rcapaverde/cubo/instruction-set.xlsx

 | x0 | x1 | x2 | x3 | x4 | x5 | x6 | x7 | x8 | x9 | xA | xB | xC | xD | xE | xF
0x | NOP Sem operação nop | MOVE (1) Copia REG8X para REG8X mov <a>, <b> |  |  |  |  |  |  | MOVE (2) Copia REG16X para REG16X mov <a>, <b> |  |  |  | LOAD (6) Carrega 16 bits apontados imediatamente para REG16X ld <a>, [<addr>]
1x | MOVE (4) Copia REG8 para REG16 mov <a>, <b> |  |  |  |  |  | LOAD (1) Carrega 8 bits imediatos da memória para REG8X ld <a>, <8 bits> |  |  |  |  |  |  | MOVE (3) Copia acumulador para REG16 com extensão de sinal movsx <a>, A |  | HALT Paralisa o processador hlt
2x | LOAD (2) Carrega 16 bits imediatos da memória para REG16X ld <a>, <16 bits> |  |  |  | LOAD (3) / LOAD (4) Carrega 8 bits ou 16 bits apontados por REG16X para REG8X ou REG16X ld <a>, [<b>] |  |  |  | JUMP CARRY Desvia se carry jc <addr> | JUMP ZERO Desvia se zero jz <addr> | JUMP NÃO CARRY Desvia se não carry jnc <addr> | JUMP NÃO ZERO Desvia se não zero jnz <addr> | STORE (1) / STORE (2) Armazena REG8X ou REG16X no endereço apontado por REG16X sto [<a>], <b>
3x | LOAD (5) Carrega 8 bits apontados imediatamente para REG8X ld <a>, [<addr>] |  |  |  |  |  |  | JUMP NEGATIVE Desvia se negativo jn <addr> | JUMP OVERFLOW Desvia se overflow jo <addr> | JUMP NÃO NEGATIVE Desvia se positivo jnn <addr> | JUMP NÃO OVERFLOW Desvia se não overflow jno <addr> | STORE (4) Armazena REG16X no endereço apontado imediato sto [<addr>], <a> |  |  |  | ADC (1) Adiciona 8 bits imediatos a ACC, com carry adc A, <8 bits>
4x | STORE (3) Armazena REG8X no endereço apontado imediato sto [<addr>], <a> |  |  |  |  |  |  | PUSH (2) Empilha REG16X na stack (menos SP) psh <a> |  |  | ENABLE INTR Liga o flag que habilita interrupções (interrupções solicitadas enquanto o flag estava desabilitado serão executadas imediatamente) ei | ADC (3) Adiciona 8 bits apontados imediatos a ACC, com carry adc A, [<addr>] | ADC (2) Adiciona 8 bits apontado por REG16 a ACC, com carry adc A, [<a>] |  | ADD (1) Adiciona 8 bits imediatos a ACC add A, <8 bits> | ADD (3) Adiciona 8 bits apontados imediatos a ACC add A, [<addr>]
5x | PUSH (1) Empilha REG8X na stack psh <a> |  |  |  |  |  |  | POP (1) Desempilha REG8X da stack pop <a> |  |  |  |  |  |  | ADD (2) Adiciona 8 bits apontado por REG16 a ACC add A, [<a>]
6x | POP (2) Desempilha REG16X da stack (menos SP) pop <a> |  |  | SWAP Troca o conteúdo do acumulador com REG8X (menos o próprio ACC) swp A, <a> |  |  |  |  |  | INC (2) Incrementa REG16 (sem efeito nos flags) inc <a> |  | SBB (1) Subtrai 8 bits imediatos de ACC, com borrow sbb A, <8 bits> | SBB (2) Subtrai 8 bits apontado por REG16 de ACC, com borrow sbb A, [<a>] |  | SBB (3) Subtrai 8 bits apontados imediatos de ACC, com borrow sbb A, [<addr>] | INC (1) Incrementa ACC (com efeito nos flags) inc A
7x | ADC (4) Adiciona REG8 a ACC, com carry adc A, <a> |  |  |  |  |  | ADD (4) Adiciona REG8 a ACC add A, <a> |  |  |  |  |  | SUB (1) Subtrai 8 bits imediatos de ACC sub A, <8 bits> | SUB (2) Subtrai 8 bits apontado por REG16 de ACC sub A, [<a>] |  | DEC (1) Decrementa ACC (com efeito nos flags) dec A
8x | SBB (4) Subtrai REG8 de ACC, com borrow sbb A, <a> |  |  |  |  |  | SUB (4) Subtrai REG8 de ACC sbb A, <a> |  |  |  |  |  | SUB (3) Subtrai 8 bits apontados imediatos de ACC sub A, [<addr>] | AND (1) AND bitwise 8 bits imediatos com ACC and A, <8 bits> | AND (2) AND bitwise 8 bits apontado por REG16 com ACC and A, [<a>]
9x | AND (4) AND bitwise de REG8X com ACC and A, <a> |  |  |  |  |  |  | OR (4) OR bitwise de REG8X com ACC or A, <a> |  |  |  |  |  |  | OR (1) OR bitwise 8 bits imediatos com ACC and A, <8 bits> | AND (3) AND bitwise 8 bits apontados imediatos com ACC and A, [<addr>]
Ax | XOR (4) Bitwise XOR de REG8X com ACC xor A, <a> |  |  |  |  |  |  | XOR (1) Bitwise XOR 8 bits imediatos com ACC xor A, <8 bits> | XOR (2) Bitwise XOR 8 bits apontado por REG16 com ACC xor A, [<a>] |  | XOR (3) Bitwise XOR 8 bits apontados imediatos com ACC xor A, [<addr>] | OR (2) Bitwise OR 8 bits apontado por REG16 com ACC or A, [<a>] |  | OR (3) Bitwise OR 8 bits apontados imediatos com ACC or A, [<addr>] | NOT (1) Bitwise NOT de 8 bits apontados imediatos, resultado em ACC not [<addr>] | NOT (2) Bitwise NOT de ACC not A
Bx | SHIFT LEFT CARRY (1) Deslocamento à esquerda de ACC, com carry shlc A | SHIFT LEFT CARRY (2) Deslocamento à esquerda do conteúdo apontado por REG16, resultado em ACC, com carry shlc [<a>] |  | SHIFT LEFT (1) Deslocamento à esquerda de ACC shl A | SHIFT LEFT (2) Deslocamento à esquerda do conteúdo apontado por REG16, resultado em ACC shl [<a>] |  | SHIFT RIGHT CARRY (1) Deslocamento à direita de ACC, com carry shrc A | SHIFT RIGHT CARRY (2) Deslocamento à direita do conteúdo apontado por REG16, resultado em ACC, com carry shrc [<a>] |  | SHIFT RIGHT (1) Deslocamento à direita de ACC shr A | SHIFT RIGHT (2) Deslocamento à direita do conteúdo apontado por REG16, resultado em ACC shr [<a>] |  | ROTATE LEFT (2) Rotaciona à esquerda o conteúdo apontado por REG16, resultado em ACC rl [<a>] |  | ROTATE RIGHT (2) Rotaciona à direita o conteúdo apontado por REG16, resultado em ACC rr [<a>]
Cx | ROTATE LEFT (1) Rotação à esquerda de ACC rl A | ROTATE RIGHT (1) Rotação à direita de ACC rr A | CLEAR CF Limpa o carry flag clc | SET CF Liga o carry flag stc | NEGATIVE (1) Complemente de 2 de 8 bits apontados imediatos, resultado em ACC neg [<addr>] | NEGATIVE (2) Complemento de 2 de ACC neg A | NEGATIVE (3) Complemento de 2 de 8 bits apontados por REG16, resultado em ACC neg [<a>] |  | NOT (3) Bitwise NOT de 8 bits apontados por REG16, resultado em ACC not [<a>] |  | JSR (1) Desvia PC para o valor de REG16, salvando PC original na stack jsr <a> |  | JSR (2) Desvia PC para o endereço apontado por REG16, salvando PC original na stack jsr [<a>] |  | JUMP (3) Desvia PC para o valor de REG16 jmp <a>
Dx | JUMP (1) Desvia PC para o endereço imediato jmp <addr> | JUMP (2) Desvia PC para o endereço apontado imediato jmp [<addr>] | JUMP (4) Desvia PC para o endereço apontado por REG16 jmp [<a>] |  | RETURN Volta de uma chamada por JSR ret | COMPARE (1) Compara 8 bits imediato com ACC cmp A, <8 bits> | COMPARE (2) Compara 8 bits apontado por REG16 com ACC cmp A, [<a>] |  | COMPARE (3) Compara 8 bits apontados imediatos com ACC cmp A, [<addr>] | COMPARE (4) Compara REG8X com ACC cmp A, <a>
Ex | INPUT (1) / OUTPUT (1) Lê (ou grava) um byte na porta indicada por endereço imediato e coloca em REG8 inp <a>, <8 bits> / out <a>, <8 bits> | INPUT (2) / OUTPUT (2) Lê (ou grava) um byte na porta indicada por REG8 e coloca em REG8 inp <a>, <b> / out <a>, <b> |  |  |  |  |  | OUTPUT (3) Grava um byte imediato na porta indicada por endereço imediato out <8 bits>, <8 bits> | JSR (3) Desvia PC para o valor imediato, salvando PC original na stack jsr <16 bit> | JSR (4) Desvia PC para o endereço apontado imediato, salvando PC original na stack jsr [<16 bit>] | INC (3) Incrementa REG8 (sem efeito nos flags), menos ACC inc <a> |  |  |  |  | DISABLE INTR Desliga o flag que habilita interrupções di
Fx | DEC (2) Decrementa REG16 (sem efeito nos flags) dec <a> |  | DEC (3) Decrementa REG8 (sem efeito nos flags), menos ACC dec <a>
 | x0 | x1 | x2 | x3 | x4 | x5 | x6 | x7 | x8 | x9 | xA | xB | xC | xD | xE | xF
0x | RESET Instrução especial com a sequência de reset
1x
2x
3x
4x
5x
6x
7x
8x | EXT_MOVE_1 Copia o conteúdo de MARL para REG8X |  |  |  |  |  |  |  | EXT_MOVE_2 Copia o conteúdo de MAR para REG16X |  |  |  | EXT_LOAD_4 Copia o conteúdo apontado por MAR para REG16X
9x | EXT_LOAD_3 Copia o conteúdo apontado por MAR para REG8X |  |  |  |  |  |  |  | EXT_STORE_1 Armazena o REG8X no endereço apontado por MAR
Ax | EXT_STORE_2 Armazena o REG16X no endereço apontado por MAR |  |  |  | EXT_INPUT_1 Lê um byte na porta indicada por MAR e coloca em REG8 |  |  |  |  |  | EXT_OUTPUT_1 Lê um byte na porta indicada por MAR e coloca em REG8
Bx
Cx
Dx
Ex
Fx
