rcapaverde/cubo/3d/pe-haste.FCStd

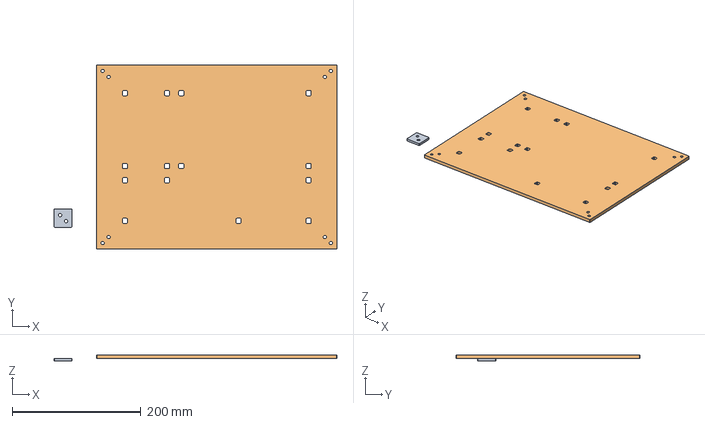
[picture p1: CAD file, 2026-05-25]
3d/pe-haste.FCStd
439.0 x 286.0 x 10.0 mm
