rcapaverde/cubo/pcb_v3/croqui.FCStd

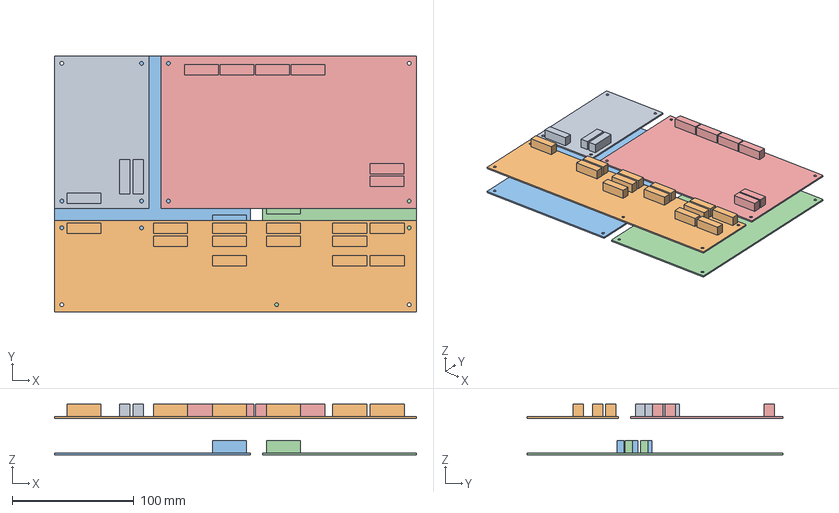
[picture p2: CAD file, 2026-06-19]
pcb_v3/croqui.FCStd
297.0 x 210.0 x 41.6 mm
CLOCK
SYSBUS
CL
ULA8
RF16
