rcapaverde/cubo/3d/cartridge90.FCStd

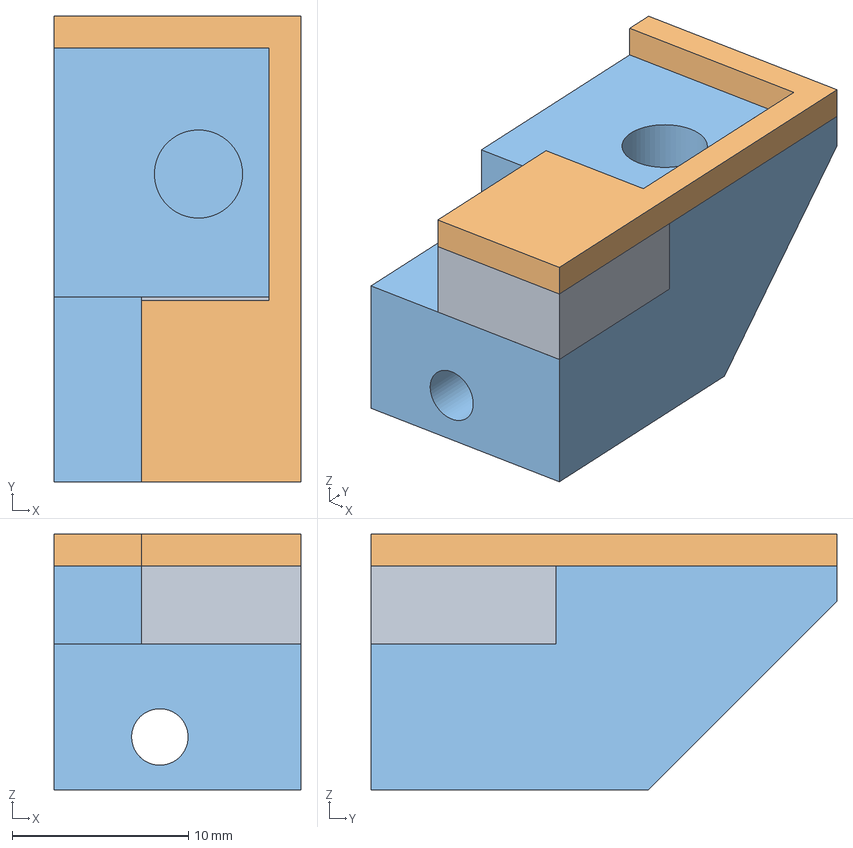
[picture p3: CAD file, 2026-05-16]
3d/cartridge90.FCStd
14.0 x 26.4 x 14.5 mm
