rcapaverde/cubo/3d/cartridge-case.FCStd

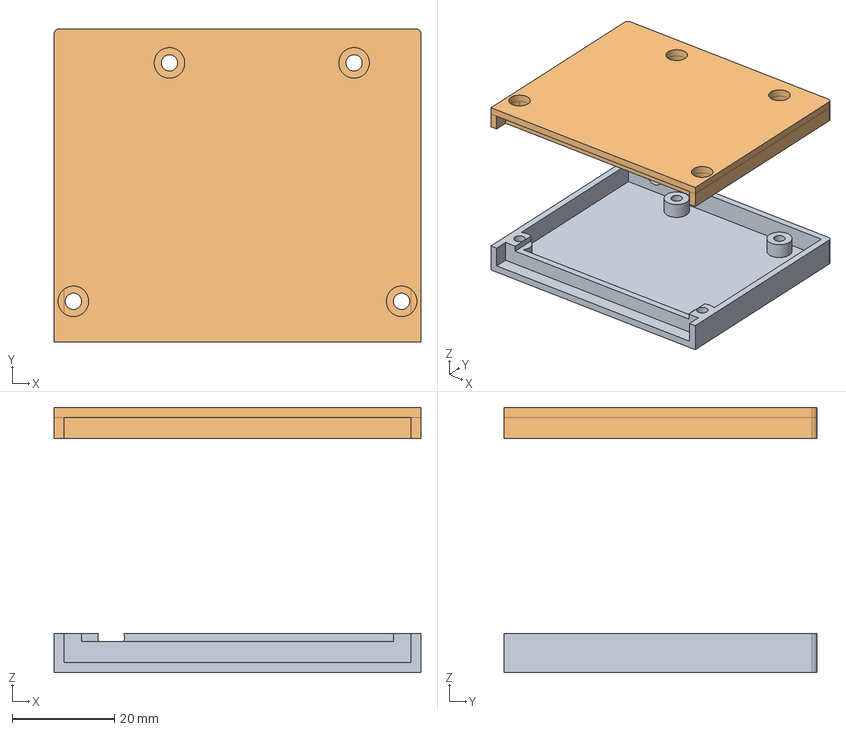
[picture p4: CAD file, 2026-05-15]
3d/cartridge-case.FCStd
72.0 x 61.4 x 52.0 mm
