rcapaverde/cubo/3d/botoes.FCStd

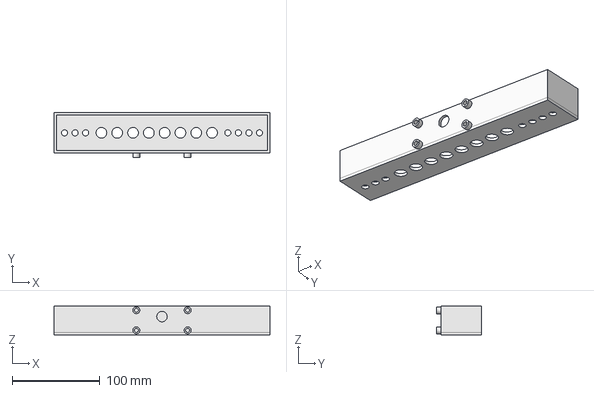
[picture p5: CAD file, 2025-12-11]
3d/botoes.FCStd
246.0 x 51.0 x 33.0 mm
