rcapaverde/cubo/pcb_v2/croqui.FCStd

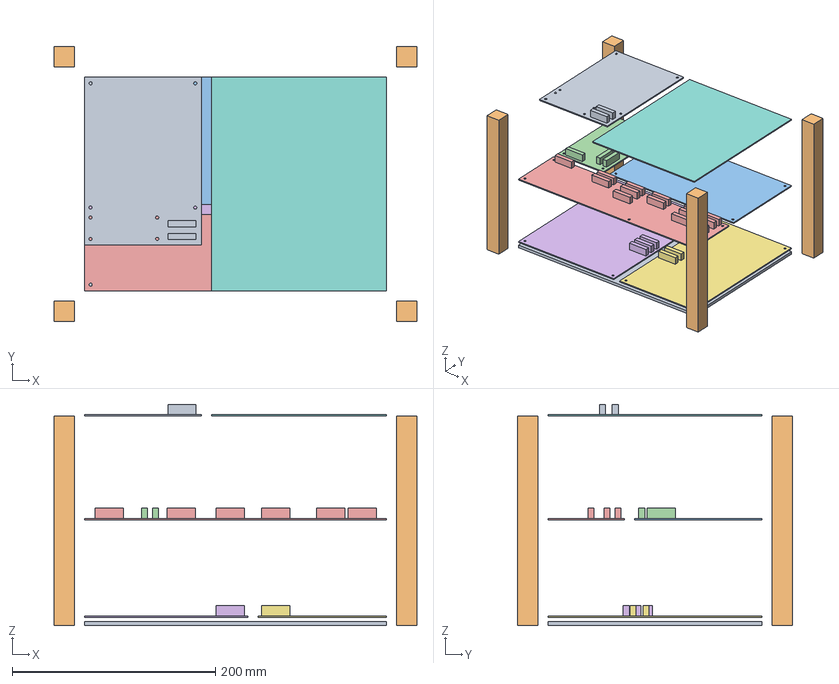
[picture p6: CAD file, 2026-05-15, an earlier design]
pcb_v2/croqui.FCStd
357.0 x 270.0 x 217.6 mm
RF16
CLOCK
SYSBUS
CL
ULA8
MEM
