rcapaverde/cubo/instruction-set-v4.xlsx

0: ZERO 1: A 2: C 3: B 4: E 5: D 6: L 7: H 8: MEMD_FROM_PC 9: MEMD_FROM_PC 10: MEMD_FROM_SP 11: MEMD_FROM_SP 12: MEMD_FROM_MAR 13: MEMD_FROM_MAR 14: MEMD_FROM_CONST 15: <reservado> 16: IOD_FROM_MAR 17: <reservado> 18: <reservado> 19: <reservado> 20: PSW 21: ULA 22: <reservado> 23: <reservado> 24: PC_L 25: PC_H 26: SP_L 27: SP_H 28: MAR_L 29: MAR_H 30: LR_L 31: LR_H |  | 0 | nop/hlt/brk
 |  | 1 | rd reg from
 |  | 2
 |  | 3 | cond flag
 |  | 4 | xch/ixch
 |  | 5 | wrb reg8 to
 |  | 6 | wrw reg16 to
 |  | 7 | ula oper
 | mov reg8 to, reg8 from |  | rd <from>; wrb <to> | 21 A2
 | ld reg8 to, [reg16 from] |  | rd <from>; wrw MAR; rd MEMD_FROM_MAR; wrb <to> | 27 BC 29 81
 | ld reg8 to, [im16] |  | rd MEMD_FROM_PC; wrw MAR; rd MEMD_FROM_MAR; wrb <to> | 28 BC xx xx 29 81
 | ld reg8 to, im8 value |  | rd MEMD_FROM_PC; wrb <to> | 28 81
 | sto [reg16 to], reg8 from |  | rd <to>; wrw MAR; rd <from>; wrb MEMD_FROM_MAR
 | sto [im16 to], reg8 from |  | rd MEMD_FROM_PC; wrw MAR; rd <from>; wrb MEMD_FROM_MAR
 | mov reg16 to, reg16 from |  | rd <from>; wrw <to> | 22 A6
 | ld reg16 to, [reg16] from |  | rd <from>; wrw MAR; rd MEMD_FROM_MAR; wrw <to>
 | ld reg16 to, [im16 from] |  | from MEMD_FROM_PC; to MAR; from MEMD_FROM_MAR; to <to>
 | sto [reg16 to], reg16 from |  | from <to>; to MAR; from <from>; to MEMD_FROM_MAR
 | sto [im16 to], reg16 from |  | from MEMD_FROM_PC; to MAR; from <from>; to MEMD_FROM_MAR
 | jmp reg16 dest |  | rd <dest>; wrw PC | 21 B8
 | jmp im16 dest |  | rd MEMD_FROM_PC; wrw MAR; rd MAR; wrw PC | 28 BC xx xx 3C 98
 | jmp [reg16 dest] |  | from <dest>; to MAR; from MEMD_FROM_MAR; to PC
 | jmp [im16 dest] |  | from MEMD_FROM_PC; to MAR; from MEMD_FROM_MAR; to PC | 28 DC xx xx 3C D8
 | adc reg8 acc, reg8 op |  | from <acc>; to ULA; from <op>; ula ADC; from ULA; to <acc>
 | adc reg8 acc, im8 op |  | from <acc>; to ULA; from MEMD_FROM_PC; ula ADC; from ULA; to <acc>
 | adc reg8 acc, [reg16 op] |  | from <acc>; to ULA; from <op>; to MAR; from MEMD_FROM_MAR; ula ADC; from ULA; to <acc>
 | adc reg8 acc, [im16 op] |  | from <acc>; to ULA; from MEMD_FROM_PC; to MAR; from MEMD_FROM_MAR; ula ADC; from ULA; to <acc>
 | adc reg8 acc, e4 op
 | not reg8 acc, reg8 op |  | from <op>; ula NOT; from ULA; to <acc>
 | not reg8 acc, im8 op |  | from MEMD_FROM_PC; ula NOT; from ULA; to <acc>
 | not reg8 acc, [reg16 op] |  | from <op>; to MAR; from MEMD_FROM_MAR; ula NOT; from ULA; to <acc>
 | not reg8 acc, [im16 op] |  | from MEMD_FROM_PC; to MAR; from MEMD_FROM_MAR; ula NOT; from ULA; to <acc>
 | inc reg8 r |  | rd MEMD_FROM_PC; wrb PSW; rd <r>; wrb ULA; rd ZERO; ula ADC; rd ULA; wrb <r> | 28 8E 04 21 8F 20 C0 2F 81
 | dec reg8 r
 | psh reg8 item |  | from <item>; to MEMD_FROM_SP
 | psh reg16 item |  | from <item+1>; to MEMD_FROM_SP; from <item>; to MEMD_FROM_SP
 | pop reg8 item |  | from MEMD_FROM_SP; to <item>
 | pop reg16 item |  | from MEMD_FROM_SP; to <item>; from MEMD_FROM_SP; to <item+1>
 | jc reg16 dest |  | from <dest>; cond C; to PC
 | jnc reg16 dest |  | from <dest>; cond NC; to PC
 | jc im16 dest |  | from MEMD_FROM_PC; to MAR; from MAR; cond C; to PC
 | jc [reg16 pdest] |  | from <pdest>; to MAR; from MEMD_FROM_MAR; cond C; to PC
 | jc [im16 pdest] |  | from MEMD_FROM_PC; to MAR; from MEMD_FROM_MAR; cond C; to PC
 | swp reg8 a, reg8 b |  | from <a>; to ULA; from <b>; to <a>; from ULA; to <b>
 | clc
 | stc
 | jsr reg16 dest |  | from <dest>; to LR; ctrl SWAP
 | jsr im16 dest |  | from MEMD_FROM_PC; to LR; ctrl SWAP
 | jsr [reg16] dest |  | from <dest>; to MAR; from MEMD_FROM_MAR; to LR; ctrl SWAP
 | jsr [im16] dest |  | from MEMD_FROM_PC; to MAR; from MEMD_FROM_MAR; to LR; ctrl SWAP
 | ret |  | ctrl SWAP
 | inp reg8, reg8
 | inp reg8, [reg16]
 | inp reg8, [im16]
 | inp reg8, e8
 | inp e8, reg8
 | inp e8, [reg16]
 | inp e8, [im16]
 | inp e8, im8
 | out reg8, reg8
 | out reg8, [reg16]
 | out reg8, [im16]
 | out reg8, e8
 | out e8, reg8
 | out e8, [reg16]
 | out e8, [im16]
 | out e8, im8
 | nop |  | ctrl NOP
 | hlt |  | ctrl HALT
 | di
 | ei
