rcapaverde/cubo/instruction-set-v3.xlsx

0: ZERO 1: A 2: B 3: C 4: D 5: E 6: H 7: L 8: MEMD_FROM_PC 9: MEMD_FROM_MAR 10: MEMD_FROM_SP 11: MEMD_FROM_CONST 12: IOD_FROM_MAR 13: <vazio> 14: PSW 15: TEMP 16: <reservado> 17: <reservado> 18: <reservado> 19: <reservado> 20: <reservado> 21: <reservado> 22: <reservado> 23: <reservado> 24: PC_L 25: PC_H 26: SP_L 27: SP_H 28: MAR_L 29: MAR_H | mov reg8 to, reg8 from | transfer8(to, from)
 | ld reg8 to, [reg16 from] | transfer8_ind(to, from, MEMD_FROM_MAR)
 | ld reg8, [im16] | transfer8_ind(to, ZERO, MEMD_FROM_PC)
 | ld reg8 to, im8 value | transfer8_const(to, e8 >> 4, e8 & 0x0F)
 | sto [reg16 to], reg8 from | transfer8_ind(MEMD_FROM_MAR, to, from)
 | sto [im16 to], reg8 from | transfer8_ind(MEMD_FROM_MAR, MEMD_FROM_PC, from)
 | mov reg16 to, reg16 from | transfer16(from, to)
 | ld reg16 to, [reg16] from | transfer16_ind(to, from, MEMD_FROM_MAR)
 | ld reg16 to, [im16 from] | transfer16_ind(to, ZERO, MEMD_FROM_PC)
 | sto [reg16 to], reg16 from | transfer16_ind(MEMD_FROM_MAR, to, from)
 | sto [im16 to], reg16 from | transfer8_ind(MEMD_FROM_MAR, MEMD_FROM_PC, from)
 | jmp reg16 dest | transfer16(REG_PC, dest)
 | jmp im16 dest | transfer16_ind(REG_PC, REG_PC, MEMD_FROM_MAR)
 | jmp [reg16 dest] | transfer16_ind(REG_PC, dest, MEMD_FROM_MAR)
 | jmp [im16 dest] | transfer16_ind(REG_PC, MEMD_FROM_PC, MEMD_FROM_MAR)
 | adc reg8 acc, reg8 op | ula(acc, op, ADD)
 | adc reg8 acc, im8 op | ula(acc, MEMD_FROM_PC, ADD)
 | adc reg8 acc, [reg16 op] | ula_ind(acc, op, ADD)
 | adc reg8 acc, [im16 op] | ula_ind(acc, op, MEMD_FROM_PC, ADD)
 | adc reg8 acc, e4 op | ula_const(acc, op, ADD)
 | not reg8 acc, reg8 op | ula_single(acc, op, NOT)
 | not reg8 acc, im8 op | ula_single(acc, MEMD_FROM_PC, NOT)
 | not reg8 acc, [reg16 op] | ula_single_ind(acc, op, NOT)
 | not reg8 acc, [im16 op] | ula_single_ind(acc, op, MEMD_FROM_PC, NOT)
 | psh reg8 item | transfer8(MEMD_FROM_SP, item)
 | psh reg16 item | transfer16(MEMD_FROM_SP, item)
 | pop reg8 item | transfer8(item, MEMD_FROM_SP)
 | pop reg16 item | transfer16(item, MEMD_FROM_SP)
 | jc reg16 dest | conditional(dest, MASK_C, FLAG_C)
 | jnc reg16 dest | conditional(dest, MASK_C, 0)
 | jc im16 pdest | conditional(MEMD_FROM_PC, MASK_C, FLAG_C)
 | jc [reg16 pdest] | conditional_ind(pdest, MASK_C, FLAG_C)
 | jc [im16 pdest] | conditional_ind(MEMD_FROM_PC, MASK_C, FLAG_C)
 | swp reg8 a, reg8 b | SWAP(a, b)
 | clc | ula_single(ZERO, 0, CLEARCF)
 | stf | ula_single(ZERO, 0, SETCF)
 | jsr reg16
 | jsr im16
 | jsr [reg16]
 | jsr [im16]
 | ret
 | inp reg8, reg8
 | inp reg8, [reg16]
 | inp reg8, [im16]
 | inp reg8, e8
 | inp e8, reg8
 | inp e8, [reg16]
 | inp e8, [im16]
 | inp e8, im8
 | out reg8, reg8
 | out reg8, [reg16]
 | out reg8, [im16]
 | out reg8, e8
 | out e8, reg8
 | out e8, [reg16]
 | out e8, [im16]
 | out e8, im8
 | nop
 | hlt
 | di
 | ei
