rcapaverde/cubo/(list of files, drawings)

Other design files:
logicsim/control_logic_unit.circ
logicsim/controle_carry_flag.circ
logicsim/experimento.circ
logicsim/overflow.circ
logicsim/regs.circ
logicsim/selecao_registradores.circ
logicsim/serial.circ
logicsim/serial_v2.circ
logicsim/testbench.circ
logicsim/ula_control.circ
