rcapaverde/cubo/pcb_v3/sysbus/sysbus.kicad_pcb

## KiCad design pcb_v3/sysbus/sysbus.kicad_pcb (2026-08-08)

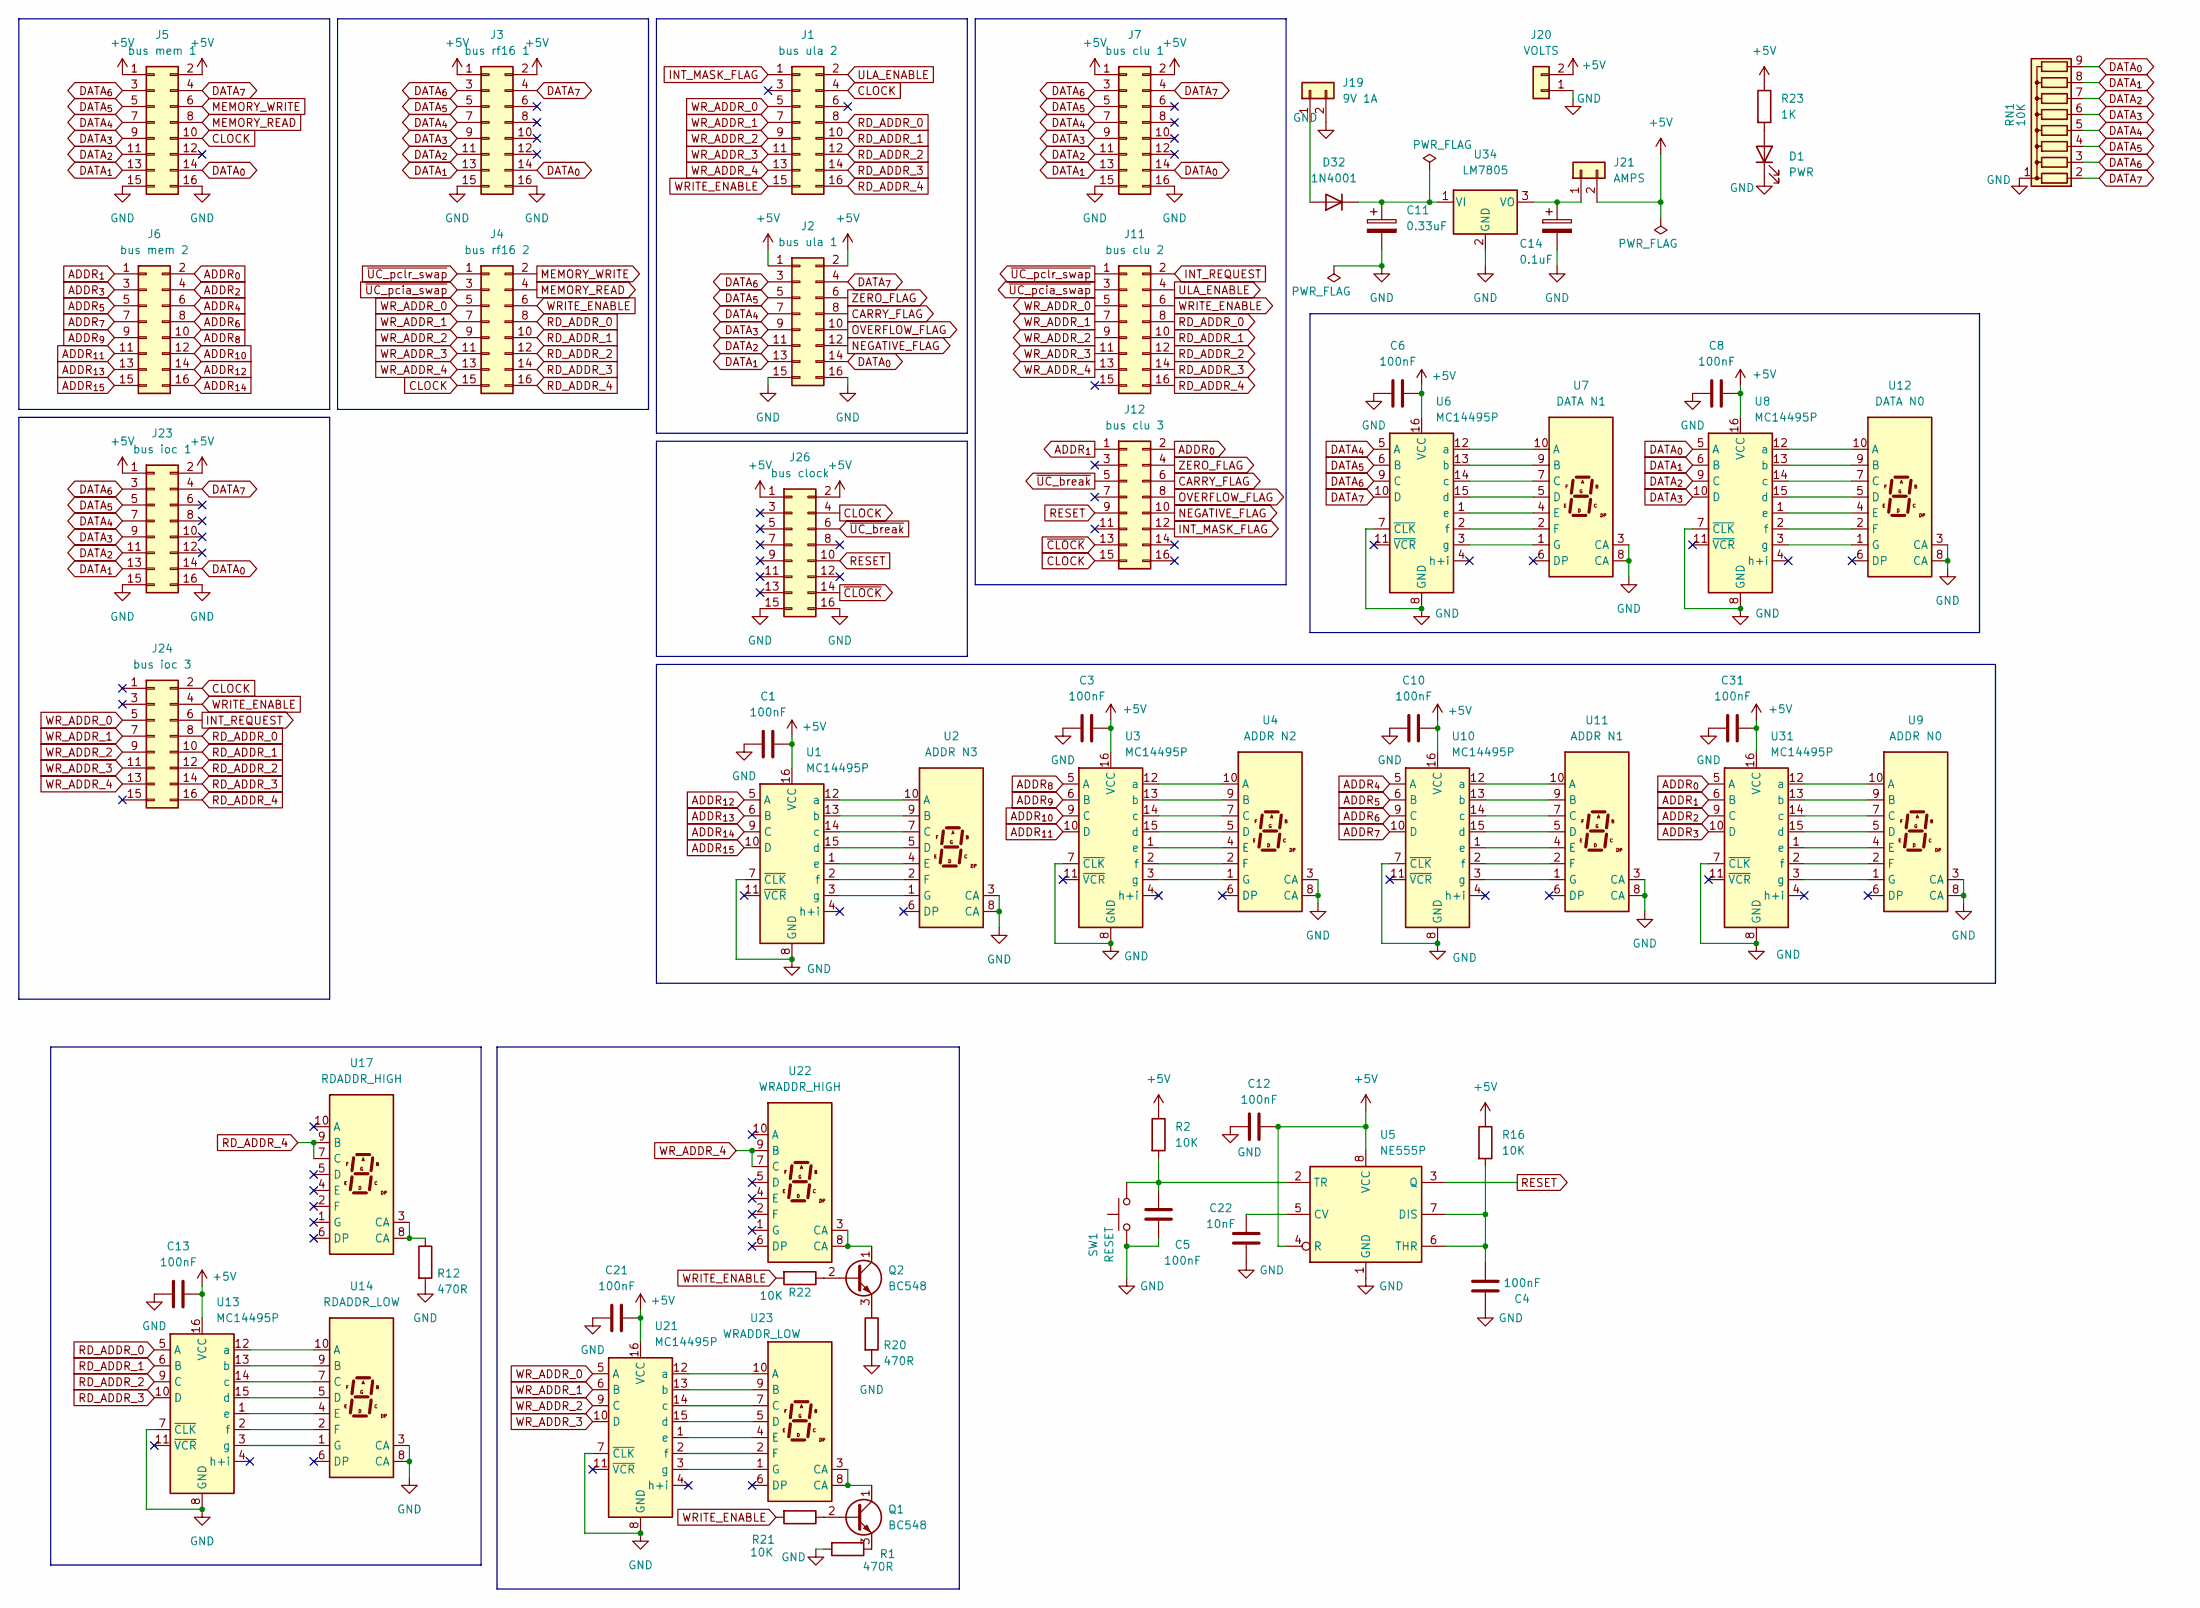
[picture p7: schematic sysbus.kicad_sch]

Parts:
C1, C3, C6, C8, C10, C13, C21, C31: 100nF; C_Disc_D5.1mm_W3.2mm_P5.00mm
C4, C5, C12: 100nF; C_Disc_D4.7mm_W2.5mm_P5.00mm
C11: 0.33uF; CP_Radial_D5.0mm_P2.50mm
C14: 0.1uF; CP_Radial_D5.0mm_P2.50mm
C22: 10nF; C_Disc_D4.7mm_W2.5mm_P5.00mm
D1: PWR; LED_D5.0mm
D32: 1N4001; D_DO-41_SOD81_P10.16mm_Horizontal
J1: bus ula 2; conector 02x08
J2: bus ula 1; conector 02x08
J3: bus rf16 1; conector 02x08
J4: bus rf16 2; conector 02x08
J5: bus mem 1; conector 02x08
J6: bus mem 2; conector 02x08
J7: bus clu 1; conector 02x08
J11: bus clu 2; conector 02x08
J12: bus clu 3; conector 02x08
J19: 9V 1A; JST_XH_B2B-XH-A_1x02_P2.50mm_Vertical
J20: VOLTS; JST_XH_B2B-XH-A_1x02_P2.50mm_Vertical
J21: AMPS; JST_XH_B2B-XH-A_1x02_P2.50mm_Vertical
J23: bus ioc 1; conector 02x08
J24: bus ioc 3; conector 02x08
J26: bus clock; conector 02x08
Q1, Q2: BC548; TO-92_Inline
R1, R12, R20: 470R; R_Axial_DIN0207_L6.3mm_D2.5mm_P7.62mm_Horizontal
R2, R16, R21, R22: 10K; R_Axial_DIN0207_L6.3mm_D2.5mm_P7.62mm_Horizontal
R23: 1K; R_Axial_DIN0207_L6.3mm_D2.5mm_P7.62mm_Horizontal
RN1: 10K; R_Array_SIP9
SW1: RESET; JST_XH_B2B-XH-A_1x02_P2.50mm_Vertical
U1, U3, U6, U8, U10, U13, U21, U31: MC14495P; DIP-16_W7.62mm
U2: ADDR N3; Sx39-1xxxxx
U4: ADDR N2; Sx39-1xxxxx
U5: NE555P; DIP-8_W7.62mm
U7: DATA N1; Sx39-1xxxxx
U9: ADDR N0; Sx39-1xxxxx
U11: ADDR N1; Sx39-1xxxxx
U12: DATA N0; Sx39-1xxxxx
U14: RDADDR_LOW; Sx39-1xxxxx
U17: RDADDR_HIGH; Sx39-1xxxxx
U22: WRADDR_HIGH; Sx39-1xxxxx
U23: WRADDR_LOW; Sx39-1xxxxx
U34: LM7805; TO-220-3_Vertical

Connections:
+5V: C1.2, C3.2, C6.2, C8.2, C10.2, C12.2, C13.2, C21.2, C31.2, J2.1, J2.2, J3.1, J3.2, J5.1, J5.2, J7.1, J7.2, J20.2, J21.2, J23.1, J23.2, J26.1, J26.2, R2.1, R16.1, R23.1, U1.16 (VCC), U3.16 (VCC), U5.4 (R), U5.8 (VCC), U6.16 (VCC), U8.16 (VCC), U10.16 (VCC), U13.16 (VCC), U21.16 (VCC), U31.16 (VCC)
ADDR_{0}: J6.2, J12.2, U31.5 (A)
ADDR_{1}: J6.1, J12.1, U31.6 (B)
ADDR_{2}: J6.4, U31.9 (C)
ADDR_{3}: J6.3, U31.10 (D)
ADDR_{4}: J6.6, U10.5 (A)
ADDR_{5}: J6.5, U10.6 (B)
ADDR_{6}: J6.8, U10.9 (C)
ADDR_{7}: J6.7, U10.10 (D)
ADDR_{8}: J6.10, U3.5 (A)
ADDR_{9}: J6.9, U3.6 (B)
ADDR_{10}: J6.12, U3.9 (C)
ADDR_{11}: J6.11, U3.10 (D)
ADDR_{12}: J6.14, U1.5 (A)
ADDR_{13}: J6.13, U1.6 (B)
ADDR_{14}: J6.16, U1.9 (C)
ADDR_{15}: J6.15, U1.10 (D)
CARRY_FLAG: J2.8, J12.6
CLOCK: J1.4, J4.15, J5.10, J12.15, J24.2, J26.4
DATA_{0}: J2.14, J3.14, J5.14, J7.14, J23.14, RN1.9 (R8), U8.5 (A)
DATA_{1}: J2.13, J3.13, J5.13, J7.13, J23.13, RN1.8 (R7), U8.6 (B)
DATA_{2}: J2.11, J3.11, J5.11, J7.11, J23.11, RN1.7 (R6), U8.9 (C)
DATA_{3}: J2.9, J3.9, J5.9, J7.9, J23.9, RN1.6 (R5), U8.10 (D)
DATA_{4}: J2.7, J3.7, J5.7, J7.7, J23.7, RN1.5 (R4), U6.5 (A)
DATA_{5}: J2.5, J3.5, J5.5, J7.5, J23.5, RN1.4 (R3), U6.6 (B)
DATA_{6}: J2.3, J3.3, J5.3, J7.3, J23.3, RN1.3 (R2), U6.9 (C)
DATA_{7}: J2.4, J3.4, J5.4, J7.4, J23.4, RN1.2 (R1), U6.10 (D)
GND: C1.1, C3.1, C4.1, C5.1, C6.1, C8.1, C10.1, C11.2, C12.1, C13.1, C14.2, C21.1, C22.1, C31.1, D1.1 (K), J2.15, J2.16, J3.15, J3.16, J5.15, J5.16, J7.15, J7.16, J19.2, J20.1, J23.15, J23.16, J26.15, J26.16, R1.2, R12.2, R20.2, RN1.1 (common), SW1.1, U1.7 (~CLK), U1.8 (GND), U2.3 (CA), U2.8 (CA), U3.7 (~CLK), U3.8 (GND), U4.3 (CA), U4.8 (CA), U5.1 (GND), U6.7 (~CLK), U6.8 (GND), U7.3 (CA), U7.8 (CA), U8.7 (~CLK), U8.8 (GND), U9.3 (CA), U9.8 (CA), U10.7 (~CLK), U10.8 (GND), U11.3 (CA), U11.8 (CA), U12.3 (CA), U12.8 (CA), U13.7 (~CLK), U13.8 (GND), U14.3 (CA), U14.8 (CA), U21.7 (~CLK), U21.8 (GND), U31.7 (~CLK), U31.8 (GND), U34.2 (GND)
INT_MASK_FLAG: J1.1, J12.12
INT_REQUEST: J11.2, J24.6
MEMORY_READ: J4.4, J5.8
MEMORY_WRITE: J4.2, J5.6
NEGATIVE_FLAG: J2.12, J12.10
unnamed: D1.2 (A), R23.2
unnamed: D32.2 (A), J19.1
unnamed: C11.1, D32.1 (K), U34.1 (VI)
unnamed: C14.1, J21.1, U34.3 (VO)
unnamed: Q1.2 (B), R21.1
unnamed: Q1.1 (C), U23.3 (CA), U23.8 (CA)
unnamed: Q1.3 (E), R1.1
unnamed: Q2.2 (B), R22.1
unnamed: Q2.1 (C), U22.3 (CA), U22.8 (CA)
unnamed: Q2.3 (E), R20.1
unnamed: R12.1, U17.3 (CA), U17.8 (CA)
unnamed: U1.12 (a), U2.10 (A)
unnamed: U1.13 (b), U2.9 (B)
unnamed: U1.14 (c), U2.7 (C)
unnamed: U1.15 (d), U2.5 (D)
unnamed: U1.1 (e), U2.4 (E)
unnamed: U1.2 (f), U2.2 (F)
unnamed: U1.3 (g), U2.1 (G)
unnamed: U3.12 (a), U4.10 (A)
unnamed: U3.13 (b), U4.9 (B)
unnamed: U3.14 (c), U4.7 (C)
unnamed: U3.15 (d), U4.5 (D)
unnamed: U3.1 (e), U4.4 (E)
unnamed: U3.2 (f), U4.2 (F)
unnamed: U3.3 (g), U4.1 (G)
unnamed: C22.2, U5.5 (CV)
unnamed: C4.2, R16.2, U5.6 (THR), U5.7 (DIS)
unnamed: C5.2, R2.2, SW1.2, U5.2 (TR)
unnamed: U6.12 (a), U7.10 (A)
unnamed: U6.13 (b), U7.9 (B)
unnamed: U6.14 (c), U7.7 (C)
unnamed: U6.15 (d), U7.5 (D)
unnamed: U6.1 (e), U7.4 (E)
unnamed: U6.2 (f), U7.2 (F)
unnamed: U6.3 (g), U7.1 (G)
unnamed: U10.12 (a), U11.10 (A)
unnamed: U10.13 (b), U11.9 (B)
unnamed: U10.14 (c), U11.7 (C)
unnamed: U10.15 (d), U11.5 (D)
unnamed: U10.1 (e), U11.4 (E)
unnamed: U10.2 (f), U11.2 (F)
unnamed: U10.3 (g), U11.1 (G)
unnamed: U8.12 (a), U12.10 (A)
unnamed: U8.13 (b), U12.9 (B)
unnamed: U8.14 (c), U12.7 (C)
unnamed: U8.15 (d), U12.5 (D)
unnamed: U8.1 (e), U12.4 (E)
unnamed: U8.2 (f), U12.2 (F)
unnamed: U8.3 (g), U12.1 (G)
unnamed: U13.12 (a), U14.10 (A)
unnamed: U13.13 (b), U14.9 (B)
unnamed: U13.14 (c), U14.7 (C)
unnamed: U13.15 (d), U14.5 (D)
unnamed: U13.1 (e), U14.4 (E)
unnamed: U13.2 (f), U14.2 (F)
unnamed: U13.3 (g), U14.1 (G)
unnamed: U21.12 (a), U23.10 (A)
unnamed: U21.13 (b), U23.9 (B)
unnamed: U21.14 (c), U23.7 (C)
unnamed: U21.15 (d), U23.5 (D)
unnamed: U21.1 (e), U23.4 (E)
unnamed: U21.2 (f), U23.2 (F)
unnamed: U21.3 (g), U23.1 (G)
unnamed: U9.10 (A), U31.12 (a)
unnamed: U9.9 (B), U31.13 (b)
unnamed: U9.7 (C), U31.14 (c)
unnamed: U9.5 (D), U31.15 (d)
unnamed: U9.4 (E), U31.1 (e)
unnamed: U9.2 (F), U31.2 (f)
unnamed: U9.1 (G), U31.3 (g)
OVERFLOW_FLAG: J2.10, J12.8
RD_ADDR_0: J1.8, J4.8, J11.8, J24.8, U13.5 (A)
RD_ADDR_1: J1.10, J4.10, J11.10, J24.10, U13.6 (B)
RD_ADDR_2: J1.12, J4.12, J11.12, J24.12, U13.9 (C)
RD_ADDR_3: J1.14, J4.14, J11.14, J24.14, U13.10 (D)
RD_ADDR_4: J1.16, J4.16, J11.16, J24.16, U17.7 (C), U17.9 (B)
RESET: J12.9, J26.10, U5.3 (Q)
ULA_ENABLE: J1.2, J11.4
WRITE_ENABLE: J1.15, J4.6, J11.6, J24.4, R21.2, R22.2
WR_ADDR_0: J1.5, J4.5, J11.5, J24.5, U21.5 (A)
WR_ADDR_1: J1.7, J4.7, J11.7, J24.7, U21.6 (B)
WR_ADDR_2: J1.9, J4.9, J11.9, J24.9, U21.9 (C)
WR_ADDR_3: J1.11, J4.11, J11.11, J24.11, U21.10 (D)
WR_ADDR_4: J1.13, J4.13, J11.13, J24.13, U22.7 (C), U22.9 (B)
ZERO_FLAG: J2.6, J12.4
~CLOCK: J12.13, J26.14
~UC_break: J12.5, J26.6
~UC_pcia_swap: J4.3, J11.3
~UC_pclr_swap: J4.1, J11.1

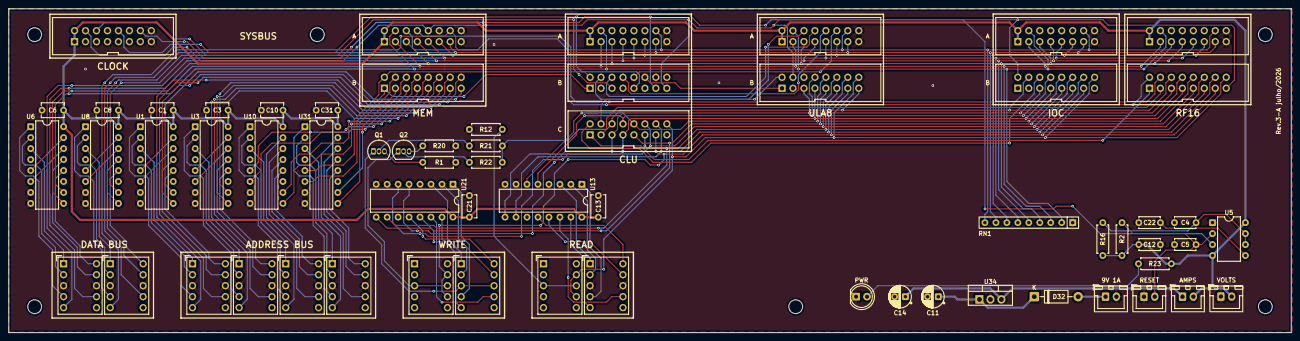
[picture p8: board sysbus.kicad_pcb from above]

Board: 2 copper layers, 297.0 x 75.0 mm, 63 parts (0 on the bottom side), 122 nets.
