rcapaverde/cubo/pcb_v3/clu_opcode/clu_opcode.kicad_pcb

## KiCad design pcb_v3/clu_opcode/clu_opcode.kicad_pcb (2026-08-08)

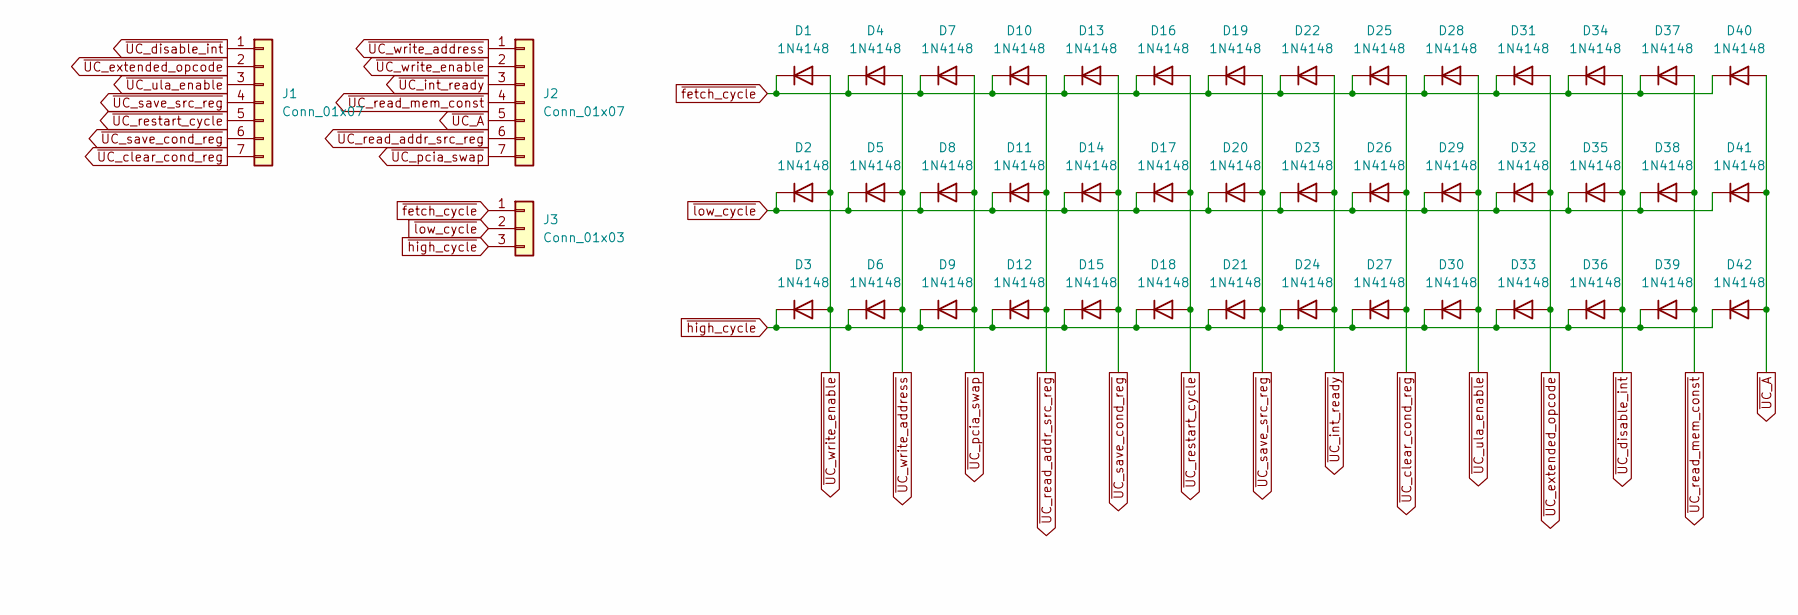
[picture p9: schematic clu_opcode.kicad_sch]

Parts:
D1, D2, D3, D4, D5, D6, D7, D8, D9, D10, D11, D12, D13, D14, D15, D16, D17, D18, D19, D20, D21, D22, D23, D24, D25, D26, D27, D28, D29, D30, D31, D32, D33, D34, D35, D36, D37, D38, D39, D40, D41, D42: 1N4148; D_DO-35_SOD27_P2.54mm_Vertical_AnodeUp
J1, J2: Conn_01x07; PinHeader_1x07_P2.54mm_Vertical
J3: Conn_01x03; PinHeader_1x03_P2.54mm_Vertical

Connections:
~UC_A: D40.2 (A), D41.2 (A), D42.2 (A), J2.5
~UC_clear_cond_reg: D25.2 (A), D26.2 (A), D27.2 (A), J1.7
~UC_disable_int: D34.2 (A), D35.2 (A), D36.2 (A), J1.1
~UC_extended_opcode: D31.2 (A), D32.2 (A), D33.2 (A), J1.2
~UC_int_ready: D22.2 (A), D23.2 (A), D24.2 (A), J2.3
~UC_pcia_swap: D7.2 (A), D8.2 (A), D9.2 (A), J2.7
~UC_read_addr_src_reg: D10.2 (A), D11.2 (A), D12.2 (A), J2.6
~UC_read_mem_const: D37.2 (A), D38.2 (A), D39.2 (A), J2.4
~UC_restart_cycle: D16.2 (A), D17.2 (A), D18.2 (A), J1.5
~UC_save_cond_reg: D13.2 (A), D14.2 (A), D15.2 (A), J1.6
~UC_save_src_reg: D19.2 (A), D20.2 (A), D21.2 (A), J1.4
~UC_ula_enable: D28.2 (A), D29.2 (A), D30.2 (A), J1.3
~UC_write_address: D4.2 (A), D5.2 (A), D6.2 (A), J2.1
~UC_write_enable: D1.2 (A), D2.2 (A), D3.2 (A), J2.2
~fetch_cycle: D1.1 (K), D4.1 (K), D7.1 (K), D10.1 (K), D13.1 (K), D16.1 (K), D19.1 (K), D22.1 (K), D25.1 (K), D28.1 (K), D31.1 (K), D34.1 (K), D37.1 (K), D40.1 (K), J3.1
~high_cycle: D3.1 (K), D6.1 (K), D9.1 (K), D12.1 (K), D15.1 (K), D18.1 (K), D21.1 (K), D24.1 (K), D27.1 (K), D30.1 (K), D33.1 (K), D36.1 (K), D39.1 (K), D42.1 (K), J3.3
~low_cycle: D2.1 (K), D5.1 (K), D8.1 (K), D11.1 (K), D14.1 (K), D17.1 (K), D20.1 (K), D23.1 (K), D26.1 (K), D29.1 (K), D32.1 (K), D35.1 (K), D38.1 (K), D41.1 (K), J3.2

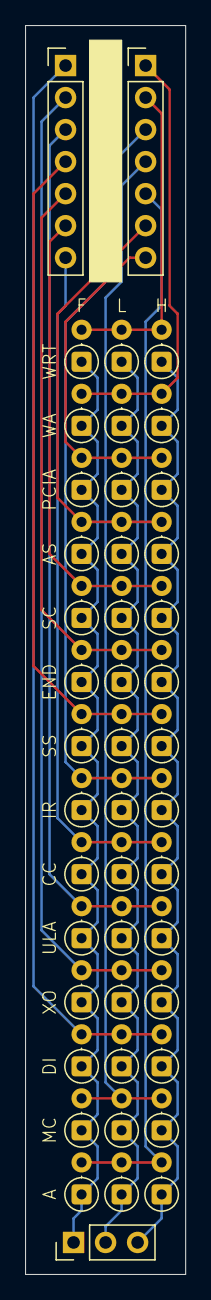
[picture p10: board clu_opcode.kicad_pcb from above]

Board: 2 copper layers, 12.7 x 99.1 mm, 45 parts (0 on the bottom side), 17 nets.
