rcapaverde/cubo/pcb_v3/clu/clu.kicad_pcb

## KiCad design pcb_v3/clu/clu.kicad_pcb (2026-08-08)

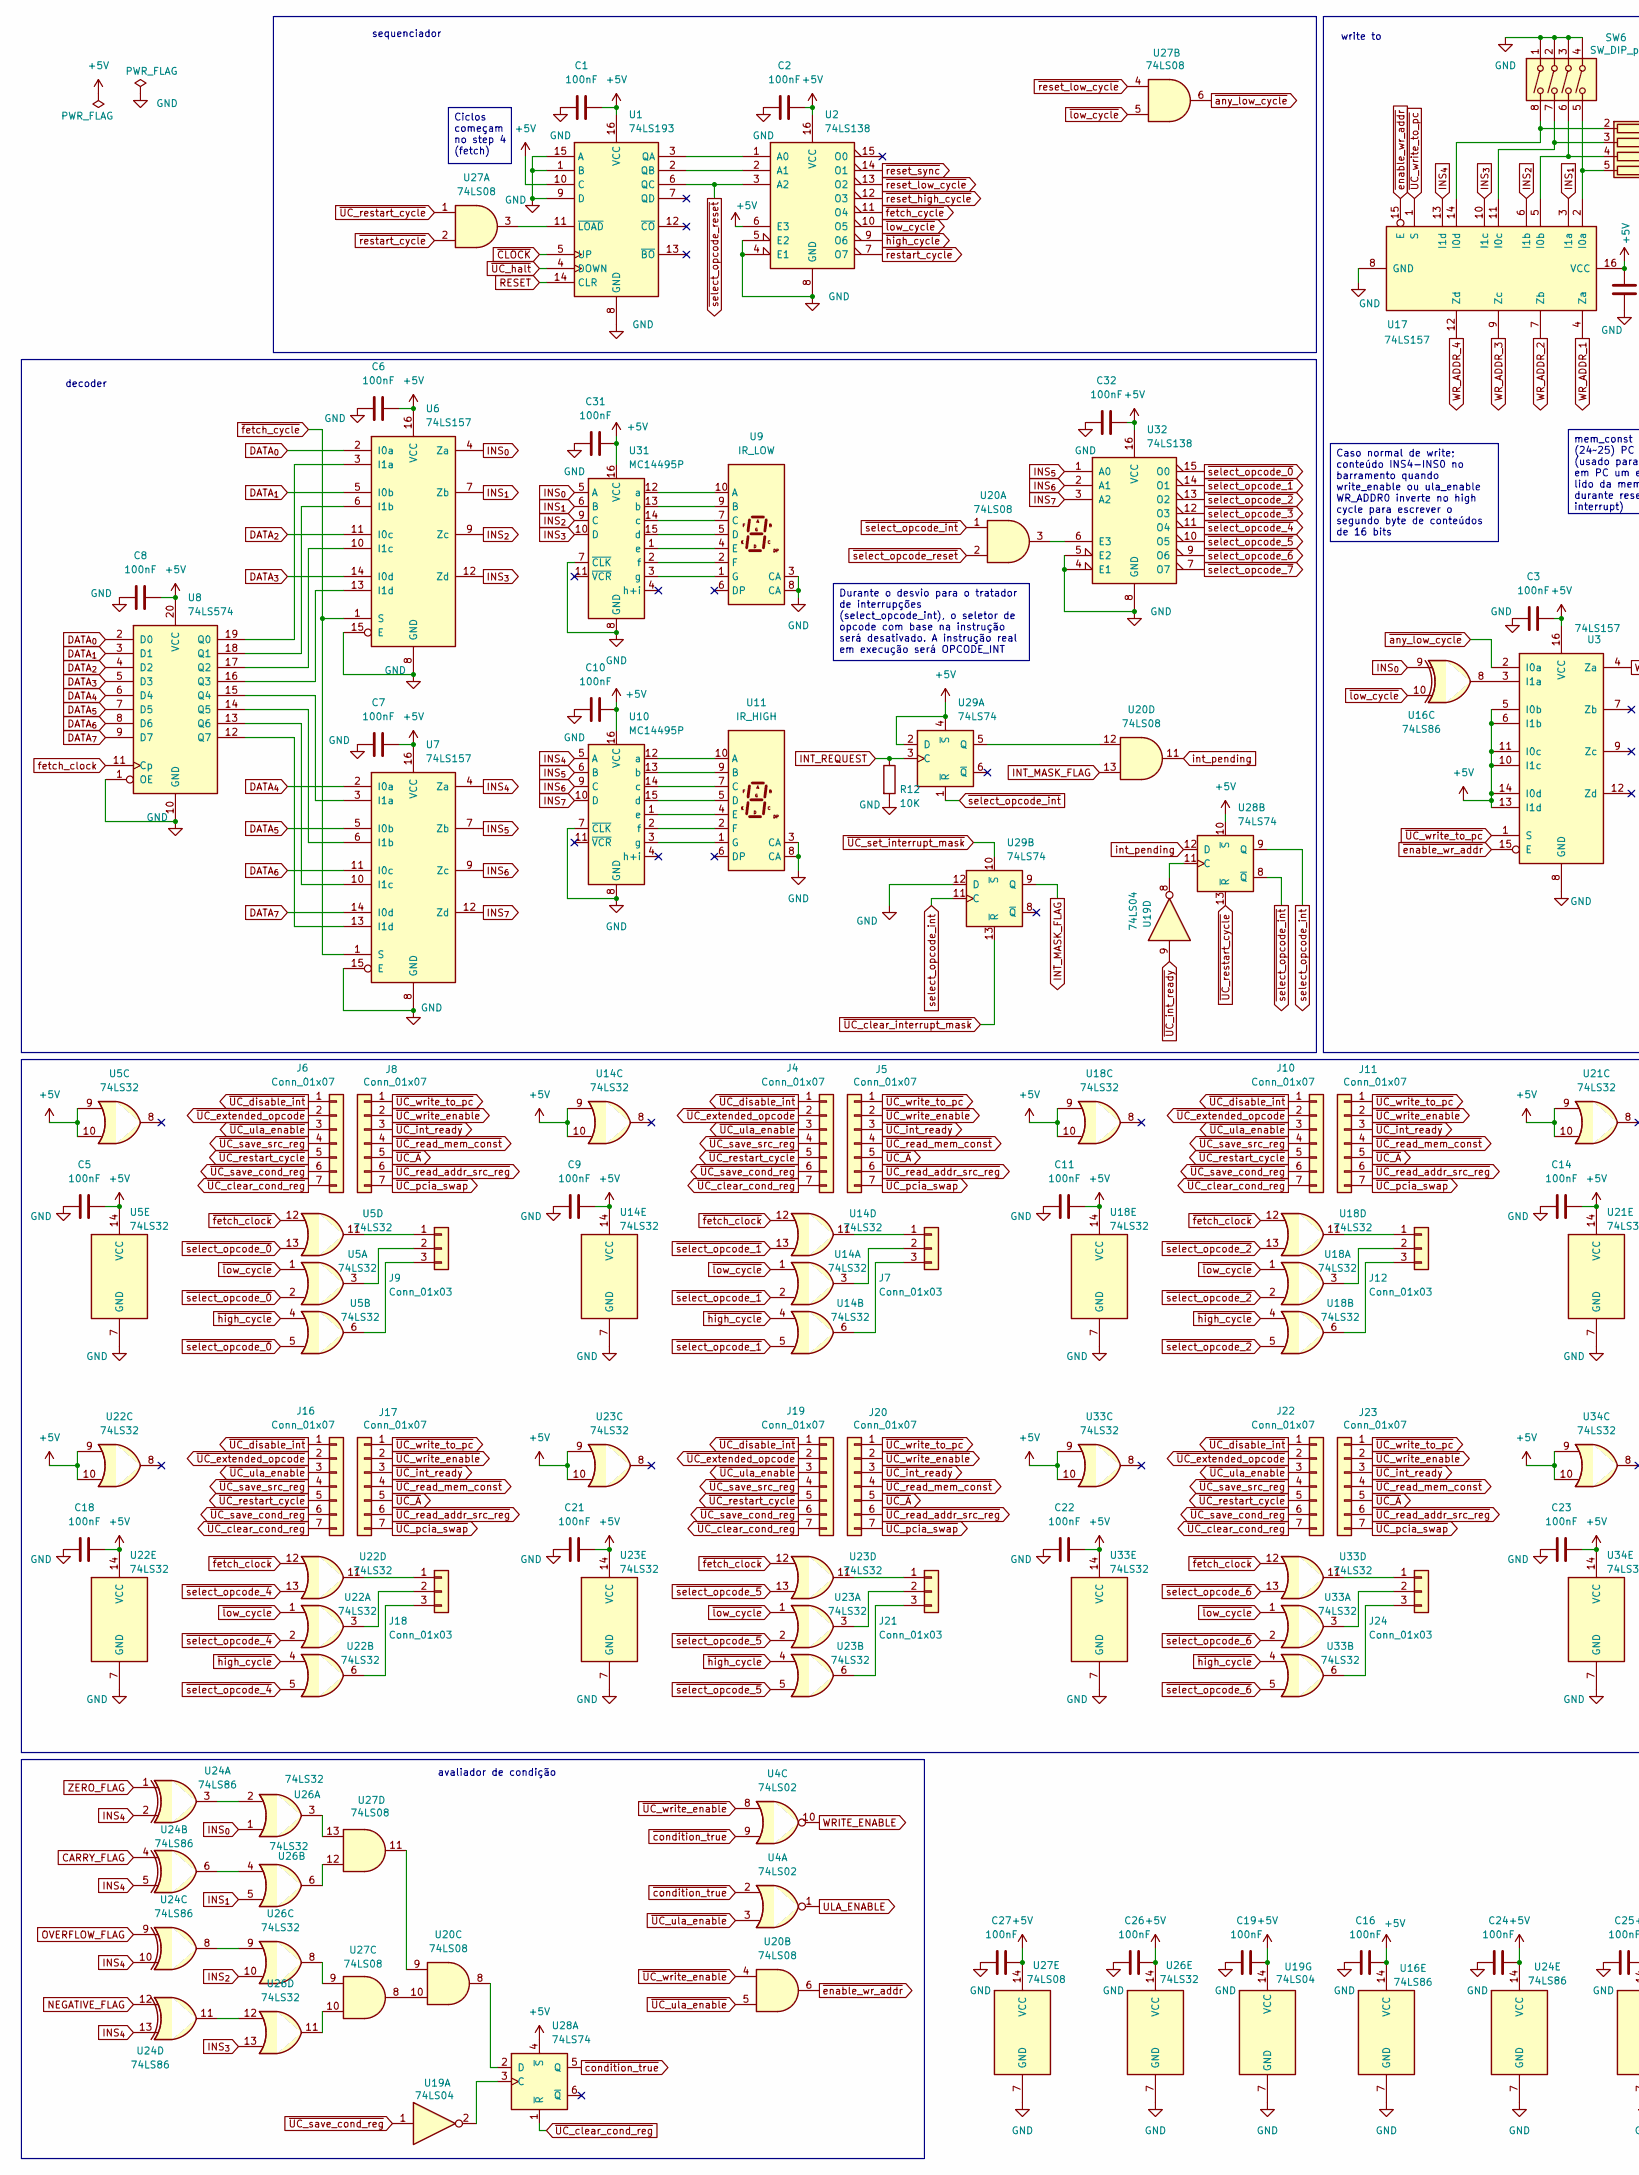
[picture p11: schematic clu.kicad_sch, part in row 1, column 1]

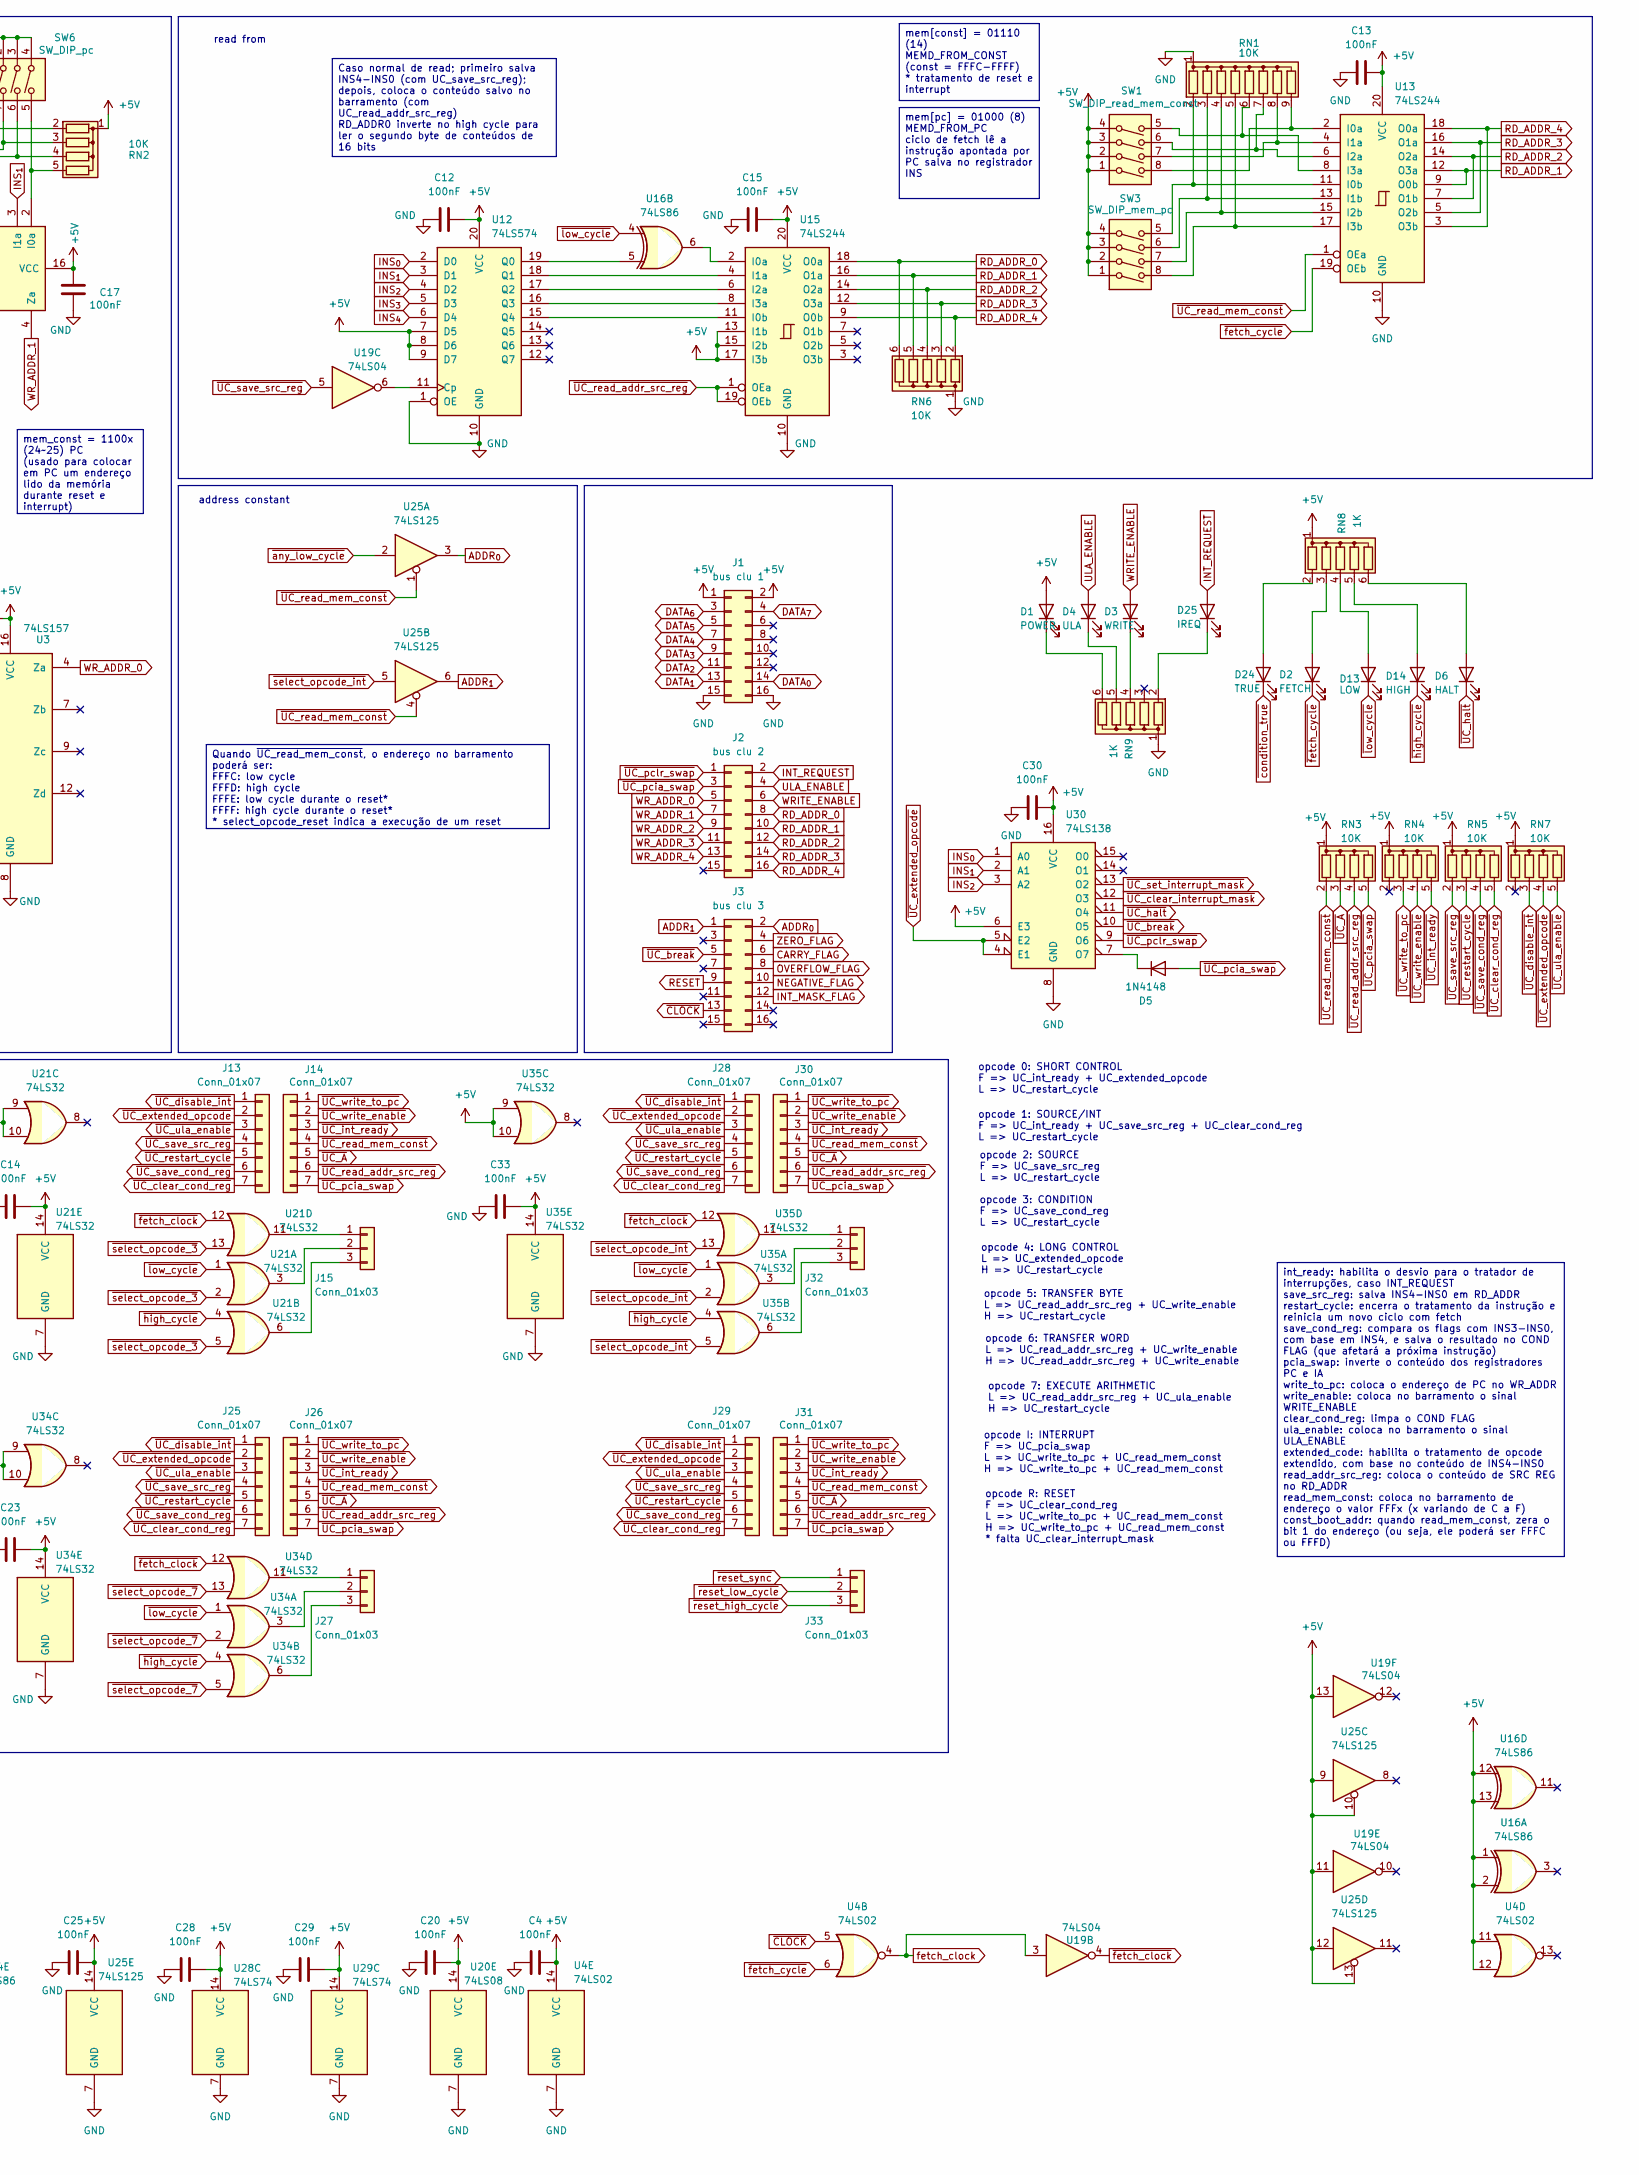
[picture p12: schematic clu.kicad_sch, part in row 1, column 2]

Parts:
C1, C2, C3, C4, C5, C6, C7, C8, C9, C10, C11, C12, C13, C14, C15, C16, C17, C18, C19, C20, C21, C22, C23, C24, C25, C26, C27, C28, C29, C30, C31, C32, C33: 100nF; C_Disc_D5.1mm_W3.2mm_P5.00mm
D1: POWER; LED_D5.0mm
D2: FETCH; LED_D5.0mm
D3: WRITE; LED_D5.0mm
D4: ULA; LED_D5.0mm
D5: 1N4148; D_DO-35_SOD27_P7.62mm_Horizontal
D6: HALT; LED_D5.0mm
D13: LOW; LED_D5.0mm
D14: HIGH; LED_D5.0mm
D24: TRUE; LED_D5.0mm
D25: IREQ; LED_D5.0mm
J1: bus clu 1; conector 02x08
J2: bus clu 2; conector 02x08
J3: bus clu 3; conector 02x08
J4, J5, J6, J8, J10, J11, J13, J14, J16, J17, J19, J20, J22, J23, J25, J26, J28, J29, J30, J31: Conn_01x07; PinHeader_1x07_P2.54mm_Vertical
J7, J9, J12, J15, J18, J21, J24, J27, J32, J33: Conn_01x03; PinHeader_1x03_P2.54mm_Vertical
R12: 10K; R_Axial_DIN0207_L6.3mm_D2.5mm_P7.62mm_Horizontal
RN1: 10K; R_Array_SIP9
RN2, RN3, RN4, RN5, RN7: 10K; R_Array_SIP5
RN6: 10K; R_Array_SIP6
RN8, RN9: 1K; R_Array_SIP6
SW1: SW_DIP_read_mem_const; SW_DIP_SPSTx04_Slide_6.7x11.72mm_W7.62mm_P2.54mm_LowProfile
SW3: SW_DIP_mem_pc; SW_DIP_SPSTx04_Slide_6.7x11.72mm_W7.62mm_P2.54mm_LowProfile
SW6: SW_DIP_pc; SW_DIP_SPSTx04_Slide_6.7x11.72mm_W7.62mm_P2.54mm_LowProfile
U1: 74LS193; DIP-16_W7.62mm
U2, U30, U32: 74LS138; DIP-16_W7.62mm
U3, U6, U7, U17: 74LS157; DIP-16_W7.62mm
U4: 74LS02; DIP-14_W7.62mm
U5, U14, U18, U21, U22, U23, U26, U33, U34, U35: 74LS32; DIP-14_W7.62mm
U8, U12: 74LS574; DIP-20_W7.62mm
U9: IR_LOW; Sx39-1xxxxx
U10, U31: MC14495P; DIP-16_W7.62mm
U11: IR_HIGH; Sx39-1xxxxx
U13, U15: 74LS244; DIP-20_W7.62mm
U16, U24: 74LS86; DIP-14_W7.62mm
U19: 74LS04; DIP-14_W7.62mm
U20, U27: 74LS08; DIP-14_W7.62mm
U25: 74LS125; DIP-14_W7.62mm
U28, U29: 74LS74; DIP-14_W7.62mm

Connections:
+5V: C1.2, C2.2, C3.2, C4.2, C5.2, C6.2, C7.2, C8.2, C9.2, C10.2, C11.2, C12.2, C13.2, C14.2, C15.2, C16.2, C17.2, C18.2, C19.2, C20.2, C21.2, C22.2, C23.2, C24.2, C25.2, C26.2, C27.2, C28.2, C29.2, C30.2, C31.2, C32.2, C33.2, D1.2 (A), J1.1, J1.2, RN2.1 (common), RN3.1 (common), RN4.1 (common), RN5.1 (common), RN7.1 (common), RN8.1 (common), SW1.1, SW1.2, SW1.3, SW1.4, SW3.1, SW3.2, SW3.3, SW3.4, U1.10 (C), U1.16 (VCC), U2.6 (E3), U2.16 (VCC), U3.5 (I0b), U3.6 (I1b), U3.10 (I1c), U3.11 (I0c), U3.13 (I1d), U3.14 (I0d), U3.16 (VCC), U4.11, U4.12, U4.14 (VCC), U5.9, U5.10, U5.14 (VCC), U6.16 (VCC), U7.16 (VCC), U8.20 (VCC), U10.16 (VCC), U12.7 (D5), U12.8 (D6), U12.9 (D7), U12.20 (VCC), U13.20 (VCC), U14.9, U14.10, U14.14 (VCC), U15.13 (I1b), U15.15 (I2b), U15.17 (I3b), U15.20 (VCC), U16.1, U16.2, U16.12, U16.13, U16.14 (VCC), U17.16 (VCC), U18.9, U18.10, U18.14 (VCC), U19.11, U19.13, U19.14 (VCC), U20.14 (VCC), U21.9, U21.10, U21.14 (VCC), U22.9, U22.10, U22.14 (VCC), U23.9, U23.10, U23.14 (VCC), U24.14 (VCC), U25.9, U25.10, U25.12, U25.13, U25.14 (VCC), U26.14 (VCC), U27.14 (VCC), U28.4 (~S), U28.10 (~S), U28.14 (VCC), U29.2 (D), U29.4 (~S), U29.14 (VCC), U30.6 (E3), U30.16 (VCC), U31.16 (VCC), U32.16 (VCC), U33.9, U33.10, U33.14 (VCC), U34.9, U34.10, U34.14 (VCC), U35.9, U35.10, U35.14 (VCC)
ADDR_{0}: J3.2, U25.3
ADDR_{1}: J3.1, U25.6
CARRY_FLAG: J3.6, U24.4
DATA_{0}: J1.14, U6.2 (I0a), U8.2 (D0)
DATA_{1}: J1.13, U6.5 (I0b), U8.3 (D1)
DATA_{2}: J1.11, U6.11 (I0c), U8.4 (D2)
DATA_{3}: J1.9, U6.14 (I0d), U8.5 (D3)
DATA_{4}: J1.7, U7.2 (I0a), U8.6 (D4)
DATA_{5}: J1.5, U7.5 (I0b), U8.7 (D5)
DATA_{6}: J1.3, U7.11 (I0c), U8.8 (D6)
DATA_{7}: J1.4, U7.14 (I0d), U8.9 (D7)
GND: C1.1, C2.1, C3.1, C4.1, C5.1, C6.1, C7.1, C8.1, C9.1, C10.1, C11.1, C12.1, C13.1, C14.1, C15.1, C16.1, C17.1, C18.1, C19.1, C20.1, C21.1, C22.1, C23.1, C24.1, C25.1, C26.1, C27.1, C28.1, C29.1, C30.1, C31.1, C32.1, C33.1, J1.15, J1.16, R12.2, RN1.1 (common), RN6.1 (common), RN9.1 (common), SW6.1, SW6.2, SW6.3, SW6.4, U1.1 (B), U1.8 (GND), U1.9 (D), U1.15 (A), U2.4 (E1), U2.5 (E2), U2.8 (GND), U3.8 (GND), U4.7 (GND), U5.7 (GND), U6.8 (GND), U6.15 (E), U7.8 (GND), U7.15 (E), U8.1 (OE), U8.10 (GND), U9.3 (CA), U9.8 (CA), U10.7 (~CLK), U10.8 (GND), U11.3 (CA), U11.8 (CA), U12.1 (OE), U12.10 (GND), U13.10 (GND), U14.7 (GND), U15.10 (GND), U16.7 (GND), U17.8 (GND), U18.7 (GND), U19.7 (GND), U20.7 (GND), U21.7 (GND), U22.7 (GND), U23.7 (GND), U24.7 (GND), U25.7 (GND), U26.7 (GND), U27.7 (GND), U28.7 (GND), U29.7 (GND), U29.12 (D), U30.8 (GND), U31.7 (~CLK), U31.8 (GND), U32.4 (E1), U32.5 (E2), U32.8 (GND), U33.7 (GND), U34.7 (GND), U35.7 (GND)
INS_{0}: U6.4 (Za), U12.2 (D0), U16.9, U26.1, U30.1 (A0), U31.5 (A)
INS_{1}: U6.7 (Zb), U12.3 (D1), U17.3 (I1a), U26.5, U30.2 (A1), U31.6 (B)
INS_{2}: U6.9 (Zc), U12.4 (D2), U17.6 (I1b), U26.10, U30.3 (A2), U31.9 (C)
INS_{3}: U6.12 (Zd), U12.5 (D3), U17.10 (I1c), U26.13, U31.10 (D)
INS_{4}: U7.4 (Za), U10.5 (A), U12.6 (D4), U17.13 (I1d), U24.2, U24.5, U24.10, U24.13
INS_{5}: U7.7 (Zb), U10.6 (B), U32.1 (A0)
INS_{6}: U7.9 (Zc), U10.9 (C), U32.2 (A1)
INS_{7}: U7.12 (Zd), U10.10 (D), U32.3 (A2)
INT_MASK_FLAG: J3.12, U20.13, U29.9 (Q)
INT_REQUEST: D25.2 (A), J2.2, R12.1, U29.3 (C)
NEGATIVE_FLAG: J3.10, U24.12
unnamed: D1.1 (K), RN9.6 (R5)
unnamed: D2.2 (A), RN8.3 (R2)
unnamed: D3.1 (K), RN9.4 (R3)
unnamed: D4.1 (K), RN9.5 (R4)
unnamed: D5.1 (K), U30.7 (O7)
unnamed: D6.2 (A), RN8.6 (R5)
unnamed: D13.2 (A), RN8.4 (R3)
unnamed: D14.2 (A), RN8.5 (R4)
unnamed: D24.2 (A), RN8.2 (R1)
unnamed: D25.1 (K), RN9.2 (R1)
unnamed: J7.1, U14.11
unnamed: J7.2, U14.3
unnamed: J7.3, U14.6
unnamed: J9.1, U5.11
unnamed: J9.2, U5.3
unnamed: J9.3, U5.6
unnamed: J12.1, U18.11
unnamed: J12.2, U18.3
unnamed: J12.3, U18.6
unnamed: J15.1, U21.11
unnamed: J15.2, U21.3
unnamed: J15.3, U21.6
unnamed: J18.1, U22.11
unnamed: J18.2, U22.3
unnamed: J18.3, U22.6
unnamed: J21.1, U23.11
unnamed: J21.2, U23.3
unnamed: J21.3, U23.6
unnamed: J24.1, U33.11
unnamed: J24.2, U33.3
unnamed: J24.3, U33.6
unnamed: J27.1, U34.11
unnamed: J27.2, U34.3
unnamed: J27.3, U34.6
unnamed: J32.1, U35.11
unnamed: J32.2, U35.3
unnamed: J32.3, U35.6
unnamed: RN1.2 (R1), SW3.5, U13.11 (I0b)
unnamed: RN1.3 (R2), SW3.6, U13.13 (I1b)
unnamed: RN1.4 (R3), SW3.7, U13.15 (I2b)
unnamed: RN1.5 (R4), SW3.8, U13.17 (I3b)
unnamed: RN1.6 (R5), SW1.5, U13.8 (I3a)
unnamed: RN1.7 (R6), SW1.6, U13.6 (I2a)
unnamed: RN1.8 (R7), SW1.7, U13.4 (I1a)
unnamed: RN1.9 (R8), SW1.8, U13.2 (I0a)
unnamed: RN2.2 (R1), SW6.8, U17.14 (I0d)
unnamed: RN2.3 (R2), SW6.7, U17.11 (I0c)
unnamed: RN2.4 (R3), SW6.6, U17.5 (I0b)
unnamed: RN2.5 (R4), SW6.5, U17.2 (I0a)
unnamed: U1.3 (QA), U2.1 (A0)
unnamed: U1.2 (QB), U2.2 (A1)
unnamed: U1.11 (~LOAD), U27.3
unnamed: U3.3 (I1a), U16.8
unnamed: U6.3 (I1a), U8.19 (Q0)
unnamed: U6.6 (I1b), U8.18 (Q1)
unnamed: U6.10 (I1c), U8.17 (Q2)
unnamed: U6.13 (I1d), U8.16 (Q3)
unnamed: U7.3 (I1a), U8.15 (Q4)
unnamed: U7.6 (I1b), U8.14 (Q5)
unnamed: U7.10 (I1c), U8.13 (Q6)
unnamed: U7.13 (I1d), U8.12 (Q7)
unnamed: U10.12 (a), U11.10 (A)
unnamed: U10.13 (b), U11.9 (B)
unnamed: U10.14 (c), U11.7 (C)
unnamed: U10.15 (d), U11.5 (D)
unnamed: U10.1 (e), U11.4 (E)
unnamed: U10.2 (f), U11.2 (F)
unnamed: U10.3 (g), U11.1 (G)
unnamed: U12.11 (Cp), U19.6
unnamed: U12.19 (Q0), U16.5
unnamed: U12.18 (Q1), U15.4 (I1a)
unnamed: U12.17 (Q2), U15.6 (I2a)
unnamed: U12.16 (Q3), U15.8 (I3a)
unnamed: U12.15 (Q4), U15.11 (I0b)
unnamed: U15.2 (I0a), U16.6
unnamed: U20.9, U27.11
unnamed: U20.10, U27.8
unnamed: U24.3, U26.2
unnamed: U24.6, U26.4
unnamed: U24.8, U26.9
unnamed: U24.11, U26.12
unnamed: U26.3, U27.13
unnamed: U26.6, U27.12
unnamed: U26.8, U27.9
unnamed: U26.11, U27.10
unnamed: U19.2, U28.3 (C)
unnamed: U20.8, U28.2 (D)
unnamed: U19.8, U28.11 (C)
unnamed: U20.12, U29.5 (Q)
unnamed: U9.10 (A), U31.12 (a)
unnamed: U9.9 (B), U31.13 (b)
unnamed: U9.7 (C), U31.14 (c)
unnamed: U9.5 (D), U31.15 (d)
unnamed: U9.4 (E), U31.1 (e)
unnamed: U9.2 (F), U31.2 (f)
unnamed: U9.1 (G), U31.3 (g)
unnamed: U20.3, U32.6 (E3)
OVERFLOW_FLAG: J3.8, U24.9
RD_ADDR_0: J2.8, RN6.6 (R5), U15.18 (O0a)
RD_ADDR_1: J2.10, RN6.5 (R4), U13.9 (O0b), U13.12 (O3a), U15.16 (O1a)
RD_ADDR_2: J2.12, RN6.4 (R3), U13.7 (O1b), U13.14 (O2a), U15.14 (O2a)
RD_ADDR_3: J2.14, RN6.3 (R2), U13.5 (O2b), U13.16 (O1a), U15.12 (O3a)
RD_ADDR_4: J2.16, RN6.2 (R1), U13.3 (O3b), U13.18 (O0a), U15.9 (O0b)
RESET: J3.9, U1.14 (CLR)
ULA_ENABLE: D4.2 (A), J2.4, U4.1
WRITE_ENABLE: D3.2 (A), J2.6, U4.10
WR_ADDR_0: J2.5, U3.4 (Za)
WR_ADDR_1: J2.7, U17.4 (Za)
WR_ADDR_2: J2.9, U17.7 (Zb)
WR_ADDR_3: J2.11, U17.9 (Zc)
WR_ADDR_4: J2.13, U17.12 (Zd)
ZERO_FLAG: J3.4, U24.1
fetch_clock: U4.4, U8.11 (Cp), U19.3
int_pending: U20.11, U28.12 (D)
select_opcode_int: U28.9 (Q), U29.11 (C)
~CLOCK: J3.13, U1.5 (UP), U4.5
~UC_A: J5.5, J8.5, J11.5, J14.5, J17.5, J20.5, J23.5, J26.5, J30.5, J31.5, RN3.3 (R2)
~UC_break: J3.5, U30.10 (O5)
~UC_clear_cond_reg: J4.7, J6.7, J10.7, J13.7, J16.7, J19.7, J22.7, J25.7, J28.7, J29.7, RN5.5 (R4), U28.1 (~R)
~UC_clear_interrupt_mask: U29.13 (~R), U30.12 (O3)
~UC_disable_int: J4.1, J6.1, J10.1, J13.1, J16.1, J19.1, J22.1, J25.1, J28.1, J29.1, RN7.3 (R2)
~UC_extended_opcode: J4.2, J6.2, J10.2, J13.2, J16.2, J19.2, J22.2, J25.2, J28.2, J29.2, RN7.4 (R3), U30.4 (E1), U30.5 (E2)
~UC_halt: D6.1 (K), U1.4 (DOWN), U30.11 (O4)
~UC_int_ready: J5.3, J8.3, J11.3, J14.3, J17.3, J20.3, J23.3, J26.3, J30.3, J31.3, RN4.5 (R4), U19.9
~UC_pcia_swap: D5.2 (A), J2.3, J5.7, J8.7, J11.7, J14.7, J17.7, J20.7, J23.7, J26.7, J30.7, J31.7, RN3.5 (R4)
~UC_pclr_swap: J2.1, U30.9 (O6)
~UC_read_addr_src_reg: J5.6, J8.6, J11.6, J14.6, J17.6, J20.6, J23.6, J26.6, J30.6, J31.6, RN3.4 (R3), U15.1 (OEa), U15.19 (OEb)
~UC_read_mem_const: J5.4, J8.4, J11.4, J14.4, J17.4, J20.4, J23.4, J26.4, J30.4, J31.4, RN3.2 (R1), U13.1 (OEa), U25.1, U25.4
~UC_restart_cycle: J4.5, J6.5, J10.5, J13.5, J16.5, J19.5, J22.5, J25.5, J28.5, J29.5, RN5.3 (R2), U27.1, U28.13 (~R)
~UC_save_cond_reg: J4.6, J6.6, J10.6, J13.6, J16.6, J19.6, J22.6, J25.6, J28.6, J29.6, RN5.4 (R3), U19.1
~UC_save_src_reg: J4.4, J6.4, J10.4, J13.4, J16.4, J19.4, J22.4, J25.4, J28.4, J29.4, RN5.2 (R1), U19.5
~UC_set_interrupt_mask: U29.10 (~S), U30.13 (O2)
~UC_ula_enable: J4.3, J6.3, J10.3, J13.3, J16.3, J19.3, J22.3, J25.3, J28.3, J29.3, RN7.5 (R4), U4.3, U20.5
~UC_write_enable: J5.2, J8.2, J11.2, J14.2, J17.2, J20.2, J23.2, J26.2, J30.2, J31.2, RN4.4 (R3), U4.8, U20.4
~UC_write_to_pc: J5.1, J8.1, J11.1, J14.1, J17.1, J20.1, J23.1, J26.1, J30.1, J31.1, RN4.3 (R2), U3.1 (S), U17.1 (S)
~any_low_cycle: U3.2 (I0a), U25.2, U27.6
~condition_true: D24.1 (K), U4.2, U4.9, U28.5 (Q)
~enable_wr_addr: U3.15 (E), U17.15 (E), U20.6
~fetch_clock: U5.12, U14.12, U18.12, U19.4, U21.12, U22.12, U23.12, U33.12, U34.12, U35.12
~fetch_cycle: D2.1 (K), U2.11 (O4), U4.6, U6.1 (S), U7.1 (S), U13.19 (OEb)
~high_cycle: D14.1 (K), U2.9 (O6), U5.4, U14.4, U18.4, U21.4, U22.4, U23.4, U33.4, U34.4, U35.4
~low_cycle: D13.1 (K), U2.10 (O5), U5.1, U14.1, U16.4, U16.10, U18.1, U21.1, U22.1, U23.1, U27.5, U33.1, U34.1, U35.1
~reset_high_cycle: J33.3, U2.12 (O3)
~reset_low_cycle: J33.2, U2.13 (O2), U27.4
~reset_sync: J33.1, U2.14 (O1)
~restart_cycle: U2.7 (O7), U27.2
~select_opcode_0: U5.2, U5.5, U5.13, U32.15 (O0)
~select_opcode_1: U14.2, U14.5, U14.13, U32.14 (O1)
~select_opcode_2: U18.2, U18.5, U18.13, U32.13 (O2)
~select_opcode_3: U21.2, U21.5, U21.13, U32.12 (O3)
~select_opcode_4: U22.2, U22.5, U22.13, U32.11 (O4)
~select_opcode_5: U23.2, U23.5, U23.13, U32.10 (O5)
~select_opcode_6: U32.9 (O6), U33.2, U33.5, U33.13
~select_opcode_7: U32.7 (O7), U34.2, U34.5, U34.13
~select_opcode_int: U20.1, U25.5, U28.8 (~Q), U29.1 (~R), U35.2, U35.5, U35.13
~select_opcode_reset: U1.6 (QC), U2.3 (A2), U20.2

Notes on the sheet:
opcode 1: SOURCE/INT F => UC_int_ready + UC_save_src_reg + UC_clear_cond_reg L => UC_restart_cycle
opcode 2: SOURCE F => UC_save_src_reg L => UC_restart_cycle
sequenciador
write to
opcode 7: EXECUTE ARITHMETIC L => UC_read_addr_src_reg + UC_ula_enable H => UC_restart_cycle
avaliador de condição
decoder
read from
opcode 6: TRANSFER WORD L => UC_read_addr_src_reg + UC_write_enable H => UC_read_addr_src_reg + UC_write_enable
address constant
opcode R: RESET F => UC_clear_cond_reg L => UC_write_to_pc + UC_read_mem_const H => UC_write_to_pc + UC_read_mem_const * falta UC_clear_interrupt_mask
opcode 4: LONG CONTROL L => UC_extended_opcode H => UC_restart_cycle
opcode I: INTERRUPT F => UC_pcia_swap L => UC_write_to_pc + UC_read_mem_const H => UC_write_to_pc + UC_read_mem_const
opcode 3: CONDITION F => UC_save_cond_reg L => UC_restart_cycle
opcode 0: SHORT CONTROL F => UC_int_ready + UC_extended_opcode L => UC_restart_cycle
opcode 5: TRANSFER BYTE L => UC_read_addr_src_reg + UC_write_enable H => UC_restart_cycle
Caso normal de read; primeiro salva INS4-INS0 (com UC_save_src_reg); depois, coloca o conteúdo salvo no barramento (com UC_read_addr_src_reg) RD_ADDR0 inverte no high cycle para ler o segundo byte de conteúdos de 16 bits
mem_const = 1100x (24~25) PC (usado para colocar em PC um endereço lido da memória durante reset e interrupt)
Caso normal de write; conteúdo INS4-INS0 no barramento quando write_enable ou ula_enable WR_ADDR0 inverte no high cycle para escrever o segundo byte de conteúdos de 16 bits
Quando ~{UC_read_mem_const}, o endereço no barramento poderá ser: FFFC: low cycle FFFD: high cycle FFFE: low cycle durante o reset* FFFF: high cycle durante o reset* * select_opcode_reset indica a execução de um reset
Durante o desvio para o tratador de interrupções (select_opcode_int), o seletor de opcode com base na instrução será desativado. A instrução real em execução será OPCODE_INT
int_ready: habilita o desvio para o tratador de interrupções, caso INT_REQUEST save_src_reg: salva INS4-INS0 em RD_ADDR restart_cycle: encerra o tratamento da instrução e reinicia um novo ciclo com fetch save_cond_reg: compara os flags com INS3-INS0, com base em INS4, e salva o resultado no COND FL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
mem[pc] = 01000 (8) MEMD_FROM_PC ciclo de fetch lê a instrução apontada por PC salva no registrador INS
Ciclos começam no step 4 (fetch)
mem[const] = 01110 (14) MEMD_FROM_CONST (const = FFFC-FFFF) * tratamento de reset e interrupt

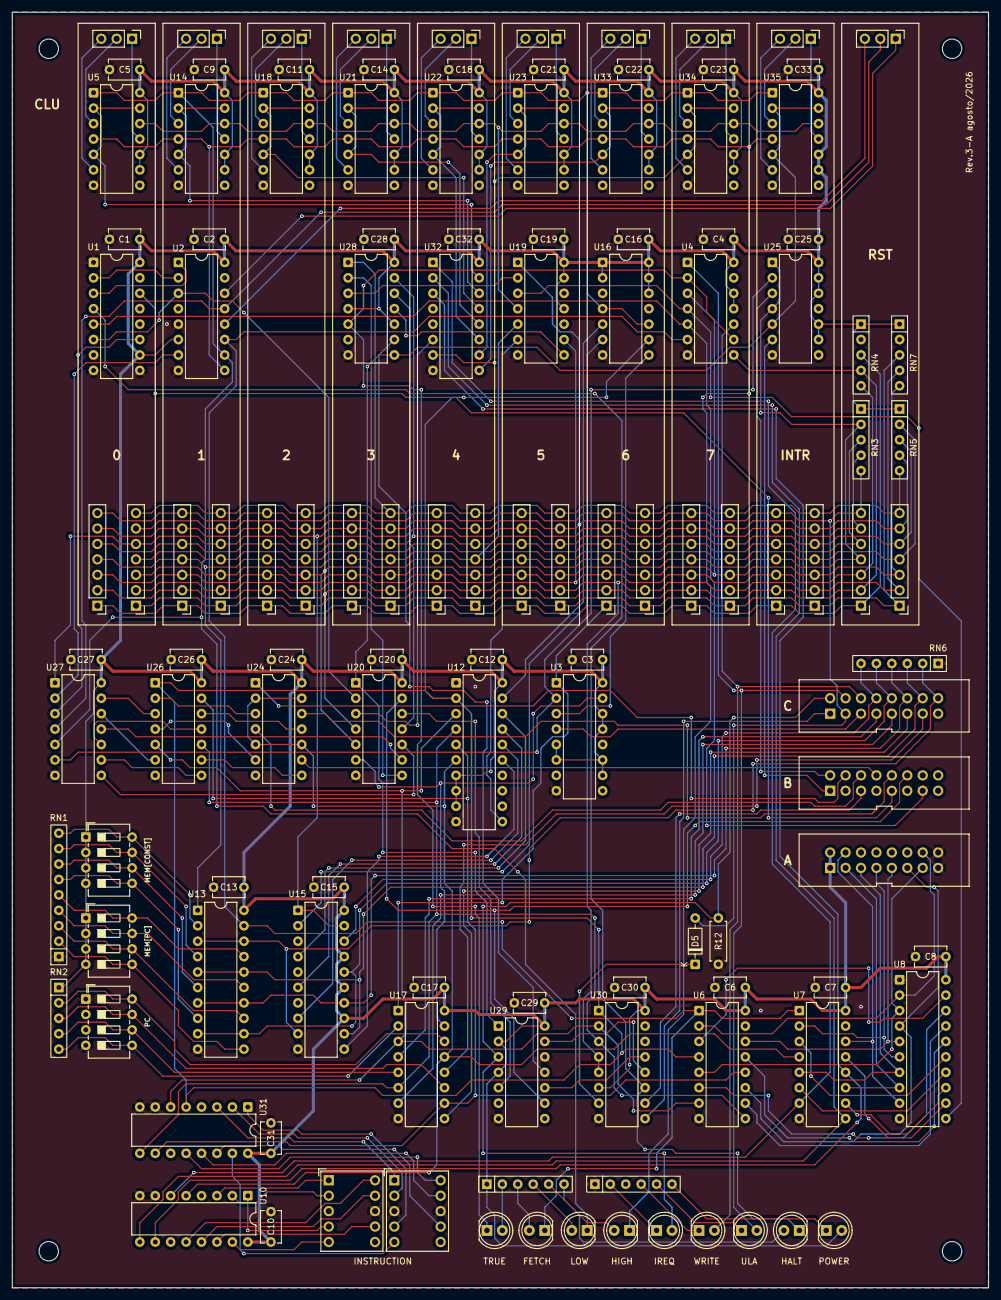
[picture p13: board clu.kicad_pcb from above]

Board: 2 copper layers, 160.7 x 210.0 mm, 124 parts (0 on the bottom side), 180 nets.
