rcapaverde/cubo/pcb_v3/mem/mem.kicad_pcb

## KiCad design pcb_v3/mem/mem.kicad_pcb (2026-07-05)

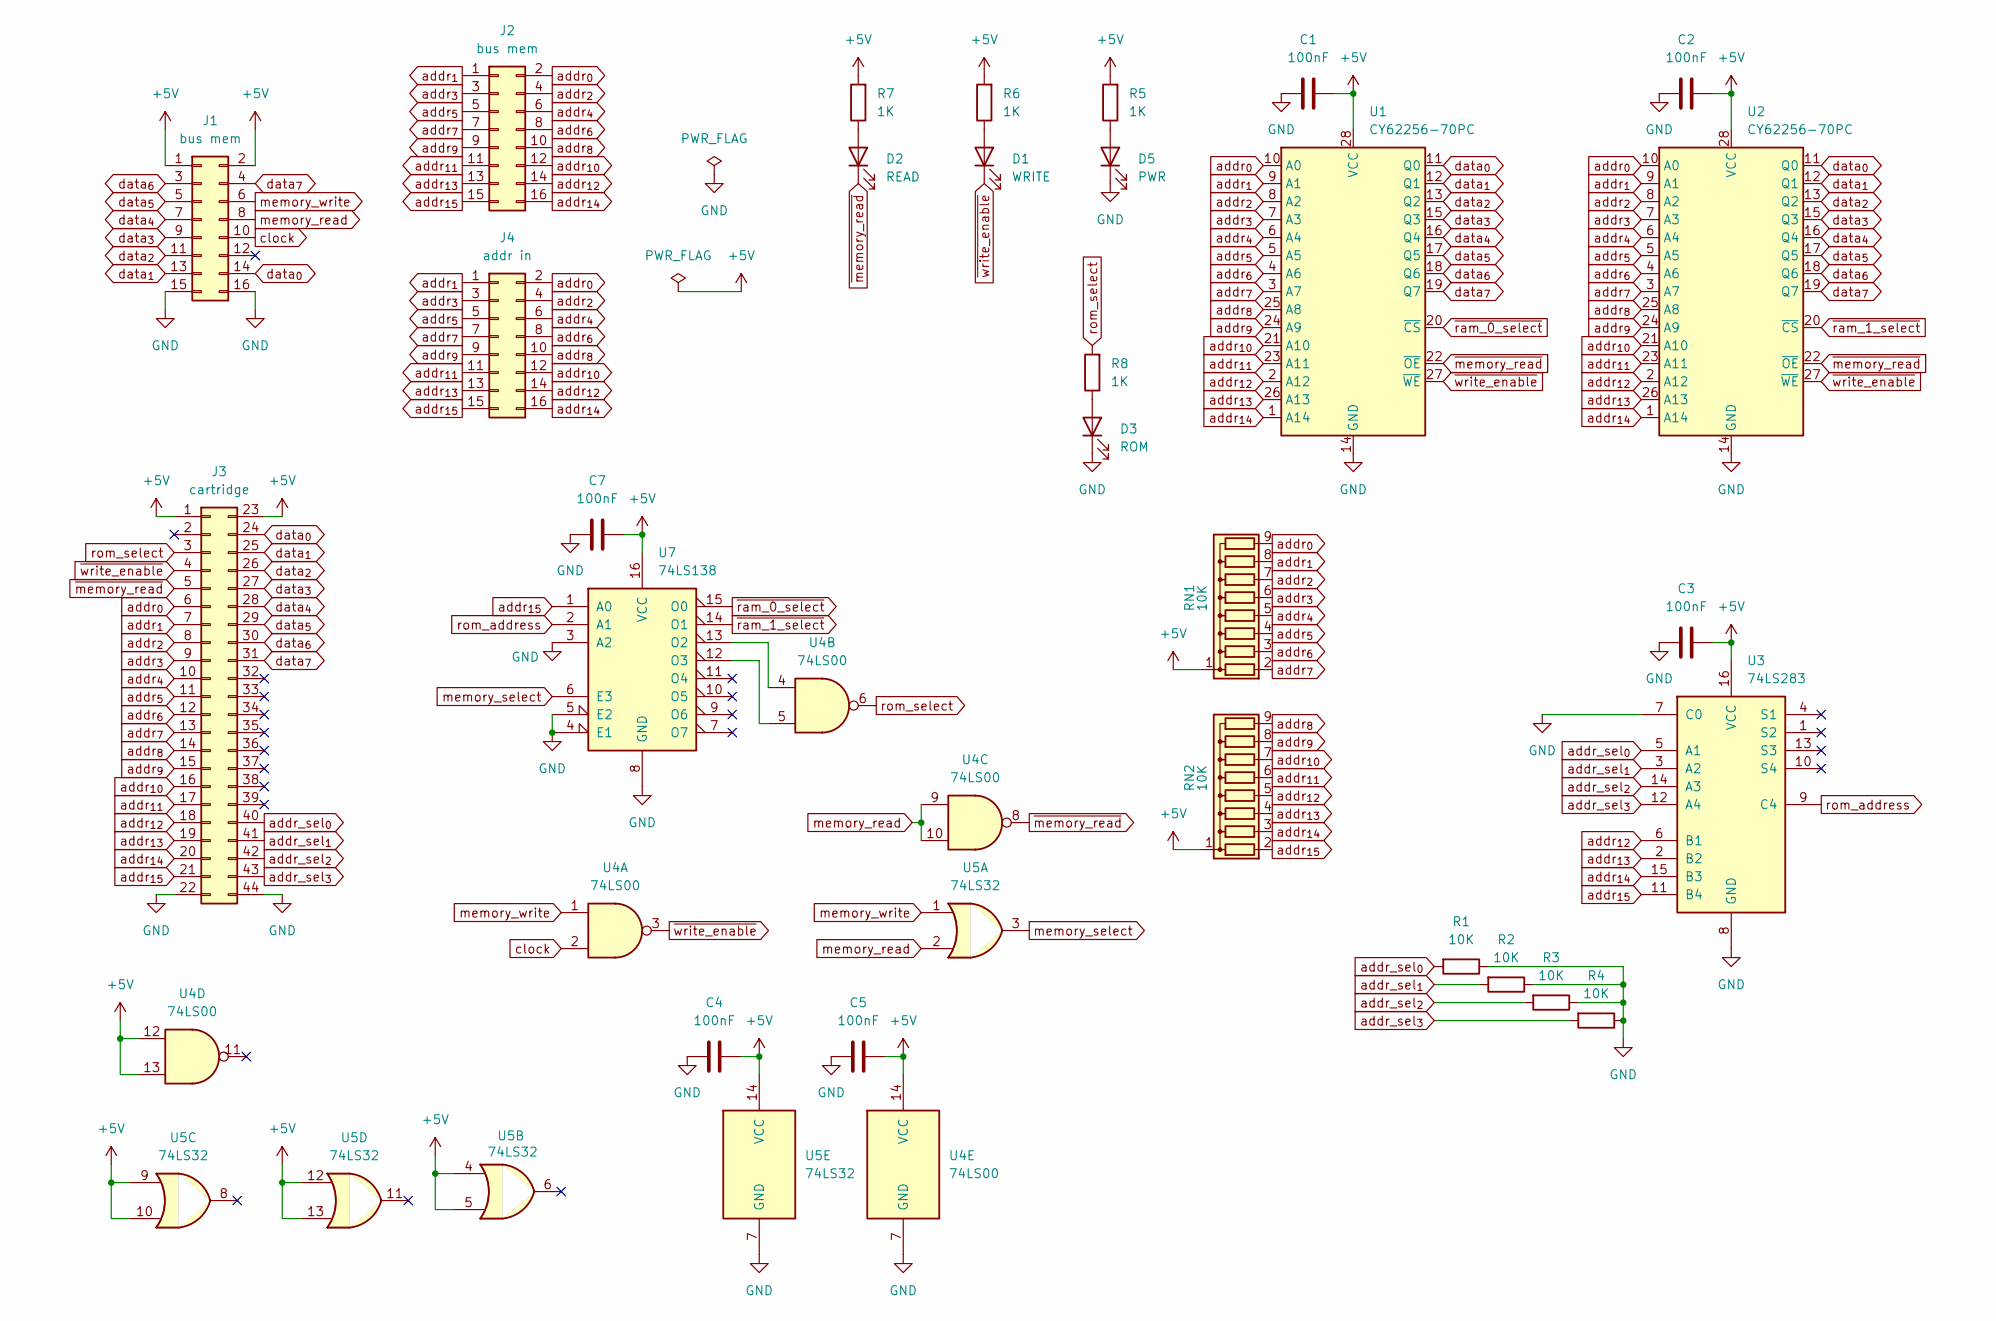
[picture p14: schematic mem.kicad_sch]

Parts:
C1, C2, C3, C4, C5, C7: 100nF; C_Disc_D5.1mm_W3.2mm_P5.00mm
D1: WRITE; LED_D5.0mm
D2: READ; LED_D5.0mm
D3: ROM; LED_D5.0mm
D5: PWR; LED_D5.0mm
J1, J2: bus mem; conector 02x08
J3: cartridge; male-edge-connector-44
J4: addr in; conector 02x08
R1, R2, R3, R4: 10K; R_Axial_DIN0207_L6.3mm_D2.5mm_P7.62mm_Horizontal
R5, R6, R7, R8: 1K; R_Axial_DIN0207_L6.3mm_D2.5mm_P7.62mm_Horizontal
RN1, RN2: 10K; R_Array_SIP9
U1, U2: CY62256-70PC; DIP-28_W15.24mm
U3: 74LS283; DIP-16_W7.62mm
U4: 74LS00; DIP-14_W7.62mm
U5: 74LS32; DIP-14_W7.62mm
U7: 74LS138; DIP-16_W7.62mm

Connections:
+5V: C1.2, C2.2, C3.2, C4.2, C5.2, C7.2, J1.1, J1.2, J3.1, J3.23, R5.2, R6.2, R7.2, RN1.1 (common), RN2.1 (common), U1.28 (VCC), U2.28 (VCC), U3.16 (VCC), U4.12, U4.13, U4.14 (VCC), U5.4, U5.5, U5.9, U5.10, U5.12, U5.13, U5.14 (VCC), U7.16 (VCC)
GND: C1.1, C2.1, C3.1, C4.1, C5.1, C7.1, D3.1 (K), D5.1 (K), J1.15, J1.16, J3.22, J3.44, R1.1, R2.1, R3.1, R4.1, U1.14 (GND), U2.14 (GND), U3.7 (C0), U3.8 (GND), U4.7 (GND), U5.7 (GND), U7.3 (A2), U7.4 (E1), U7.5 (E2), U7.8 (GND)
unnamed: D1.2 (A), R6.1
unnamed: D2.2 (A), R7.1
unnamed: D3.2 (A), R8.1
unnamed: D5.2 (A), R5.1
unnamed: U4.4, U7.13 (O2)
unnamed: U4.5, U7.12 (O3)
addr_sel_{0}: J3.40, R1.2, U3.5 (A1)
addr_sel_{1}: J3.41, R2.2, U3.3 (A2)
addr_sel_{2}: J3.42, R3.2, U3.14 (A3)
addr_sel_{3}: J3.43, R4.2, U3.12 (A4)
addr_{0}: J2.2, J3.6, J4.2, RN1.9 (R8), U1.10 (A0), U2.10 (A0)
addr_{1}: J2.1, J3.7, J4.1, RN1.8 (R7), U1.9 (A1), U2.9 (A1)
addr_{2}: J2.4, J3.8, J4.4, RN1.7 (R6), U1.8 (A2), U2.8 (A2)
addr_{3}: J2.3, J3.9, J4.3, RN1.6 (R5), U1.7 (A3), U2.7 (A3)
addr_{4}: J2.6, J3.10, J4.6, RN1.5 (R4), U1.6 (A4), U2.6 (A4)
addr_{5}: J2.5, J3.11, J4.5, RN1.4 (R3), U1.5 (A5), U2.5 (A5)
addr_{6}: J2.8, J3.12, J4.8, RN1.3 (R2), U1.4 (A6), U2.4 (A6)
addr_{7}: J2.7, J3.13, J4.7, RN1.2 (R1), U1.3 (A7), U2.3 (A7)
addr_{8}: J2.10, J3.14, J4.10, RN2.9 (R8), U1.25 (A8), U2.25 (A8)
addr_{9}: J2.9, J3.15, J4.9, RN2.8 (R7), U1.24 (A9), U2.24 (A9)
addr_{10}: J2.12, J3.16, J4.12, RN2.7 (R6), U1.21 (A10), U2.21 (A10)
addr_{11}: J2.11, J3.17, J4.11, RN2.6 (R5), U1.23 (A11), U2.23 (A11)
addr_{12}: J2.14, J3.18, J4.14, RN2.5 (R4), U1.2 (A12), U2.2 (A12), U3.6 (B1)
addr_{13}: J2.13, J3.19, J4.13, RN2.4 (R3), U1.26 (A13), U2.26 (A13), U3.2 (B2)
addr_{14}: J2.16, J3.20, J4.16, RN2.3 (R2), U1.1 (A14), U2.1 (A14), U3.15 (B3)
addr_{15}: J2.15, J3.21, J4.15, RN2.2 (R1), U3.11 (B4), U7.1 (A0)
clock: J1.10, U4.2
data_{0}: J1.14, J3.24, U1.11 (Q0), U2.11 (Q0)
data_{1}: J1.13, J3.25, U1.12 (Q1), U2.12 (Q1)
data_{2}: J1.11, J3.26, U1.13 (Q2), U2.13 (Q2)
data_{3}: J1.9, J3.27, U1.15 (Q3), U2.15 (Q3)
data_{4}: J1.7, J3.28, U1.16 (Q4), U2.16 (Q4)
data_{5}: J1.5, J3.29, U1.17 (Q5), U2.17 (Q5)
data_{6}: J1.3, J3.30, U1.18 (Q6), U2.18 (Q6)
data_{7}: J1.4, J3.31, U1.19 (Q7), U2.19 (Q7)
memory_read: J1.8, U4.9, U4.10, U5.2
memory_select: U5.3, U7.6 (E3)
memory_write: J1.6, U4.1, U5.1
rom_address: U3.9 (C4), U7.2 (A1)
rom_select: J3.3, R8.2, U4.6
~memory_read: D2.1 (K), J3.5, U1.22 (~OE), U2.22 (~OE), U4.8
~ram_0_select: U1.20 (~CS), U7.15 (O0)
~ram_1_select: U2.20 (~CS), U7.14 (O1)
~write_enable: D1.1 (K), J3.4, U1.27 (~WE), U2.27 (~WE), U4.3

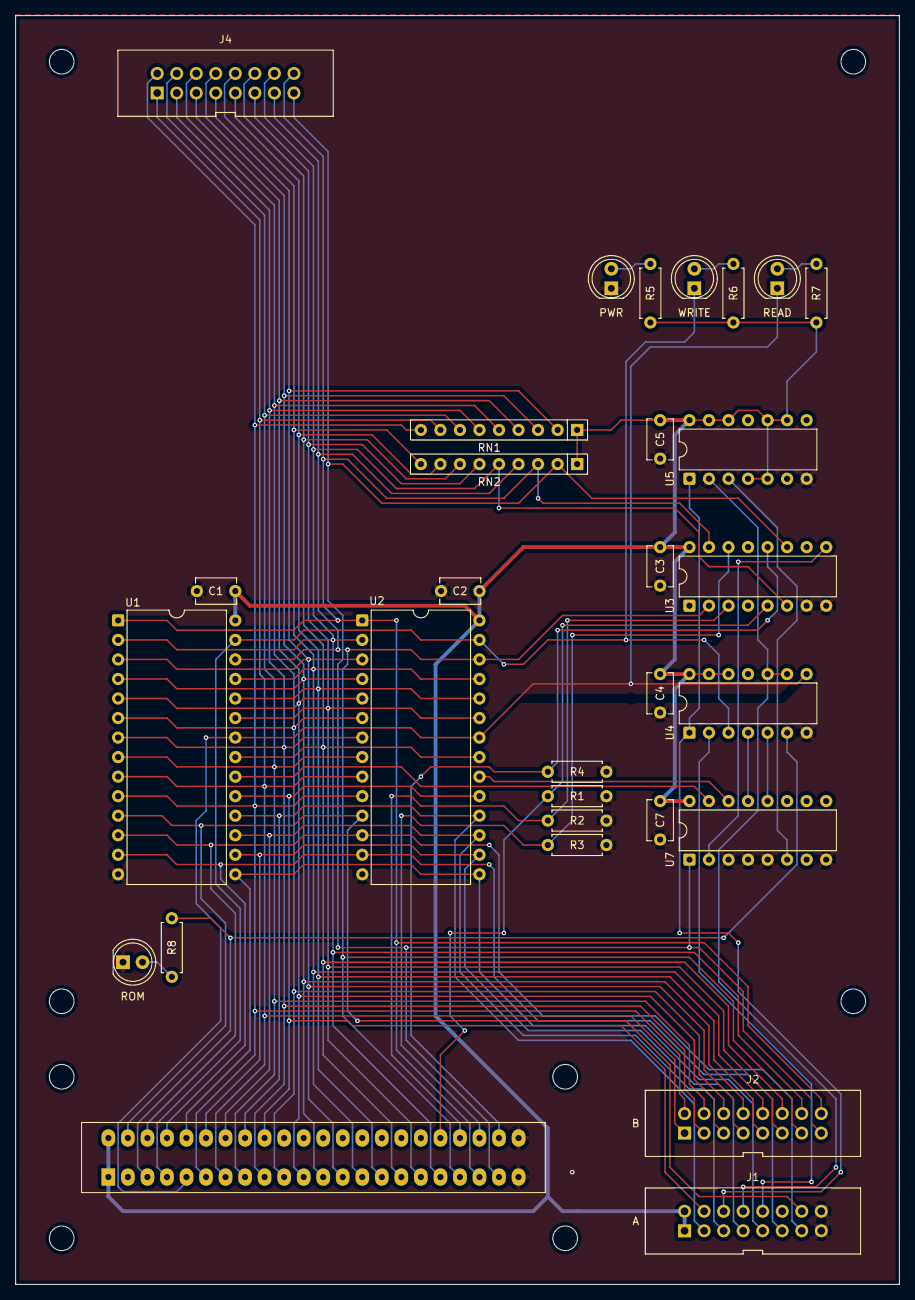
[picture p15: board pcb_v3/mem/mem.kicad_pcb from above]

Board: 2 copper layers, 114.9 x 165.0 mm, 30 parts (0 on the bottom side), 46 nets.
