rcapaverde/cubo/pcb_v3/s16rf/s16rf.kicad_pcb

## KiCad design pcb_v3/s16rf/s16rf.kicad_pcb (2026-06-28)

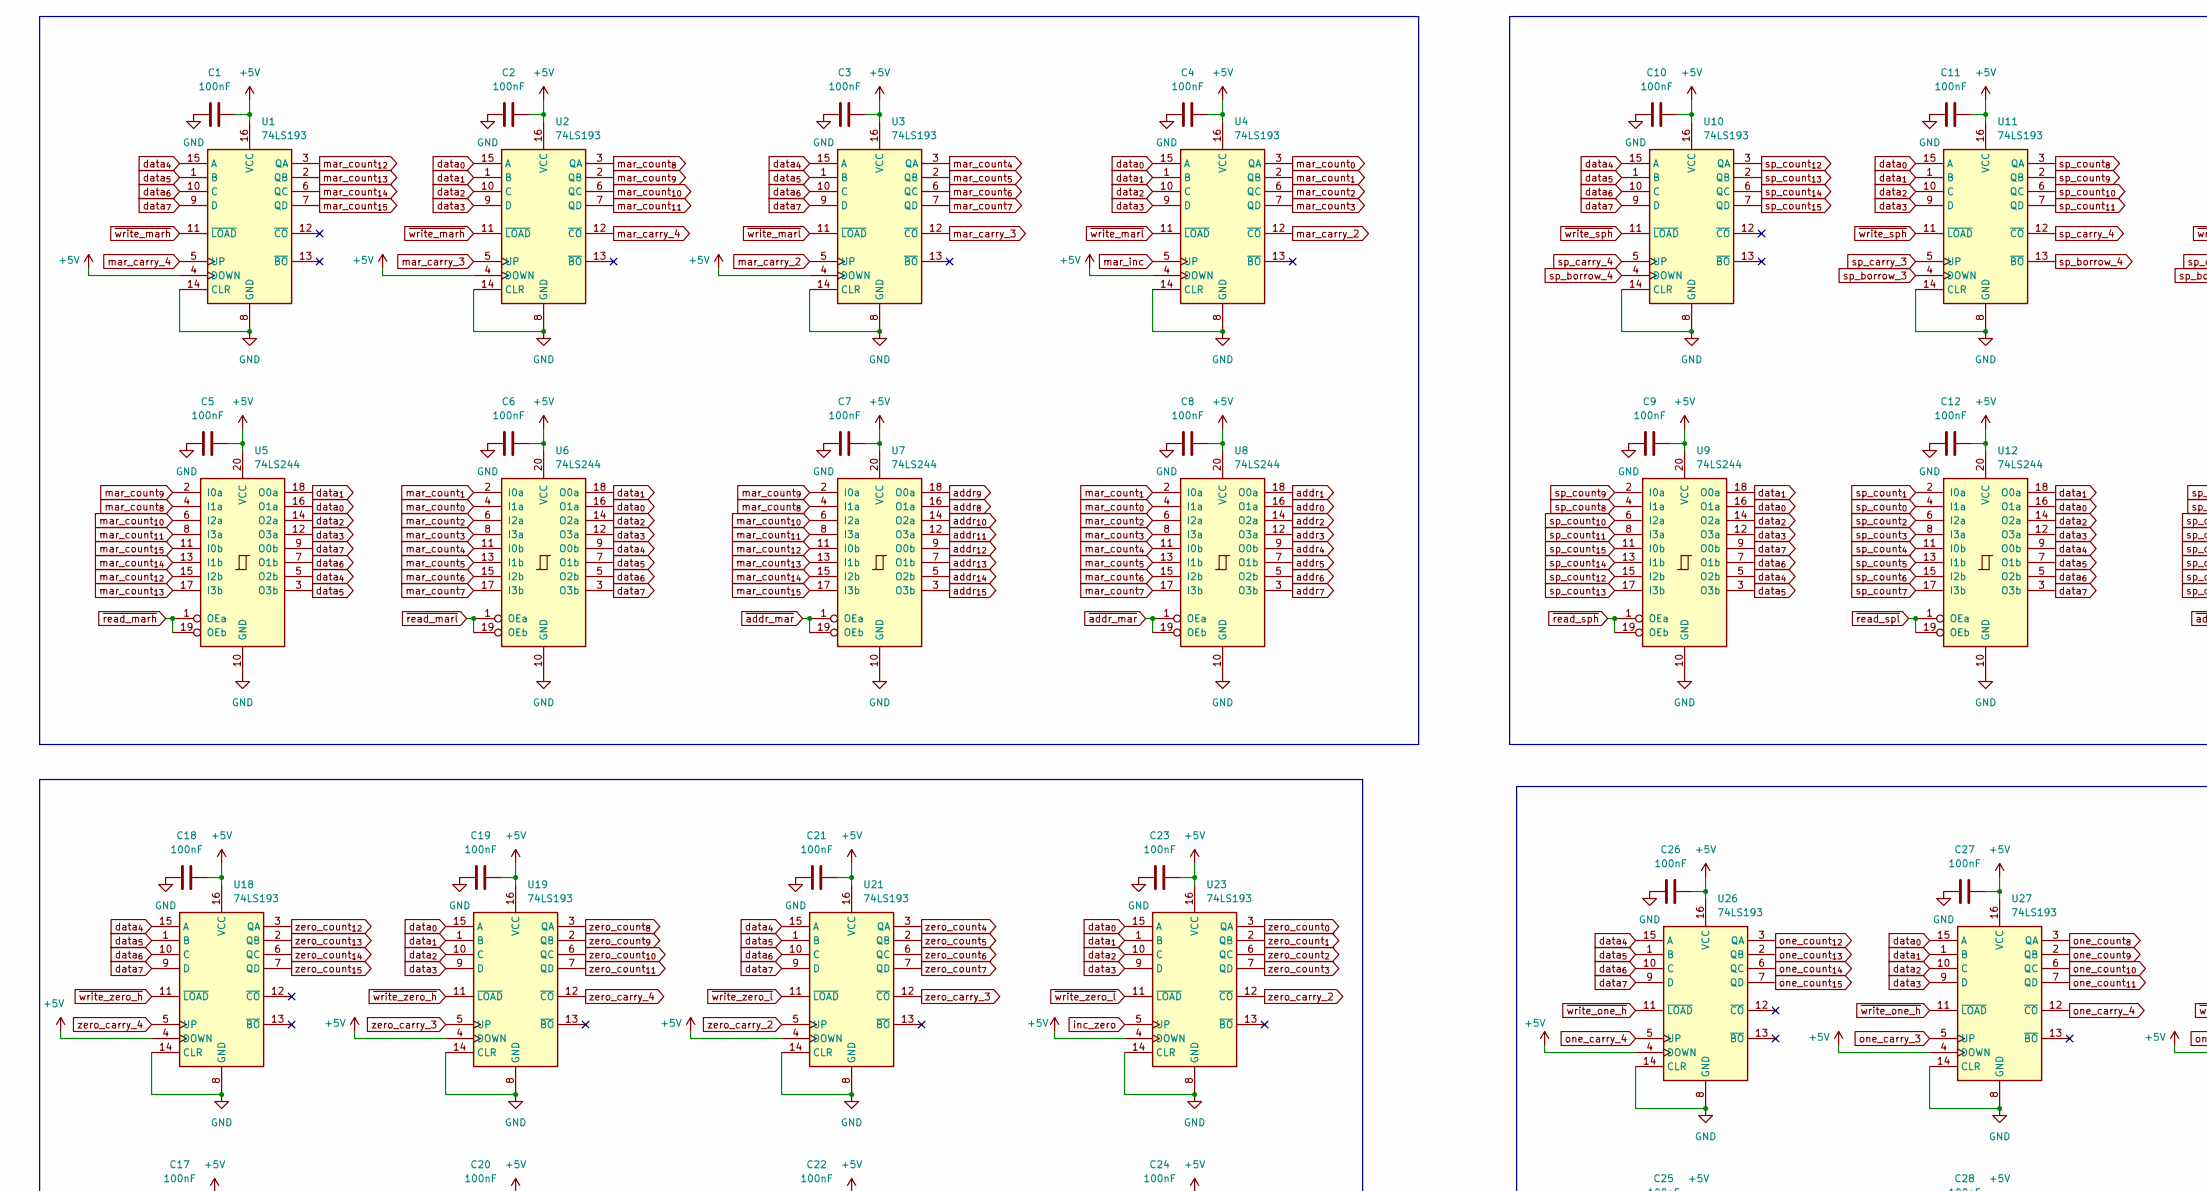
[picture p16: schematic s16rf.kicad_sch, part in row 1, column 1]

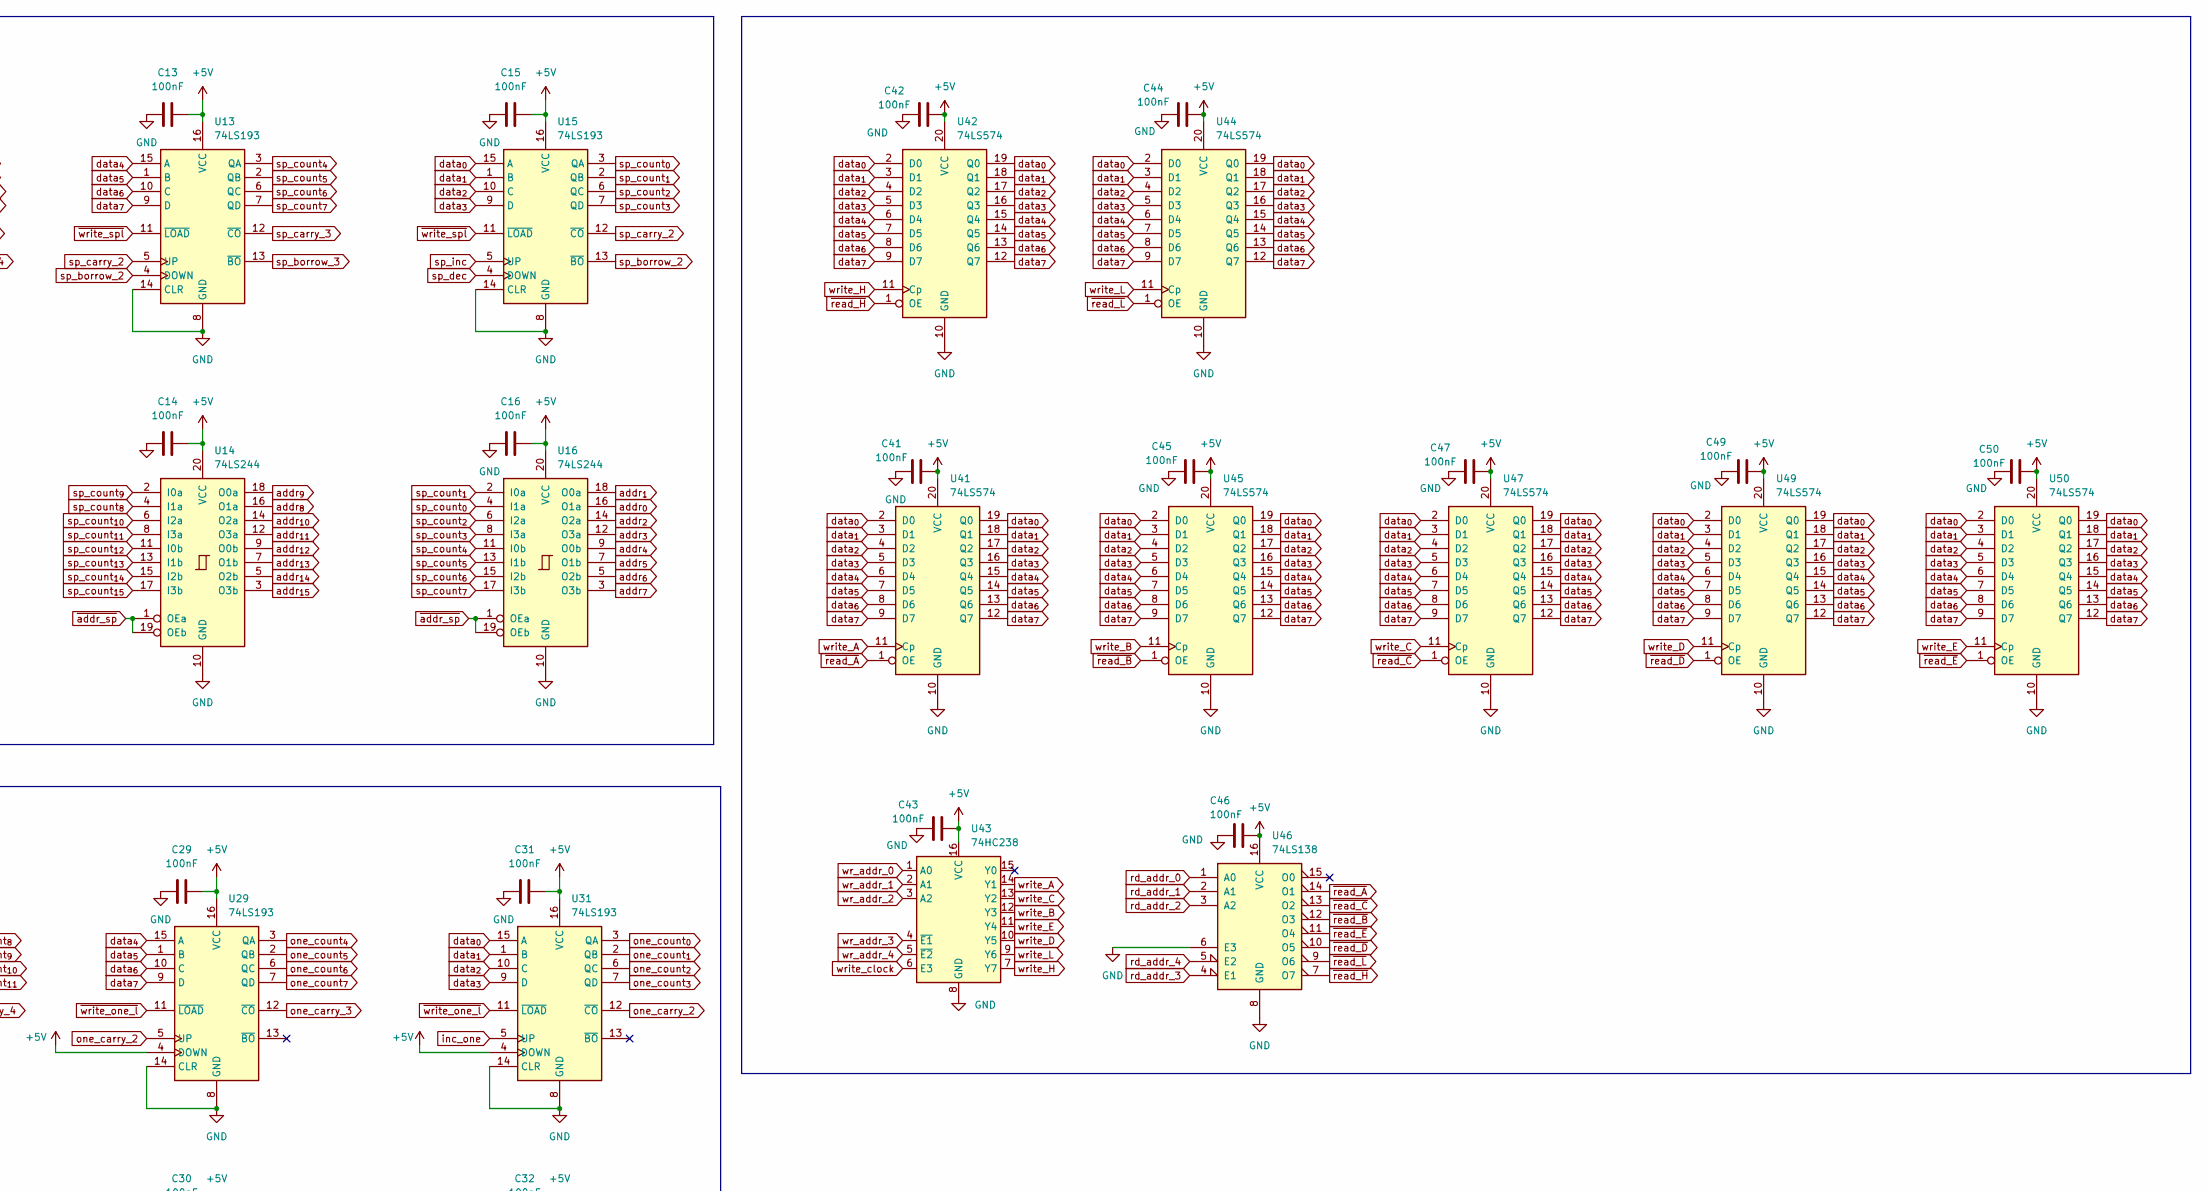
[picture p17: schematic s16rf.kicad_sch, part in row 1, column 2]

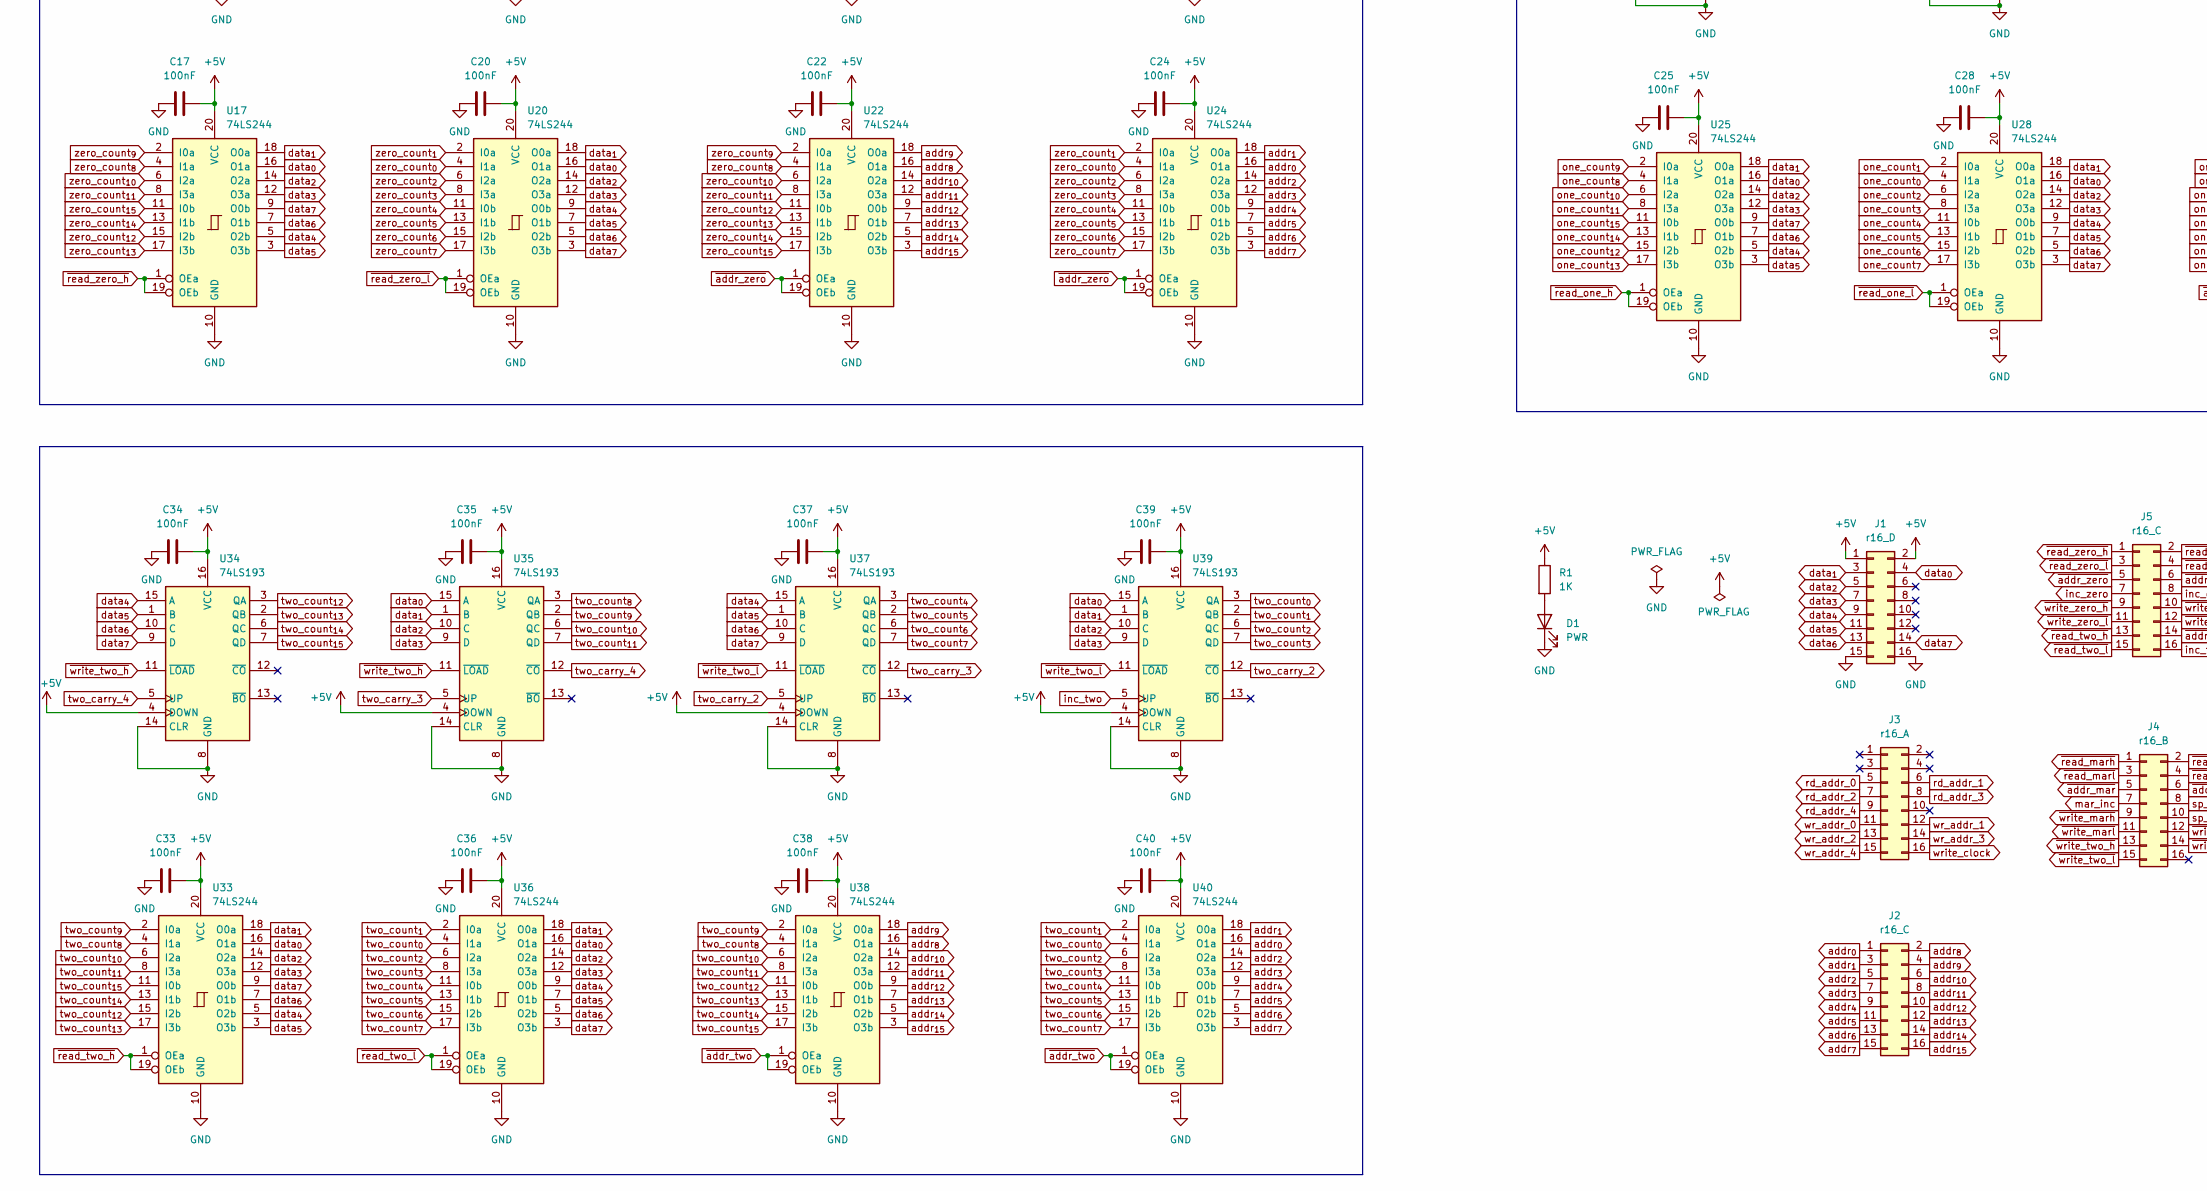
[picture p18: schematic s16rf.kicad_sch, part in row 2, column 1]

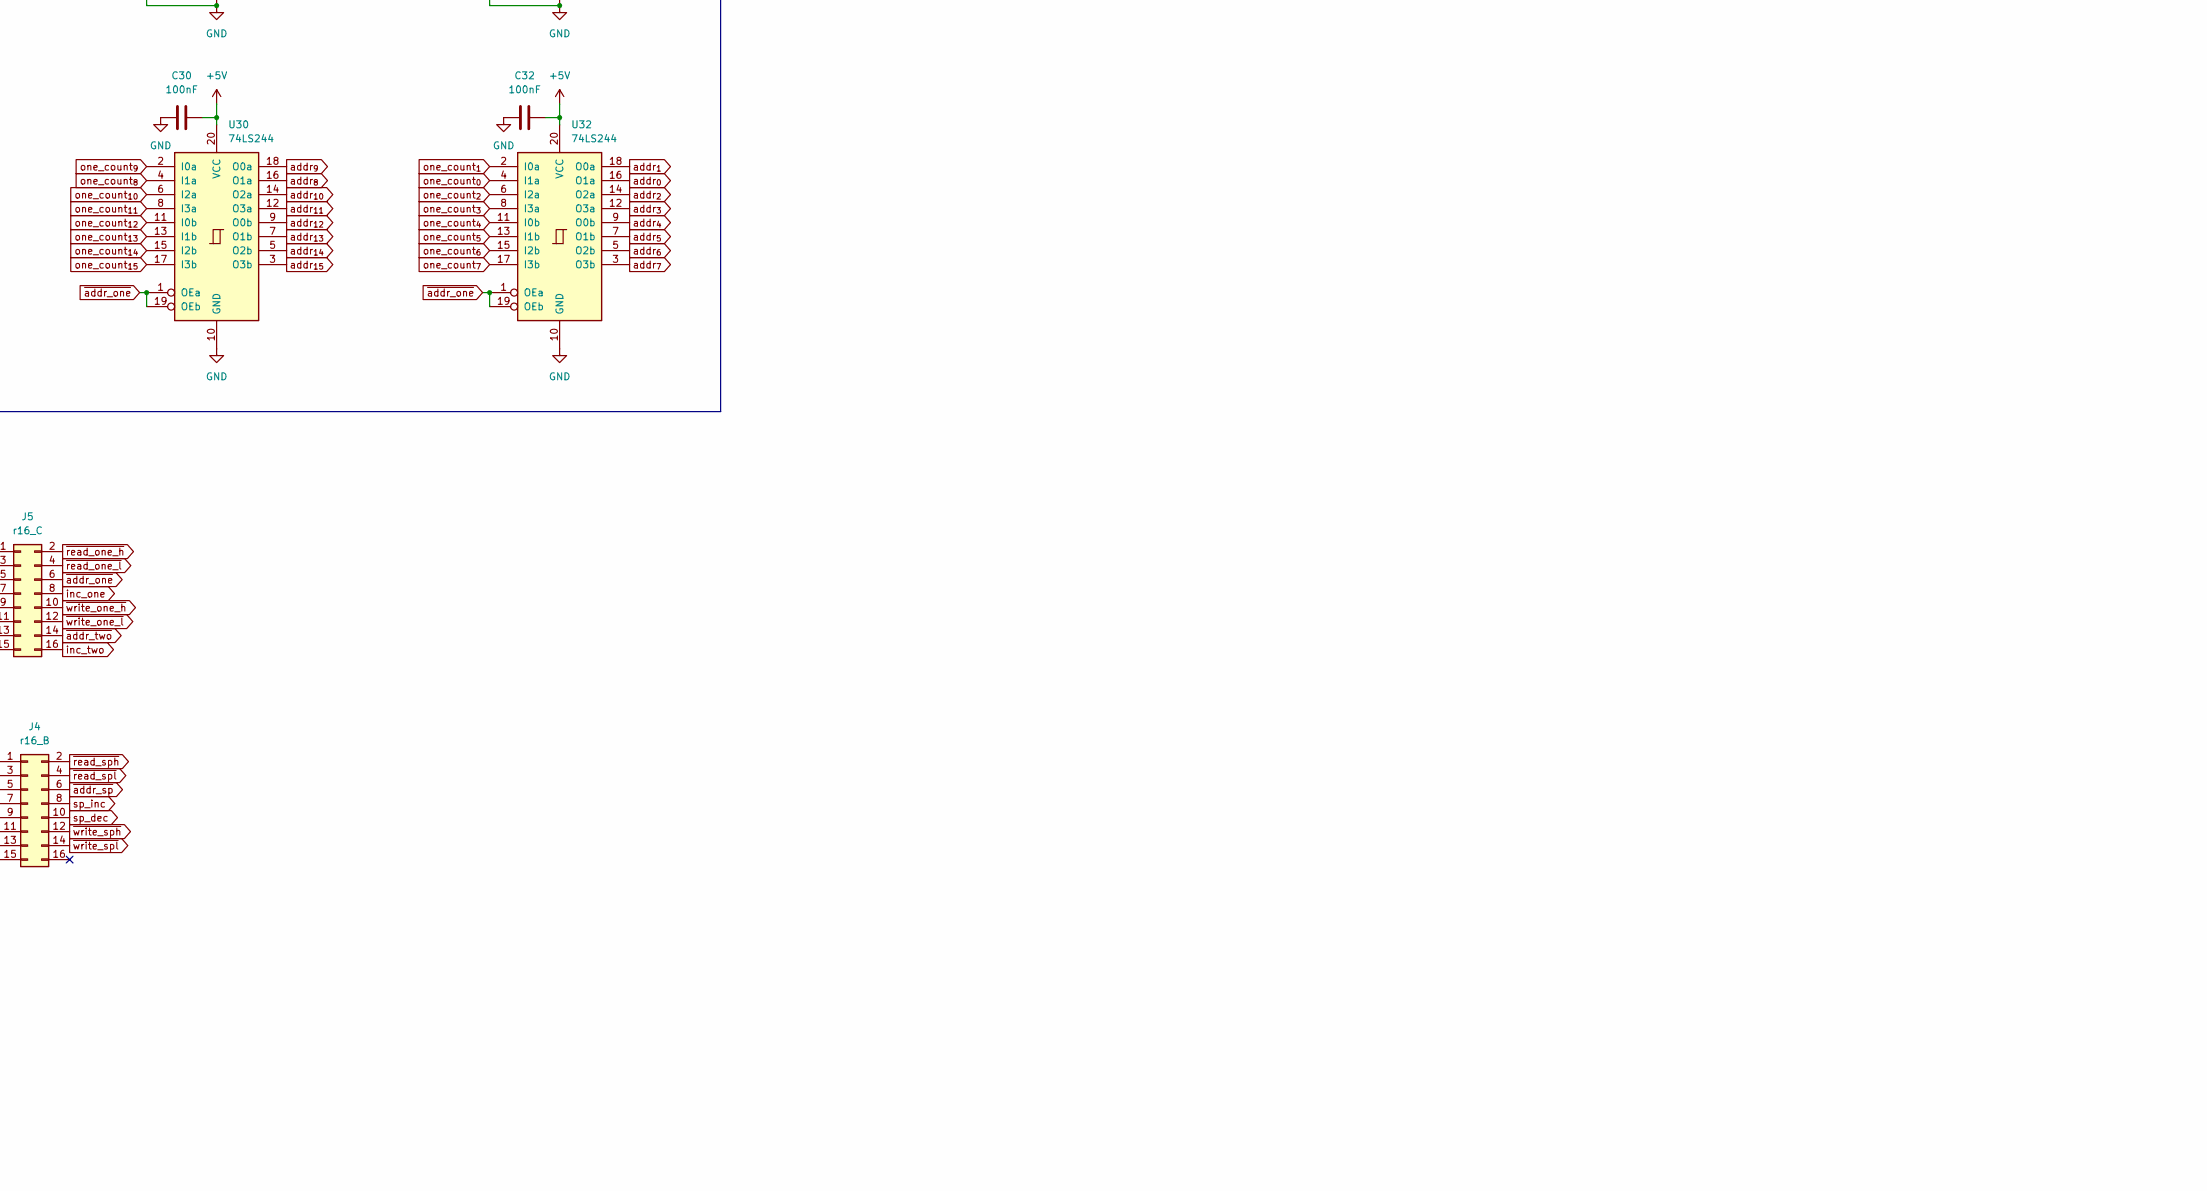
[picture p19: schematic s16rf.kicad_sch, part in row 2, column 2]

Parts:
C1, C2, C3, C4, C5, C6, C7, C8, C9, C10, C11, C12, C13, C14, C15, C16, C17, C18, C19, C20, C21, C22, C23, C24, C25, C26, C27, C28, C29, C30, C31, C32, C33, C34, C35, C36, C37, C38, C39, C40, C41, C42, C43, C44, C45, C46, C47, C49, C50: 100nF; C_Disc_D5.1mm_W3.2mm_P5.00mm
D1: PWR; LED_D5.0mm
J1: r16_D; conector 02x08
J2, J5: r16_C; conector 02x08
J3: r16_A; conector 02x08
J4: r16_B; conector 02x08
R1: 1K; R_Axial_DIN0204_L3.6mm_D1.6mm_P7.62mm_Horizontal
U1, U2, U3, U4, U10, U11, U13, U15, U18, U19, U21, U23, U26, U27, U29, U31, U34, U35, U37, U39: 74LS193; DIP-16_W7.62mm
U5, U6, U7, U8, U9, U12, U14, U16, U17, U20, U22, U24, U25, U28, U30, U32, U33, U36, U38, U40: 74LS244; DIP-20_W7.62mm
U41, U42, U44, U45, U47, U49, U50: 74LS574; DIP-20_W7.62mm
U43: 74HC238; DIP-16_W7.62mm
U46: 74LS138; DIP-16_W7.62mm

Connections:
+5V: C1.2, C2.2, C3.2, C4.2, C5.2, C6.2, C7.2, C8.2, C9.2, C10.2, C11.2, C12.2, C13.2, C14.2, C15.2, C16.2, C17.2, C18.2, C19.2, C20.2, C21.2, C22.2, C23.2, C24.2, C25.2, C26.2, C27.2, C28.2, C29.2, C30.2, C31.2, C32.2, C33.2, C34.2, C35.2, C36.2, C37.2, C38.2, C39.2, C40.2, C41.2, C42.2, C43.2, C44.2, C45.2, C46.2, C47.2, C49.2, C50.2, J1.1, J1.2, R1.1, U1.4 (DOWN), U1.16 (VCC), U2.4 (DOWN), U2.16 (VCC), U3.4 (DOWN), U3.16 (VCC), U4.4 (DOWN), U4.16 (VCC), U5.20 (VCC), U6.20 (VCC), U7.20 (VCC), U8.20 (VCC), U9.20 (VCC), U10.16 (VCC), U11.16 (VCC), U12.20 (VCC), U13.16 (VCC), U14.20 (VCC), U15.16 (VCC), U16.20 (VCC), U17.20 (VCC), U18.4 (DOWN), U18.16 (VCC), U19.4 (DOWN), U19.16 (VCC), U20.20 (VCC), U21.4 (DOWN), U21.16 (VCC), U22.20 (VCC), U23.4 (DOWN), U23.16 (VCC), U24.20 (VCC), U25.20 (VCC), U26.4 (DOWN), U26.16 (VCC), U27.4 (DOWN), U27.16 (VCC), U28.20 (VCC), U29.4 (DOWN), U29.16 (VCC), U30.20 (VCC), U31.4 (DOWN), U31.16 (VCC), U32.20 (VCC), U33.20 (VCC), U34.4 (DOWN), U34.16 (VCC), U35.4 (DOWN), U35.16 (VCC), U36.20 (VCC), U37.4 (DOWN), U37.16 (VCC), U38.20 (VCC), U39.4 (DOWN), U39.16 (VCC), U40.20 (VCC), U41.20 (VCC), U42.20 (VCC), U43.16 (VCC), U44.20 (VCC), U45.20 (VCC), U46.16 (VCC), U47.20 (VCC), U49.20 (VCC), U50.20 (VCC)
GND: C1.1, C2.1, C3.1, C4.1, C5.1, C6.1, C7.1, C8.1, C9.1, C10.1, C11.1, C12.1, C13.1, C14.1, C15.1, C16.1, C17.1, C18.1, C19.1, C20.1, C21.1, C22.1, C23.1, C24.1, C25.1, C26.1, C27.1, C28.1, C29.1, C30.1, C31.1, C32.1, C33.1, C34.1, C35.1, C36.1, C37.1, C38.1, C39.1, C40.1, C41.1, C42.1, C43.1, C44.1, C45.1, C46.1, C47.1, C49.1, C50.1, D1.1 (K), J1.15, J1.16, U1.8 (GND), U1.14 (CLR), U2.8 (GND), U2.14 (CLR), U3.8 (GND), U3.14 (CLR), U4.8 (GND), U4.14 (CLR), U5.10 (GND), U6.10 (GND), U7.10 (GND), U8.10 (GND), U9.10 (GND), U10.8 (GND), U10.14 (CLR), U11.8 (GND), U11.14 (CLR), U12.10 (GND), U13.8 (GND), U13.14 (CLR), U14.10 (GND), U15.8 (GND), U15.14 (CLR), U16.10 (GND), U17.10 (GND), U18.8 (GND), U18.14 (CLR), U19.8 (GND), U19.14 (CLR), U20.10 (GND), U21.8 (GND), U21.14 (CLR), U22.10 (GND), U23.8 (GND), U23.14 (CLR), U24.10 (GND), U25.10 (GND), U26.8 (GND), U26.14 (CLR), U27.8 (GND), U27.14 (CLR), U28.10 (GND), U29.8 (GND), U29.14 (CLR), U30.10 (GND), U31.8 (GND), U31.14 (CLR), U32.10 (GND), U33.10 (GND), U34.8 (GND), U34.14 (CLR), U35.8 (GND), U35.14 (CLR), U36.10 (GND), U37.8 (GND), U37.14 (CLR), U38.10 (GND), U39.8 (GND), U39.14 (CLR), U40.10 (GND), U41.10 (GND), U42.10 (GND), U43.8 (GND), U44.10 (GND), U45.10 (GND), U46.6 (E3), U46.8 (GND), U47.10 (GND), U49.10 (GND), U50.10 (GND)
unnamed: D1.2 (A), R1.2
addr_{0}: J2.1, U8.16 (O1a), U16.16 (O1a), U24.16 (O1a), U32.16 (O1a), U40.16 (O1a)
addr_{1}: J2.3, U8.18 (O0a), U16.18 (O0a), U24.18 (O0a), U32.18 (O0a), U40.18 (O0a)
addr_{2}: J2.5, U8.14 (O2a), U16.14 (O2a), U24.14 (O2a), U32.14 (O2a), U40.14 (O2a)
addr_{3}: J2.7, U8.12 (O3a), U16.12 (O3a), U24.12 (O3a), U32.12 (O3a), U40.12 (O3a)
addr_{4}: J2.9, U8.9 (O0b), U16.9 (O0b), U24.9 (O0b), U32.9 (O0b), U40.9 (O0b)
addr_{5}: J2.11, U8.7 (O1b), U16.7 (O1b), U24.7 (O1b), U32.7 (O1b), U40.7 (O1b)
addr_{6}: J2.13, U8.5 (O2b), U16.5 (O2b), U24.5 (O2b), U32.5 (O2b), U40.5 (O2b)
addr_{7}: J2.15, U8.3 (O3b), U16.3 (O3b), U24.3 (O3b), U32.3 (O3b), U40.3 (O3b)
addr_{8}: J2.2, U7.16 (O1a), U14.16 (O1a), U22.16 (O1a), U30.16 (O1a), U38.16 (O1a)
addr_{9}: J2.4, U7.18 (O0a), U14.18 (O0a), U22.18 (O0a), U30.18 (O0a), U38.18 (O0a)
addr_{10}: J2.6, U7.14 (O2a), U14.14 (O2a), U22.14 (O2a), U30.14 (O2a), U38.14 (O2a)
addr_{11}: J2.8, U7.12 (O3a), U14.12 (O3a), U22.12 (O3a), U30.12 (O3a), U38.12 (O3a)
addr_{12}: J2.10, U7.9 (O0b), U14.9 (O0b), U22.9 (O0b), U30.9 (O0b), U38.9 (O0b)
addr_{13}: J2.12, U7.7 (O1b), U14.7 (O1b), U22.7 (O1b), U30.7 (O1b), U38.7 (O1b)
addr_{14}: J2.14, U7.5 (O2b), U14.5 (O2b), U22.5 (O2b), U30.5 (O2b), U38.5 (O2b)
addr_{15}: J2.16, U7.3 (O3b), U14.3 (O3b), U22.3 (O3b), U30.3 (O3b), U38.3 (O3b)
data_{0}: J1.4, U2.15 (A), U4.15 (A), U5.16 (O1a), U6.16 (O1a), U9.16 (O1a), U11.15 (A), U12.16 (O1a), U15.15 (A), U17.16 (O1a), U19.15 (A), U20.16 (O1a), U23.15 (A), U25.16 (O1a), U27.15 (A), U28.16 (O1a), U31.15 (A), U33.16 (O1a), U35.15 (A), U36.16 (O1a), U39.15 (A), U41.2 (D0), U41.19 (Q0), U42.2 (D0), U42.19 (Q0), U44.2 (D0), U44.19 (Q0), U45.2 (D0), U45.19 (Q0), U47.2 (D0), U47.19 (Q0), U49.2 (D0), U49.19 (Q0), U50.2 (D0), U50.19 (Q0)
data_{1}: J1.3, U2.1 (B), U4.1 (B), U5.18 (O0a), U6.18 (O0a), U9.18 (O0a), U11.1 (B), U12.18 (O0a), U15.1 (B), U17.18 (O0a), U19.1 (B), U20.18 (O0a), U23.1 (B), U25.18 (O0a), U27.1 (B), U28.18 (O0a), U31.1 (B), U33.18 (O0a), U35.1 (B), U36.18 (O0a), U39.1 (B), U41.3 (D1), U41.18 (Q1), U42.3 (D1), U42.18 (Q1), U44.3 (D1), U44.18 (Q1), U45.3 (D1), U45.18 (Q1), U47.3 (D1), U47.18 (Q1), U49.3 (D1), U49.18 (Q1), U50.3 (D1), U50.18 (Q1)
data_{2}: J1.5, U2.10 (C), U4.10 (C), U5.14 (O2a), U6.14 (O2a), U9.14 (O2a), U11.10 (C), U12.14 (O2a), U15.10 (C), U17.14 (O2a), U19.10 (C), U20.14 (O2a), U23.10 (C), U25.14 (O2a), U27.10 (C), U28.14 (O2a), U31.10 (C), U33.14 (O2a), U35.10 (C), U36.14 (O2a), U39.10 (C), U41.4 (D2), U41.17 (Q2), U42.4 (D2), U42.17 (Q2), U44.4 (D2), U44.17 (Q2), U45.4 (D2), U45.17 (Q2), U47.4 (D2), U47.17 (Q2), U49.4 (D2), U49.17 (Q2), U50.4 (D2), U50.17 (Q2)
data_{3}: J1.7, U2.9 (D), U4.9 (D), U5.12 (O3a), U6.12 (O3a), U9.12 (O3a), U11.9 (D), U12.12 (O3a), U15.9 (D), U17.12 (O3a), U19.9 (D), U20.12 (O3a), U23.9 (D), U25.12 (O3a), U27.9 (D), U28.12 (O3a), U31.9 (D), U33.12 (O3a), U35.9 (D), U36.12 (O3a), U39.9 (D), U41.5 (D3), U41.16 (Q3), U42.5 (D3), U42.16 (Q3), U44.5 (D3), U44.16 (Q3), U45.5 (D3), U45.16 (Q3), U47.5 (D3), U47.16 (Q3), U49.5 (D3), U49.16 (Q3), U50.5 (D3), U50.16 (Q3)
data_{4}: J1.9, U1.15 (A), U3.15 (A), U5.5 (O2b), U6.9 (O0b), U9.5 (O2b), U10.15 (A), U12.9 (O0b), U13.15 (A), U17.5 (O2b), U18.15 (A), U20.9 (O0b), U21.15 (A), U25.5 (O2b), U26.15 (A), U28.9 (O0b), U29.15 (A), U33.5 (O2b), U34.15 (A), U36.9 (O0b), U37.15 (A), U41.6 (D4), U41.15 (Q4), U42.6 (D4), U42.15 (Q4), U44.6 (D4), U44.15 (Q4), U45.6 (D4), U45.15 (Q4), U47.6 (D4), U47.15 (Q4), U49.6 (D4), U49.15 (Q4), U50.6 (D4), U50.15 (Q4)
data_{5}: J1.11, U1.1 (B), U3.1 (B), U5.3 (O3b), U6.7 (O1b), U9.3 (O3b), U10.1 (B), U12.7 (O1b), U13.1 (B), U17.3 (O3b), U18.1 (B), U20.7 (O1b), U21.1 (B), U25.3 (O3b), U26.1 (B), U28.7 (O1b), U29.1 (B), U33.3 (O3b), U34.1 (B), U36.7 (O1b), U37.1 (B), U41.7 (D5), U41.14 (Q5), U42.7 (D5), U42.14 (Q5), U44.7 (D5), U44.14 (Q5), U45.7 (D5), U45.14 (Q5), U47.7 (D5), U47.14 (Q5), U49.7 (D5), U49.14 (Q5), U50.7 (D5), U50.14 (Q5)
data_{6}: J1.13, U1.10 (C), U3.10 (C), U5.7 (O1b), U6.5 (O2b), U9.7 (O1b), U10.10 (C), U12.5 (O2b), U13.10 (C), U17.7 (O1b), U18.10 (C), U20.5 (O2b), U21.10 (C), U25.7 (O1b), U26.10 (C), U28.5 (O2b), U29.10 (C), U33.7 (O1b), U34.10 (C), U36.5 (O2b), U37.10 (C), U41.8 (D6), U41.13 (Q6), U42.8 (D6), U42.13 (Q6), U44.8 (D6), U44.13 (Q6), U45.8 (D6), U45.13 (Q6), U47.8 (D6), U47.13 (Q6), U49.8 (D6), U49.13 (Q6), U50.8 (D6), U50.13 (Q6)
data_{7}: J1.14, U1.9 (D), U3.9 (D), U5.9 (O0b), U6.3 (O3b), U9.9 (O0b), U10.9 (D), U12.3 (O3b), U13.9 (D), U17.9 (O0b), U18.9 (D), U20.3 (O3b), U21.9 (D), U25.9 (O0b), U26.9 (D), U28.3 (O3b), U29.9 (D), U33.9 (O0b), U34.9 (D), U36.3 (O3b), U37.9 (D), U41.9 (D7), U41.12 (Q7), U42.9 (D7), U42.12 (Q7), U44.9 (D7), U44.12 (Q7), U45.9 (D7), U45.12 (Q7), U47.9 (D7), U47.12 (Q7), U49.9 (D7), U49.12 (Q7), U50.9 (D7), U50.12 (Q7)
inc_one: J5.8, U31.5 (UP)
inc_two: J5.16, U39.5 (UP)
inc_zero: J5.7, U23.5 (UP)
mar_carry_2: U3.5 (UP), U4.12 (~CO)
mar_carry_3: U2.5 (UP), U3.12 (~CO)
mar_carry_4: U1.5 (UP), U2.12 (~CO)
mar_count_{0}: U4.3 (QA), U6.4 (I1a), U8.4 (I1a)
mar_count_{1}: U4.2 (QB), U6.2 (I0a), U8.2 (I0a)
mar_count_{2}: U4.6 (QC), U6.6 (I2a), U8.6 (I2a)
mar_count_{3}: U4.7 (QD), U6.8 (I3a), U8.8 (I3a)
mar_count_{4}: U3.3 (QA), U6.11 (I0b), U8.11 (I0b)
mar_count_{5}: U3.2 (QB), U6.13 (I1b), U8.13 (I1b)
mar_count_{6}: U3.6 (QC), U6.15 (I2b), U8.15 (I2b)
mar_count_{7}: U3.7 (QD), U6.17 (I3b), U8.17 (I3b)
mar_count_{8}: U2.3 (QA), U5.4 (I1a), U7.4 (I1a)
mar_count_{9}: U2.2 (QB), U5.2 (I0a), U7.2 (I0a)
mar_count_{10}: U2.6 (QC), U5.6 (I2a), U7.6 (I2a)
mar_count_{11}: U2.7 (QD), U5.8 (I3a), U7.8 (I3a)
mar_count_{12}: U1.3 (QA), U5.15 (I2b), U7.11 (I0b)
mar_count_{13}: U1.2 (QB), U5.17 (I3b), U7.13 (I1b)
mar_count_{14}: U1.6 (QC), U5.13 (I1b), U7.15 (I2b)
mar_count_{15}: U1.7 (QD), U5.11 (I0b), U7.17 (I3b)
mar_inc: J4.7, U4.5 (UP)
one_carry_2: U29.5 (UP), U31.12 (~CO)
one_carry_3: U27.5 (UP), U29.12 (~CO)
one_carry_4: U26.5 (UP), U27.12 (~CO)
one_count_{0}: U28.4 (I1a), U31.3 (QA), U32.4 (I1a)
one_count_{1}: U28.2 (I0a), U31.2 (QB), U32.2 (I0a)
one_count_{2}: U28.6 (I2a), U31.6 (QC), U32.6 (I2a)
one_count_{3}: U28.8 (I3a), U31.7 (QD), U32.8 (I3a)
one_count_{4}: U28.11 (I0b), U29.3 (QA), U32.11 (I0b)
one_count_{5}: U28.13 (I1b), U29.2 (QB), U32.13 (I1b)
one_count_{6}: U28.15 (I2b), U29.6 (QC), U32.15 (I2b)
one_count_{7}: U28.17 (I3b), U29.7 (QD), U32.17 (I3b)
one_count_{8}: U25.4 (I1a), U27.3 (QA), U30.4 (I1a)
one_count_{9}: U25.2 (I0a), U27.2 (QB), U30.2 (I0a)
one_count_{10}: U25.6 (I2a), U27.6 (QC), U30.6 (I2a)
one_count_{11}: U25.8 (I3a), U27.7 (QD), U30.8 (I3a)
one_count_{12}: U25.15 (I2b), U26.3 (QA), U30.11 (I0b)
one_count_{13}: U25.17 (I3b), U26.2 (QB), U30.13 (I1b)
one_count_{14}: U25.13 (I1b), U26.6 (QC), U30.15 (I2b)
one_count_{15}: U25.11 (I0b), U26.7 (QD), U30.17 (I3b)
rd_addr_0: J3.5, U46.1 (A0)
rd_addr_1: J3.6, U46.2 (A1)
rd_addr_2: J3.7, U46.3 (A2)
rd_addr_3: J3.8, U46.4 (E1)
rd_addr_4: J3.9, U46.5 (E2)
sp_borrow_2: U13.4 (DOWN), U15.13 (~BO)
sp_borrow_3: U11.4 (DOWN), U13.13 (~BO)
sp_borrow_4: U10.4 (DOWN), U11.13 (~BO)
sp_carry_2: U13.5 (UP), U15.12 (~CO)
sp_carry_3: U11.5 (UP), U13.12 (~CO)
sp_carry_4: U10.5 (UP), U11.12 (~CO)
sp_count_{0}: U12.4 (I1a), U15.3 (QA), U16.4 (I1a)
sp_count_{1}: U12.2 (I0a), U15.2 (QB), U16.2 (I0a)
sp_count_{2}: U12.6 (I2a), U15.6 (QC), U16.6 (I2a)
sp_count_{3}: U12.8 (I3a), U15.7 (QD), U16.8 (I3a)
sp_count_{4}: U12.11 (I0b), U13.3 (QA), U16.11 (I0b)
sp_count_{5}: U12.13 (I1b), U13.2 (QB), U16.13 (I1b)
sp_count_{6}: U12.15 (I2b), U13.6 (QC), U16.15 (I2b)
sp_count_{7}: U12.17 (I3b), U13.7 (QD), U16.17 (I3b)
sp_count_{8}: U9.4 (I1a), U11.3 (QA), U14.4 (I1a)
sp_count_{9}: U9.2 (I0a), U11.2 (QB), U14.2 (I0a)
sp_count_{10}: U9.6 (I2a), U11.6 (QC), U14.6 (I2a)
sp_count_{11}: U9.8 (I3a), U11.7 (QD), U14.8 (I3a)
sp_count_{12}: U9.15 (I2b), U10.3 (QA), U14.11 (I0b)
sp_count_{13}: U9.17 (I3b), U10.2 (QB), U14.13 (I1b)
sp_count_{14}: U9.13 (I1b), U10.6 (QC), U14.15 (I2b)
sp_count_{15}: U9.11 (I0b), U10.7 (QD), U14.17 (I3b)
sp_dec: J4.10, U15.4 (DOWN)
sp_inc: J4.8, U15.5 (UP)
two_carry_2: U37.5 (UP), U39.12 (~CO)
two_carry_3: U35.5 (UP), U37.12 (~CO)
two_carry_4: U34.5 (UP), U35.12 (~CO)
two_count_{0}: U36.4 (I1a), U39.3 (QA), U40.4 (I1a)
two_count_{1}: U36.2 (I0a), U39.2 (QB), U40.2 (I0a)
two_count_{2}: U36.6 (I2a), U39.6 (QC), U40.6 (I2a)
two_count_{3}: U36.8 (I3a), U39.7 (QD), U40.8 (I3a)
two_count_{4}: U36.11 (I0b), U37.3 (QA), U40.11 (I0b)
two_count_{5}: U36.13 (I1b), U37.2 (QB), U40.13 (I1b)
two_count_{6}: U36.15 (I2b), U37.6 (QC), U40.15 (I2b)
two_count_{7}: U36.17 (I3b), U37.7 (QD), U40.17 (I3b)
two_count_{8}: U33.4 (I1a), U35.3 (QA), U38.4 (I1a)
two_count_{9}: U33.2 (I0a), U35.2 (QB), U38.2 (I0a)
two_count_{10}: U33.6 (I2a), U35.6 (QC), U38.6 (I2a)
two_count_{11}: U33.8 (I3a), U35.7 (QD), U38.8 (I3a)
two_count_{12}: U33.15 (I2b), U34.3 (QA), U38.11 (I0b)
two_count_{13}: U33.17 (I3b), U34.2 (QB), U38.13 (I1b)
two_count_{14}: U33.13 (I1b), U34.6 (QC), U38.15 (I2b)
two_count_{15}: U33.11 (I0b), U34.7 (QD), U38.17 (I3b)
wr_addr_0: J3.11, U43.1 (A0)
wr_addr_1: J3.12, U43.2 (A1)
wr_addr_2: J3.13, U43.3 (A2)
wr_addr_3: J3.14, U43.4 (~E1)
wr_addr_4: J3.15, U43.5 (~E2)
write_A: U41.11 (Cp), U43.14 (Y1)
write_B: U43.12 (Y3), U45.11 (Cp)
write_C: U43.13 (Y2), U47.11 (Cp)
write_D: U43.10 (Y5), U49.11 (Cp)
write_E: U43.11 (Y4), U50.11 (Cp)
write_H: U42.11 (Cp), U43.7 (Y7)
write_L: U43.9 (Y6), U44.11 (Cp)
write_clock: J3.16, U43.6 (E3)
zero_carry_2: U21.5 (UP), U23.12 (~CO)
zero_carry_3: U19.5 (UP), U21.12 (~CO)
zero_carry_4: U18.5 (UP), U19.12 (~CO)
zero_count_{0}: U20.4 (I1a), U23.3 (QA), U24.4 (I1a)
zero_count_{1}: U20.2 (I0a), U23.2 (QB), U24.2 (I0a)
zero_count_{2}: U20.6 (I2a), U23.6 (QC), U24.6 (I2a)
zero_count_{3}: U20.8 (I3a), U23.7 (QD), U24.8 (I3a)
zero_count_{4}: U20.11 (I0b), U21.3 (QA), U24.11 (I0b)
zero_count_{5}: U20.13 (I1b), U21.2 (QB), U24.13 (I1b)
zero_count_{6}: U20.15 (I2b), U21.6 (QC), U24.15 (I2b)
zero_count_{7}: U20.17 (I3b), U21.7 (QD), U24.17 (I3b)
zero_count_{8}: U17.4 (I1a), U19.3 (QA), U22.4 (I1a)
zero_count_{9}: U17.2 (I0a), U19.2 (QB), U22.2 (I0a)
zero_count_{10}: U17.6 (I2a), U19.6 (QC), U22.6 (I2a)
zero_count_{11}: U17.8 (I3a), U19.7 (QD), U22.8 (I3a)
zero_count_{12}: U17.15 (I2b), U18.3 (QA), U22.11 (I0b)
zero_count_{13}: U17.17 (I3b), U18.2 (QB), U22.13 (I1b)
zero_count_{14}: U17.13 (I1b), U18.6 (QC), U22.15 (I2b)
zero_count_{15}: U17.11 (I0b), U18.7 (QD), U22.17 (I3b)
~addr_mar: J4.5, U7.1 (OEa), U7.19 (OEb), U8.1 (OEa), U8.19 (OEb)
~addr_one: J5.6, U30.1 (OEa), U30.19 (OEb), U32.1 (OEa), U32.19 (OEb)
~addr_sp: J4.6, U14.1 (OEa), U14.19 (OEb), U16.1 (OEa), U16.19 (OEb)
~addr_two: J5.14, U38.1 (OEa), U38.19 (OEb), U40.1 (OEa), U40.19 (OEb)
~addr_zero: J5.5, U22.1 (OEa), U22.19 (OEb), U24.1 (OEa), U24.19 (OEb)
~read_A: U41.1 (OE), U46.14 (O1)
~read_B: U45.1 (OE), U46.12 (O3)
~read_C: U46.13 (O2), U47.1 (OE)
~read_D: U46.10 (O5), U49.1 (OE)
~read_E: U46.11 (O4), U50.1 (OE)
~read_H: U42.1 (OE), U46.7 (O7)
~read_L: U44.1 (OE), U46.9 (O6)
~read_marh: J4.1, U5.1 (OEa), U5.19 (OEb)
~read_marl: J4.3, U6.1 (OEa), U6.19 (OEb)
~read_one_h: J5.2, U25.1 (OEa), U25.19 (OEb)
~read_one_l: J5.4, U28.1 (OEa), U28.19 (OEb)
~read_sph: J4.2, U9.1 (OEa), U9.19 (OEb)
~read_spl: J4.4, U12.1 (OEa), U12.19 (OEb)
~read_two_h: J5.13, U33.1 (OEa), U33.19 (OEb)
~read_two_l: J5.15, U36.1 (OEa), U36.19 (OEb)
~read_zero_h: J5.1, U17.1 (OEa), U17.19 (OEb)
~read_zero_l: J5.3, U20.1 (OEa), U20.19 (OEb)
~write_marh: J4.9, U1.11 (~LOAD), U2.11 (~LOAD)
~write_marl: J4.11, U3.11 (~LOAD), U4.11 (~LOAD)
~write_one_h: J5.10, U26.11 (~LOAD), U27.11 (~LOAD)
~write_one_l: J5.12, U29.11 (~LOAD), U31.11 (~LOAD)
~write_sph: J4.12, U10.11 (~LOAD), U11.11 (~LOAD)
~write_spl: J4.14, U13.11 (~LOAD), U15.11 (~LOAD)
~write_two_h: J4.13, U34.11 (~LOAD), U35.11 (~LOAD)
~write_two_l: J4.15, U37.11 (~LOAD), U39.11 (~LOAD)
~write_zero_h: J5.9, U18.11 (~LOAD), U19.11 (~LOAD)
~write_zero_l: J5.11, U21.11 (~LOAD), U23.11 (~LOAD)

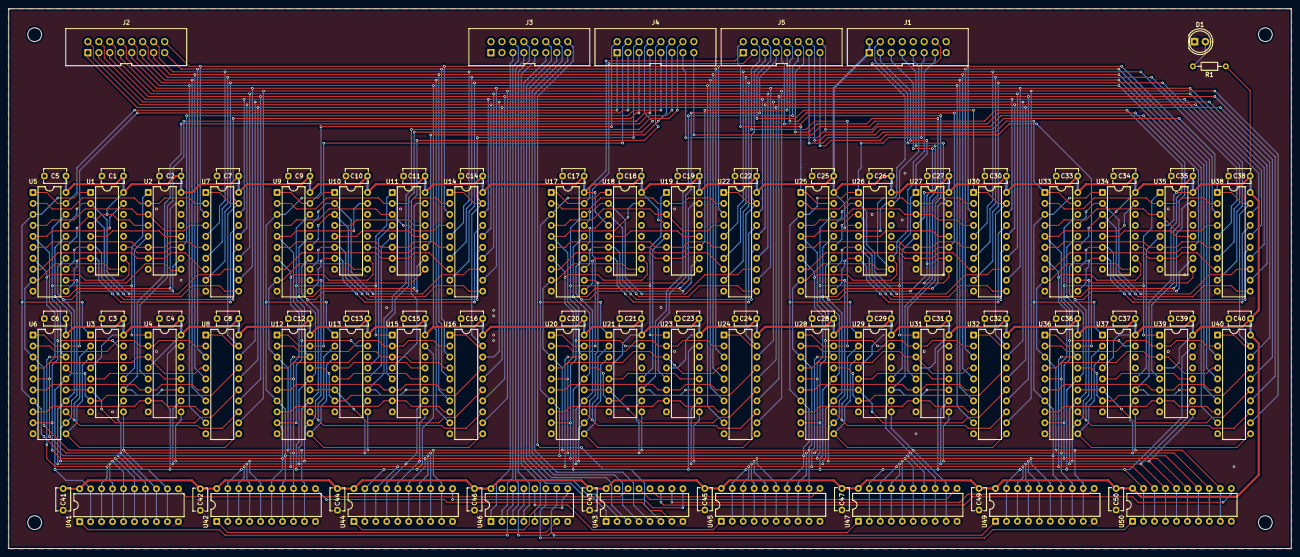
[picture p20: board s16rf.kicad_pcb from above]

Board: 2 copper layers, 297.0 x 125.0 mm, 105 parts (0 on the bottom side), 181 nets.
