rcapaverde/cubo/pcb_v3/m16rf/m16rf.kicad_pcb

## KiCad design pcb_v3/m16rf/m16rf.kicad_pcb (2026-06-19)

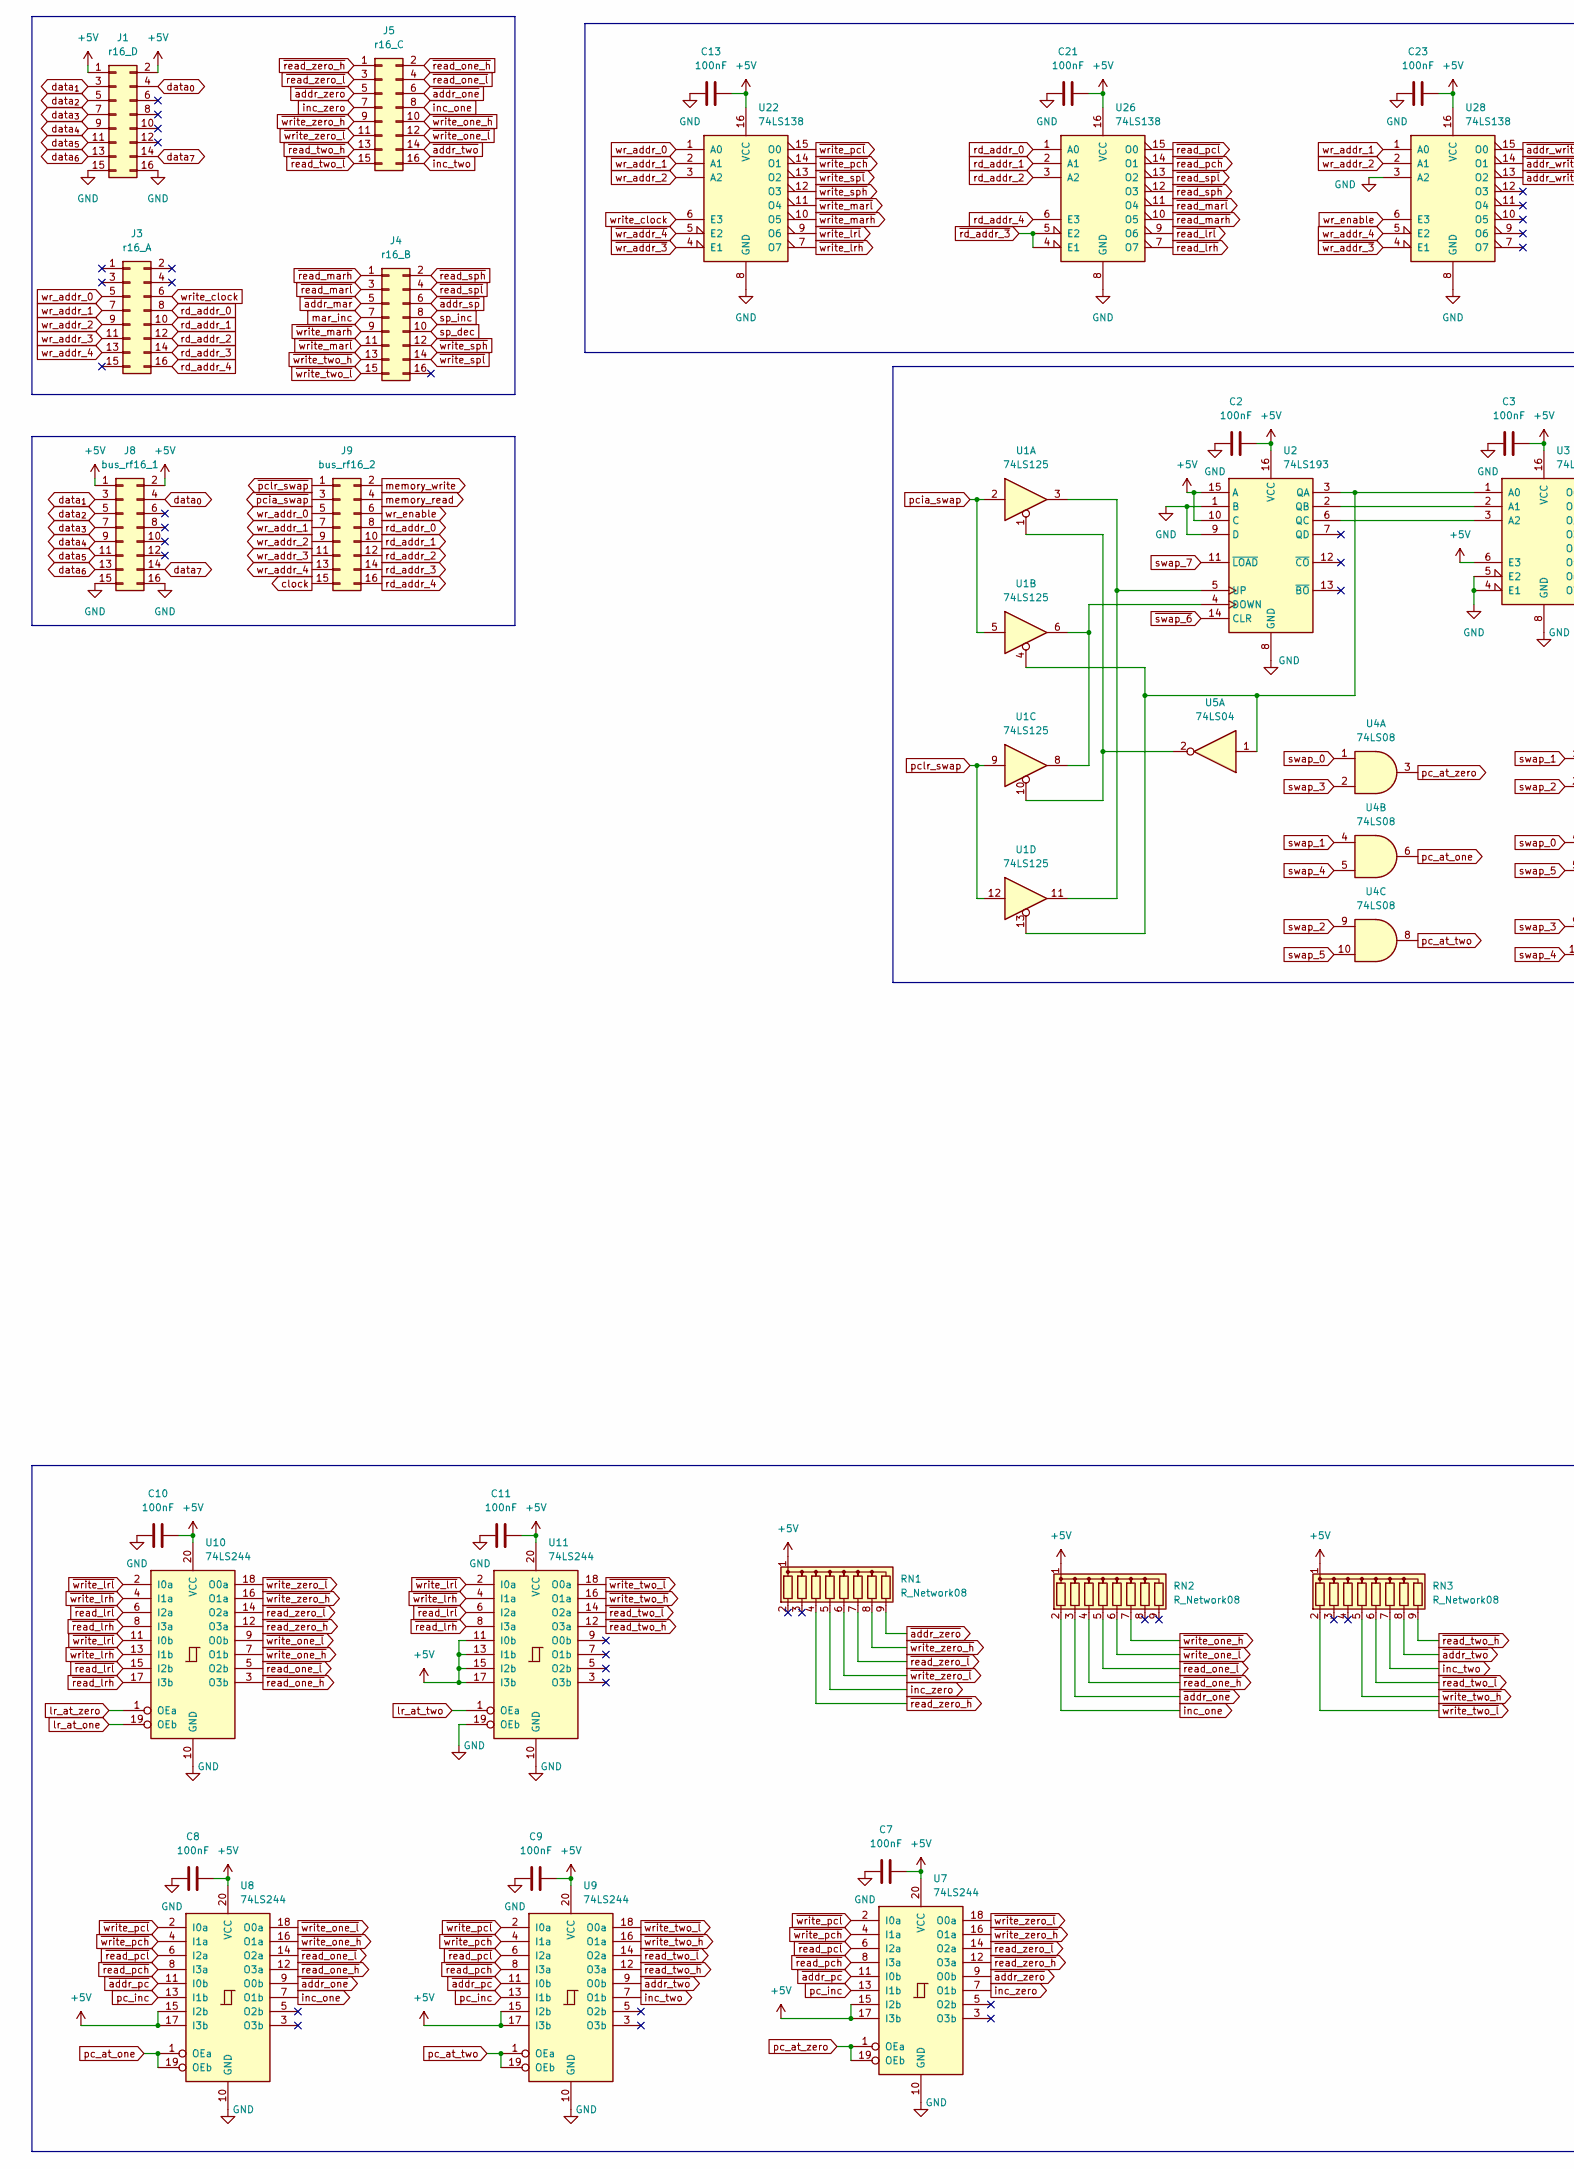
[picture p21: schematic m16rf.kicad_sch, part in row 1, column 1]

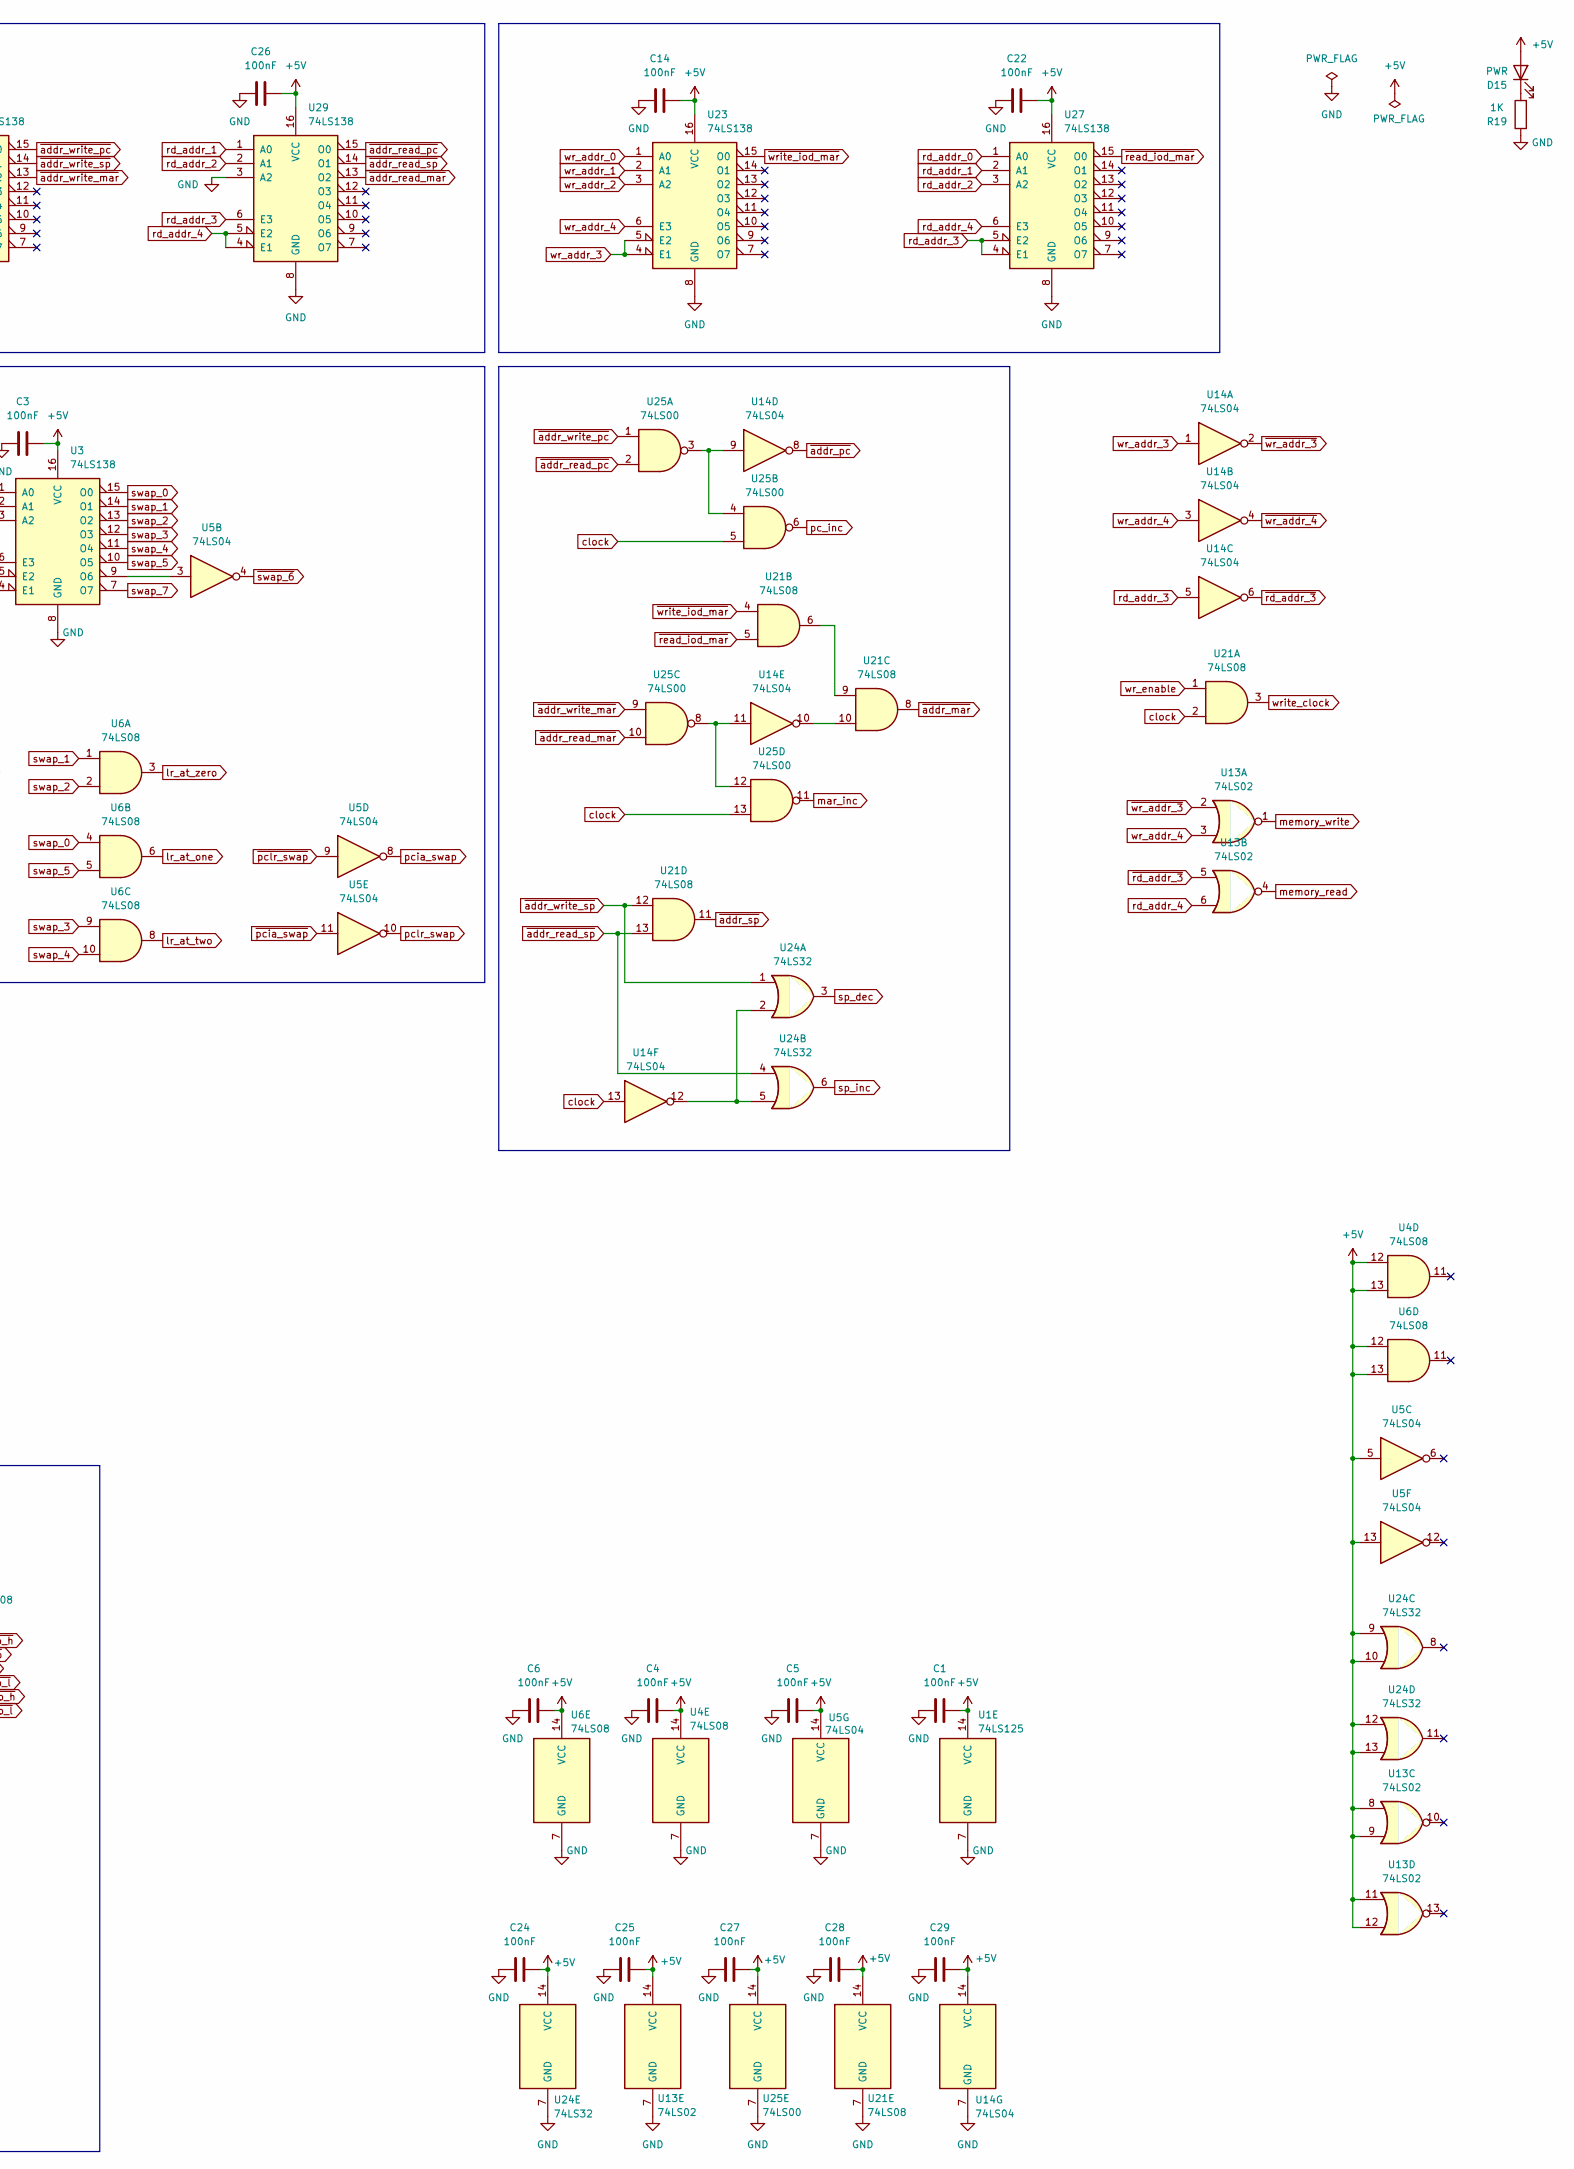
[picture p22: schematic m16rf.kicad_sch, part in row 1, column 2]

Parts:
C1, C2, C3, C4, C5, C6, C7, C8, C9, C10, C11, C13, C14, C21, C22, C23, C24, C25, C26, C27, C28, C29: 100nF; C_Disc_D5.1mm_W3.2mm_P5.00mm
D15: PWR; LED_D5.0mm
J1: r16_D; conector 02x08
J3: r16_A; conector 02x08
J4: r16_B; conector 02x08
J5: r16_C; conector 02x08
J8: bus_rf16_1; conector 02x08
J9: bus_rf16_2; conector 02x08
R19: 1K; R_Axial_DIN0207_L6.3mm_D2.5mm_P7.62mm_Horizontal
RN1, RN2, RN3: R_Network08; R_Array_SIP9
U1: 74LS125; DIP-14_W7.62mm
U2: 74LS193; DIP-16_W7.62mm
U3, U22, U23, U26, U27, U28, U29: 74LS138; DIP-16_W7.62mm
U4, U6, U21: 74LS08; DIP-14_W7.62mm
U5, U14: 74LS04; DIP-14_W7.62mm
U7, U8, U9, U10, U11: 74LS244; DIP-20_W7.62mm
U13: 74LS02; DIP-14_W7.62mm
U24: 74LS32; DIP-14_W7.62mm
U25: 74LS00; DIP-14_W7.62mm

Connections:
+5V: C1.2, C2.2, C3.2, C4.2, C5.2, C6.2, C7.2, C8.2, C9.2, C10.2, C11.2, C13.2, C14.2, C21.2, C22.2, C23.2, C24.2, C25.2, C26.2, C27.2, C28.2, C29.2, D15.2 (A), J1.1, J1.2, J8.1, J8.2, RN1.1 (common), RN2.1 (common), RN3.1 (common), U1.14 (VCC), U2.10 (C), U2.15 (A), U2.16 (VCC), U3.6 (E3), U3.16 (VCC), U4.12, U4.13, U4.14 (VCC), U5.5, U5.13, U5.14 (VCC), U6.12, U6.13, U6.14 (VCC), U7.15 (I2b), U7.17 (I3b), U7.20 (VCC), U8.15 (I2b), U8.17 (I3b), U8.20 (VCC), U9.15 (I2b), U9.17 (I3b), U9.20 (VCC), U10.20 (VCC), U11.11 (I0b), U11.13 (I1b), U11.15 (I2b), U11.17 (I3b), U11.20 (VCC), U13.8, U13.9, U13.11, U13.12, U13.14 (VCC), U14.14 (VCC), U21.14 (VCC), U22.16 (VCC), U23.16 (VCC), U24.9, U24.10, U24.12, U24.13, U24.14 (VCC), U25.14 (VCC), U26.16 (VCC), U27.16 (VCC), U28.16 (VCC), U29.16 (VCC)
GND: C1.1, C2.1, C3.1, C4.1, C5.1, C6.1, C7.1, C8.1, C9.1, C10.1, C11.1, C13.1, C14.1, C21.1, C22.1, C23.1, C24.1, C25.1, C26.1, C27.1, C28.1, C29.1, J1.15, J1.16, J8.15, J8.16, R19.1, U1.7 (GND), U2.1 (B), U2.8 (GND), U2.9 (D), U3.4 (E1), U3.5 (E2), U3.8 (GND), U4.7 (GND), U5.7 (GND), U6.7 (GND), U7.10 (GND), U8.10 (GND), U9.10 (GND), U10.10 (GND), U11.10 (GND), U11.19 (OEb), U13.7 (GND), U14.7 (GND), U21.7 (GND), U22.8 (GND), U23.8 (GND), U24.7 (GND), U25.7 (GND), U26.8 (GND), U27.8 (GND), U28.3 (A2), U28.8 (GND), U29.3 (A2), U29.8 (GND)
unnamed: D15.1 (K), R19.2
unnamed: U1.1, U1.10, U5.2
unnamed: U1.6, U1.8, U2.4 (DOWN)
unnamed: U1.4, U1.13, U2.3 (QA), U3.1 (A0), U5.1
unnamed: U2.2 (QB), U3.2 (A1)
unnamed: U2.6 (QC), U3.3 (A2)
unnamed: U1.3, U1.11, U2.5 (UP)
unnamed: U3.9 (O6), U5.3
unnamed: U14.9, U25.3, U25.4
unnamed: U14.10, U21.10
unnamed: U14.11, U25.8, U25.12
unnamed: U14.12, U24.2, U24.5
unnamed: U21.6, U21.9
clock: J9.15, U14.13, U21.2, U25.5, U25.13
data_{0}: J1.4, J8.4
data_{1}: J1.3, J8.3
data_{2}: J1.5, J8.5
data_{3}: J1.7, J8.7
data_{4}: J1.9, J8.9
data_{5}: J1.11, J8.11
data_{6}: J1.13, J8.13
data_{7}: J1.14, J8.14
inc_one: J5.8, RN2.2 (R1), U8.7 (O1b)
inc_two: J5.16, RN3.7 (R6), U9.7 (O1b)
inc_zero: J5.7, RN1.5 (R4), U7.7 (O1b)
lr_at_one: U6.6, U10.19 (OEb)
lr_at_two: U6.8, U11.1 (OEa)
lr_at_zero: U6.3, U10.1 (OEa)
mar_inc: J4.7, U25.11
memory_read: J9.4, U13.4
memory_write: J9.2, U13.1
pc_at_one: U4.6, U8.1 (OEa), U8.19 (OEb)
pc_at_two: U4.8, U9.1 (OEa), U9.19 (OEb)
pc_at_zero: U4.3, U7.1 (OEa), U7.19 (OEb)
pc_inc: U7.13 (I1b), U8.13 (I1b), U9.13 (I1b), U25.6
pcia_swap: U1.2, U1.5, U5.8
pclr_swap: U1.9, U1.12, U5.10
rd_addr_0: J3.8, J9.8, U26.1 (A0), U27.1 (A0)
rd_addr_1: J3.10, J9.10, U26.2 (A1), U27.2 (A1), U29.1 (A0)
rd_addr_2: J3.12, J9.12, U26.3 (A2), U27.3 (A2), U29.2 (A1)
rd_addr_3: J3.14, J9.14, U14.5, U27.4 (E1), U27.5 (E2), U29.6 (E3)
rd_addr_4: J3.16, J9.16, U13.6, U26.6 (E3), U27.6 (E3), U29.4 (E1), U29.5 (E2)
sp_dec: J4.10, U24.3
sp_inc: J4.8, U24.6
swap_0: U3.15 (O0), U4.1, U6.4
swap_1: U3.14 (O1), U4.4, U6.1
swap_2: U3.13 (O2), U4.9, U6.2
swap_3: U3.12 (O3), U4.2, U6.9
swap_4: U3.11 (O4), U4.5, U6.10
swap_5: U3.10 (O5), U4.10, U6.5
swap_7: U2.11 (~LOAD), U3.7 (O7)
wr_addr_0: J3.5, J9.5, U22.1 (A0), U23.1 (A0)
wr_addr_1: J3.7, J9.7, U22.2 (A1), U23.2 (A1), U28.1 (A0)
wr_addr_2: J3.9, J9.9, U22.3 (A2), U23.3 (A2), U28.2 (A1)
wr_addr_3: J3.11, J9.11, U14.1, U23.4 (E1), U23.5 (E2)
wr_addr_4: J3.13, J9.13, U13.3, U14.3, U23.6 (E3), U28.5 (E2)
wr_enable: J9.6, U21.1, U28.6 (E3)
write_clock: J3.6, U21.3, U22.6 (E3)
~addr_mar: J4.5, U21.8
~addr_one: J5.6, RN2.3 (R2), U8.9 (O0b)
~addr_pc: U7.11 (I0b), U8.11 (I0b), U9.11 (I0b), U14.8
~addr_read_mar: U25.10, U29.13 (O2)
~addr_read_pc: U25.2, U29.15 (O0)
~addr_read_sp: U21.13, U24.4, U29.14 (O1)
~addr_sp: J4.6, U21.11
~addr_two: J5.14, RN3.8 (R7), U9.9 (O0b)
~addr_write_mar: U25.9, U28.13 (O2)
~addr_write_pc: U25.1, U28.15 (O0)
~addr_write_sp: U21.12, U24.1, U28.14 (O1)
~addr_zero: J5.5, RN1.9 (R8), U7.9 (O0b)
~pcia_swap: J9.3, U5.11
~pclr_swap: J9.1, U5.9
~rd_addr_3: U13.5, U14.6, U26.4 (E1), U26.5 (E2)
~read_iod_mar: U21.5, U27.15 (O0)
~read_lrh: U10.8 (I3a), U10.17 (I3b), U11.8 (I3a), U26.7 (O7)
~read_lrl: U10.6 (I2a), U10.15 (I2b), U11.6 (I2a), U26.9 (O6)
~read_marh: J4.1, U26.10 (O5)
~read_marl: J4.3, U26.11 (O4)
~read_one_h: J5.2, RN2.4 (R3), U8.12 (O3a), U10.3 (O3b)
~read_one_l: J5.4, RN2.5 (R4), U8.14 (O2a), U10.5 (O2b)
~read_pch: U7.8 (I3a), U8.8 (I3a), U9.8 (I3a), U26.14 (O1)
~read_pcl: U7.6 (I2a), U8.6 (I2a), U9.6 (I2a), U26.15 (O0)
~read_sph: J4.2, U26.12 (O3)
~read_spl: J4.4, U26.13 (O2)
~read_two_h: J5.13, RN3.9 (R8), U9.12 (O3a), U11.12 (O3a)
~read_two_l: J5.15, RN3.6 (R5), U9.14 (O2a), U11.14 (O2a)
~read_zero_h: J5.1, RN1.4 (R3), U7.12 (O3a), U10.12 (O3a)
~read_zero_l: J5.3, RN1.7 (R6), U7.14 (O2a), U10.14 (O2a)
~swap_6: U2.14 (CLR), U5.4
~wr_addr_3: U13.2, U14.2, U22.4 (E1), U28.4 (E1)
~wr_addr_4: U14.4, U22.5 (E2)
~write_iod_mar: U21.4, U23.15 (O0)
~write_lrh: U10.4 (I1a), U10.13 (I1b), U11.4 (I1a), U22.7 (O7)
~write_lrl: U10.2 (I0a), U10.11 (I0b), U11.2 (I0a), U22.9 (O6)
~write_marh: J4.9, U22.10 (O5)
~write_marl: J4.11, U22.11 (O4)
~write_one_h: J5.10, RN2.7 (R6), U8.16 (O1a), U10.7 (O1b)
~write_one_l: J5.12, RN2.6 (R5), U8.18 (O0a), U10.9 (O0b)
~write_pch: U7.4 (I1a), U8.4 (I1a), U9.4 (I1a), U22.14 (O1)
~write_pcl: U7.2 (I0a), U8.2 (I0a), U9.2 (I0a), U22.15 (O0)
~write_sph: J4.12, U22.12 (O3)
~write_spl: J4.14, U22.13 (O2)
~write_two_h: J4.13, RN3.5 (R4), U9.16 (O1a), U11.16 (O1a)
~write_two_l: J4.15, RN3.2 (R1), U9.18 (O0a), U11.18 (O0a)
~write_zero_h: J5.9, RN1.8 (R7), U7.16 (O1a), U10.16 (O1a)
~write_zero_l: J5.11, RN1.6 (R5), U7.18 (O0a), U10.18 (O0a)

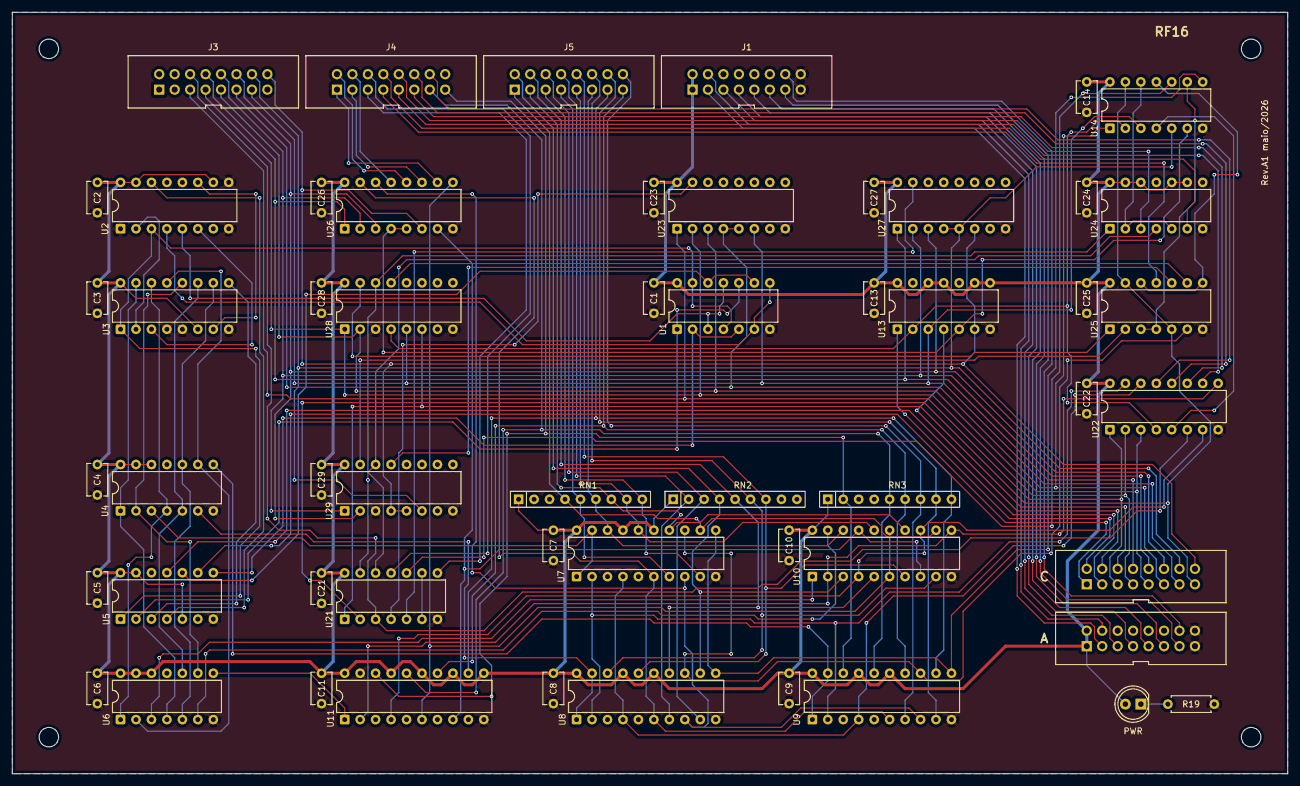
[picture p23: board m16rf.kicad_pcb from above]

Board: 2 copper layers, 209.5 x 125.1 mm, 55 parts (0 on the bottom side), 108 nets.
