rcapaverde/cubo/pcb_v2/sr8a/sr8a.kicad_pcb

## KiCad design pcb_v2/sr8a/sr8a.kicad_pcb (2026-06-01, an earlier design)

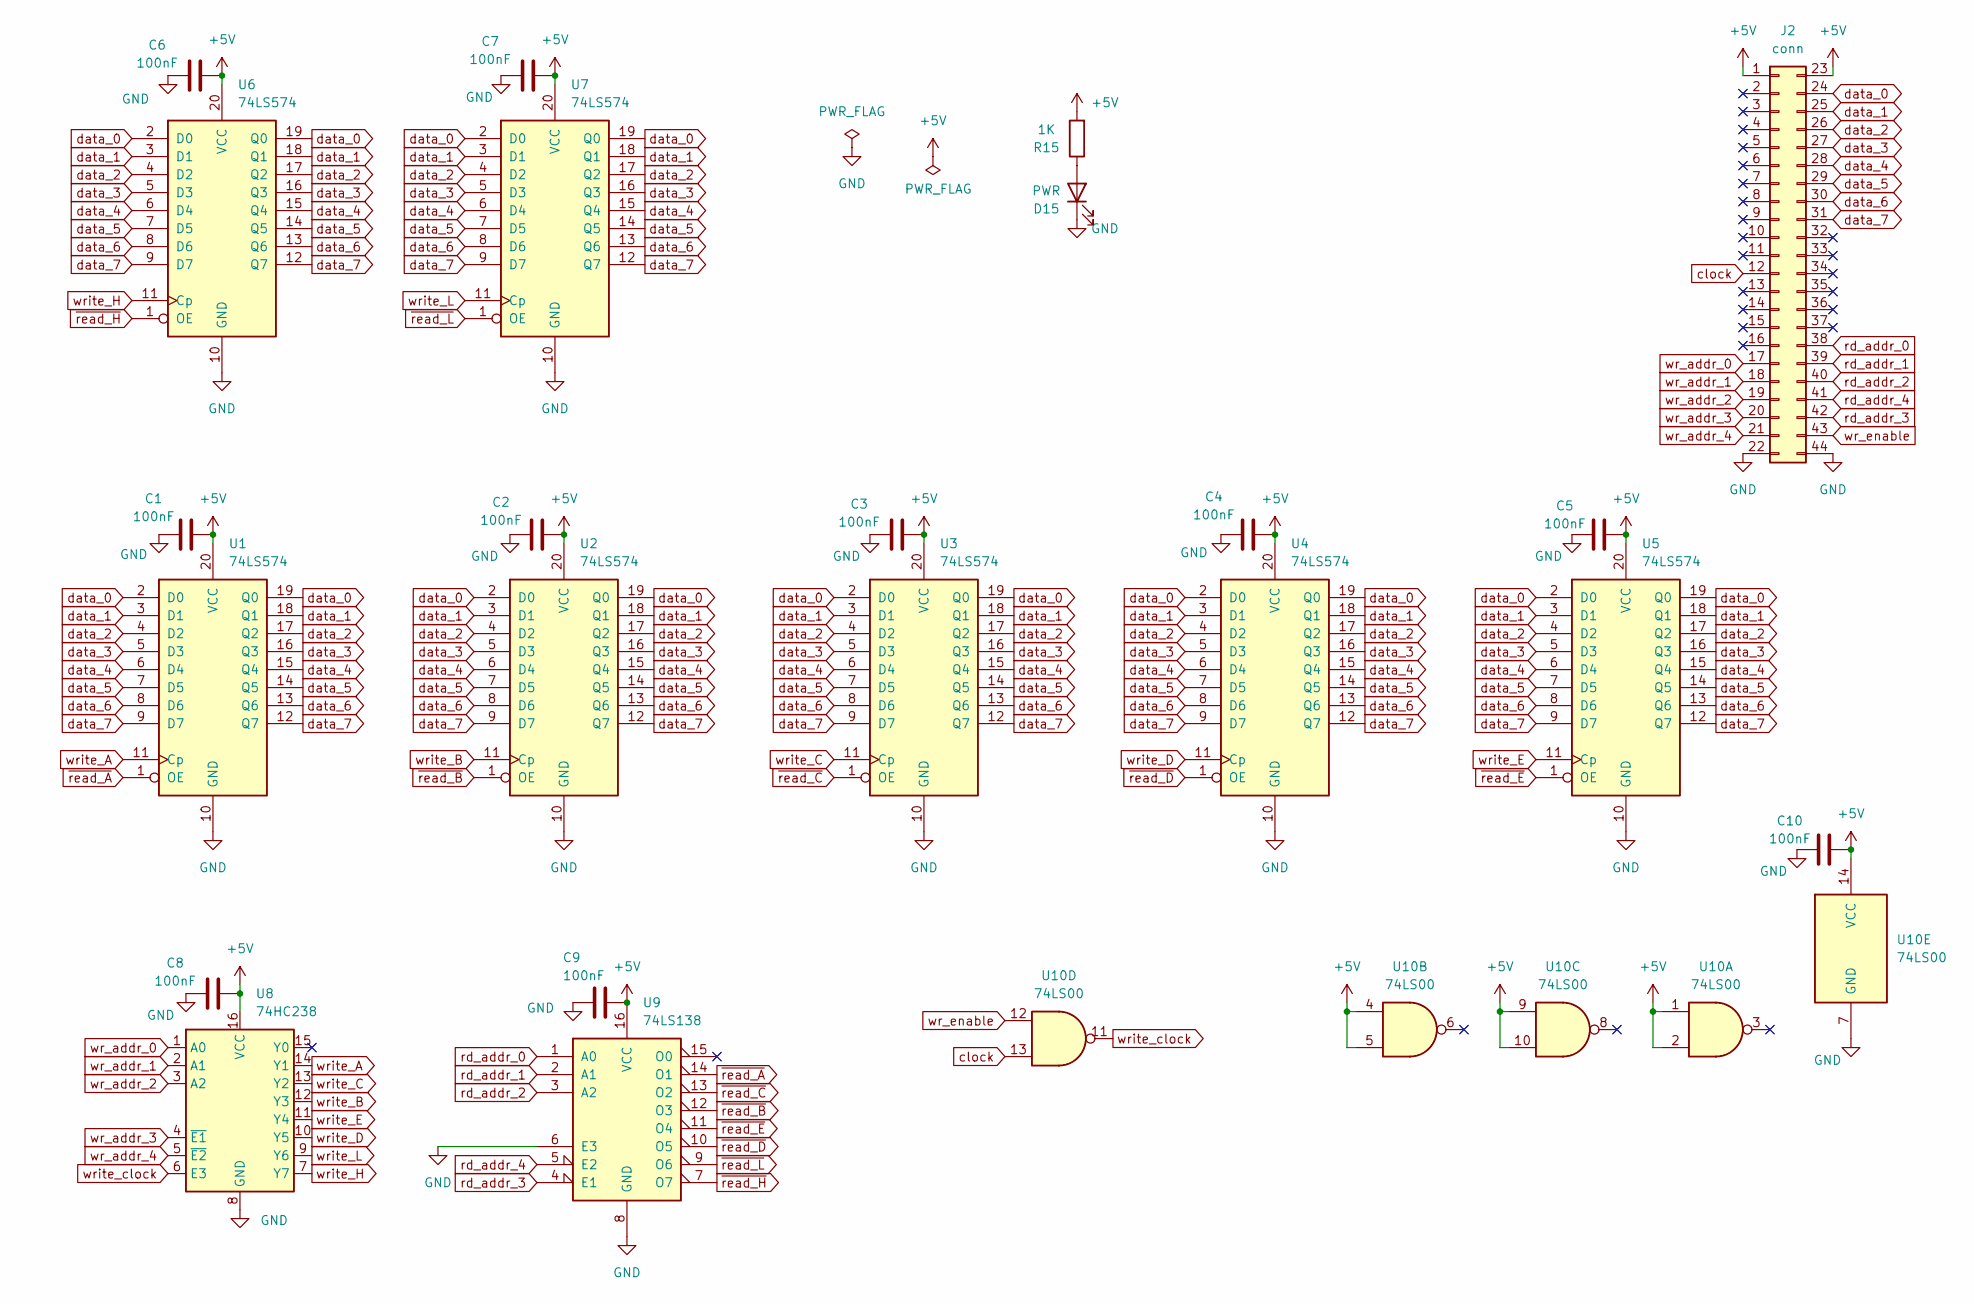
[picture p24: schematic sr8a.kicad_sch]

Parts:
C1, C2, C3, C4, C5, C6, C7, C8, C9, C10: 100nF; C_Disc_D5.1mm_W3.2mm_P5.00mm
D15: PWR; LED_D5.0mm
J2: conn; edge-connector-44
R15: 1K; R_Axial_DIN0207_L6.3mm_D2.5mm_P7.62mm_Horizontal
U1, U2, U3, U4, U5, U6, U7: 74LS574; DIP-20_W7.62mm
U8: 74HC238; DIP-16_W7.62mm
U9: 74LS138; DIP-16_W7.62mm
U10: 74LS00; DIP-14_W7.62mm

Connections:
+5V: C1.2, C2.2, C3.2, C4.2, C5.2, C6.2, C7.2, C8.2, C9.2, C10.2, J2.1, J2.23, R15.2, U1.20 (VCC), U2.20 (VCC), U3.20 (VCC), U4.20 (VCC), U5.20 (VCC), U6.20 (VCC), U7.20 (VCC), U8.16 (VCC), U9.16 (VCC), U10.1, U10.2, U10.4, U10.5, U10.9, U10.10, U10.14 (VCC)
GND: C1.1, C2.1, C3.1, C4.1, C5.1, C6.1, C7.1, C8.1, C9.1, C10.1, D15.1 (K), J2.22, J2.44, U1.10 (GND), U2.10 (GND), U3.10 (GND), U4.10 (GND), U5.10 (GND), U6.10 (GND), U7.10 (GND), U8.8 (GND), U9.6 (E3), U9.8 (GND), U10.7 (GND)
unnamed: D15.2 (A), R15.1
clock: J2.12, U10.13
data_0: J2.24, U1.2 (D0), U1.19 (Q0), U2.2 (D0), U2.19 (Q0), U3.2 (D0), U3.19 (Q0), U4.2 (D0), U4.19 (Q0), U5.2 (D0), U5.19 (Q0), U6.2 (D0), U6.19 (Q0), U7.2 (D0), U7.19 (Q0)
data_1: J2.25, U1.3 (D1), U1.18 (Q1), U2.3 (D1), U2.18 (Q1), U3.3 (D1), U3.18 (Q1), U4.3 (D1), U4.18 (Q1), U5.3 (D1), U5.18 (Q1), U6.3 (D1), U6.18 (Q1), U7.3 (D1), U7.18 (Q1)
data_2: J2.26, U1.4 (D2), U1.17 (Q2), U2.4 (D2), U2.17 (Q2), U3.4 (D2), U3.17 (Q2), U4.4 (D2), U4.17 (Q2), U5.4 (D2), U5.17 (Q2), U6.4 (D2), U6.17 (Q2), U7.4 (D2), U7.17 (Q2)
data_3: J2.27, U1.5 (D3), U1.16 (Q3), U2.5 (D3), U2.16 (Q3), U3.5 (D3), U3.16 (Q3), U4.5 (D3), U4.16 (Q3), U5.5 (D3), U5.16 (Q3), U6.5 (D3), U6.16 (Q3), U7.5 (D3), U7.16 (Q3)
data_4: J2.28, U1.6 (D4), U1.15 (Q4), U2.6 (D4), U2.15 (Q4), U3.6 (D4), U3.15 (Q4), U4.6 (D4), U4.15 (Q4), U5.6 (D4), U5.15 (Q4), U6.6 (D4), U6.15 (Q4), U7.6 (D4), U7.15 (Q4)
data_5: J2.29, U1.7 (D5), U1.14 (Q5), U2.7 (D5), U2.14 (Q5), U3.7 (D5), U3.14 (Q5), U4.7 (D5), U4.14 (Q5), U5.7 (D5), U5.14 (Q5), U6.7 (D5), U6.14 (Q5), U7.7 (D5), U7.14 (Q5)
data_6: J2.30, U1.8 (D6), U1.13 (Q6), U2.8 (D6), U2.13 (Q6), U3.8 (D6), U3.13 (Q6), U4.8 (D6), U4.13 (Q6), U5.8 (D6), U5.13 (Q6), U6.8 (D6), U6.13 (Q6), U7.8 (D6), U7.13 (Q6)
data_7: J2.31, U1.9 (D7), U1.12 (Q7), U2.9 (D7), U2.12 (Q7), U3.9 (D7), U3.12 (Q7), U4.9 (D7), U4.12 (Q7), U5.9 (D7), U5.12 (Q7), U6.9 (D7), U6.12 (Q7), U7.9 (D7), U7.12 (Q7)
rd_addr_0: J2.38, U9.1 (A0)
rd_addr_1: J2.39, U9.2 (A1)
rd_addr_2: J2.40, U9.3 (A2)
rd_addr_3: J2.42, U9.4 (E1)
rd_addr_4: J2.41, U9.5 (E2)
wr_addr_0: J2.17, U8.1 (A0)
wr_addr_1: J2.18, U8.2 (A1)
wr_addr_2: J2.19, U8.3 (A2)
wr_addr_3: J2.20, U8.4 (~E1)
wr_addr_4: J2.21, U8.5 (~E2)
wr_enable: J2.43, U10.12
write_A: U1.11 (Cp), U8.14 (Y1)
write_B: U2.11 (Cp), U8.12 (Y3)
write_C: U3.11 (Cp), U8.13 (Y2)
write_D: U4.11 (Cp), U8.10 (Y5)
write_E: U5.11 (Cp), U8.11 (Y4)
write_H: U6.11 (Cp), U8.7 (Y7)
write_L: U7.11 (Cp), U8.9 (Y6)
write_clock: U8.6 (E3), U10.11
~read_A: U1.1 (OE), U9.14 (O1)
~read_B: U2.1 (OE), U9.12 (O3)
~read_C: U3.1 (OE), U9.13 (O2)
~read_D: U4.1 (OE), U9.10 (O5)
~read_E: U5.1 (OE), U9.11 (O4)
~read_H: U6.1 (OE), U9.7 (O7)
~read_L: U7.1 (OE), U9.9 (O6)

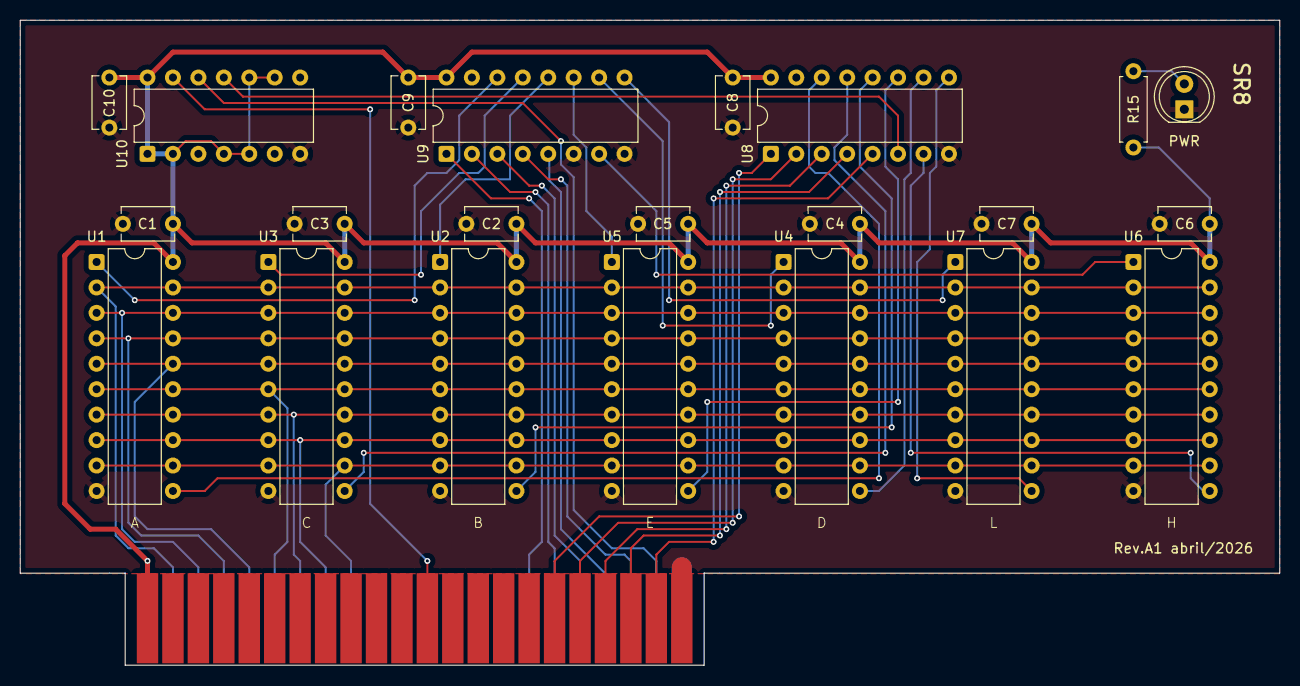
[picture p25: board sr8a.kicad_pcb from above]

Board: 2 copper layers, 125.7 x 64.4 mm, 23 parts (0 on the bottom side), 38 nets.
