rcapaverde/cubo/pcb_v2/ula8a/ula8a.kicad_pcb

## KiCad design pcb_v2/ula8a/ula8a.kicad_pcb (2026-05-18, an earlier design)

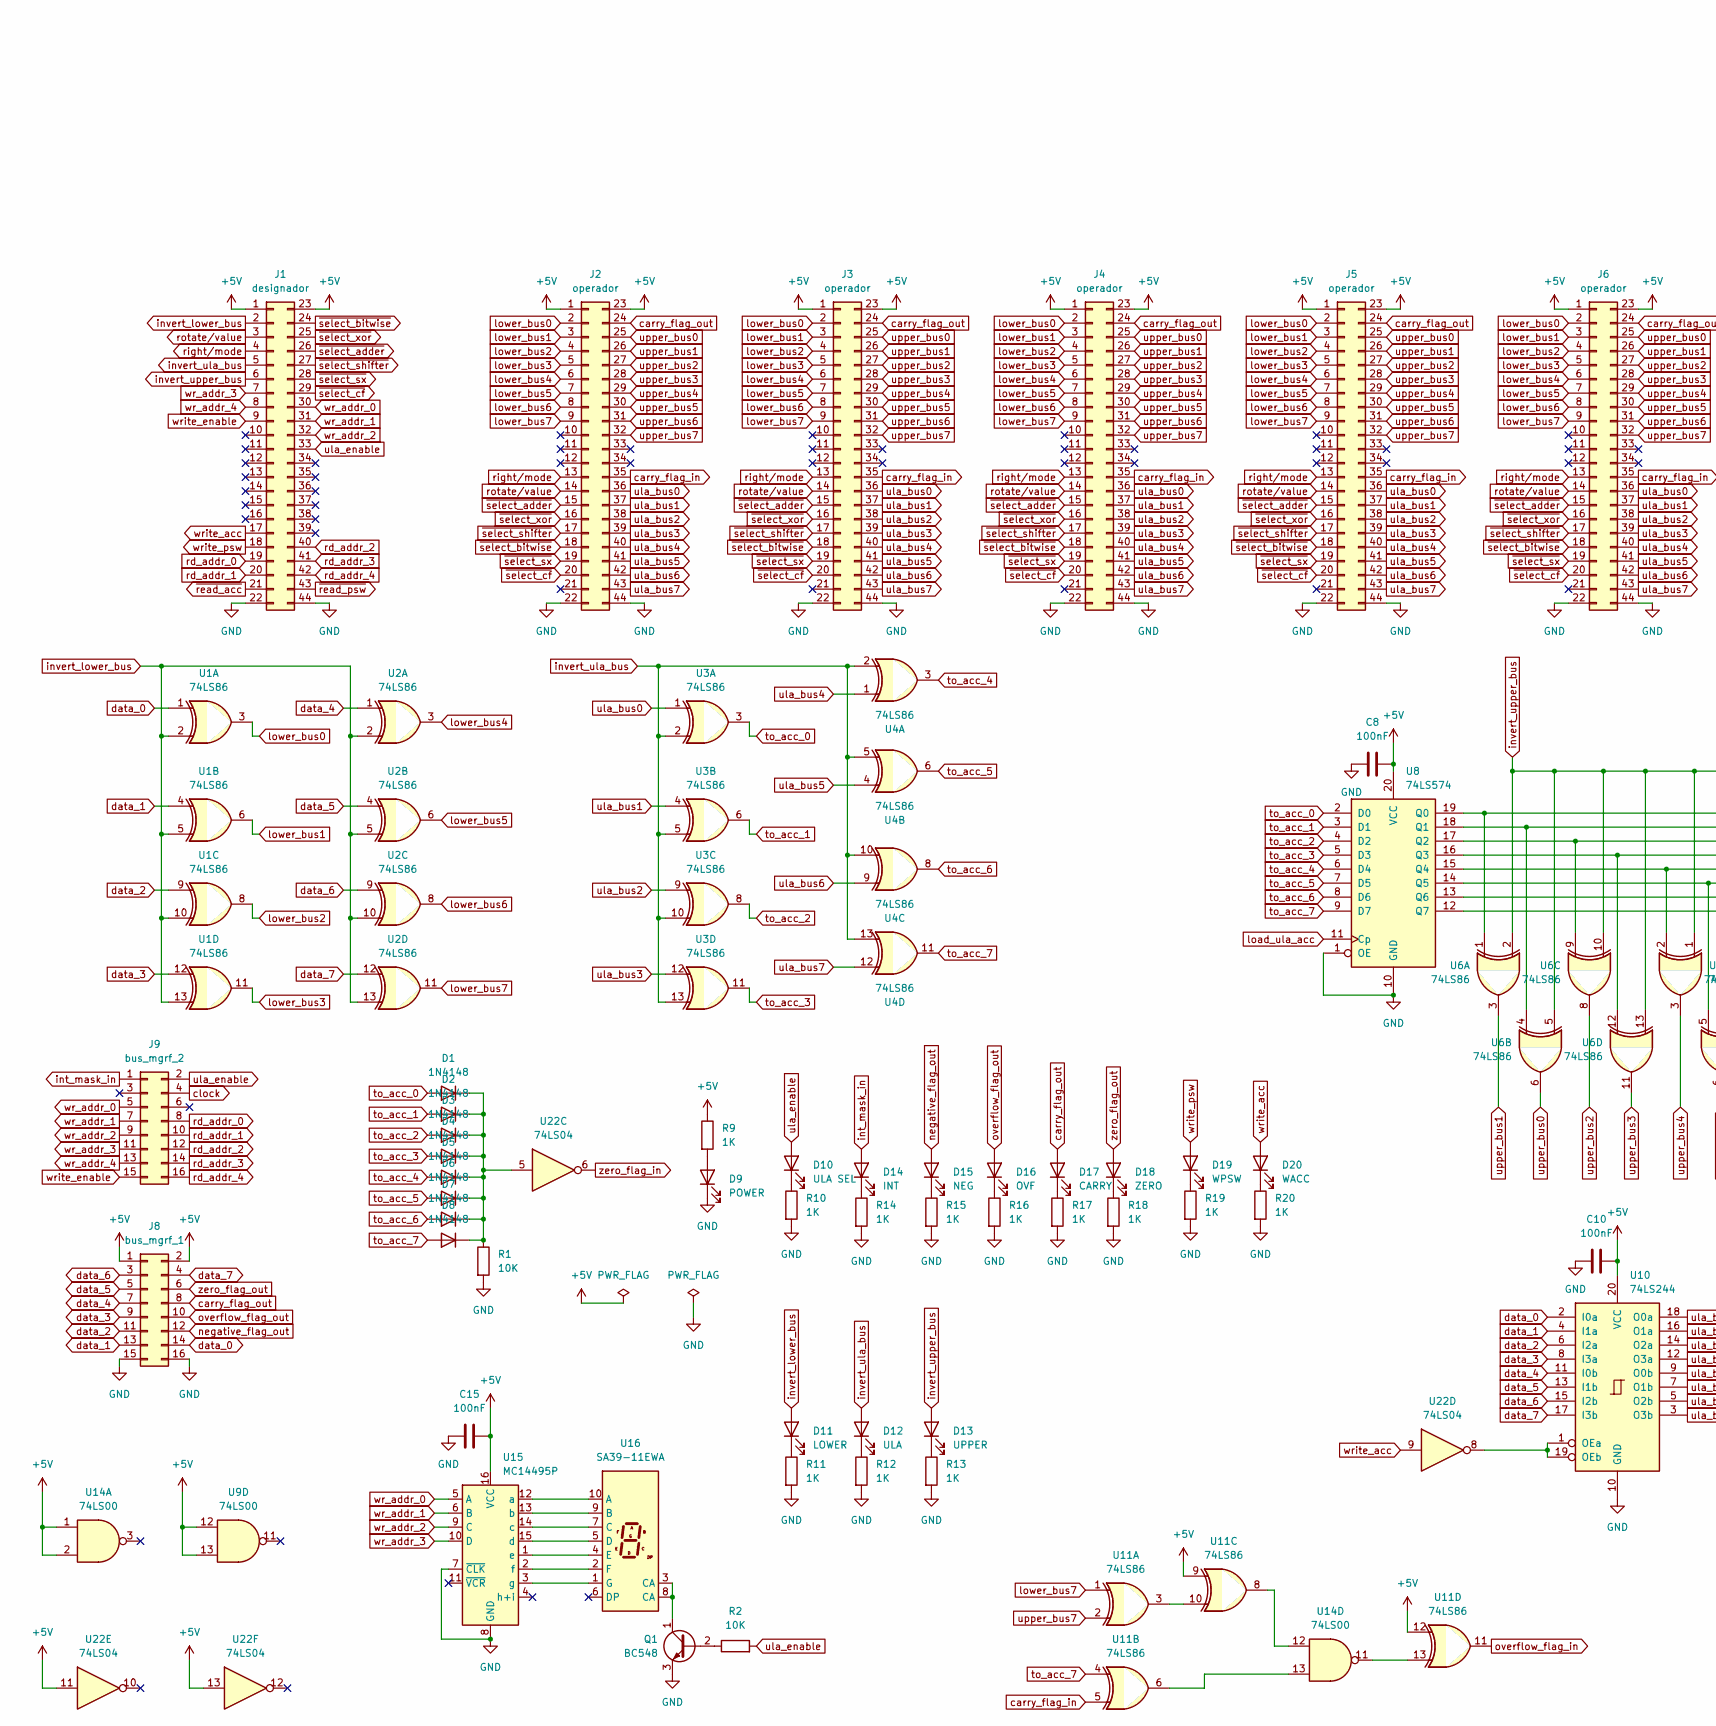
[picture p26: schematic ula8a.kicad_sch, part in row 1, column 1]

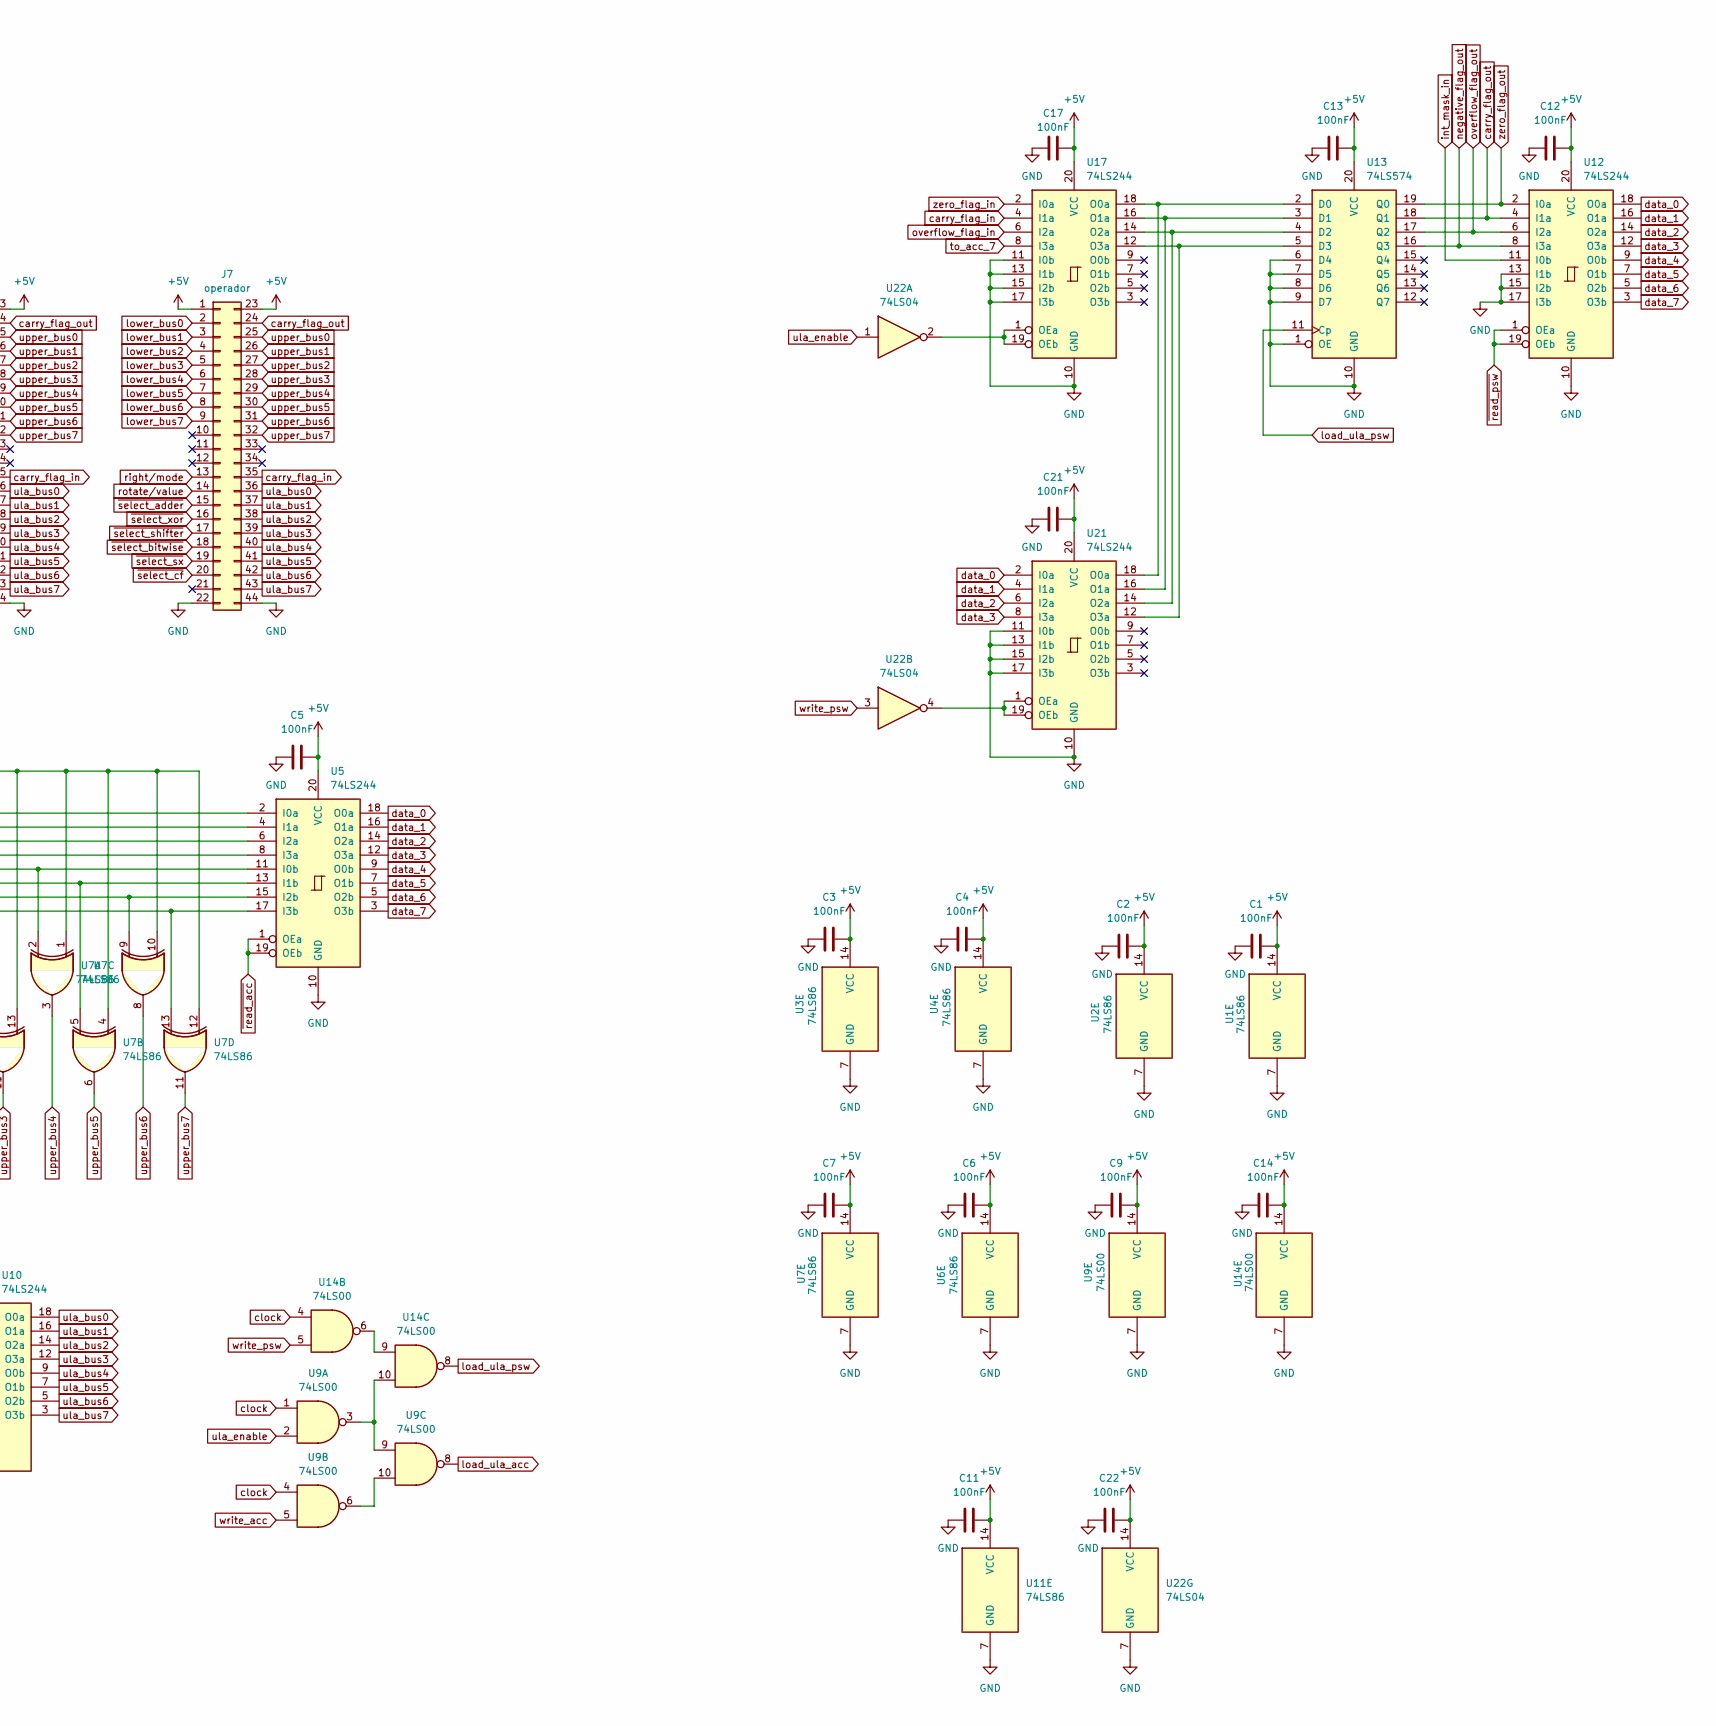
[picture p27: schematic ula8a.kicad_sch, part in row 1, column 2]

Parts:
C1, C2, C3, C4, C5, C6, C7, C8, C9, C10, C11, C12, C13, C14, C15, C17, C21, C22: 100nF; C_Disc_D5.1mm_W3.2mm_P5.00mm
D1, D2, D3, D4, D5, D6, D7, D8: 1N4148; D_DO-35_SOD27_P7.62mm_Horizontal
D9: POWER; LED_D5.0mm
D10: ULA SEL; LED_D5.0mm
D11: LOWER; LED_D5.0mm
D12: ULA; LED_D5.0mm
D13: UPPER; LED_D5.0mm
D14: INT; LED_D5.0mm
D15: NEG; LED_D5.0mm
D16: OVF; LED_D5.0mm
D17: CARRY; LED_D5.0mm
D18: ZERO; LED_D5.0mm
D19: WPSW; LED_D5.0mm
D20: WACC; LED_D5.0mm
J1: designador; male-edge-connector-44
J2, J3, J4, J5, J6, J7: operador; male-edge-connector-44
J8: bus_mgrf_1; conector 02x08
J9: bus_mgrf_2; conector 02x08
Q1: BC548; TO-92_Inline
R1, R2: 10K; R_Axial_DIN0207_L6.3mm_D2.5mm_P7.62mm_Horizontal
R9, R10, R11, R12, R13, R14, R15, R16, R17, R18, R19, R20: 1K; R_Axial_DIN0207_L6.3mm_D2.5mm_P7.62mm_Horizontal
U1, U2, U3, U4, U6, U7, U11: 74LS86; DIP-14_W7.62mm
U5, U10, U12, U17, U21: 74LS244; DIP-20_W7.62mm
U8, U13: 74LS574; DIP-20_W7.62mm
U9, U14: 74LS00; DIP-14_W7.62mm
U15: MC14495P; DIP-16_W7.62mm
U16: SA39-11EWA; 1-digit-13mm
U22: 74LS04; DIP-14_W7.62mm

Connections:
+5V: C1.2, C2.2, C3.2, C4.2, C5.2, C6.2, C7.2, C8.2, C9.2, C10.2, C11.2, C12.2, C13.2, C14.2, C15.2, C17.2, C21.2, C22.2, J1.1, J1.23, J2.1, J2.23, J3.1, J3.23, J4.1, J4.23, J5.1, J5.23, J6.1, J6.23, J7.1, J7.23, J8.1, J8.2, R9.1, U1.14 (VCC), U2.14 (VCC), U3.14 (VCC), U4.14 (VCC), U5.20 (VCC), U6.14 (VCC), U7.14 (VCC), U8.20 (VCC), U9.12, U9.13, U9.14 (VCC), U10.20 (VCC), U11.9, U11.12, U11.14 (VCC), U12.20 (VCC), U13.20 (VCC), U14.1, U14.2, U14.14 (VCC), U15.16 (VCC), U17.20 (VCC), U21.20 (VCC), U22.11, U22.13, U22.14 (VCC)
GND: C1.1, C2.1, C3.1, C4.1, C5.1, C6.1, C7.1, C8.1, C9.1, C10.1, C11.1, C12.1, C13.1, C14.1, C15.1, C17.1, C21.1, C22.1, D9.1 (K), J1.22, J1.44, J2.22, J2.44, J3.22, J3.44, J4.22, J4.44, J5.22, J5.44, J6.22, J6.44, J7.22, J7.44, J8.15, J8.16, Q1.3 (E), R1.2, R10.2, R11.2, R12.2, R13.2, R14.2, R15.2, R16.2, R17.2, R18.2, R19.2, R20.2, U1.7 (GND), U2.7 (GND), U3.7 (GND), U4.7 (GND), U5.10 (GND), U6.7 (GND), U7.7 (GND), U8.1 (OE), U8.10 (GND), U9.7 (GND), U10.10 (GND), U11.7 (GND), U12.10 (GND), U12.13 (I1b), U12.15 (I2b), U12.17 (I3b), U13.1 (OE), U13.6 (D4), U13.7 (D5), U13.8 (D6), U13.9 (D7), U13.10 (GND), U14.7 (GND), U15.7 (~CLK), U15.8 (GND), U17.10 (GND), U17.11 (I0b), U17.13 (I1b), U17.15 (I2b), U17.17 (I3b), U21.10 (GND), U21.11 (I0b), U21.13 (I1b), U21.15 (I2b), U21.17 (I3b), U22.7 (GND)
unnamed: D1.1 (K), D2.1 (K), D3.1 (K), D4.1 (K), D5.1 (K), D6.1 (K), D7.1 (K), D8.1 (K), R1.1, U22.5
unnamed: D9.2 (A), R9.2
unnamed: D10.1 (K), R10.1
unnamed: D11.1 (K), R11.1
unnamed: D12.1 (K), R12.1
unnamed: D13.1 (K), R13.1
unnamed: D14.1 (K), R14.1
unnamed: D15.1 (K), R15.1
unnamed: D16.1 (K), R16.1
unnamed: D17.1 (K), R17.1
unnamed: D18.1 (K), R18.1
unnamed: D19.1 (K), R19.1
unnamed: D20.1 (K), R20.1
unnamed: Q1.2 (B), R2.1
unnamed: Q1.1 (C), U16.3 (CA), U16.8 (CA)
unnamed: U5.2 (I0a), U6.1, U8.19 (Q0)
unnamed: U5.11 (I0b), U7.2, U8.15 (Q4)
unnamed: U5.4 (I1a), U6.4, U8.18 (Q1)
unnamed: U5.13 (I1b), U7.5, U8.14 (Q5)
unnamed: U5.6 (I2a), U6.9, U8.17 (Q2)
unnamed: U5.15 (I2b), U7.9, U8.13 (Q6)
unnamed: U5.8 (I3a), U6.12, U8.16 (Q3)
unnamed: U5.17 (I3b), U7.13, U8.12 (Q7)
unnamed: U9.6, U9.10
unnamed: U10.1 (OEa), U10.19 (OEb), U22.8
unnamed: U11.6, U14.13
unnamed: U11.8, U14.12
unnamed: U11.3, U11.10
unnamed: U11.13, U14.11
unnamed: U13.2 (D0), U17.18 (O0a), U21.18 (O0a)
unnamed: U13.3 (D1), U17.16 (O1a), U21.16 (O1a)
unnamed: U13.4 (D2), U17.14 (O2a), U21.14 (O2a)
unnamed: U13.5 (D3), U17.12 (O3a), U21.12 (O3a)
unnamed: U14.6, U14.9
unnamed: U9.3, U9.9, U14.10
unnamed: U15.12 (a), U16.10 (A)
unnamed: U15.13 (b), U16.9 (B)
unnamed: U15.14 (c), U16.7 (C)
unnamed: U15.15 (d), U16.5 (D)
unnamed: U15.1 (e), U16.4 (E)
unnamed: U15.2 (f), U16.2 (F)
unnamed: U15.3 (g), U16.1 (G)
unnamed: U17.1 (OEa), U17.19 (OEb), U22.2
unnamed: U21.1 (OEa), U21.19 (OEb), U22.4
carry_flag_in: J2.35, J3.35, J4.35, J5.35, J6.35, J7.35, U11.5, U17.4 (I1a)
carry_flag_out: D17.2 (A), J2.24, J3.24, J4.24, J5.24, J6.24, J7.24, J8.8, U12.4 (I1a), U13.18 (Q1)
clock: J9.4, U9.1, U9.4, U14.4
data_0: J8.14, U1.1, U5.18 (O0a), U10.2 (I0a), U12.18 (O0a), U21.2 (I0a)
data_1: J8.13, U1.4, U5.16 (O1a), U10.4 (I1a), U12.16 (O1a), U21.4 (I1a)
data_2: J8.11, U1.9, U5.14 (O2a), U10.6 (I2a), U12.14 (O2a), U21.6 (I2a)
data_3: J8.9, U1.12, U5.12 (O3a), U10.8 (I3a), U12.12 (O3a), U21.8 (I3a)
data_4: J8.7, U2.1, U5.9 (O0b), U10.11 (I0b), U12.9 (O0b)
data_5: J8.5, U2.4, U5.7 (O1b), U10.13 (I1b), U12.7 (O1b)
data_6: J8.3, U2.9, U5.5 (O2b), U10.15 (I2b), U12.5 (O2b)
data_7: J8.4, U2.12, U5.3 (O3b), U10.17 (I3b), U12.3 (O3b)
int_mask_in: D14.2 (A), J9.1, U12.11 (I0b)
invert_lower_bus: D11.2 (A), J1.2, U1.2, U1.5, U1.10, U1.13, U2.2, U2.5, U2.10, U2.13
invert_ula_bus: D12.2 (A), J1.5, U3.2, U3.5, U3.10, U3.13, U4.2, U4.5, U4.10, U4.13
invert_upper_bus: D13.2 (A), J1.6, U6.2, U6.5, U6.10, U6.13, U7.1, U7.4, U7.10, U7.12
load_ula_acc: U8.11 (Cp), U9.8
load_ula_psw: U13.11 (Cp), U14.8
lower_bus0: J2.2, J3.2, J4.2, J5.2, J6.2, J7.2, U1.3
lower_bus1: J2.3, J3.3, J4.3, J5.3, J6.3, J7.3, U1.6
lower_bus2: J2.4, J3.4, J4.4, J5.4, J6.4, J7.4, U1.8
lower_bus3: J2.5, J3.5, J4.5, J5.5, J6.5, J7.5, U1.11
lower_bus4: J2.6, J3.6, J4.6, J5.6, J6.6, J7.6, U2.3
lower_bus5: J2.7, J3.7, J4.7, J5.7, J6.7, J7.7, U2.6
lower_bus6: J2.8, J3.8, J4.8, J5.8, J6.8, J7.8, U2.8
lower_bus7: J2.9, J3.9, J4.9, J5.9, J6.9, J7.9, U2.11, U11.1
negative_flag_out: D15.2 (A), J8.12, U12.8 (I3a), U13.16 (Q3)
overflow_flag_in: U11.11, U17.6 (I2a)
overflow_flag_out: D16.2 (A), J8.10, U12.6 (I2a), U13.17 (Q2)
rd_addr_0: J1.19, J9.8
rd_addr_1: J1.20, J9.10
rd_addr_2: J1.40, J9.12
rd_addr_3: J1.41, J9.14
rd_addr_4: J1.42, J9.16
right/mode: J1.4, J2.13, J3.13, J4.13, J5.13, J6.13, J7.13
rotate/value: J1.3, J2.14, J3.14, J4.14, J5.14, J6.14, J7.14
to_acc_0: D1.2 (A), U3.3, U8.2 (D0)
to_acc_1: D2.2 (A), U3.6, U8.3 (D1)
to_acc_2: D3.2 (A), U3.8, U8.4 (D2)
to_acc_3: D4.2 (A), U3.11, U8.5 (D3)
to_acc_4: D5.2 (A), U4.3, U8.6 (D4)
to_acc_5: D6.2 (A), U4.6, U8.7 (D5)
to_acc_6: D7.2 (A), U4.8, U8.8 (D6)
to_acc_7: D8.2 (A), U4.11, U8.9 (D7), U11.4, U17.8 (I3a)
ula_bus0: J2.36, J3.36, J4.36, J5.36, J6.36, J7.36, U3.1, U10.18 (O0a)
ula_bus1: J2.37, J3.37, J4.37, J5.37, J6.37, J7.37, U3.4, U10.16 (O1a)
ula_bus2: J2.38, J3.38, J4.38, J5.38, J6.38, J7.38, U3.9, U10.14 (O2a)
ula_bus3: J2.39, J3.39, J4.39, J5.39, J6.39, J7.39, U3.12, U10.12 (O3a)
ula_bus4: J2.40, J3.40, J4.40, J5.40, J6.40, J7.40, U4.1, U10.9 (O0b)
ula_bus5: J2.41, J3.41, J4.41, J5.41, J6.41, J7.41, U4.4, U10.7 (O1b)
ula_bus6: J2.42, J3.42, J4.42, J5.42, J6.42, J7.42, U4.9, U10.5 (O2b)
ula_bus7: J2.43, J3.43, J4.43, J5.43, J6.43, J7.43, U4.12, U10.3 (O3b)
ula_enable: D10.2 (A), J1.33, J9.2, R2.2, U9.2, U22.1
upper_bus0: J2.25, J3.25, J4.25, J5.25, J6.25, J7.25, U6.6
upper_bus1: J2.26, J3.26, J4.26, J5.26, J6.26, J7.26, U6.3
upper_bus2: J2.27, J3.27, J4.27, J5.27, J6.27, J7.27, U6.8
upper_bus3: J2.28, J3.28, J4.28, J5.28, J6.28, J7.28, U6.11
upper_bus4: J2.29, J3.29, J4.29, J5.29, J6.29, J7.29, U7.3
upper_bus5: J2.30, J3.30, J4.30, J5.30, J6.30, J7.30, U7.6
upper_bus6: J2.31, J3.31, J4.31, J5.31, J6.31, J7.31, U7.8
upper_bus7: J2.32, J3.32, J4.32, J5.32, J6.32, J7.32, U7.11, U11.2
wr_addr_0: J1.30, J9.5, U15.5 (A)
wr_addr_1: J1.31, J9.7, U15.6 (B)
wr_addr_2: J1.32, J9.9, U15.9 (C)
wr_addr_3: J1.7, J9.11, U15.10 (D)
wr_addr_4: J1.8, J9.13
write_acc: D20.2 (A), J1.17, U9.5, U22.9
write_enable: J1.9, J9.15
write_psw: D19.2 (A), J1.18, U14.5, U22.3
zero_flag_in: U17.2 (I0a), U22.6
zero_flag_out: D18.2 (A), J8.6, U12.2 (I0a), U13.19 (Q0)
~read_acc: J1.21, U5.1 (OEa), U5.19 (OEb)
~read_psw: J1.43, U12.1 (OEa), U12.19 (OEb)
~select_adder: J1.26, J2.15, J3.15, J4.15, J5.15, J6.15, J7.15
~select_bitwise: J1.24, J2.18, J3.18, J4.18, J5.18, J6.18, J7.18
~select_cf: J1.29, J2.20, J3.20, J4.20, J5.20, J6.20, J7.20
~select_shifter: J1.27, J2.17, J3.17, J4.17, J5.17, J6.17, J7.17
~select_sx: J1.28, J2.19, J3.19, J4.19, J5.19, J6.19, J7.19
~select_xor: J1.25, J2.16, J3.16, J4.16, J5.16, J6.16, J7.16

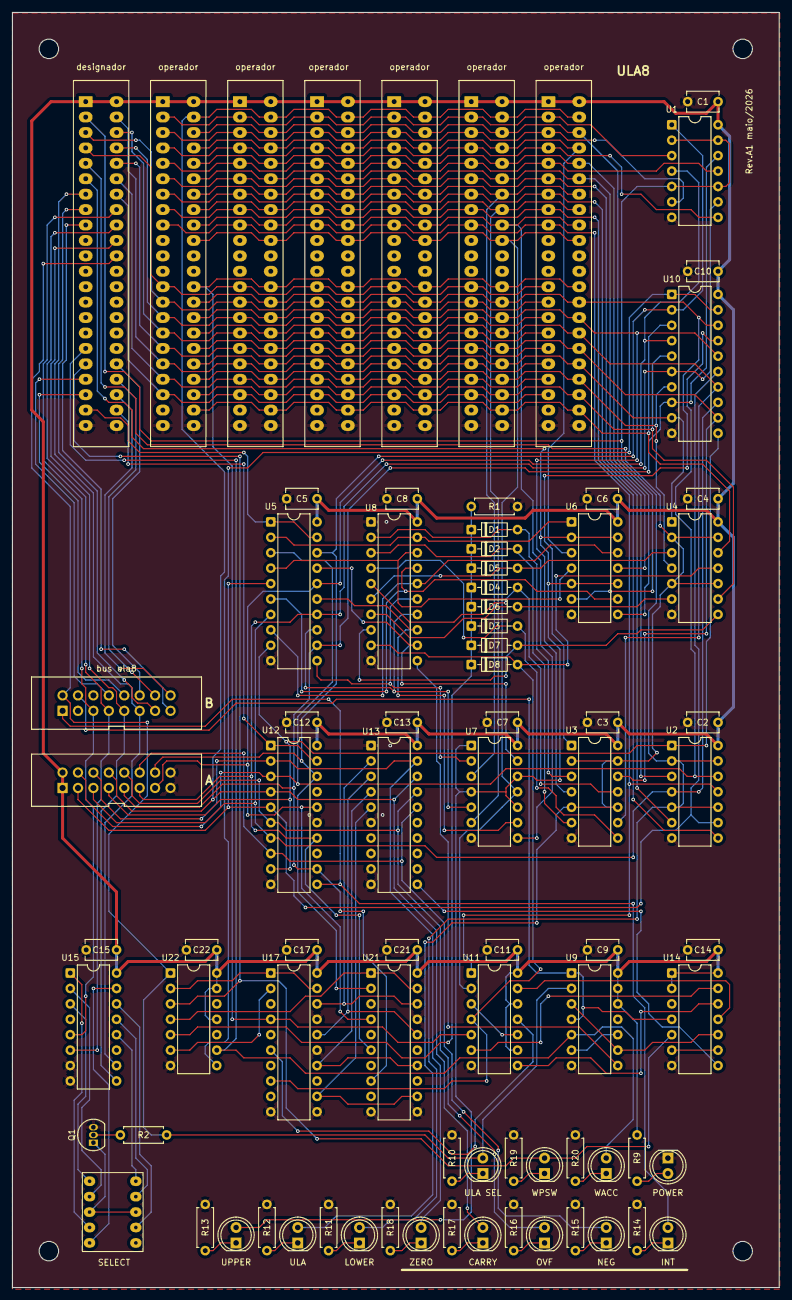
[picture p28: board ula8a.kicad_pcb from above]

Board: 2 copper layers, 126.3 x 210.0 mm, 81 parts (0 on the bottom side), 124 nets.
