rcapaverde/cubo/pcb_v2/clock-cpa/clock-cpa.kicad_pcb

## KiCad design pcb_v2/clock-cpa/clock-cpa.kicad_pcb (2026-05-16, an earlier design)

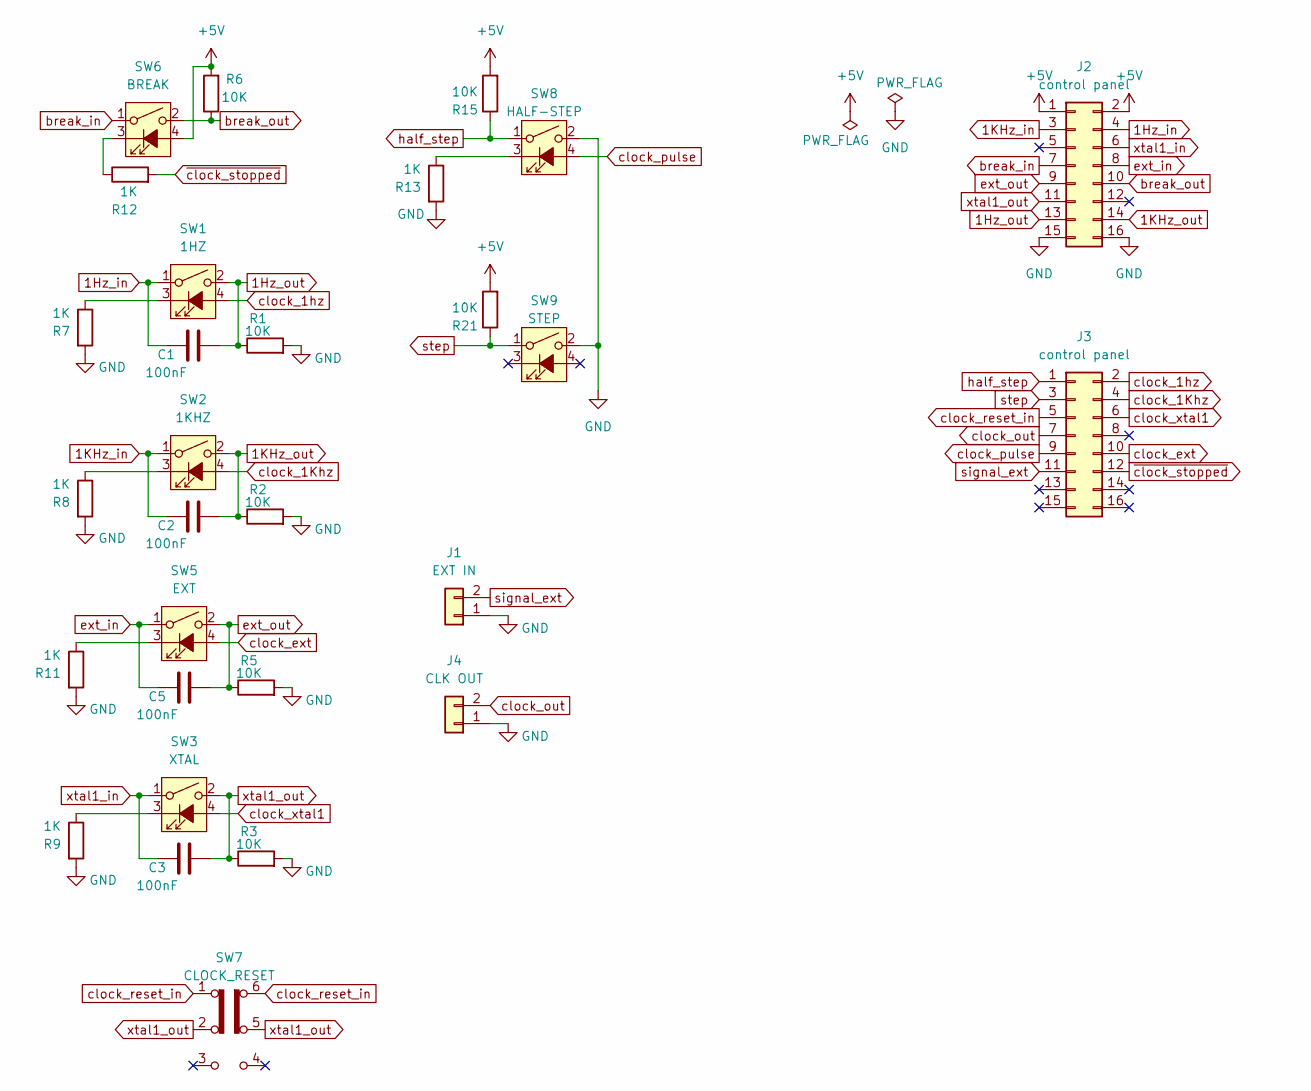
[picture p29: schematic clock-cpa.kicad_sch]

Parts:
C1, C2, C3, C5: 100nF; C_Disc_D4.7mm_W2.5mm_P5.00mm
J1: EXT IN; JST_XH_B2B-XH-A_1x02_P2.50mm_Vertical
J2, J3: control panel; PinHeader_2x08_P2.54mm_Vertical
J4: CLK OUT; JST_XH_B2B-XH-A_1x02_P2.50mm_Vertical
R1, R2, R3, R5, R6, R15, R21: 10K; R_Axial_DIN0207_L6.3mm_D2.5mm_P7.62mm_Horizontal
R7, R8, R9, R11, R12, R13: 1K; R_Axial_DIN0207_L6.3mm_D2.5mm_P7.62mm_Horizontal
SW1: 1HZ; TS5 LED Momentary Click Tact Switch
SW2: 1KHZ; TS5 LED Momentary Click Tact Switch
SW3: XTAL; TS5 LED Momentary Click Tact Switch
SW5: EXT; TS5 LED Momentary Click Tact Switch
SW6: BREAK; TS5 LED Momentary Click Tact Switch
SW7: CLOCK_RESET; Slide Switch DPDT
SW8: HALF-STEP; TS5 LED Momentary Click Tact Switch
SW9: STEP; TS5 LED Momentary Click Tact Switch

Connections:
1Hz_in: C1.1, J2.4, SW1.1
1Hz_out: C1.2, J2.13, R1.1, SW1.2
1KHz_in: C2.1, J2.3, SW2.1
1KHz_out: C2.2, J2.14, R2.1, SW2.2
+5V: J2.1, J2.2, R6.2, R15.2, R21.2, SW6.4 (A)
GND: J1.1, J2.15, J2.16, J4.1, R1.2, R2.2, R3.2, R5.2, R7.2, R8.2, R9.2, R11.2, R13.2, SW8.2, SW9.2
unnamed: R7.1, SW1.3 (K)
unnamed: R8.1, SW2.3 (K)
unnamed: R9.1, SW3.3 (K)
unnamed: R11.1, SW5.3 (K)
unnamed: R12.1, SW6.3 (K)
unnamed: R13.1, SW8.3 (K)
break_in: J2.7, SW6.1
break_out: J2.10, R6.1, SW6.2
clock_1Khz: J3.4, SW2.4 (A)
clock_1hz: J3.2, SW1.4 (A)
clock_ext: J3.10, SW5.4 (A)
clock_out: J3.7, J4.2
clock_pulse: J3.9, SW8.4 (A)
clock_reset_in: J3.5, SW7.1 (A), SW7.6 (C)
clock_xtal1: J3.6, SW3.4 (A)
ext_in: C5.1, J2.8, SW5.1
ext_out: C5.2, J2.9, R5.1, SW5.2
half_step: J3.1, R15.1, SW8.1
signal_ext: J1.2, J3.11
step: J3.3, R21.1, SW9.1
xtal1_in: C3.1, J2.6, SW3.1
xtal1_out: C3.2, J2.11, R3.1, SW3.2, SW7.2 (B), SW7.5 (B)
~clock_stopped: J3.12, R12.2

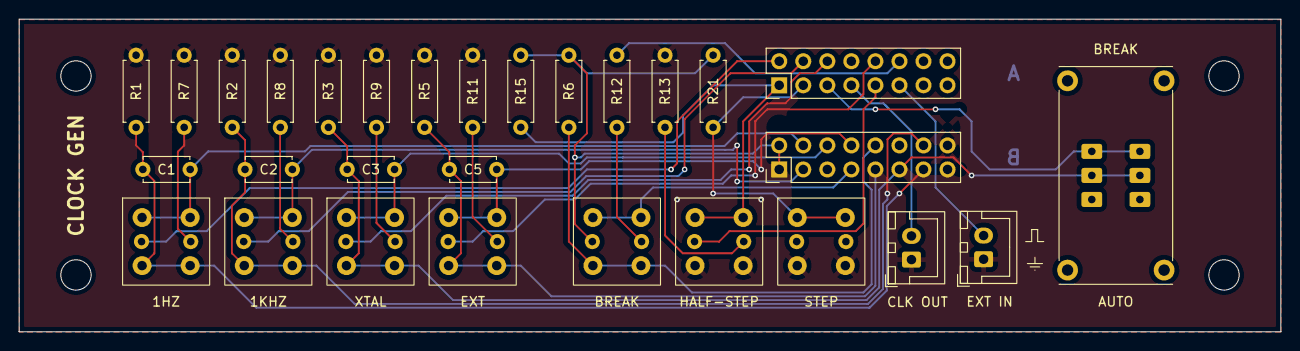
[picture p30: board clock-cpa.kicad_pcb from above]

Board: 2 copper layers, 133.3 x 33.0 mm, 29 parts (0 on the bottom side), 29 nets.
