rcapaverde/cubo/pcb_v2/cartridgea/cartridgea.kicad_pcb

## KiCad design pcb_v2/cartridgea/cartridgea.kicad_pcb (2026-05-15, an earlier design)

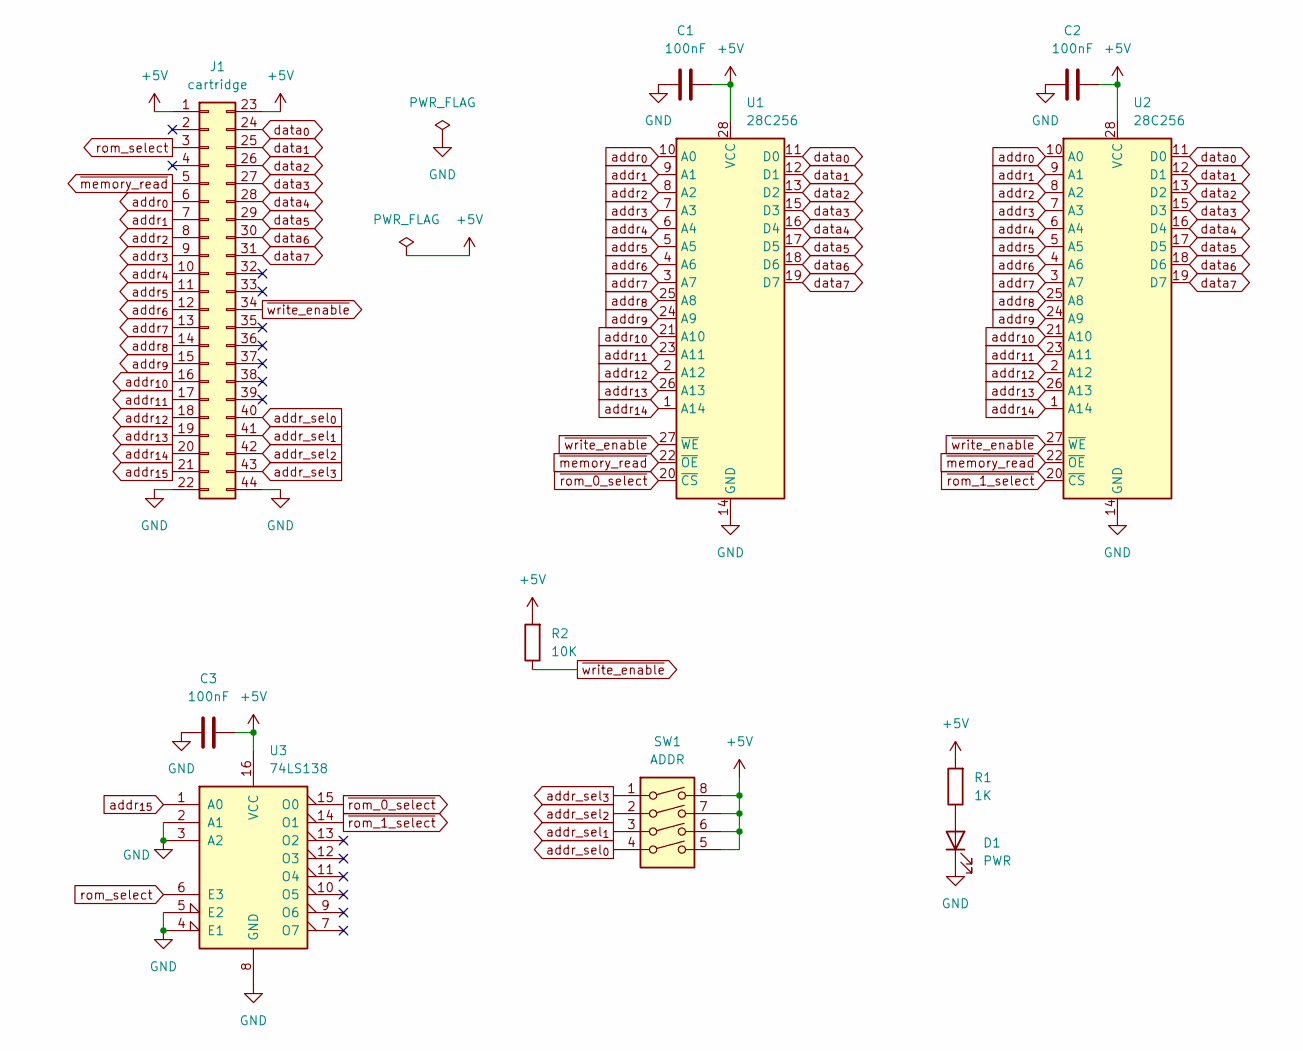
[picture p31: schematic cartridgea.kicad_sch]

Parts:
C1, C2, C3: 100nF; C_Disc_D5.1mm_W3.2mm_P5.00mm
D1: PWR; LED_D5.0mm
J1: cartridge; edge-connector-44
R1: 1K; R_Axial_DIN0207_L6.3mm_D2.5mm_P7.62mm_Horizontal
R2: 10K; R_Axial_DIN0207_L6.3mm_D2.5mm_P7.62mm_Horizontal
SW1: ADDR; DIP-8_W7.62mm
U1, U2: 28C256; DIP-28_W15.24mm
U3: 74LS138; DIP-16_W7.62mm

Connections:
+5V: C1.2, C2.2, C3.2, J1.1, J1.23, R1.2, R2.2, SW1.5, SW1.6, SW1.7, SW1.8, U1.28 (VCC), U2.28 (VCC), U3.16 (VCC)
GND: C1.1, C2.1, C3.1, D1.1 (K), J1.22, J1.44, U1.14 (GND), U2.14 (GND), U3.2 (A1), U3.3 (A2), U3.4 (E1), U3.5 (E2), U3.8 (GND)
unnamed: D1.2 (A), R1.1
addr_sel_{0}: J1.40, SW1.4
addr_sel_{1}: J1.41, SW1.3
addr_sel_{2}: J1.42, SW1.2
addr_sel_{3}: J1.43, SW1.1
addr_{0}: J1.6, U1.10 (A0), U2.10 (A0)
addr_{1}: J1.7, U1.9 (A1), U2.9 (A1)
addr_{2}: J1.8, U1.8 (A2), U2.8 (A2)
addr_{3}: J1.9, U1.7 (A3), U2.7 (A3)
addr_{4}: J1.10, U1.6 (A4), U2.6 (A4)
addr_{5}: J1.11, U1.5 (A5), U2.5 (A5)
addr_{6}: J1.12, U1.4 (A6), U2.4 (A6)
addr_{7}: J1.13, U1.3 (A7), U2.3 (A7)
addr_{8}: J1.14, U1.25 (A8), U2.25 (A8)
addr_{9}: J1.15, U1.24 (A9), U2.24 (A9)
addr_{10}: J1.16, U1.21 (A10), U2.21 (A10)
addr_{11}: J1.17, U1.23 (A11), U2.23 (A11)
addr_{12}: J1.18, U1.2 (A12), U2.2 (A12)
addr_{13}: J1.19, U1.26 (A13), U2.26 (A13)
addr_{14}: J1.20, U1.1 (A14), U2.1 (A14)
addr_{15}: J1.21, U3.1 (A0)
data_{0}: J1.24, U1.11 (D0), U2.11 (D0)
data_{1}: J1.25, U1.12 (D1), U2.12 (D1)
data_{2}: J1.26, U1.13 (D2), U2.13 (D2)
data_{3}: J1.27, U1.15 (D3), U2.15 (D3)
data_{4}: J1.28, U1.16 (D4), U2.16 (D4)
data_{5}: J1.29, U1.17 (D5), U2.17 (D5)
data_{6}: J1.30, U1.18 (D6), U2.18 (D6)
data_{7}: J1.31, U1.19 (D7), U2.19 (D7)
rom_select: J1.3, U3.6 (E3)
~memory_read: J1.5, U1.22 (~OE), U2.22 (~OE)
~rom_0_select: U1.20 (~CS), U3.15 (O0)
~rom_1_select: U2.20 (~CS), U3.14 (O1)
~write_enable: J1.34, R2.1, U1.27 (~WE), U2.27 (~WE)

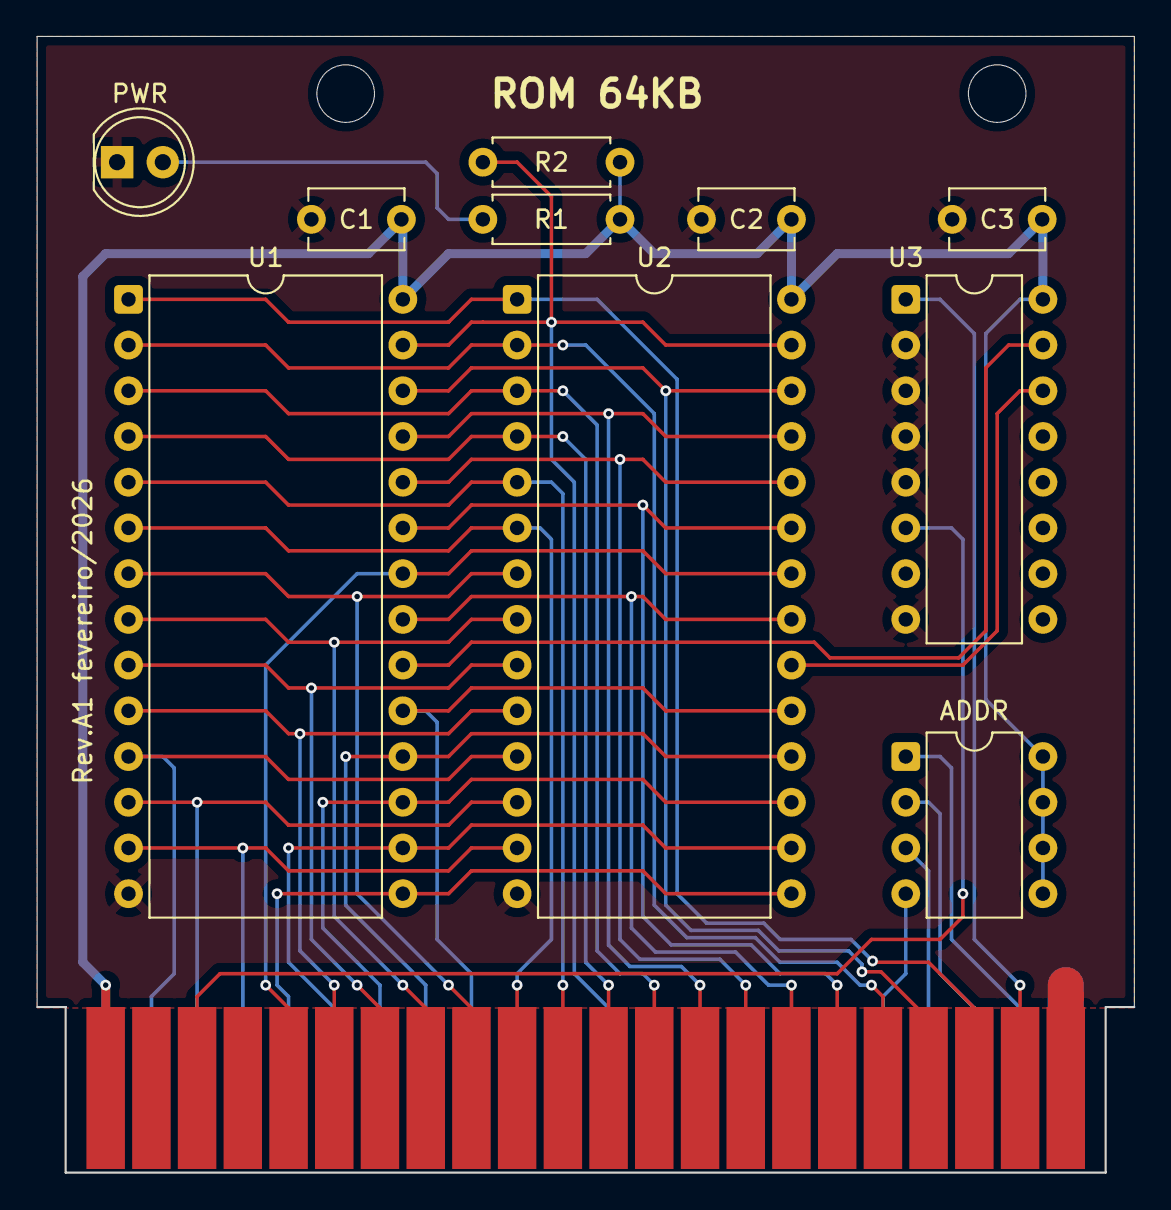
[picture p32: board cartridgea.kicad_pcb from above]

Board: 2 copper layers, 61.0 x 63.1 mm, 11 parts (0 on the bottom side), 36 nets.
