rcapaverde/cubo/pcb_v2/clocka/clocka.kicad_pcb

## KiCad design pcb_v2/clocka/clocka.kicad_pcb (2026-04-19, an earlier design)

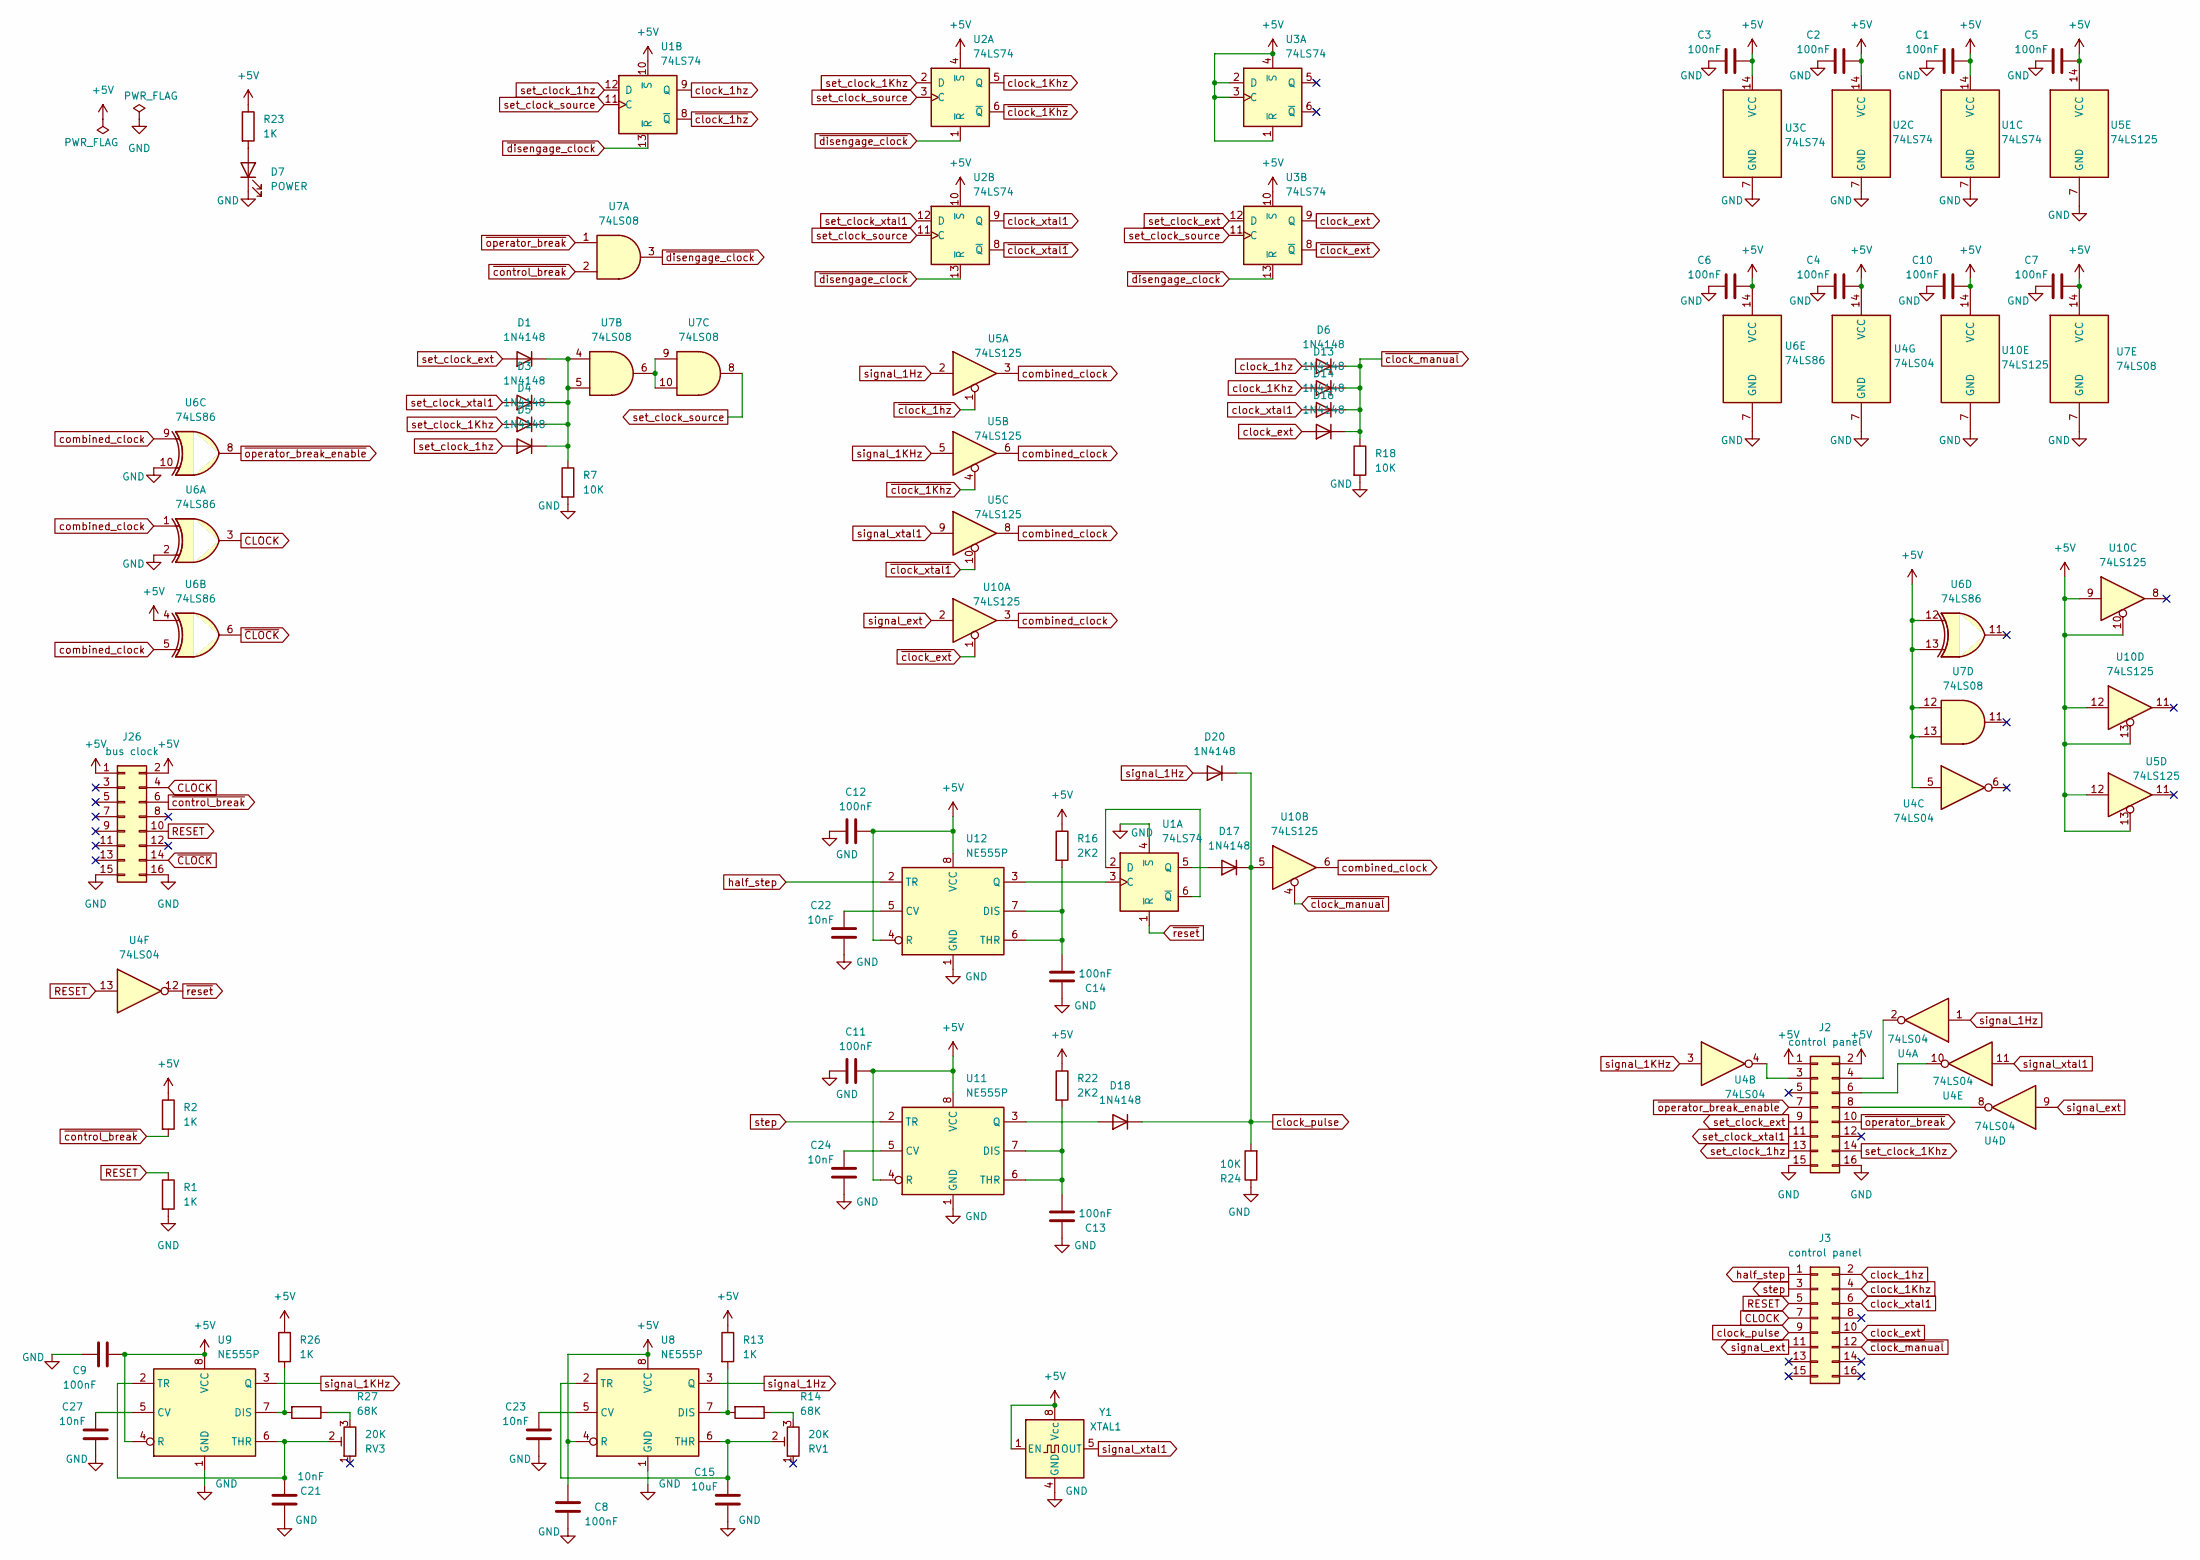
[picture p33: schematic clocka.kicad_sch]

Parts:
C1, C2, C3, C4, C5, C6, C7, C8, C9, C10, C11, C12, C13, C14: 100nF; C_Disc_D4.7mm_W2.5mm_P5.00mm
C15: 10uF; C_Disc_D4.7mm_W2.5mm_P5.00mm
C21, C22, C23, C24, C27: 10nF; C_Disc_D4.7mm_W2.5mm_P5.00mm
D1, D3, D4, D5, D6, D13, D14, D16, D17, D18, D20: 1N4148; D_DO-35_SOD27_P7.62mm_Horizontal
D7: POWER; LED_D5.0mm
J2, J3: control panel; PinHeader_2x08_P2.54mm_Vertical
J26: bus clock; PinHeader_2x08_P2.54mm_Vertical
R1, R2, R13, R23, R26: 1K; R_Axial_DIN0207_L6.3mm_D2.5mm_P7.62mm_Horizontal
R7, R18, R24: 10K; R_Axial_DIN0207_L6.3mm_D2.5mm_P7.62mm_Horizontal
R14, R27: 68K; R_Axial_DIN0207_L6.3mm_D2.5mm_P7.62mm_Horizontal
R16, R22: 2K2; R_Axial_DIN0207_L6.3mm_D2.5mm_P7.62mm_Horizontal
RV1, RV3: 20K; Potentiometer_ACP_CA9-H5_Horizontal
U1, U2, U3: 74LS74; DIP-14_W7.62mm
U4: 74LS04; DIP-14_W7.62mm
U5, U10: 74LS125; DIP-14_W7.62mm
U6: 74LS86; DIP-14_W7.62mm
U7: 74LS08; DIP-14_W7.62mm
U8, U9, U11, U12: NE555P; DIP-8_W7.62mm
Y1: XTAL1; Oscillator_DIP-8

Connections:
+5V: C1.2, C2.2, C3.2, C4.2, C5.2, C6.2, C7.2, C8.1, C9.1, C10.2, C11.2, C12.2, J2.1, J2.2, J26.1, J26.2, R2.1, R13.1, R16.1, R22.1, R23.1, R26.1, U1.10 (~S), U1.14 (VCC), U2.4 (~S), U2.10 (~S), U2.14 (VCC), U3.1 (~R), U3.2 (D), U3.3 (C), U3.4 (~S), U3.10 (~S), U3.14 (VCC), U4.5, U4.14 (VCC), U5.12, U5.13, U5.14 (VCC), U6.4, U6.12, U6.13, U6.14 (VCC), U7.12, U7.13, U7.14 (VCC), U8.4 (R), U8.8 (VCC), U9.4 (R), U9.8 (VCC), U10.9, U10.10, U10.12, U10.13, U10.14 (VCC), U11.4 (R), U11.8 (VCC), U12.4 (R), U12.8 (VCC), Y1.1 (EN), Y1.8 (Vcc)
CLOCK: J3.7, J26.4, U6.3
GND: C1.1, C2.1, C3.1, C4.1, C5.1, C6.1, C7.1, C8.2, C9.2, C10.1, C11.1, C12.1, C13.1, C14.1, C15.1, C21.1, C22.1, C23.1, C24.1, C27.1, D7.1 (K), J2.15, J2.16, J26.15, J26.16, R1.2, R7.2, R18.2, R24.1, U1.4 (~S), U1.7 (GND), U2.7 (GND), U3.7 (GND), U4.7 (GND), U5.7 (GND), U6.2, U6.7 (GND), U6.10, U7.7 (GND), U8.1 (GND), U9.1 (GND), U10.7 (GND), U11.1 (GND), U12.1 (GND), Y1.4 (GND)
unnamed: D1.1 (K), D3.1 (K), D4.1 (K), D5.1 (K), R7.1, U7.4, U7.5
unnamed: D7.2 (A), R23.2
unnamed: D17.2 (A), U1.5 (Q)
unnamed: D18.2 (A), U11.3 (Q)
unnamed: J2.3, U4.4
unnamed: J2.4, U4.2
unnamed: J2.6, U4.10
unnamed: J2.8, U4.8
unnamed: R14.1, RV1.3
unnamed: R27.1, RV3.3
unnamed: U1.2 (D), U1.6 (~Q)
unnamed: U7.6, U7.9, U7.10
unnamed: C23.2, U8.5 (CV)
unnamed: R13.2, R14.2, U8.7 (DIS)
unnamed: C15.2, RV1.2, U8.2 (TR), U8.6 (THR)
unnamed: C27.2, U9.5 (CV)
unnamed: R26.2, R27.2, U9.7 (DIS)
unnamed: C21.2, RV3.2, U9.2 (TR), U9.6 (THR)
unnamed: C24.2, U11.5 (CV)
unnamed: C13.2, R22.2, U11.6 (THR), U11.7 (DIS)
unnamed: C22.2, U12.5 (CV)
unnamed: C14.2, R16.2, U12.6 (THR), U12.7 (DIS)
unnamed: U1.3 (C), U12.3 (Q)
RESET: J3.5, J26.10, R1.1, U4.13
clock_1Khz: D13.2 (A), J3.4, U2.5 (Q)
clock_1hz: D6.2 (A), J3.2, U1.9 (Q)
clock_ext: D16.2 (A), J3.10, U3.9 (Q)
clock_pulse: D17.1 (K), D18.1 (K), D20.1 (K), J3.9, R24.2, U10.5
clock_xtal1: D14.2 (A), J3.6, U2.9 (Q)
combined_clock: U5.3, U5.6, U5.8, U6.1, U6.5, U6.9, U10.3, U10.6
half_step: J3.1, U12.2 (TR)
set_clock_1Khz: D4.2 (A), J2.14, U2.2 (D)
set_clock_1hz: D5.2 (A), J2.13, U1.12 (D)
set_clock_ext: D1.2 (A), J2.9, U3.12 (D)
set_clock_source: U1.11 (C), U2.3 (C), U2.11 (C), U3.11 (C), U7.8
set_clock_xtal1: D3.2 (A), J2.11, U2.12 (D)
signal_1Hz: D20.2 (A), U4.1, U5.2, U8.3 (Q)
signal_1KHz: U4.3, U5.5, U9.3 (Q)
signal_ext: J3.11, U4.9, U10.2
signal_xtal1: U4.11, U5.9, Y1.5 (OUT)
step: J3.3, U11.2 (TR)
~CLOCK: J26.14, U6.6
~clock_1Khz: U2.6 (~Q), U5.4
~clock_1hz: U1.8 (~Q), U5.1
~clock_ext: U3.8 (~Q), U10.1
~clock_manual: D6.1 (K), D13.1 (K), D14.1 (K), D16.1 (K), J3.12, R18.1, U10.4
~clock_xtal1: U2.8 (~Q), U5.10
~control_break: J26.6, R2.2, U7.2
~disengage_clock: U1.13 (~R), U2.1 (~R), U2.13 (~R), U3.13 (~R), U7.3
~operator_break_enable: J2.7, U6.8
~operator_break: J2.10, U7.1
~reset: U1.1 (~R), U4.12

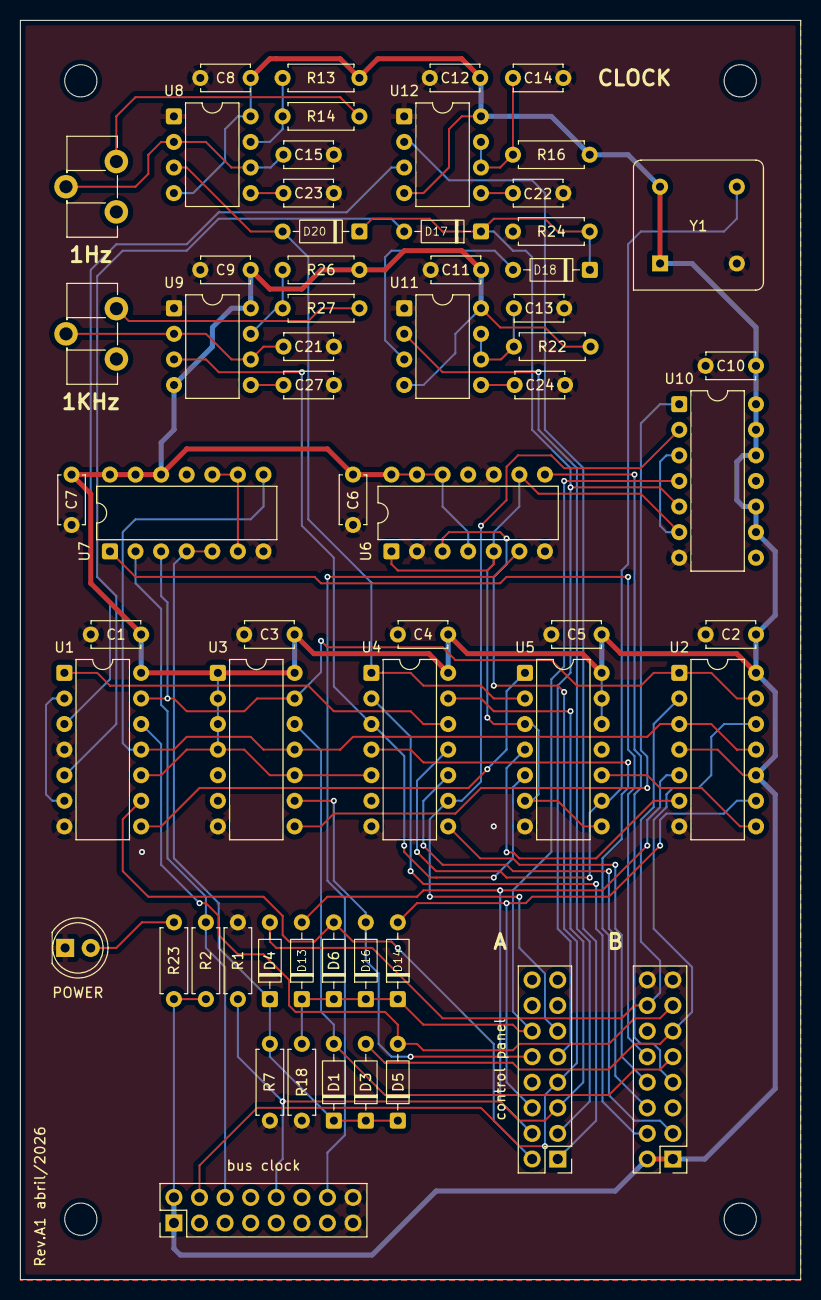
[picture p34: board clocka.kicad_pcb from above]

Board: 2 copper layers, 77.5 x 125.0 mm, 62 parts (0 on the bottom side), 55 nets.
