rcapaverde/cubo/pcb_v2/sr16a/sr16a.kicad_pcb

## KiCad design pcb_v2/sr16a/sr16a.kicad_pcb (2026-04-14, an earlier design)

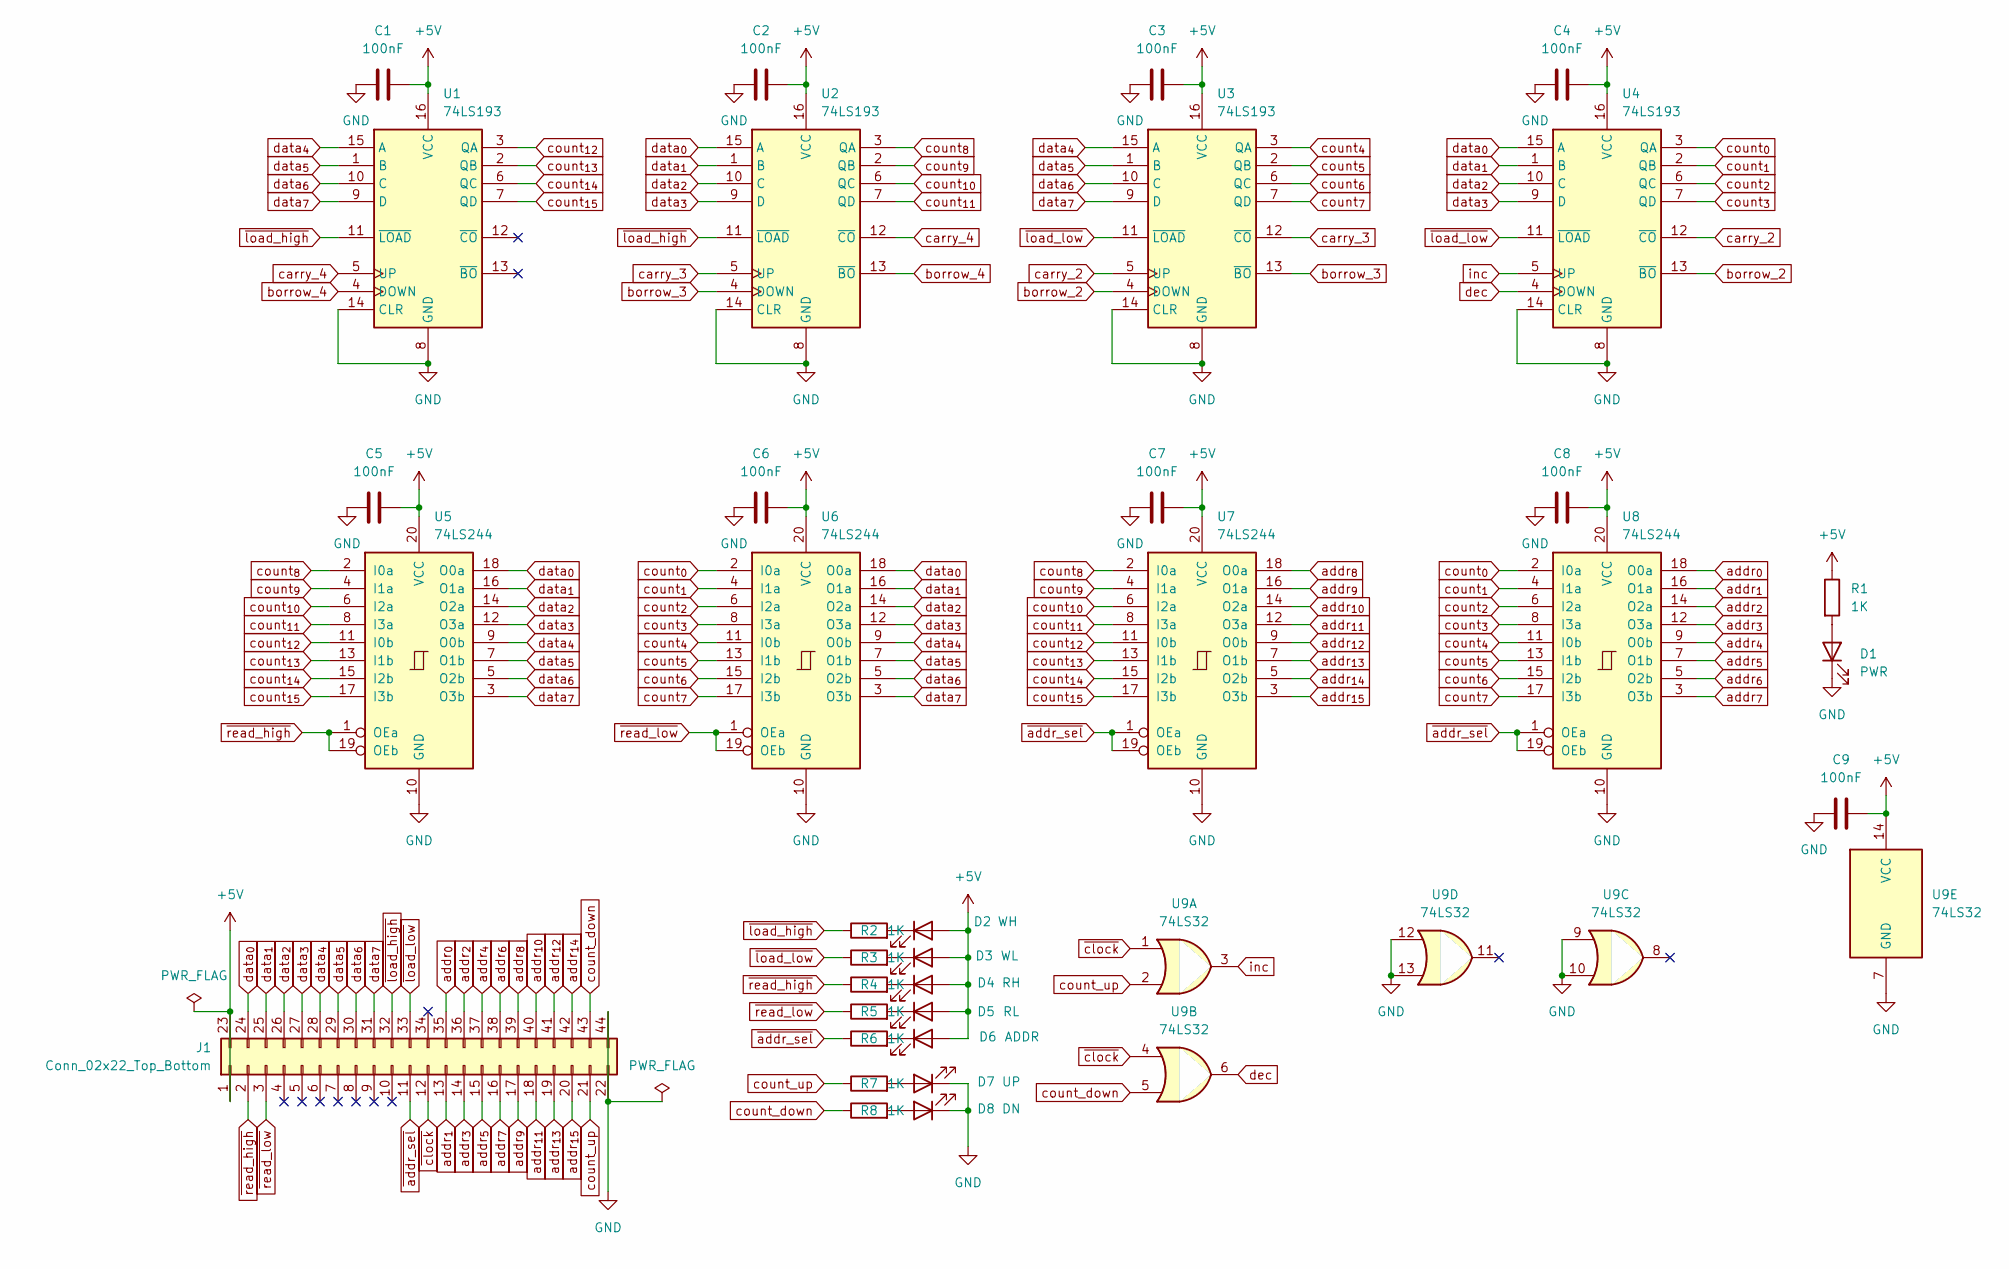
[picture p35: schematic sr16a.kicad_sch]

Parts:
C1, C2, C3, C4, C5, C6, C7, C8, C9: 100nF; C_Disc_D5.1mm_W3.2mm_P5.00mm
D1: PWR; LED_D5.0mm
D2: WH; LED_D5.0mm
D3: WL; LED_D5.0mm
D4: RH; LED_D5.0mm
D5: RL; LED_D5.0mm
D6: ADDR; LED_D5.0mm
D7: UP; LED_D5.0mm
D8: DN; LED_D5.0mm
J1: Conn_02x22_Top_Bottom; edge-connector-44
R1, R2, R3, R4, R5, R6, R7, R8: 1K; R_Axial_DIN0204_L3.6mm_D1.6mm_P7.62mm_Horizontal
U1, U2, U3, U4: 74LS193; DIP-16_W7.62mm
U5, U6, U7, U8: 74LS244; DIP-20_W7.62mm
U9: 74LS32; DIP-14_W7.62mm

Connections:
+5V: C1.2, C2.2, C3.2, C4.2, C5.2, C6.2, C7.2, C8.2, C9.2, D2.2 (A), D3.2 (A), D4.2 (A), D5.2 (A), D6.2 (A), J1.1, J1.23, R1.1, U1.16 (VCC), U2.16 (VCC), U3.16 (VCC), U4.16 (VCC), U5.20 (VCC), U6.20 (VCC), U7.20 (VCC), U8.20 (VCC), U9.14 (VCC)
GND: C1.1, C2.1, C3.1, C4.1, C5.1, C6.1, C7.1, C8.1, C9.1, D1.1 (K), D7.1 (K), D8.1 (K), J1.22, J1.44, U1.8 (GND), U1.14 (CLR), U2.8 (GND), U2.14 (CLR), U3.8 (GND), U3.14 (CLR), U4.8 (GND), U4.14 (CLR), U5.10 (GND), U6.10 (GND), U7.10 (GND), U8.10 (GND), U9.7 (GND), U9.9, U9.10, U9.12, U9.13
unnamed: D1.2 (A), R1.2
unnamed: D2.1 (K), R2.2
unnamed: D3.1 (K), R3.2
unnamed: D4.1 (K), R4.2
unnamed: D5.1 (K), R5.2
unnamed: D6.1 (K), R6.2
unnamed: D7.2 (A), R7.2
unnamed: D8.2 (A), R8.2
addr_{0}: J1.35, U8.18 (O0a)
addr_{1}: J1.13, U8.16 (O1a)
addr_{2}: J1.36, U8.14 (O2a)
addr_{3}: J1.14, U8.12 (O3a)
addr_{4}: J1.37, U8.9 (O0b)
addr_{5}: J1.15, U8.7 (O1b)
addr_{6}: J1.38, U8.5 (O2b)
addr_{7}: J1.16, U8.3 (O3b)
addr_{8}: J1.39, U7.18 (O0a)
addr_{9}: J1.17, U7.16 (O1a)
addr_{10}: J1.40, U7.14 (O2a)
addr_{11}: J1.18, U7.12 (O3a)
addr_{12}: J1.41, U7.9 (O0b)
addr_{13}: J1.19, U7.7 (O1b)
addr_{14}: J1.42, U7.5 (O2b)
addr_{15}: J1.20, U7.3 (O3b)
borrow_2: U3.4 (DOWN), U4.13 (~BO)
borrow_3: U2.4 (DOWN), U3.13 (~BO)
borrow_4: U1.4 (DOWN), U2.13 (~BO)
carry_2: U3.5 (UP), U4.12 (~CO)
carry_3: U2.5 (UP), U3.12 (~CO)
carry_4: U1.5 (UP), U2.12 (~CO)
count_down: J1.43, R8.1, U9.5
count_up: J1.21, R7.1, U9.2
count_{0}: U4.3 (QA), U6.2 (I0a), U8.2 (I0a)
count_{1}: U4.2 (QB), U6.4 (I1a), U8.4 (I1a)
count_{2}: U4.6 (QC), U6.6 (I2a), U8.6 (I2a)
count_{3}: U4.7 (QD), U6.8 (I3a), U8.8 (I3a)
count_{4}: U3.3 (QA), U6.11 (I0b), U8.11 (I0b)
count_{5}: U3.2 (QB), U6.13 (I1b), U8.13 (I1b)
count_{6}: U3.6 (QC), U6.15 (I2b), U8.15 (I2b)
count_{7}: U3.7 (QD), U6.17 (I3b), U8.17 (I3b)
count_{8}: U2.3 (QA), U5.2 (I0a), U7.2 (I0a)
count_{9}: U2.2 (QB), U5.4 (I1a), U7.4 (I1a)
count_{10}: U2.6 (QC), U5.6 (I2a), U7.6 (I2a)
count_{11}: U2.7 (QD), U5.8 (I3a), U7.8 (I3a)
count_{12}: U1.3 (QA), U5.11 (I0b), U7.11 (I0b)
count_{13}: U1.2 (QB), U5.13 (I1b), U7.13 (I1b)
count_{14}: U1.6 (QC), U5.15 (I2b), U7.15 (I2b)
count_{15}: U1.7 (QD), U5.17 (I3b), U7.17 (I3b)
data_{0}: J1.24, U2.15 (A), U4.15 (A), U5.18 (O0a), U6.18 (O0a)
data_{1}: J1.25, U2.1 (B), U4.1 (B), U5.16 (O1a), U6.16 (O1a)
data_{2}: J1.26, U2.10 (C), U4.10 (C), U5.14 (O2a), U6.14 (O2a)
data_{3}: J1.27, U2.9 (D), U4.9 (D), U5.12 (O3a), U6.12 (O3a)
data_{4}: J1.28, U1.15 (A), U3.15 (A), U5.9 (O0b), U6.9 (O0b)
data_{5}: J1.29, U1.1 (B), U3.1 (B), U5.7 (O1b), U6.7 (O1b)
data_{6}: J1.30, U1.10 (C), U3.10 (C), U5.5 (O2b), U6.5 (O2b)
data_{7}: J1.31, U1.9 (D), U3.9 (D), U5.3 (O3b), U6.3 (O3b)
dec: U4.4 (DOWN), U9.6
inc: U4.5 (UP), U9.3
~addr_sel: J1.11, R6.1, U7.1 (OEa), U7.19 (OEb), U8.1 (OEa), U8.19 (OEb)
~clock: J1.12, U9.1, U9.4
~load_high: J1.32, R2.1, U1.11 (~LOAD), U2.11 (~LOAD)
~load_low: J1.33, R3.1, U3.11 (~LOAD), U4.11 (~LOAD)
~read_high: J1.2, R4.1, U5.1 (OEa), U5.19 (OEb)
~read_low: J1.3, R5.1, U6.1 (OEa), U6.19 (OEb)

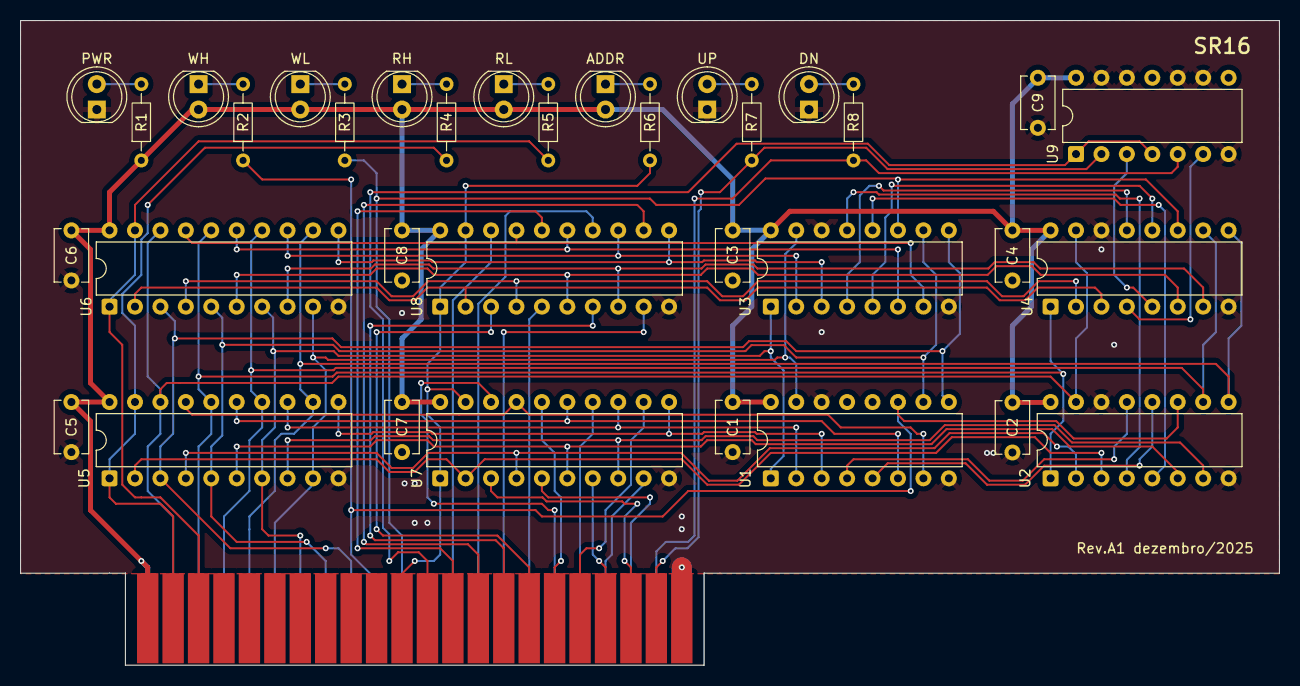
[picture p36: board sr16a.kicad_pcb from above]

Board: 2 copper layers, 125.7 x 64.4 mm, 35 parts (0 on the bottom side), 66 nets.
