rcapaverde/cubo/pcb_v2/rom-writer/rom-writer.kicad_pcb

## KiCad design pcb_v2/rom-writer/rom-writer.kicad_pcb (2026-02-16, an earlier design)

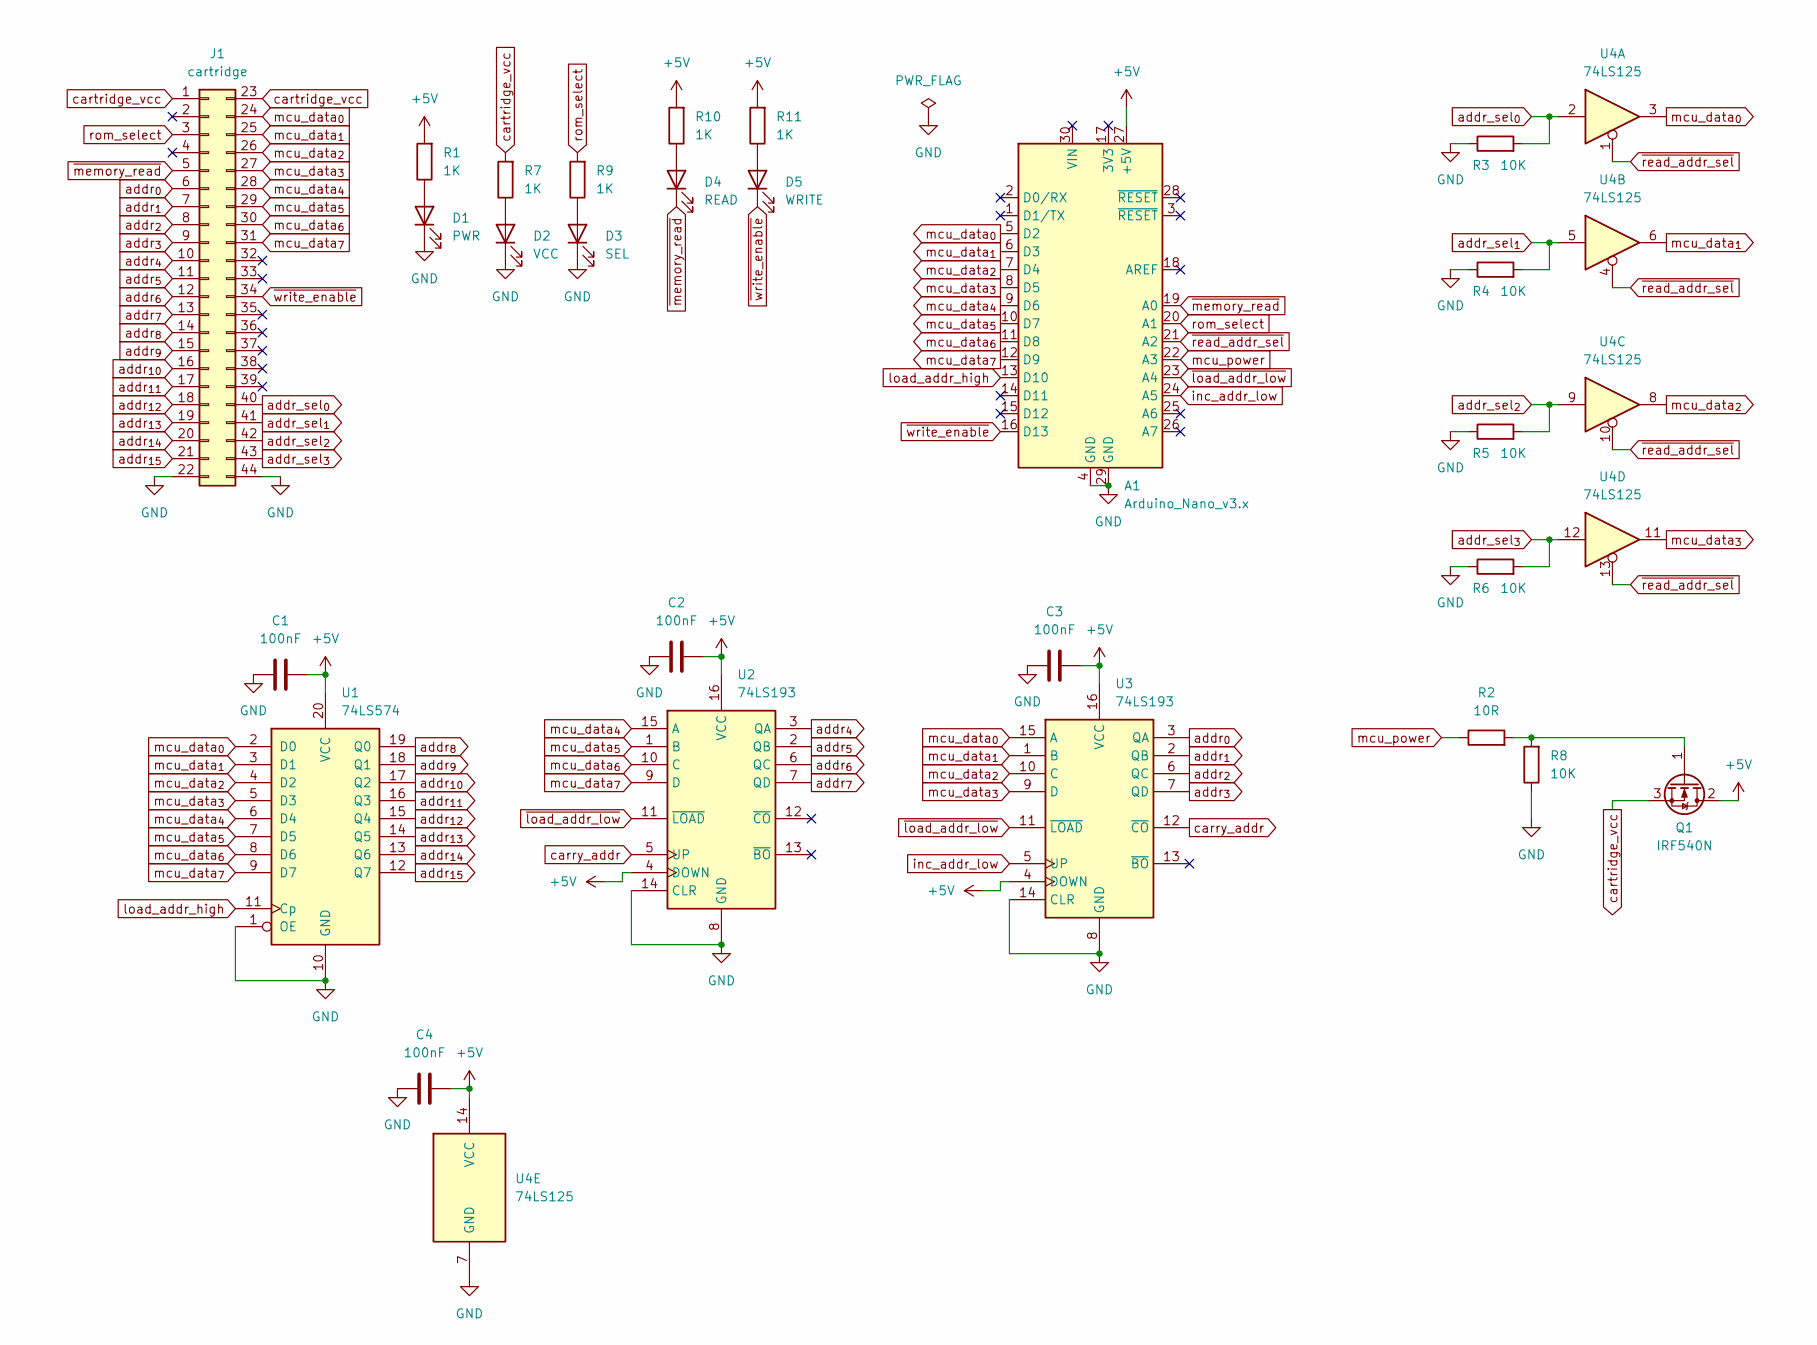
[picture p37: schematic rom-writer.kicad_sch]

Parts:
A1: Arduino_Nano_v3.x; Arduino_Nano
C1, C2, C3, C4: 100nF; C_Disc_D5.1mm_W3.2mm_P5.00mm
D1: PWR; LED_D5.0mm
D2: VCC; LED_D5.0mm
D3: SEL; LED_D5.0mm
D4: READ; LED_D5.0mm
D5: WRITE; LED_D5.0mm
J1: cartridge; male-edge-connector-44
Q1: IRF540N; TO-220-3_Vertical
R1, R7, R9, R10, R11: 1K; R_Axial_DIN0207_L6.3mm_D2.5mm_P7.62mm_Horizontal
R2: 10R; R_Axial_DIN0207_L6.3mm_D2.5mm_P7.62mm_Horizontal
R3, R4, R5, R6, R8: 10K; R_Axial_DIN0207_L6.3mm_D2.5mm_P7.62mm_Horizontal
U1: 74LS574; DIP-20_W7.62mm
U2, U3: 74LS193; DIP-16_W7.62mm
U4: 74LS125; DIP-14_W7.62mm

Connections:
+5V: A1.27 (+5V), C1.2, C2.2, C3.2, C4.2, Q1.2 (D), R1.2, R10.2, R11.2, U1.20 (VCC), U2.4 (DOWN), U2.16 (VCC), U3.4 (DOWN), U3.16 (VCC), U4.14 (VCC)
GND: A1.4 (GND), A1.29 (GND), C1.1, C2.1, C3.1, C4.1, D1.1 (K), D2.1 (K), D3.1 (K), J1.22, J1.44, R3.1, R4.1, R5.1, R6.1, R8.1, U1.1 (OE), U1.10 (GND), U2.8 (GND), U2.14 (CLR), U3.8 (GND), U3.14 (CLR), U4.7 (GND)
unnamed: D1.2 (A), R1.1
unnamed: D2.2 (A), R7.1
unnamed: D3.2 (A), R9.1
unnamed: D4.2 (A), R10.1
unnamed: D5.2 (A), R11.1
unnamed: Q1.1 (G), R2.2, R8.2
addr_sel_{0}: J1.40, R3.2, U4.2
addr_sel_{1}: J1.41, R4.2, U4.5
addr_sel_{2}: J1.42, R5.2, U4.9
addr_sel_{3}: J1.43, R6.2, U4.12
addr_{0}: J1.6, U3.3 (QA)
addr_{1}: J1.7, U3.2 (QB)
addr_{2}: J1.8, U3.6 (QC)
addr_{3}: J1.9, U3.7 (QD)
addr_{4}: J1.10, U2.3 (QA)
addr_{5}: J1.11, U2.2 (QB)
addr_{6}: J1.12, U2.6 (QC)
addr_{7}: J1.13, U2.7 (QD)
addr_{8}: J1.14, U1.19 (Q0)
addr_{9}: J1.15, U1.18 (Q1)
addr_{10}: J1.16, U1.17 (Q2)
addr_{11}: J1.17, U1.16 (Q3)
addr_{12}: J1.18, U1.15 (Q4)
addr_{13}: J1.19, U1.14 (Q5)
addr_{14}: J1.20, U1.13 (Q6)
addr_{15}: J1.21, U1.12 (Q7)
carry_addr: U2.5 (UP), U3.12 (~CO)
cartridge_vcc: J1.1, J1.23, Q1.3 (S), R7.2
inc_addr_low: A1.24 (A5), U3.5 (UP)
load_addr_high: A1.13 (D10), U1.11 (Cp)
mcu_data_{0}: A1.5 (D2), J1.24, U1.2 (D0), U3.15 (A), U4.3
mcu_data_{1}: A1.6 (D3), J1.25, U1.3 (D1), U3.1 (B), U4.6
mcu_data_{2}: A1.7 (D4), J1.26, U1.4 (D2), U3.10 (C), U4.8
mcu_data_{3}: A1.8 (D5), J1.27, U1.5 (D3), U3.9 (D), U4.11
mcu_data_{4}: A1.9 (D6), J1.28, U1.6 (D4), U2.15 (A)
mcu_data_{5}: A1.10 (D7), J1.29, U1.7 (D5), U2.1 (B)
mcu_data_{6}: A1.11 (D8), J1.30, U1.8 (D6), U2.10 (C)
mcu_data_{7}: A1.12 (D9), J1.31, U1.9 (D7), U2.9 (D)
mcu_power: A1.22 (A3), R2.1
rom_select: A1.20 (A1), J1.3, R9.2
~load_addr_low: A1.23 (A4), U2.11 (~LOAD), U3.11 (~LOAD)
~memory_read: A1.19 (A0), D4.1 (K), J1.5
~read_addr_sel: A1.21 (A2), U4.1, U4.4, U4.10, U4.13
~write_enable: A1.16 (D13), D5.1 (K), J1.34

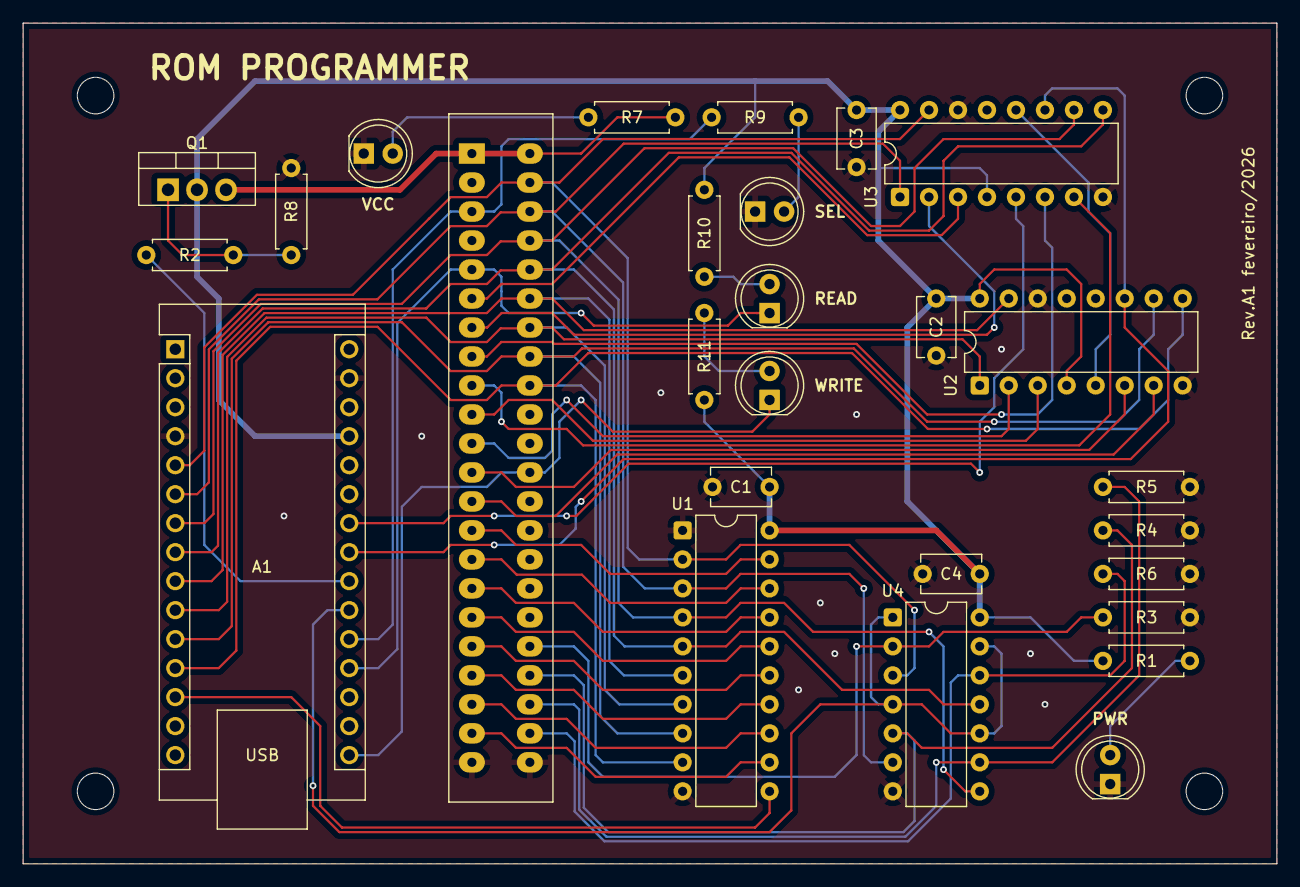
[picture p38: board rom-writer.kicad_pcb from above]

Board: 2 copper layers, 109.9 x 73.7 mm, 27 parts (0 on the bottom side), 46 nets.
