rcapaverde/cubo/pcb_v2/testbench/testbench.kicad_pcb

## KiCad design pcb_v2/testbench/testbench.kicad_pcb (2026-02-14, an earlier design)

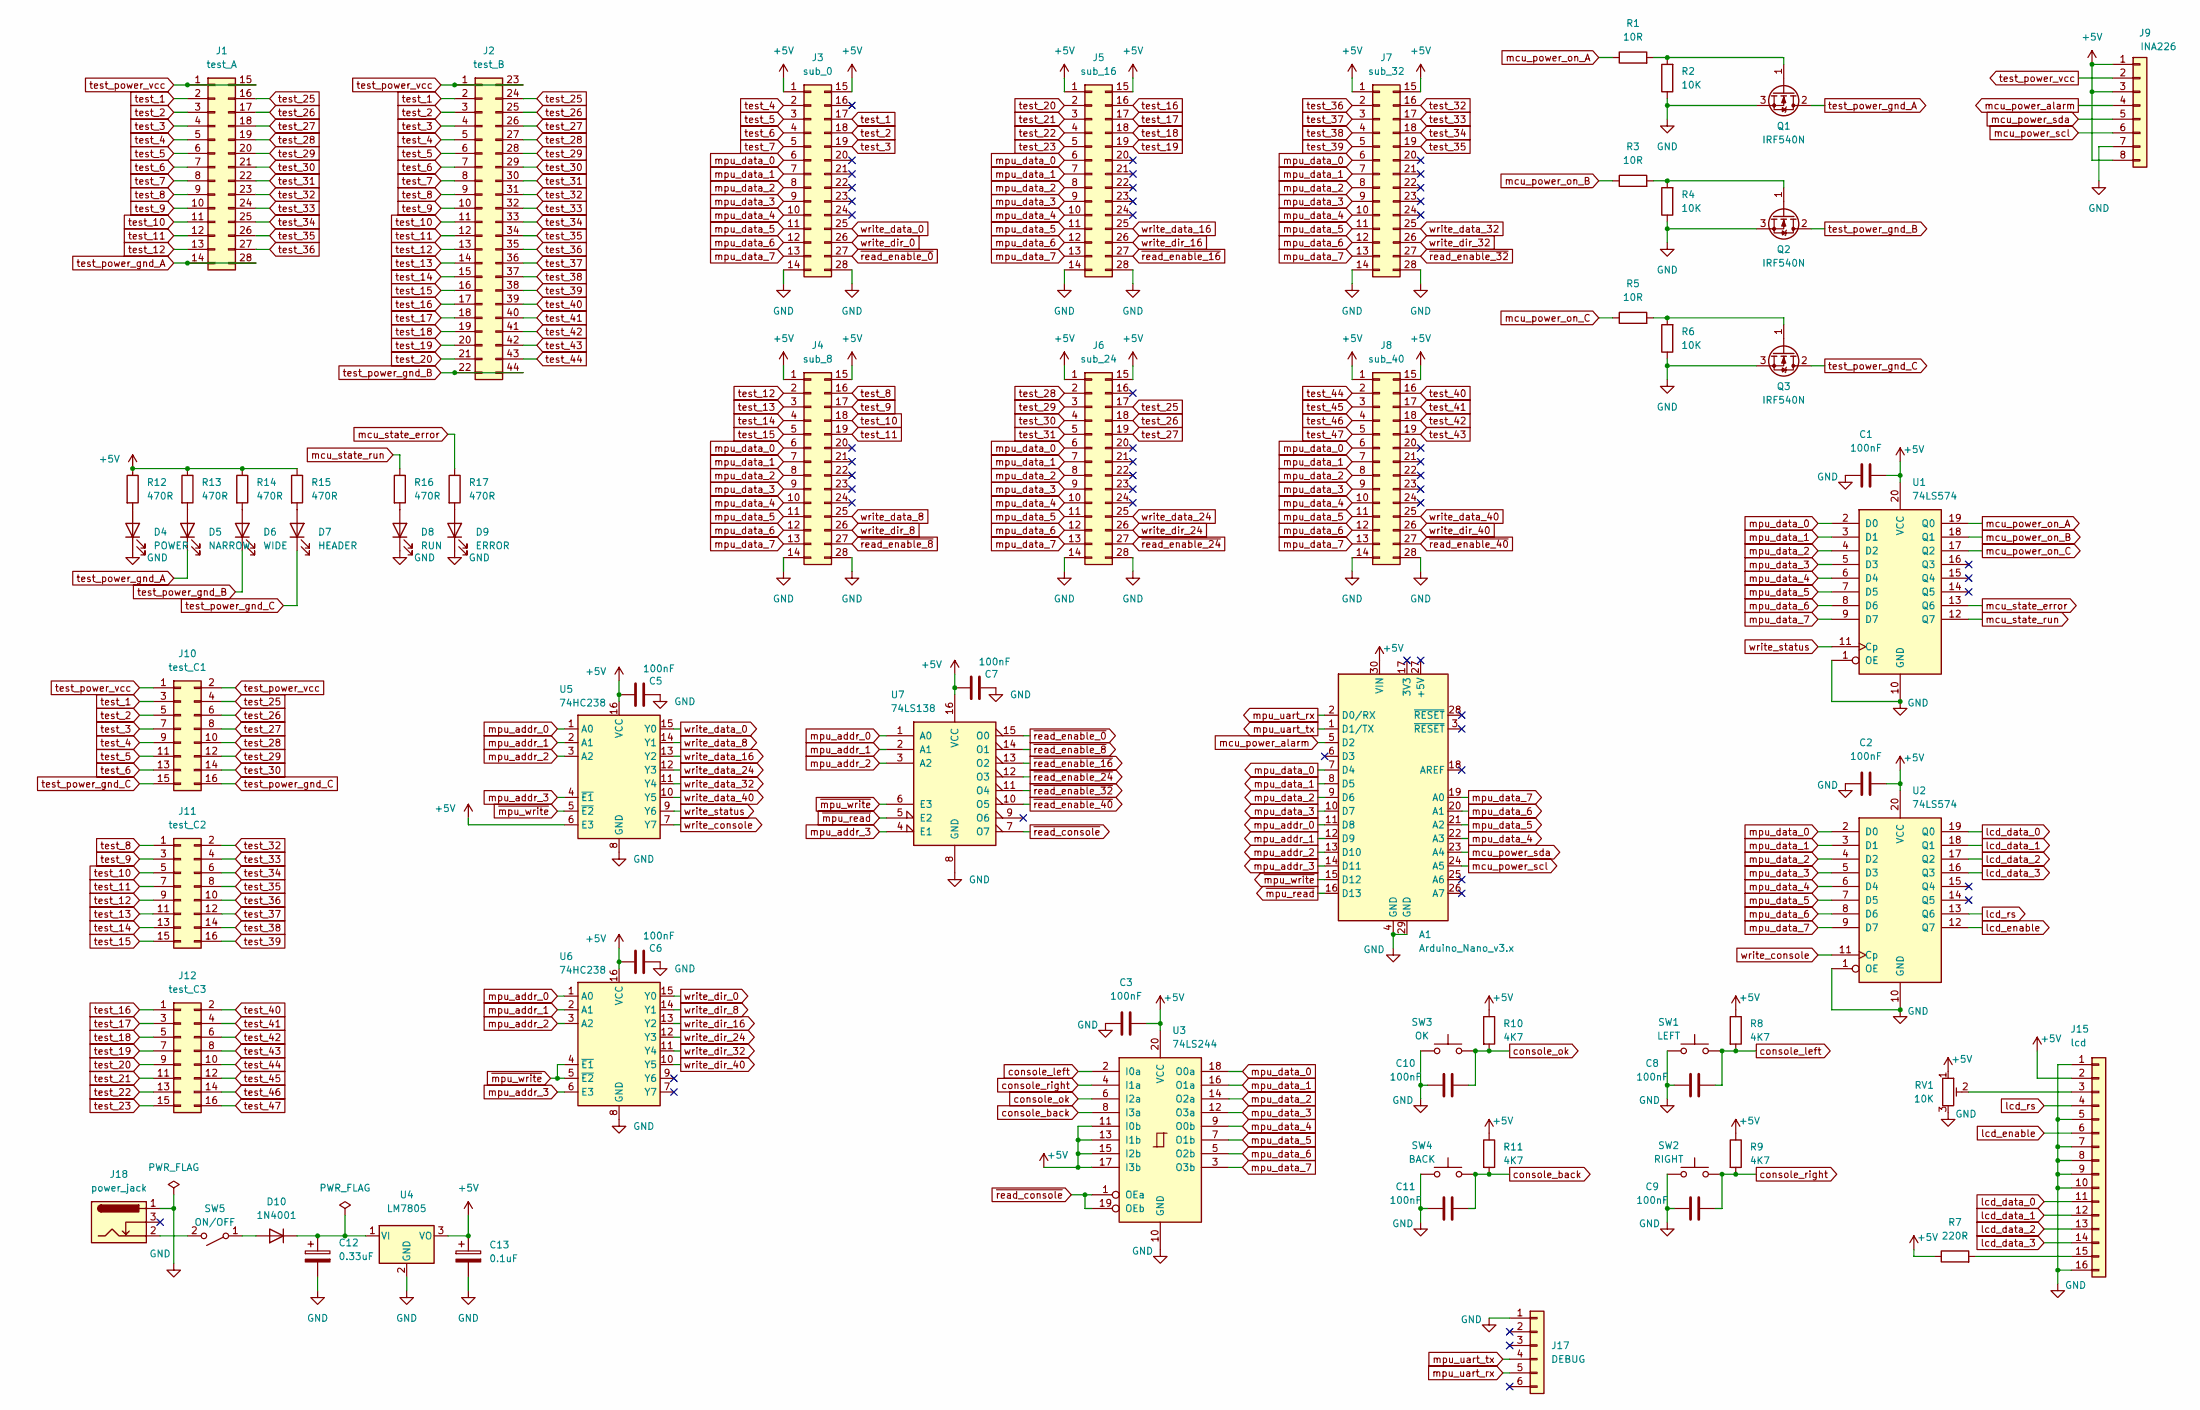
[picture p39: schematic testbench.kicad_sch]

Parts:
A1: Arduino_Nano_v3.x; Arduino_Nano
C1, C2, C3, C5, C6, C7, C8, C9, C10, C11: 100nF; C_Disc_D4.7mm_W2.5mm_P5.00mm
C12: 0.33uF; CP_Radial_D5.0mm_P2.50mm
C13: 0.1uF; CP_Radial_D5.0mm_P2.50mm
D4: POWER; LED_D5.0mm
D5: NARROW; LED_D5.0mm
D6: WIDE; LED_D5.0mm
D7: HEADER; LED_D5.0mm
D8: RUN; LED_D5.0mm
D9: ERROR; LED_D5.0mm
D10: 1N4001; D_DO-41_SOD81_P10.16mm_Horizontal
J1: test_A; male-edge-connector-28
J2: test_B; male-edge-connector-44
J3: sub_0; male-edge-connector-28
J4: sub_8; male-edge-connector-28
J5: sub_16; male-edge-connector-28
J6: sub_24; male-edge-connector-28
J7: sub_32; male-edge-connector-28
J8: sub_40; male-edge-connector-28
J9: INA226; PinSocket_1x08_P2.54mm_Vertical
J10: test_C1; PinHeader_2x08_P2.54mm_Vertical
J11: test_C2; PinHeader_2x08_P2.54mm_Vertical
J12: test_C3; PinHeader_2x08_P2.54mm_Vertical
J15: lcd; PinSocket_1x16_P2.54mm_Vertical
J17: DEBUG; PinSocket_1x06_P2.54mm_Vertical
J18: power_jack; BarrelJack_Horizontal
Q1, Q2, Q3: IRF540N; TO-220-3_Vertical
R1, R3, R5: 10R; R_Axial_DIN0207_L6.3mm_D2.5mm_P7.62mm_Horizontal
R2, R4, R6: 10K; R_Axial_DIN0207_L6.3mm_D2.5mm_P7.62mm_Horizontal
R7: 220R; R_Axial_DIN0207_L6.3mm_D2.5mm_P7.62mm_Horizontal
R8, R9, R10, R11: 4K7; R_Axial_DIN0207_L6.3mm_D2.5mm_P7.62mm_Horizontal
R12, R13, R14, R15, R16, R17: 470R; R_Axial_DIN0207_L6.3mm_D2.5mm_P7.62mm_Horizontal
RV1: 10K; Potentiometer_ACP_CA9-H5_Horizontal
SW1: LEFT; SW_PUSH_6mm
SW2: RIGHT; SW_PUSH_6mm
SW3: OK; SW_PUSH_6mm
SW4: BACK; SW_PUSH_6mm
SW5: ON/OFF; jrx
U1, U2: 74LS574; DIP-20_W7.62mm
U3: 74LS244; DIP-20_W7.62mm
U4: LM7805; TO-220-3_Vertical
U5, U6: 74HC238; DIP-16_W7.62mm
U7: 74LS138; DIP-16_W7.62mm

Connections:
+5V: A1.30 (VIN), C1.2, C2.2, C3.2, C5.2, C6.2, C7.2, C13.1, J3.1, J3.15, J4.1, J4.15, J5.1, J5.15, J6.1, J6.15, J7.1, J7.15, J8.1, J8.15, J9.1, J9.3, J9.8, J15.2, R7.1, R8.1, R9.1, R10.1, R11.1, R12.1, R13.1, R14.1, R15.1, RV1.1, U1.20 (VCC), U2.20 (VCC), U3.11 (I0b), U3.13 (I1b), U3.15 (I2b), U3.17 (I3b), U3.20 (VCC), U4.3 (VO), U5.6 (E3), U5.16 (VCC), U6.16 (VCC), U7.16 (VCC)
GND: A1.4 (GND), A1.29 (GND), C1.1, C2.1, C3.1, C5.1, C6.1, C7.1, C8.1, C9.1, C10.1, C11.1, C12.2, C13.2, D4.1 (K), D8.1 (K), D9.1 (K), J3.14, J3.28, J4.14, J4.28, J5.14, J5.28, J6.14, J6.28, J7.14, J7.28, J8.14, J8.28, J9.7, J15.1, J15.5, J15.7, J15.8, J15.9, J15.10, J15.16, J17.1, J18.1, Q1.3 (S), Q2.3 (S), Q3.3 (S), R2.1, R4.1, R6.1, RV1.3, SW1.1, SW2.1, SW3.1, SW4.1, U1.1 (OE), U1.10 (GND), U2.1 (OE), U2.10 (GND), U3.10 (GND), U4.2 (GND), U5.8 (GND), U6.8 (GND), U7.8 (GND)
unnamed: D4.2 (A), R12.2
unnamed: D5.2 (A), R13.2
unnamed: D6.2 (A), R14.2
unnamed: D7.2 (A), R15.2
unnamed: D8.2 (A), R16.2
unnamed: D9.2 (A), R17.2
unnamed: D10.2 (A), SW5.1 (A)
unnamed: C12.1, D10.1 (K), U4.1 (VI)
unnamed: J15.3, RV1.2
unnamed: J15.15, R7.2
unnamed: Q1.1 (G), R1.2, R2.2
unnamed: Q2.1 (G), R3.2, R4.2
unnamed: Q3.1 (G), R5.2, R6.2
unnamed: J18.2, SW5.2 (B)
console_back: C11.2, R11.2, SW4.2, U3.8 (I3a)
console_left: C8.2, R8.2, SW1.2, U3.2 (I0a)
console_ok: C10.2, R10.2, SW3.2, U3.6 (I2a)
console_right: C9.2, R9.2, SW2.2, U3.4 (I1a)
lcd_data_0: J15.11, U2.19 (Q0)
lcd_data_1: J15.12, U2.18 (Q1)
lcd_data_2: J15.13, U2.17 (Q2)
lcd_data_3: J15.14, U2.16 (Q3)
lcd_enable: J15.6, U2.12 (Q7)
lcd_rs: J15.4, U2.13 (Q6)
mcu_power_alarm: A1.5 (D2), J9.4
mcu_power_on_A: R1.1, U1.19 (Q0)
mcu_power_on_B: R3.1, U1.18 (Q1)
mcu_power_on_C: R5.1, U1.17 (Q2)
mcu_power_scl: A1.24 (A5), J9.6
mcu_power_sda: A1.23 (A4), J9.5
mcu_state_error: R17.1, U1.13 (Q6)
mcu_state_run: R16.1, U1.12 (Q7)
mpu_addr_0: A1.11 (D8), U5.1 (A0), U6.1 (A0), U7.1 (A0)
mpu_addr_1: A1.12 (D9), U5.2 (A1), U6.2 (A1), U7.2 (A1)
mpu_addr_2: A1.13 (D10), U5.3 (A2), U6.3 (A2), U7.3 (A2)
mpu_addr_3: A1.14 (D11), U5.4 (~E1), U6.6 (E3), U7.4 (E1)
mpu_data_0: A1.7 (D4), J3.6, J4.6, J5.6, J6.6, J7.6, J8.6, U1.2 (D0), U2.2 (D0), U3.18 (O0a)
mpu_data_1: A1.8 (D5), J3.7, J4.7, J5.7, J6.7, J7.7, J8.7, U1.3 (D1), U2.3 (D1), U3.16 (O1a)
mpu_data_2: A1.9 (D6), J3.8, J4.8, J5.8, J6.8, J7.8, J8.8, U1.4 (D2), U2.4 (D2), U3.14 (O2a)
mpu_data_3: A1.10 (D7), J3.9, J4.9, J5.9, J6.9, J7.9, J8.9, U1.5 (D3), U2.5 (D3), U3.12 (O3a)
mpu_data_4: A1.22 (A3), J3.10, J4.10, J5.10, J6.10, J7.10, J8.10, U1.6 (D4), U2.6 (D4), U3.9 (O0b)
mpu_data_5: A1.21 (A2), J3.11, J4.11, J5.11, J6.11, J7.11, J8.11, U1.7 (D5), U2.7 (D5), U3.7 (O1b)
mpu_data_6: A1.20 (A1), J3.12, J4.12, J5.12, J6.12, J7.12, J8.12, U1.8 (D6), U2.8 (D6), U3.5 (O2b)
mpu_data_7: A1.19 (A0), J3.13, J4.13, J5.13, J6.13, J7.13, J8.13, U1.9 (D7), U2.9 (D7), U3.3 (O3b)
mpu_uart_rx: A1.2 (D0/RX), J17.5
mpu_uart_tx: A1.1 (D1/TX), J17.4
test_1: J1.2, J2.2, J3.17, J10.3
test_2: J1.3, J2.3, J3.18, J10.5
test_3: J1.4, J2.4, J3.19, J10.7
test_4: J1.5, J2.5, J3.2, J10.9
test_5: J1.6, J2.6, J3.3, J10.11
test_6: J1.7, J2.7, J3.4, J10.13
test_7: J1.8, J2.8, J3.5
test_8: J1.9, J2.9, J4.16, J11.1
test_9: J1.10, J2.10, J4.17, J11.3
test_10: J1.11, J2.11, J4.18, J11.5
test_11: J1.12, J2.12, J4.19, J11.7
test_12: J1.13, J2.13, J4.2, J11.9
test_13: J2.14, J4.3, J11.11
test_14: J2.15, J4.4, J11.13
test_15: J2.16, J4.5, J11.15
test_16: J2.17, J5.16, J12.1
test_17: J2.18, J5.17, J12.3
test_18: J2.19, J5.18, J12.5
test_19: J2.20, J5.19, J12.7
test_20: J2.21, J5.2, J12.9
test_21: J5.3, J12.11
test_22: J5.4, J12.13
test_23: J5.5, J12.15
test_25: J1.16, J2.24, J6.17, J10.4
test_26: J1.17, J2.25, J6.18, J10.6
test_27: J1.18, J2.26, J6.19, J10.8
test_28: J1.19, J2.27, J6.2, J10.10
test_29: J1.20, J2.28, J6.3, J10.12
test_30: J1.21, J2.29, J6.4, J10.14
test_31: J1.22, J2.30, J6.5
test_32: J1.23, J2.31, J7.16, J11.2
test_33: J1.24, J2.32, J7.17, J11.4
test_34: J1.25, J2.33, J7.18, J11.6
test_35: J1.26, J2.34, J7.19, J11.8
test_36: J1.27, J2.35, J7.2, J11.10
test_37: J2.36, J7.3, J11.12
test_38: J2.37, J7.4, J11.14
test_39: J2.38, J7.5, J11.16
test_40: J2.39, J8.16, J12.2
test_41: J2.40, J8.17, J12.4
test_42: J2.41, J8.18, J12.6
test_43: J2.42, J8.19, J12.8
test_44: J2.43, J8.2, J12.10
test_45: J8.3, J12.12
test_46: J8.4, J12.14
test_47: J8.5, J12.16
test_power_gnd_A: D5.1 (K), J1.14, J1.28, Q1.2 (D)
test_power_gnd_B: D6.1 (K), J2.22, J2.44, Q2.2 (D)
test_power_gnd_C: D7.1 (K), J10.15, J10.16, Q3.2 (D)
test_power_vcc: J1.1, J1.15, J2.1, J2.23, J9.2, J10.1, J10.2
write_console: U2.11 (Cp), U5.7 (Y7)
write_data_0: J3.25, U5.15 (Y0)
write_data_8: J4.25, U5.14 (Y1)
write_data_16: J5.25, U5.13 (Y2)
write_data_24: J6.25, U5.12 (Y3)
write_data_32: J7.25, U5.11 (Y4)
write_data_40: J8.25, U5.10 (Y5)
write_dir_0: J3.26, U6.15 (Y0)
write_dir_8: J4.26, U6.14 (Y1)
write_dir_16: J5.26, U6.13 (Y2)
write_dir_24: J6.26, U6.12 (Y3)
write_dir_32: J7.26, U6.11 (Y4)
write_dir_40: J8.26, U6.10 (Y5)
write_status: U1.11 (Cp), U5.9 (Y6)
~mpu_read: A1.16 (D13), U7.5 (E2)
~mpu_write: A1.15 (D12), U5.5 (~E2), U6.4 (~E1), U6.5 (~E2), U7.6 (E3)
~read_console: U3.1 (OEa), U3.19 (OEb), U7.7 (O7)
~read_enable_0: J3.27, U7.15 (O0)
~read_enable_8: J4.27, U7.14 (O1)
~read_enable_16: J5.27, U7.13 (O2)
~read_enable_24: J6.27, U7.12 (O3)
~read_enable_32: J7.27, U7.11 (O4)
~read_enable_40: J8.27, U7.10 (O5)

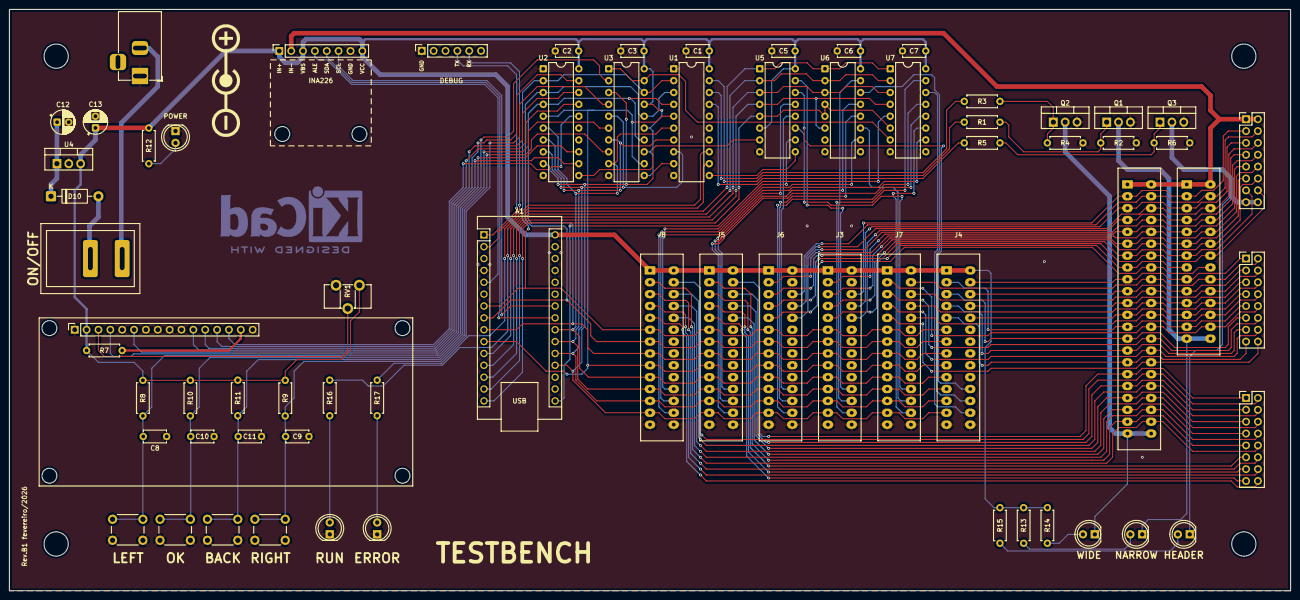
[picture p40: board testbench.kicad_pcb from above]

Board: 2 copper layers, 274.3 x 124.5 mm, 68 parts (0 on the bottom side), 121 nets.
