rcapaverde/cubo/pcb_v2/mgrfa/mgrfa.kicad_pcb

## KiCad design pcb_v2/mgrfa/mgrfa.kicad_pcb (2026-02-14, an earlier design)

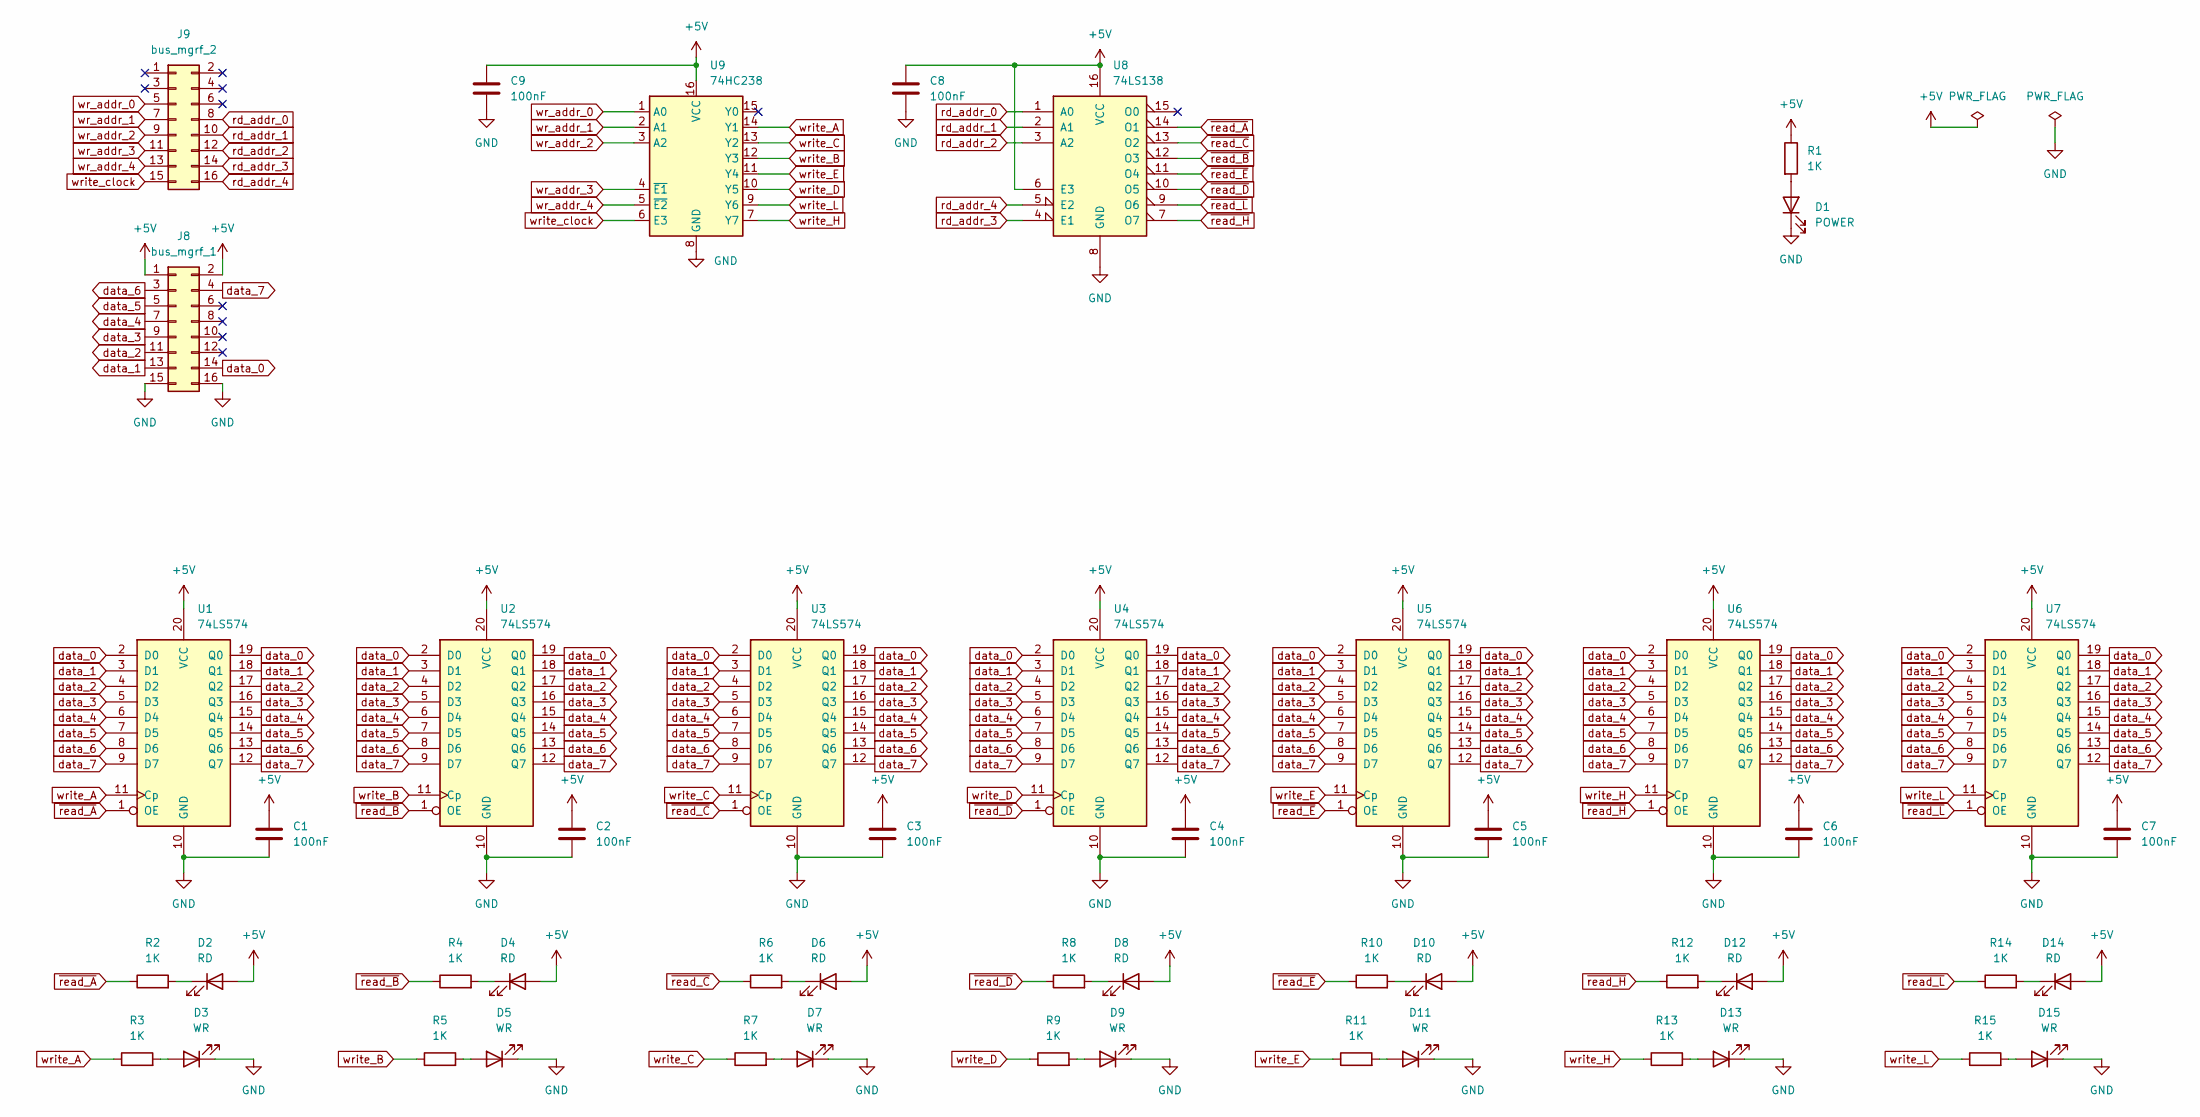
[picture p41: schematic mgrfa.kicad_sch]

Parts:
C1, C2, C3, C4, C5, C6, C7: 100nF; C_Disc_D5.1mm_W3.2mm_P5.00mm
C8, C9: 100nF; C_Disc_D4.7mm_W2.5mm_P5.00mm
D1: POWER; LED_D5.0mm
D2, D4, D6, D8, D10, D12, D14: RD; LED_D5.0mm
D3, D5, D7, D9, D11, D13, D15: WR; LED_D5.0mm
J8: bus_mgrf_1; PinHeader_2x08_P2.54mm_Vertical
J9: bus_mgrf_2; PinHeader_2x08_P2.54mm_Vertical
R1, R2, R3, R4, R5, R6, R7, R8, R9, R10, R11, R12, R13, R14, R15: 1K; R_Axial_DIN0207_L6.3mm_D2.5mm_P7.62mm_Horizontal
U1, U2, U3, U4, U5, U6, U7: 74LS574; DIP-20_W7.62mm
U8: 74LS138; DIP-16_W7.62mm
U9: 74HC238; DIP-16_W7.62mm

Connections:
+5V: C1.1, C2.1, C3.1, C4.1, C5.1, C6.1, C7.1, C8.1, C9.1, D2.2 (A), D4.2 (A), D6.2 (A), D8.2 (A), D10.2 (A), D12.2 (A), D14.2 (A), J8.1, J8.2, R1.1, U1.20 (VCC), U2.20 (VCC), U3.20 (VCC), U4.20 (VCC), U5.20 (VCC), U6.20 (VCC), U7.20 (VCC), U8.6 (E3), U8.16 (VCC), U9.16 (VCC)
GND: C1.2, C2.2, C3.2, C4.2, C5.2, C6.2, C7.2, C8.2, C9.2, D1.1 (K), D3.1 (K), D5.1 (K), D7.1 (K), D9.1 (K), D11.1 (K), D13.1 (K), D15.1 (K), J8.15, J8.16, U1.10 (GND), U2.10 (GND), U3.10 (GND), U4.10 (GND), U5.10 (GND), U6.10 (GND), U7.10 (GND), U8.8 (GND), U9.8 (GND)
unnamed: D1.2 (A), R1.2
unnamed: D2.1 (K), R2.2
unnamed: D3.2 (A), R3.2
unnamed: D4.1 (K), R4.2
unnamed: D5.2 (A), R5.2
unnamed: D6.1 (K), R6.2
unnamed: D7.2 (A), R7.2
unnamed: D8.1 (K), R8.2
unnamed: D9.2 (A), R9.2
unnamed: D10.1 (K), R10.2
unnamed: D11.2 (A), R11.2
unnamed: D12.1 (K), R12.2
unnamed: D13.2 (A), R13.2
unnamed: D14.1 (K), R14.2
unnamed: D15.2 (A), R15.2
data_0: J8.14, U1.2 (D0), U1.19 (Q0), U2.2 (D0), U2.19 (Q0), U3.2 (D0), U3.19 (Q0), U4.2 (D0), U4.19 (Q0), U5.2 (D0), U5.19 (Q0), U6.2 (D0), U6.19 (Q0), U7.2 (D0), U7.19 (Q0)
data_1: J8.13, U1.3 (D1), U1.18 (Q1), U2.3 (D1), U2.18 (Q1), U3.3 (D1), U3.18 (Q1), U4.3 (D1), U4.18 (Q1), U5.3 (D1), U5.18 (Q1), U6.3 (D1), U6.18 (Q1), U7.3 (D1), U7.18 (Q1)
data_2: J8.11, U1.4 (D2), U1.17 (Q2), U2.4 (D2), U2.17 (Q2), U3.4 (D2), U3.17 (Q2), U4.4 (D2), U4.17 (Q2), U5.4 (D2), U5.17 (Q2), U6.4 (D2), U6.17 (Q2), U7.4 (D2), U7.17 (Q2)
data_3: J8.9, U1.5 (D3), U1.16 (Q3), U2.5 (D3), U2.16 (Q3), U3.5 (D3), U3.16 (Q3), U4.5 (D3), U4.16 (Q3), U5.5 (D3), U5.16 (Q3), U6.5 (D3), U6.16 (Q3), U7.5 (D3), U7.16 (Q3)
data_4: J8.7, U1.6 (D4), U1.15 (Q4), U2.6 (D4), U2.15 (Q4), U3.6 (D4), U3.15 (Q4), U4.6 (D4), U4.15 (Q4), U5.6 (D4), U5.15 (Q4), U6.6 (D4), U6.15 (Q4), U7.6 (D4), U7.15 (Q4)
data_5: J8.5, U1.7 (D5), U1.14 (Q5), U2.7 (D5), U2.14 (Q5), U3.7 (D5), U3.14 (Q5), U4.7 (D5), U4.14 (Q5), U5.7 (D5), U5.14 (Q5), U6.7 (D5), U6.14 (Q5), U7.7 (D5), U7.14 (Q5)
data_6: J8.3, U1.8 (D6), U1.13 (Q6), U2.8 (D6), U2.13 (Q6), U3.8 (D6), U3.13 (Q6), U4.8 (D6), U4.13 (Q6), U5.8 (D6), U5.13 (Q6), U6.8 (D6), U6.13 (Q6), U7.8 (D6), U7.13 (Q6)
data_7: J8.4, U1.9 (D7), U1.12 (Q7), U2.9 (D7), U2.12 (Q7), U3.9 (D7), U3.12 (Q7), U4.9 (D7), U4.12 (Q7), U5.9 (D7), U5.12 (Q7), U6.9 (D7), U6.12 (Q7), U7.9 (D7), U7.12 (Q7)
rd_addr_0: J9.8, U8.1 (A0)
rd_addr_1: J9.10, U8.2 (A1)
rd_addr_2: J9.12, U8.3 (A2)
rd_addr_3: J9.14, U8.4 (E1)
rd_addr_4: J9.16, U8.5 (E2)
wr_addr_0: J9.5, U9.1 (A0)
wr_addr_1: J9.7, U9.2 (A1)
wr_addr_2: J9.9, U9.3 (A2)
wr_addr_3: J9.11, U9.4 (~E1)
wr_addr_4: J9.13, U9.5 (~E2)
write_A: R3.1, U1.11 (Cp), U9.14 (Y1)
write_B: R5.1, U2.11 (Cp), U9.12 (Y3)
write_C: R7.1, U3.11 (Cp), U9.13 (Y2)
write_D: R9.1, U4.11 (Cp), U9.10 (Y5)
write_E: R11.1, U5.11 (Cp), U9.11 (Y4)
write_H: R13.1, U6.11 (Cp), U9.7 (Y7)
write_L: R15.1, U7.11 (Cp), U9.9 (Y6)
write_clock: J9.15, U9.6 (E3)
~read_A: R2.1, U1.1 (OE), U8.14 (O1)
~read_B: R4.1, U2.1 (OE), U8.12 (O3)
~read_C: R6.1, U3.1 (OE), U8.13 (O2)
~read_D: R8.1, U4.1 (OE), U8.10 (O5)
~read_E: R10.1, U5.1 (OE), U8.11 (O4)
~read_H: R12.1, U6.1 (OE), U8.7 (O7)
~read_L: R14.1, U7.1 (OE), U8.9 (O6)

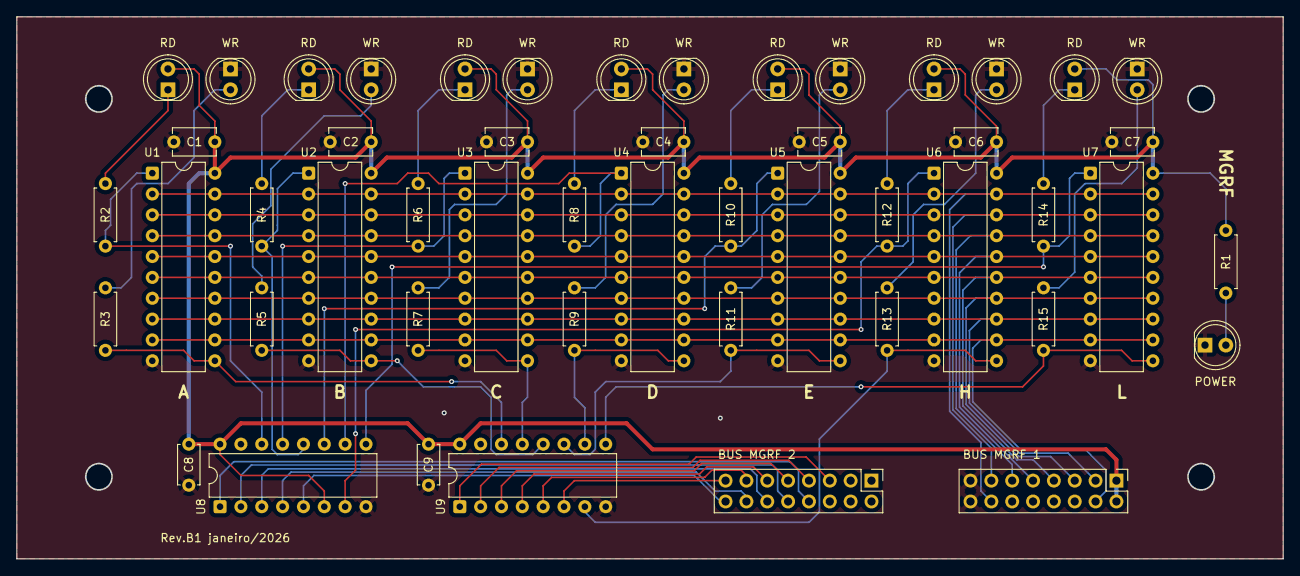
[picture p42: board mgrfa.kicad_pcb from above]

Board: 2 copper layers, 154.3 x 66.0 mm, 50 parts (0 on the bottom side), 50 nets.
