rcapaverde/cubo/pcb_v2/testbench-sub8/testbench-sub8.kicad_pcb

## KiCad design pcb_v2/testbench-sub8/testbench-sub8.kicad_pcb (2026-02-09, an earlier design)

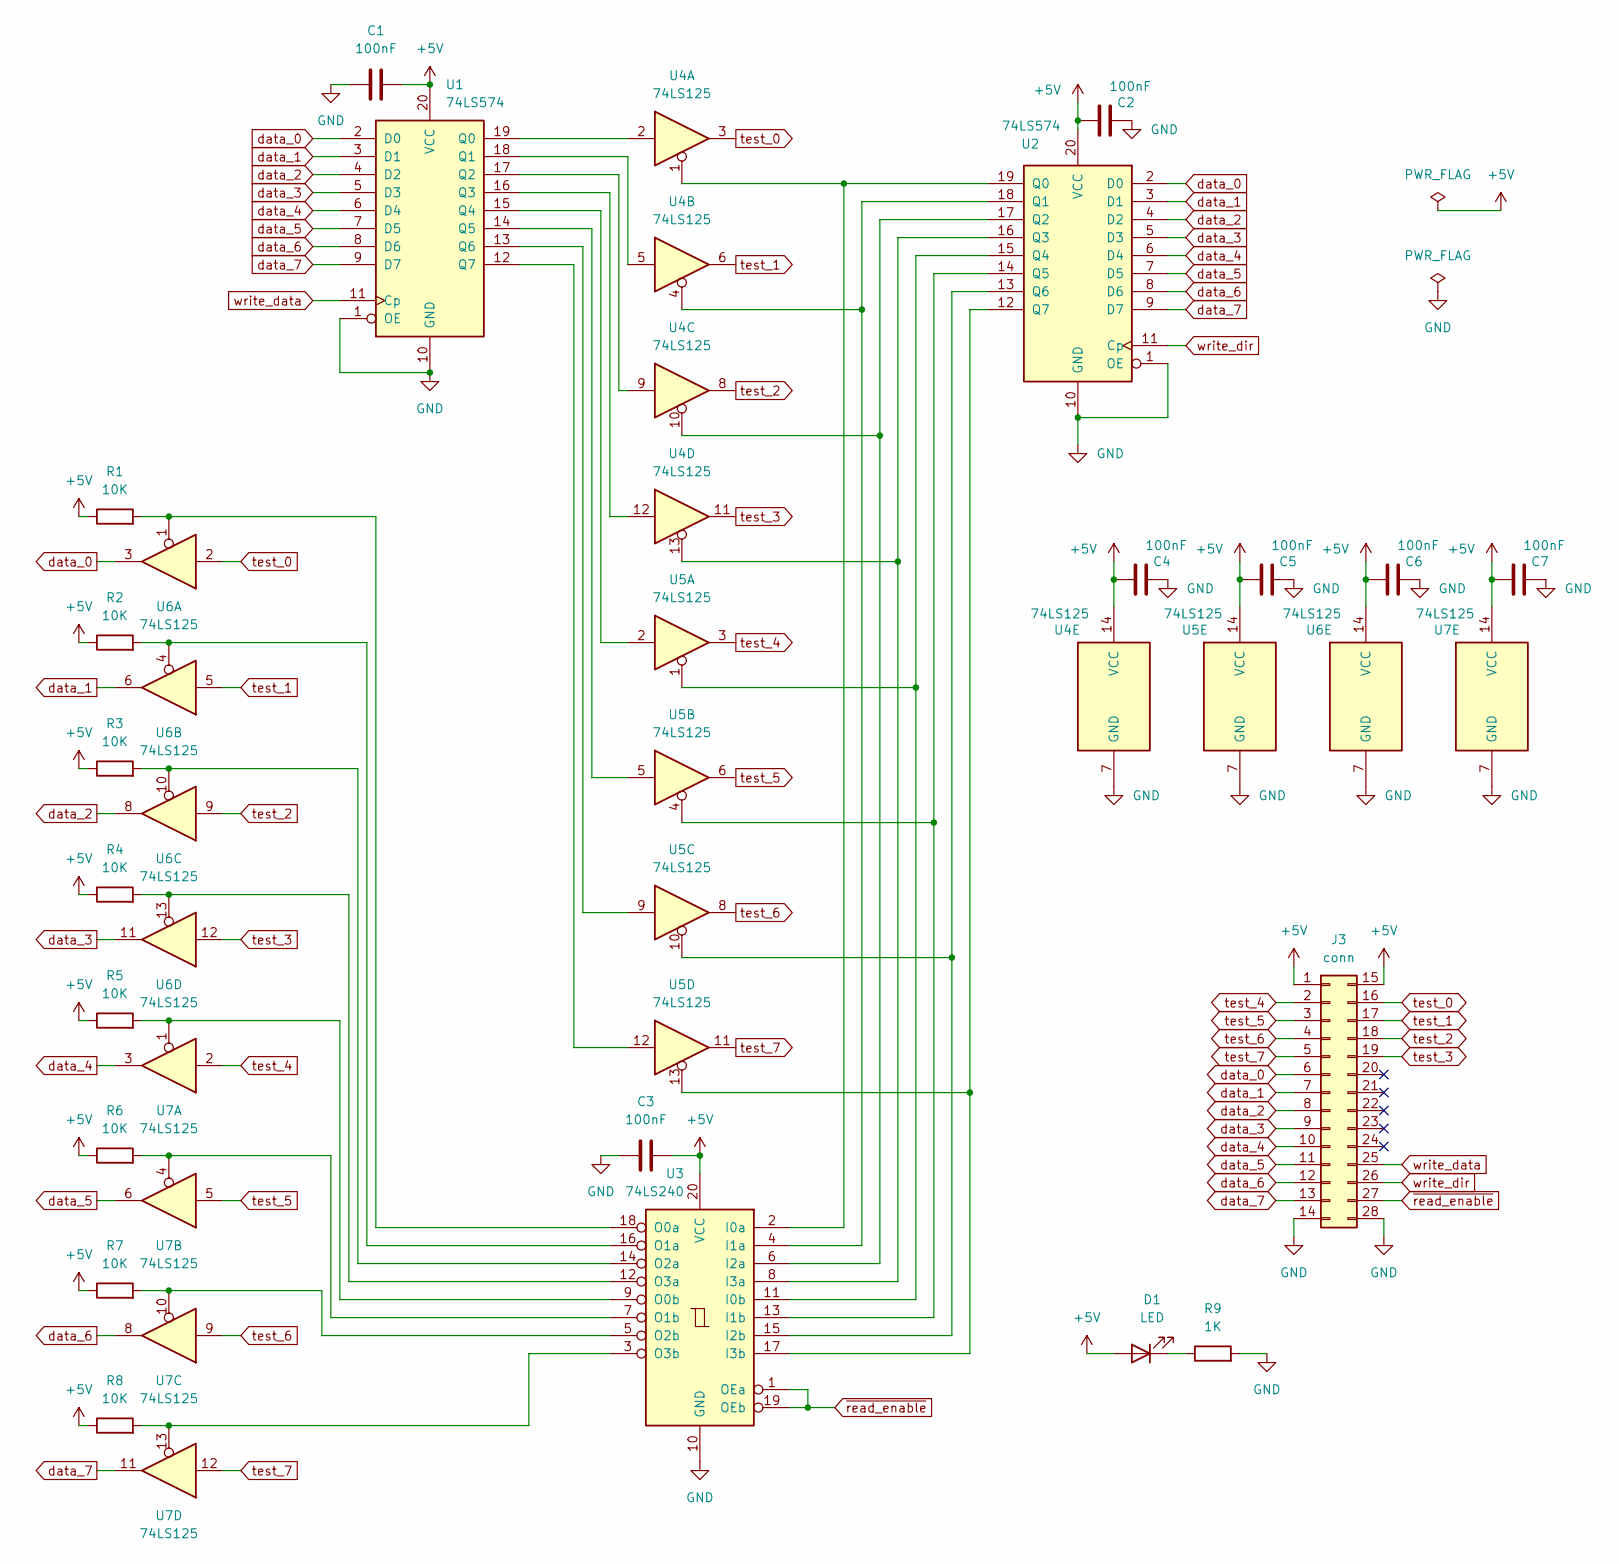
[picture p43: schematic testbench-sub8.kicad_sch]

Parts:
C1, C2, C3, C4, C5, C6, C7: 100nF; C_Disc_D4.7mm_W2.5mm_P5.00mm
D1: LED; LED_D5.0mm
J3: conn; edge-conector-14
R1, R2, R3, R4, R5, R6, R7, R8: 10K; R_Axial_DIN0204_L3.6mm_D1.6mm_P7.62mm_Horizontal
R9: 1K; R_Axial_DIN0204_L3.6mm_D1.6mm_P7.62mm_Horizontal
U1, U2: 74LS574; DIP-20_W7.62mm
U3: 74LS240; DIP-20_W7.62mm
U4, U5, U6, U7: 74LS125; DIP-14_W7.62mm

Connections:
+5V: C1.2, C2.2, C3.2, C4.2, C5.2, C6.2, C7.2, D1.2 (A), J3.1, J3.15, R1.1, R2.1, R3.1, R4.1, R5.1, R6.1, R7.1, R8.1, U1.20 (VCC), U2.20 (VCC), U3.20 (VCC), U4.14 (VCC), U5.14 (VCC), U6.14 (VCC), U7.14 (VCC)
GND: C1.1, C2.1, C3.1, C4.1, C5.1, C6.1, C7.1, J3.14, J3.28, R9.2, U1.1 (OE), U1.10 (GND), U2.1 (OE), U2.10 (GND), U3.10 (GND), U4.7 (GND), U5.7 (GND), U6.7 (GND), U7.7 (GND)
unnamed: D1.1 (K), R9.1
unnamed: U1.19 (Q0), U4.2
unnamed: U1.18 (Q1), U4.5
unnamed: U1.17 (Q2), U4.9
unnamed: U1.16 (Q3), U4.12
unnamed: U1.15 (Q4), U5.2
unnamed: U1.14 (Q5), U5.5
unnamed: U1.13 (Q6), U5.9
unnamed: U1.12 (Q7), U5.12
unnamed: U2.19 (Q0), U3.2 (I0a), U4.1
unnamed: U2.18 (Q1), U3.4 (I1a), U4.4
unnamed: U2.17 (Q2), U3.6 (I2a), U4.10
unnamed: U2.16 (Q3), U3.8 (I3a), U4.13
unnamed: U2.15 (Q4), U3.11 (I0b), U5.1
unnamed: U2.14 (Q5), U3.13 (I1b), U5.4
unnamed: U2.13 (Q6), U3.15 (I2b), U5.10
unnamed: U2.12 (Q7), U3.17 (I3b), U5.13
unnamed: R1.2, U3.18 (O0a), U6.1
unnamed: R5.2, U3.9 (O0b), U7.1
unnamed: R2.2, U3.16 (O1a), U6.4
unnamed: R6.2, U3.7 (O1b), U7.4
unnamed: R3.2, U3.14 (O2a), U6.10
unnamed: R7.2, U3.5 (O2b), U7.10
unnamed: R4.2, U3.12 (O3a), U6.13
unnamed: R8.2, U3.3 (O3b), U7.13
data_0: J3.6, U1.2 (D0), U2.2 (D0), U6.3
data_1: J3.7, U1.3 (D1), U2.3 (D1), U6.6
data_2: J3.8, U1.4 (D2), U2.4 (D2), U6.8
data_3: J3.9, U1.5 (D3), U2.5 (D3), U6.11
data_4: J3.10, U1.6 (D4), U2.6 (D4), U7.3
data_5: J3.11, U1.7 (D5), U2.7 (D5), U7.6
data_6: J3.12, U1.8 (D6), U2.8 (D6), U7.8
data_7: J3.13, U1.9 (D7), U2.9 (D7), U7.11
test_0: J3.16, U4.3, U6.2
test_1: J3.17, U4.6, U6.5
test_2: J3.18, U4.8, U6.9
test_3: J3.19, U4.11, U6.12
test_4: J3.2, U5.3, U7.2
test_5: J3.3, U5.6, U7.5
test_6: J3.4, U5.8, U7.9
test_7: J3.5, U5.11, U7.12
write_data: J3.25, U1.11 (Cp)
write_dir: J3.26, U2.11 (Cp)
~read_enable: J3.27, U3.1 (OEa), U3.19 (OEb)

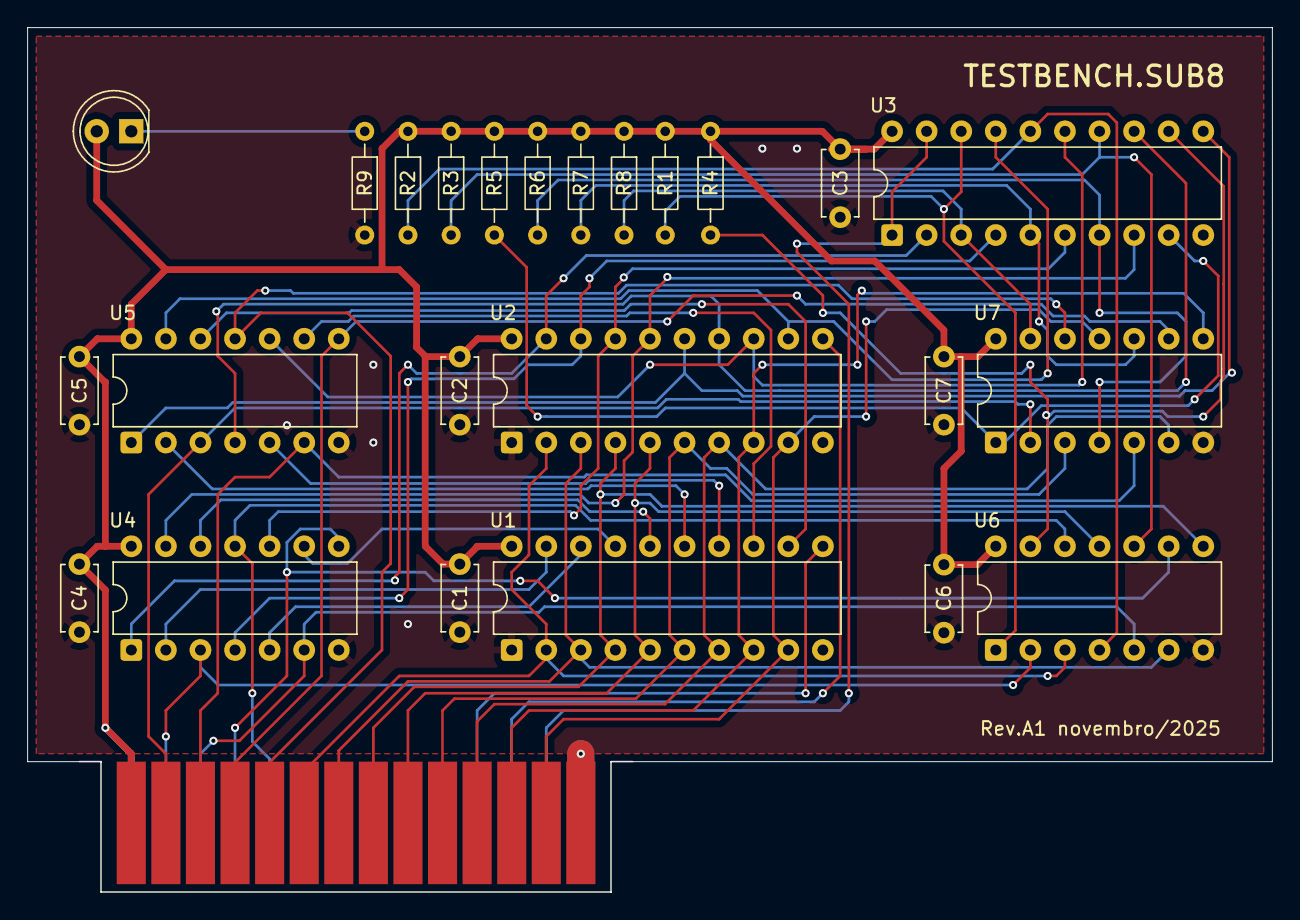
[picture p44: board testbench-sub8.kicad_pcb from above]

Board: 2 copper layers, 91.4 x 63.5 mm, 25 parts (0 on the bottom side), 46 nets.
