rcapaverde/cubo/pcb_v2/ula8da/ula8da.kicad_pcb

## KiCad design pcb_v2/ula8da/ula8da.kicad_pcb (2026-01-30, an earlier design)

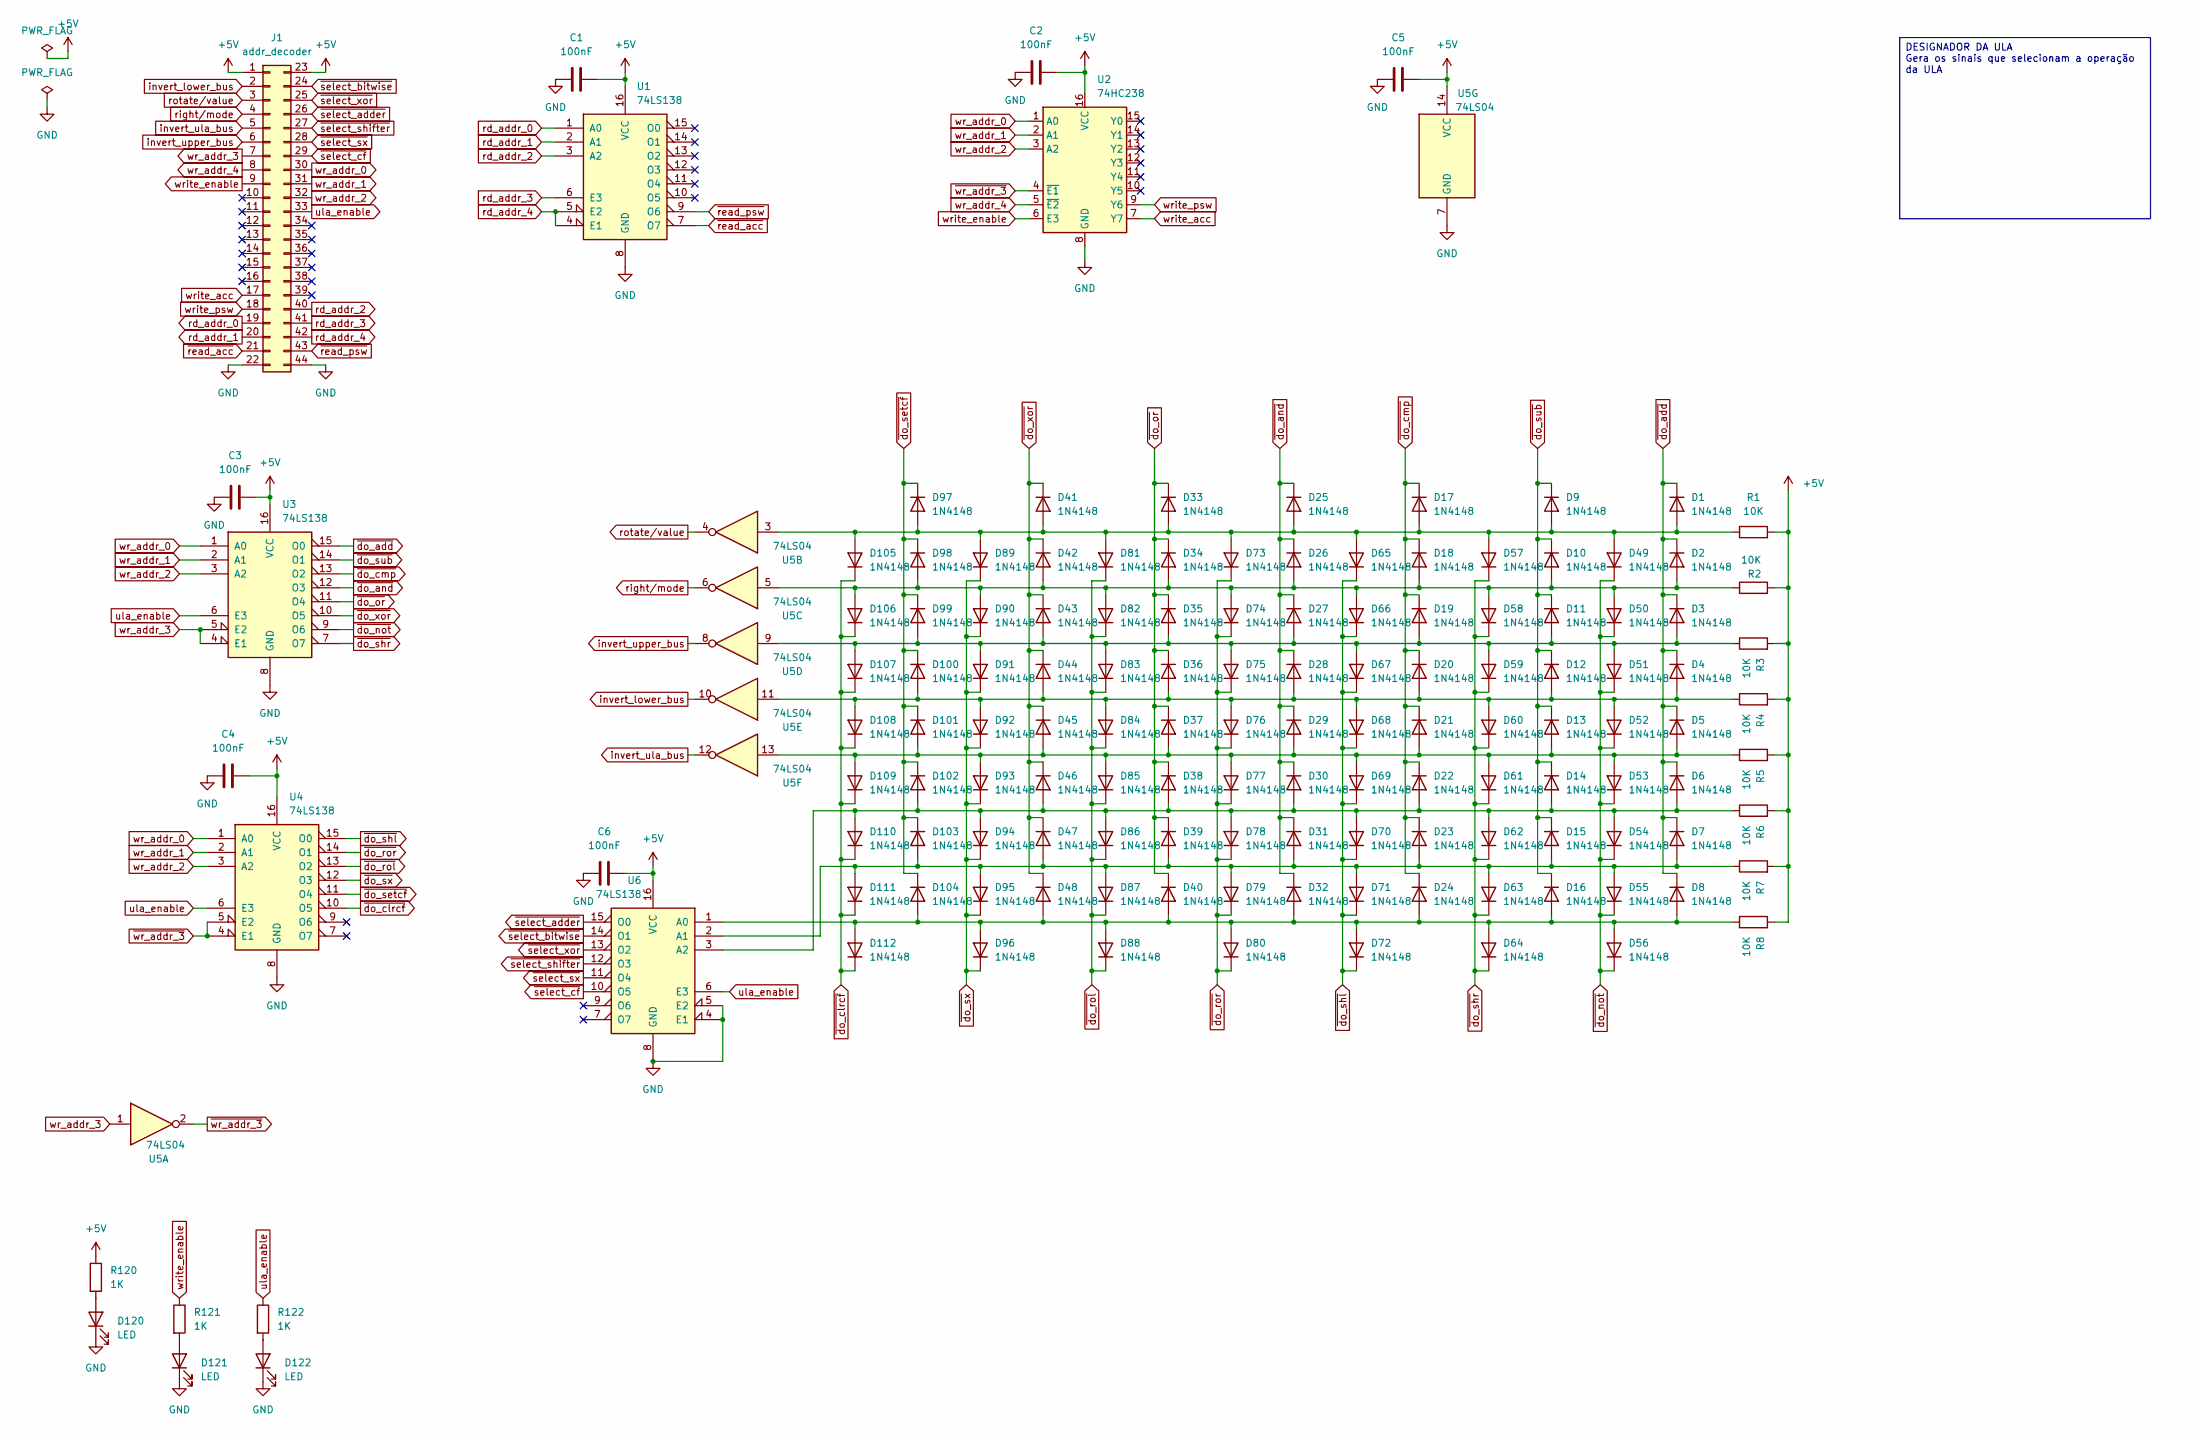
[picture p45: schematic ula8da.kicad_sch]

Parts:
C1, C2, C3, C4, C5, C6: 100nF; C_Disc_D5.1mm_W3.2mm_P5.00mm
D1, D2, D3, D4, D5, D6, D7, D8, D9, D10, D11, D12, D13, D14, D15, D16, D17, D18, D19, D20, D21, D22, D23, D24, D25, D26, D27, D28, D29, D30, D31, D32, D33, D34, D35, D36, D37, D38, D39, D40, D41, D42, D43, D44, D45, D46, D47, D48, D49, D50, D51, D52, D53, D54, D55, D56, D57, D58, D59, D60, D61, D62, D63, D64, D65, D66, D67, D68, D69, D70, D71, D72, D73, D74, D75, D76, D77, D78, D79, D80, D81, D82, D83, D84, D85, D86, D87, D88, D89, D90, D91, D92, D93, D94, D95, D96, D97, D98, D99, D100, D101, D102, D103, D104, D105, D106, D107, D108, D109, D110, D111, D112: 1N4148; D_DO-35_SOD27_P3.81mm_Vertical_KathodeUp
D120, D121, D122: LED; LED_D5.0mm
J1: addr_decoder; edge-connector-44
R1, R2, R3, R4, R5, R6, R7, R8: 10K; R_Axial_DIN0207_L6.3mm_D2.5mm_P7.62mm_Horizontal
R120, R121, R122: 1K; R_Axial_DIN0207_L6.3mm_D2.5mm_P7.62mm_Horizontal
U1, U3, U4, U6: 74LS138; DIP-16_W7.62mm
U2: 74HC238; DIP-16_W7.62mm
U5: 74LS04; DIP-14_W7.62mm

Connections:
+5V: C1.2, C2.2, C3.2, C4.2, C5.2, C6.2, J1.1, J1.23, R1.2, R2.2, R3.2, R4.2, R5.2, R6.2, R7.2, R8.2, R120.1, U1.16 (VCC), U2.16 (VCC), U3.16 (VCC), U4.16 (VCC), U5.14 (VCC), U6.16 (VCC)
GND: C1.1, C2.1, C3.1, C4.1, C5.1, C6.1, D120.1 (K), D121.1 (K), D122.1 (K), J1.22, J1.44, U1.8 (GND), U2.8 (GND), U3.8 (GND), U4.8 (GND), U5.7 (GND), U6.4 (E1), U6.5 (E2), U6.8 (GND)
unnamed: D1.2 (A), D9.2 (A), D17.2 (A), D25.2 (A), D33.2 (A), D41.2 (A), D49.2 (A), D57.2 (A), D65.2 (A), D73.2 (A), D81.2 (A), D89.2 (A), D97.2 (A), D105.2 (A), R1.1, U5.3
unnamed: D2.2 (A), D10.2 (A), D18.2 (A), D26.2 (A), D34.2 (A), D42.2 (A), D50.2 (A), D58.2 (A), D66.2 (A), D74.2 (A), D82.2 (A), D90.2 (A), D98.2 (A), D106.2 (A), R2.1, U5.5
unnamed: D4.2 (A), D12.2 (A), D20.2 (A), D28.2 (A), D36.2 (A), D44.2 (A), D52.2 (A), D60.2 (A), D68.2 (A), D76.2 (A), D84.2 (A), D92.2 (A), D100.2 (A), D108.2 (A), R4.1, U5.11
unnamed: D5.2 (A), D13.2 (A), D21.2 (A), D29.2 (A), D37.2 (A), D45.2 (A), D53.2 (A), D61.2 (A), D69.2 (A), D77.2 (A), D85.2 (A), D93.2 (A), D101.2 (A), D109.2 (A), R5.1, U5.13
unnamed: D6.2 (A), D14.2 (A), D22.2 (A), D30.2 (A), D38.2 (A), D46.2 (A), D54.2 (A), D62.2 (A), D70.2 (A), D78.2 (A), D86.2 (A), D94.2 (A), D102.2 (A), D110.2 (A), R6.1, U6.3 (A2)
unnamed: D7.2 (A), D15.2 (A), D23.2 (A), D31.2 (A), D39.2 (A), D47.2 (A), D55.2 (A), D63.2 (A), D71.2 (A), D79.2 (A), D87.2 (A), D95.2 (A), D103.2 (A), D111.2 (A), R7.1, U6.2 (A1)
unnamed: D8.2 (A), D16.2 (A), D24.2 (A), D32.2 (A), D40.2 (A), D48.2 (A), D56.2 (A), D64.2 (A), D72.2 (A), D80.2 (A), D88.2 (A), D96.2 (A), D104.2 (A), D112.2 (A), R8.1, U6.1 (A0)
unnamed: D3.2 (A), D11.2 (A), D19.2 (A), D27.2 (A), D35.2 (A), D43.2 (A), D51.2 (A), D59.2 (A), D67.2 (A), D75.2 (A), D83.2 (A), D91.2 (A), D99.2 (A), D107.2 (A), R3.1, U5.9
unnamed: D120.2 (A), R120.2
unnamed: D121.2 (A), R121.2
unnamed: D122.2 (A), R122.2
invert_lower_bus: J1.2, U5.10
invert_ula_bus: J1.5, U5.12
invert_upper_bus: J1.6, U5.8
rd_addr_0: J1.19, U1.1 (A0)
rd_addr_1: J1.20, U1.2 (A1)
rd_addr_2: J1.40, U1.3 (A2)
rd_addr_3: J1.41, U1.6 (E3)
rd_addr_4: J1.42, U1.4 (E1), U1.5 (E2)
right/mode: J1.4, U5.6
rotate/value: J1.3, U5.4
ula_enable: J1.33, R122.1, U3.6 (E3), U4.6 (E3), U6.6 (E3)
wr_addr_0: J1.30, U2.1 (A0), U3.1 (A0), U4.1 (A0)
wr_addr_1: J1.31, U2.2 (A1), U3.2 (A1), U4.2 (A1)
wr_addr_2: J1.32, U2.3 (A2), U3.3 (A2), U4.3 (A2)
wr_addr_3: J1.7, U3.4 (E1), U3.5 (E2), U5.1
wr_addr_4: J1.8, U2.5 (~E2)
write_acc: J1.17, U2.7 (Y7)
write_enable: J1.9, R121.1, U2.6 (E3)
write_psw: J1.18, U2.9 (Y6)
~do_add: D1.1 (K), D2.1 (K), D3.1 (K), D4.1 (K), D5.1 (K), D6.1 (K), D7.1 (K), D8.1 (K), U3.15 (O0)
~do_and: D25.1 (K), D26.1 (K), D27.1 (K), D28.1 (K), D29.1 (K), D30.1 (K), D31.1 (K), D32.1 (K), U3.12 (O3)
~do_clrcf: D105.1 (K), D106.1 (K), D107.1 (K), D108.1 (K), D109.1 (K), D110.1 (K), D111.1 (K), D112.1 (K), U4.10 (O5)
~do_cmp: D17.1 (K), D18.1 (K), D19.1 (K), D20.1 (K), D21.1 (K), D22.1 (K), D23.1 (K), D24.1 (K), U3.13 (O2)
~do_not: D49.1 (K), D50.1 (K), D51.1 (K), D52.1 (K), D53.1 (K), D54.1 (K), D55.1 (K), D56.1 (K), U3.9 (O6)
~do_or: D33.1 (K), D34.1 (K), D35.1 (K), D36.1 (K), D37.1 (K), D38.1 (K), D39.1 (K), D40.1 (K), U3.11 (O4)
~do_rol: D81.1 (K), D82.1 (K), D83.1 (K), D84.1 (K), D85.1 (K), D86.1 (K), D87.1 (K), D88.1 (K), U4.13 (O2)
~do_ror: D73.1 (K), D74.1 (K), D75.1 (K), D76.1 (K), D77.1 (K), D78.1 (K), D79.1 (K), D80.1 (K), U4.14 (O1)
~do_setcf: D97.1 (K), D98.1 (K), D99.1 (K), D100.1 (K), D101.1 (K), D102.1 (K), D103.1 (K), D104.1 (K), U4.11 (O4)
~do_shl: D65.1 (K), D66.1 (K), D67.1 (K), D68.1 (K), D69.1 (K), D70.1 (K), D71.1 (K), D72.1 (K), U4.15 (O0)
~do_shr: D57.1 (K), D58.1 (K), D59.1 (K), D60.1 (K), D61.1 (K), D62.1 (K), D63.1 (K), D64.1 (K), U3.7 (O7)
~do_sub: D9.1 (K), D10.1 (K), D11.1 (K), D12.1 (K), D13.1 (K), D14.1 (K), D15.1 (K), D16.1 (K), U3.14 (O1)
~do_sx: D89.1 (K), D90.1 (K), D91.1 (K), D92.1 (K), D93.1 (K), D94.1 (K), D95.1 (K), D96.1 (K), U4.12 (O3)
~do_xor: D41.1 (K), D42.1 (K), D43.1 (K), D44.1 (K), D45.1 (K), D46.1 (K), D47.1 (K), D48.1 (K), U3.10 (O5)
~read_acc: J1.21, U1.7 (O7)
~read_psw: J1.43, U1.9 (O6)
~select_adder: J1.26, U6.15 (O0)
~select_bitwise: J1.24, U6.14 (O1)
~select_cf: J1.29, U6.10 (O5)
~select_shifter: J1.27, U6.12 (O3)
~select_sx: J1.28, U6.11 (O4)
~select_xor: J1.25, U6.13 (O2)
~wr_addr_3: U2.4 (~E1), U4.4 (E1), U4.5 (E2), U5.2

Notes on the sheet:
DESIGNADOR DA ULA Gera os sinais que selecionam a operação da ULA

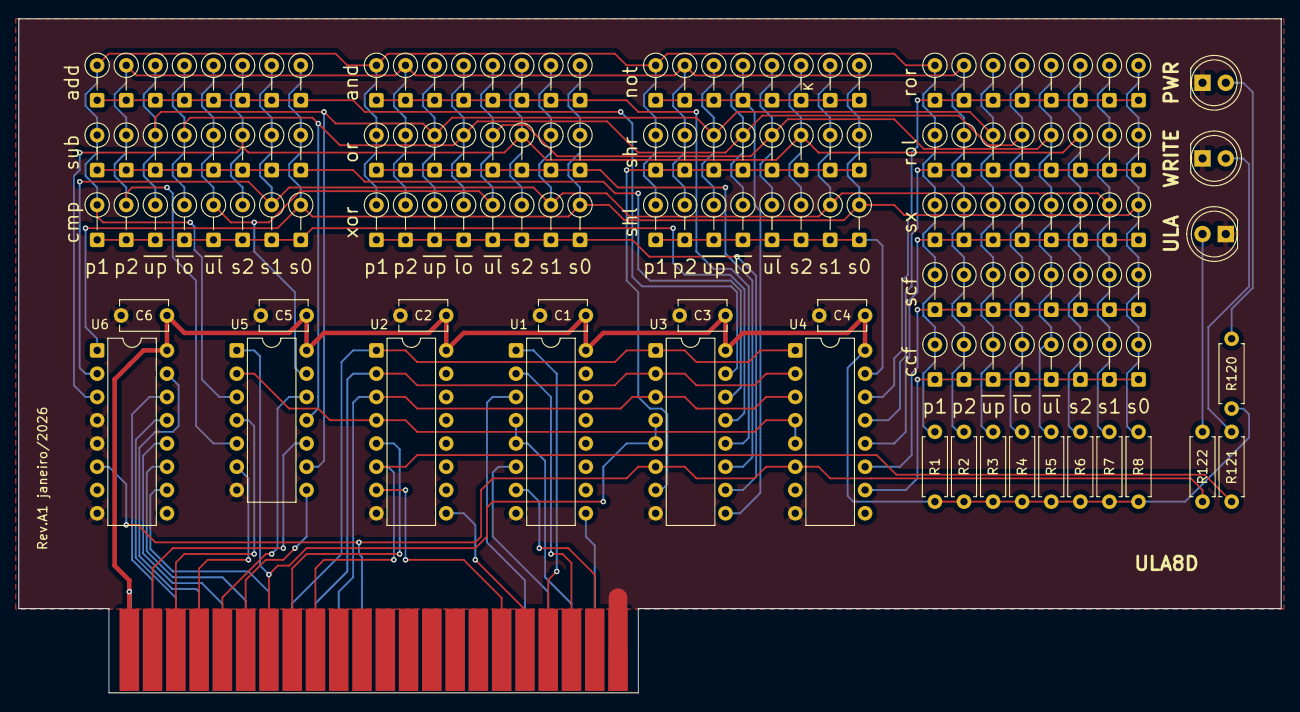
[picture p46: board ula8da.kicad_pcb from above]

Board: 2 copper layers, 137.8 x 73.6 mm, 139 parts (0 on the bottom side), 55 nets.
