rcapaverde/cubo/pcb_v2/ula8-shiftera/ula8-shiftera.kicad_pcb

## KiCad design pcb_v2/ula8-shiftera/ula8-shiftera.kicad_pcb (2026-01-22, an earlier design)

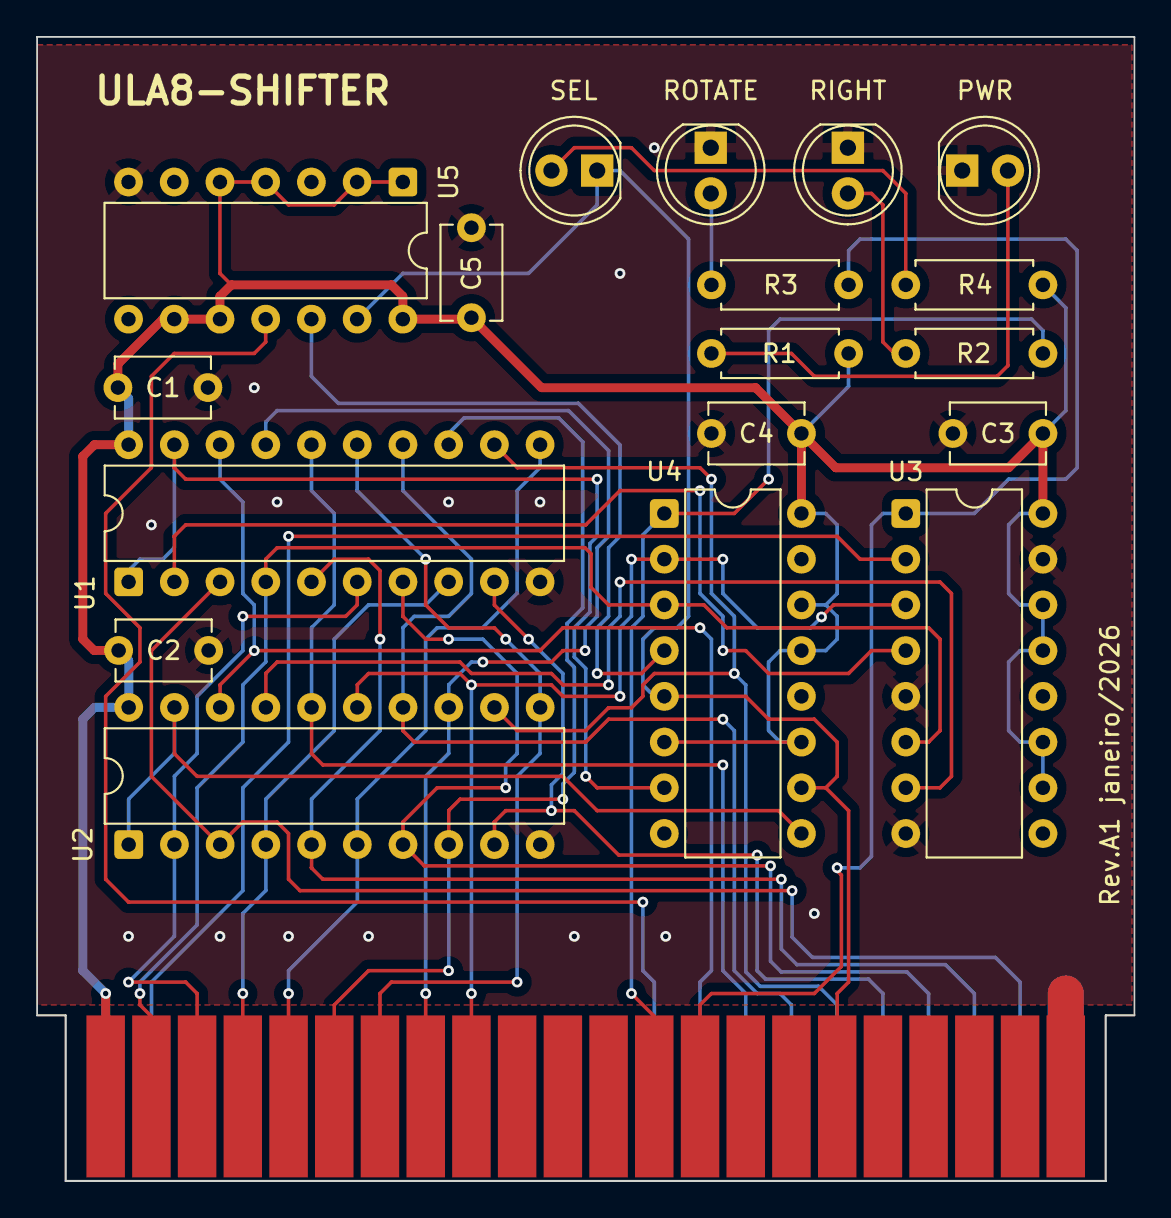
[picture p49: board ula8-shiftera.kicad_pcb from above]

Board: 2 copper layers, 61.0 x 63.5 mm, 19 parts (0 on the bottom side), 32 nets.

Parts:
C1, C2, C3, C4, C5: 100nF; C_Disc_D5.1mm_W3.2mm_P5.00mm
D1, D2, D3, D4: LED; LED_D5.0mm
J1: ula8a; edge-connector-44
R1, R2, R3, R4: 1K; R_Axial_DIN0207_L6.3mm_D2.5mm_P7.62mm_Horizontal
U1, U2: 74LS244; DIP-20_W7.62mm
U3, U4: 74LS157; DIP-16_W7.62mm
U5: 74LS125; DIP-14_W7.62mm

Connections:
+5V: C1.2, C2.2, C3.2, C4.2, C5.2, J1.1, J1.23, R1.1, R4.1, U1.20 (VCC), U2.20 (VCC), U3.10 (I1c), U3.11 (I0c), U3.13 (I1d), U3.14 (I0d), U3.16 (VCC), U4.6 (I1b), U4.11 (I0c), U4.13 (I1d), U4.14 (I0d), U4.16 (VCC), U5.1, U5.2, U5.4, U5.5, U5.9, U5.10, U5.14 (VCC)
GND: C1.1, C2.1, C3.1, C4.1, C5.1, D1.1 (K), D2.1 (K), D3.1 (K), J1.22, J1.44, U1.10 (GND), U2.10 (GND), U3.5 (I0b), U3.8 (GND), U3.15 (E), U4.8 (GND), U4.15 (E), U5.7 (GND)
unnamed: D1.2 (A), R1.2
unnamed: D2.2 (A), R2.2
unnamed: D3.2 (A), R3.2
unnamed: D4.2 (A), R4.2
unnamed: U1.2 (I0a), U3.4 (Za)
unnamed: U2.17 (I3b), U3.7 (Zb)
unnamed: U4.4 (Za), U5.12
carry_in: J1.24, U3.2 (I0a)
carry_out: J1.35, U5.11
lower_bus0: J1.2, U1.4 (I1a), U3.6 (I1b), U4.3 (I1a)
lower_bus1: J1.3, U1.6 (I2a), U2.2 (I0a)
lower_bus2: J1.4, U1.8 (I3a), U2.4 (I1a)
lower_bus3: J1.5, U1.11 (I0b), U2.6 (I2a)
lower_bus4: J1.6, U1.13 (I1b), U2.8 (I3a)
lower_bus5: J1.7, U1.15 (I2b), U2.11 (I0b)
lower_bus6: J1.8, U1.17 (I3b), U2.13 (I1b)
lower_bus7: J1.9, U2.15 (I2b), U3.3 (I1a), U4.2 (I0a)
option_right: J1.13, R2.1, U4.1 (S)
option_rotate: J1.14, R3.1, U3.1 (S)
ula_bus0: J1.36, U1.18 (O0a), U2.18 (O0a)
ula_bus1: J1.37, U1.16 (O1a), U2.16 (O1a)
ula_bus2: J1.38, U1.14 (O2a), U2.14 (O2a)
ula_bus3: J1.39, U1.12 (O3a), U2.12 (O3a)
ula_bus4: J1.40, U1.9 (O0b), U2.9 (O0b)
ula_bus5: J1.41, U1.7 (O1b), U2.7 (O1b)
ula_bus6: J1.42, U1.5 (O2b), U2.5 (O2b)
ula_bus7: J1.43, U1.3 (O3b), U2.3 (O3b)
~select: D4.1 (K), J1.17, U4.5 (I0b), U4.10 (I1c), U5.13
~shift_left: U1.1 (OEa), U1.19 (OEb), U4.7 (Zb)
~shift_right: U2.1 (OEa), U2.19 (OEb), U4.9 (Zc)
