rcapaverde/cubo/pcb_v2/ula8-sxa/ula8-sxa.kicad_pcb

## KiCad design pcb_v2/ula8-sxa/ula8-sxa.kicad_pcb (2026-01-22, an earlier design)

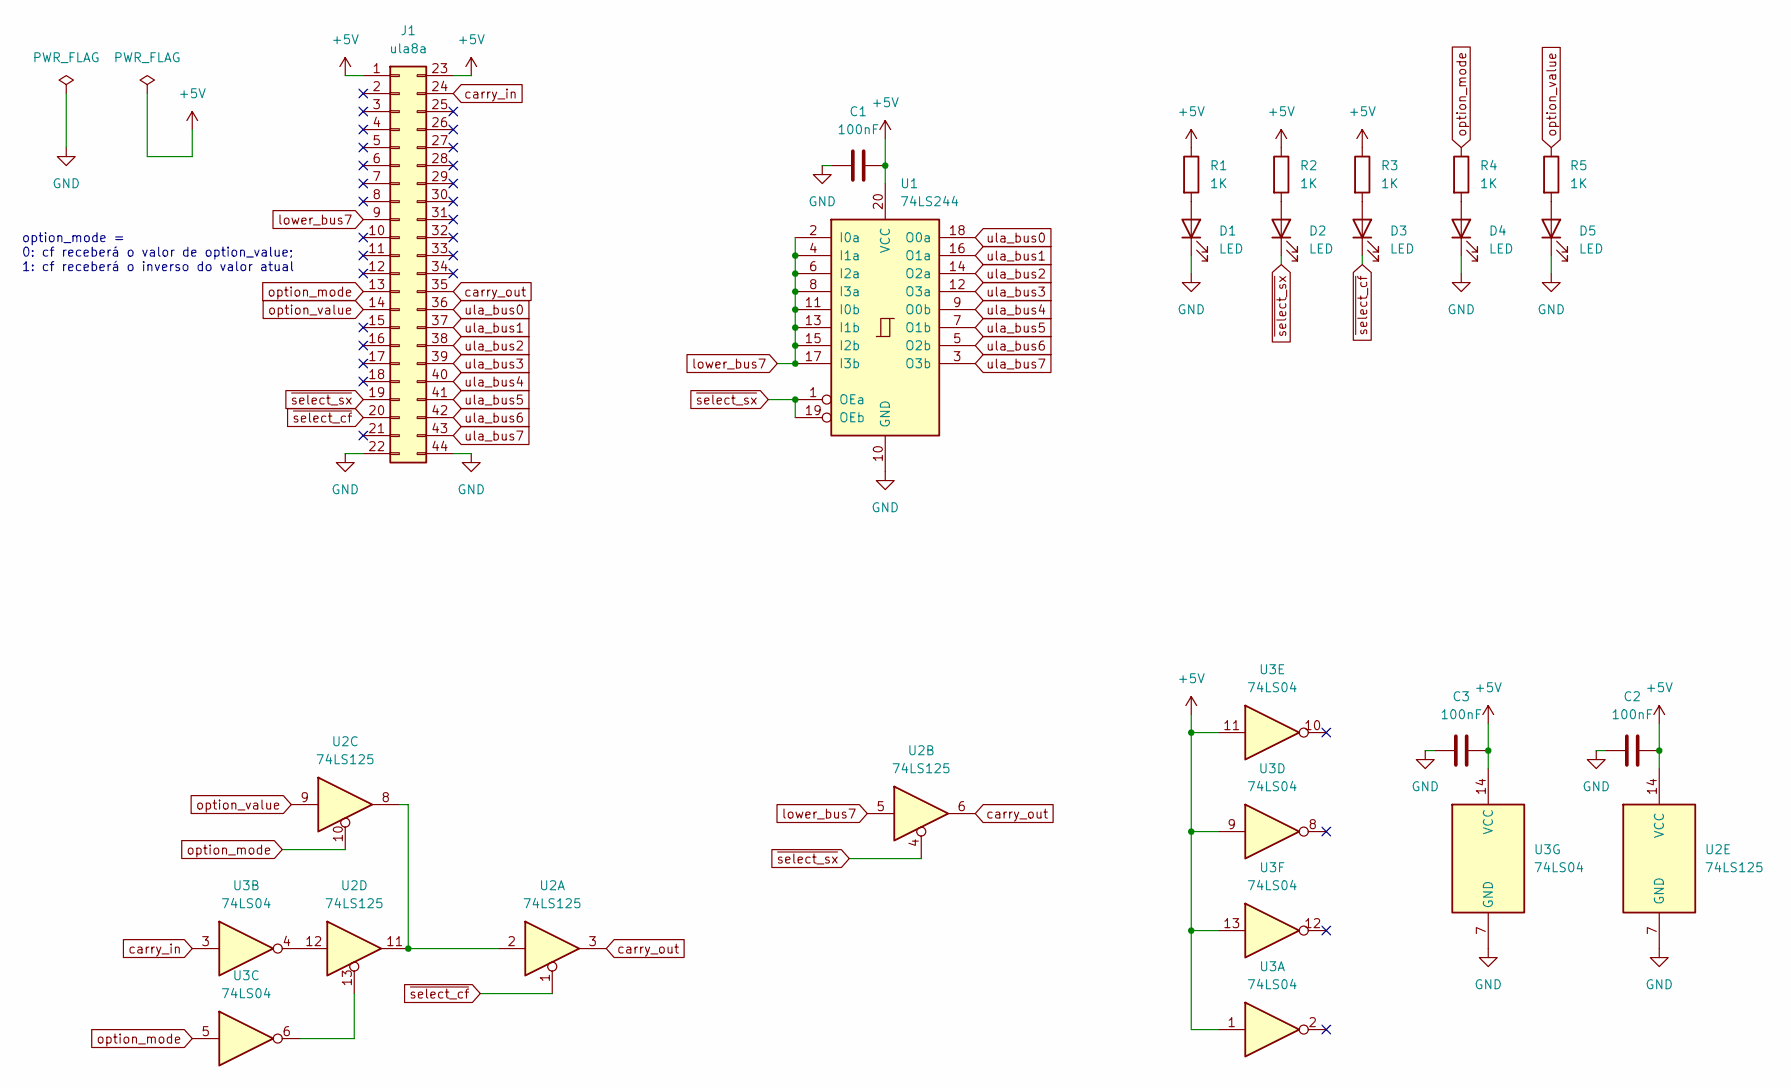
[picture p50: schematic ula8-sxa.kicad_sch]

Parts:
C1, C2, C3: 100nF; C_Disc_D5.1mm_W3.2mm_P5.00mm
D1, D2, D3, D4, D5: LED; LED_D5.0mm
J1: ula8a; edge-connector-44
R1, R2, R3, R4, R5: 1K; R_Axial_DIN0207_L6.3mm_D2.5mm_P7.62mm_Horizontal
U1: 74LS244; DIP-20_W7.62mm
U2: 74LS125; DIP-14_W7.62mm
U3: 74LS04; DIP-14_W7.62mm

Connections:
+5V: C1.2, C2.2, C3.2, J1.1, J1.23, R1.1, R2.1, R3.1, U1.20 (VCC), U2.14 (VCC), U3.1, U3.9, U3.11, U3.13, U3.14 (VCC)
GND: C1.1, C2.1, C3.1, D1.1 (K), D4.1 (K), D5.1 (K), J1.22, J1.44, U1.10 (GND), U2.7 (GND), U3.7 (GND)
unnamed: D1.2 (A), R1.2
unnamed: D2.2 (A), R2.2
unnamed: D3.2 (A), R3.2
unnamed: D4.2 (A), R4.2
unnamed: D5.2 (A), R5.2
unnamed: U2.2, U2.8, U2.11
unnamed: U2.12, U3.4
unnamed: U2.13, U3.6
carry_in: J1.24, U3.3
carry_out: J1.35, U2.3, U2.6
lower_bus7: J1.9, U1.2 (I0a), U1.4 (I1a), U1.6 (I2a), U1.8 (I3a), U1.11 (I0b), U1.13 (I1b), U1.15 (I2b), U1.17 (I3b), U2.5
option_mode: J1.13, R4.1, U2.10, U3.5
option_value: J1.14, R5.1, U2.9
ula_bus0: J1.36, U1.18 (O0a)
ula_bus1: J1.37, U1.16 (O1a)
ula_bus2: J1.38, U1.14 (O2a)
ula_bus3: J1.39, U1.12 (O3a)
ula_bus4: J1.40, U1.9 (O0b)
ula_bus5: J1.41, U1.7 (O1b)
ula_bus6: J1.42, U1.5 (O2b)
ula_bus7: J1.43, U1.3 (O3b)
~select_cf: D3.1 (K), J1.20, U2.1
~select_sx: D2.1 (K), J1.19, U1.1 (OEa), U1.19 (OEb), U2.4

Notes on the sheet:
option_mode = 0: cf receberá o valor de option_value; 1: cf receberá o inverso do valor atual

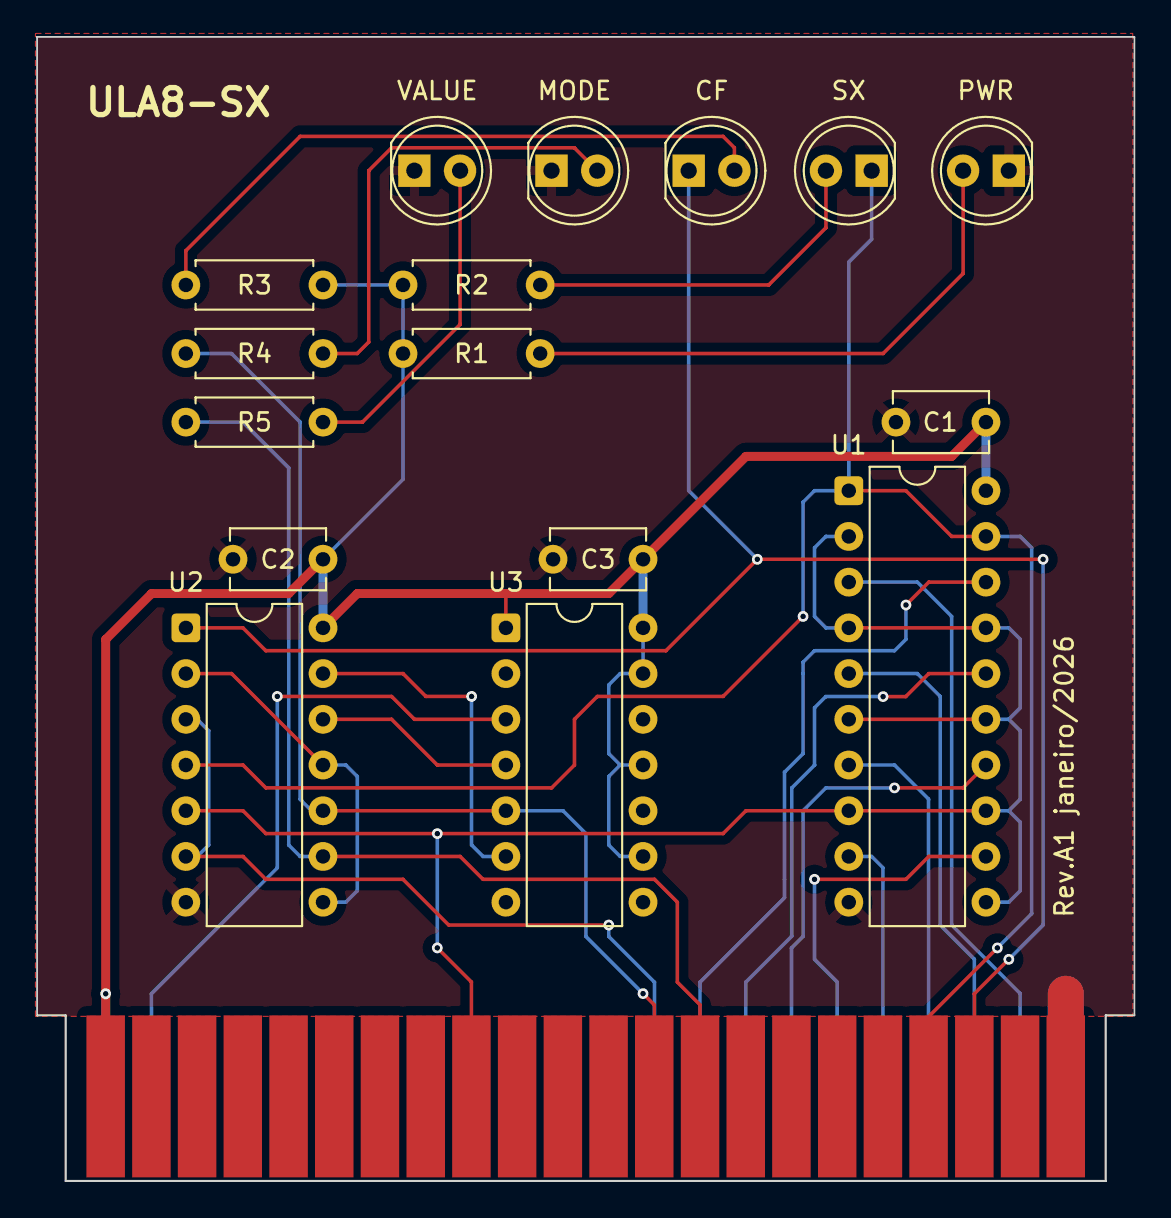
[picture p51: board ula8-sxa.kicad_pcb from above]

Board: 2 copper layers, 61.0 x 63.5 mm, 17 parts (0 on the bottom side), 25 nets.
