rcapaverde/cubo/pcb_v2/ula8-addera/ula8-addera.kicad_pcb

## KiCad design pcb_v2/ula8-addera/ula8-addera.kicad_pcb (2026-01-15, an earlier design)

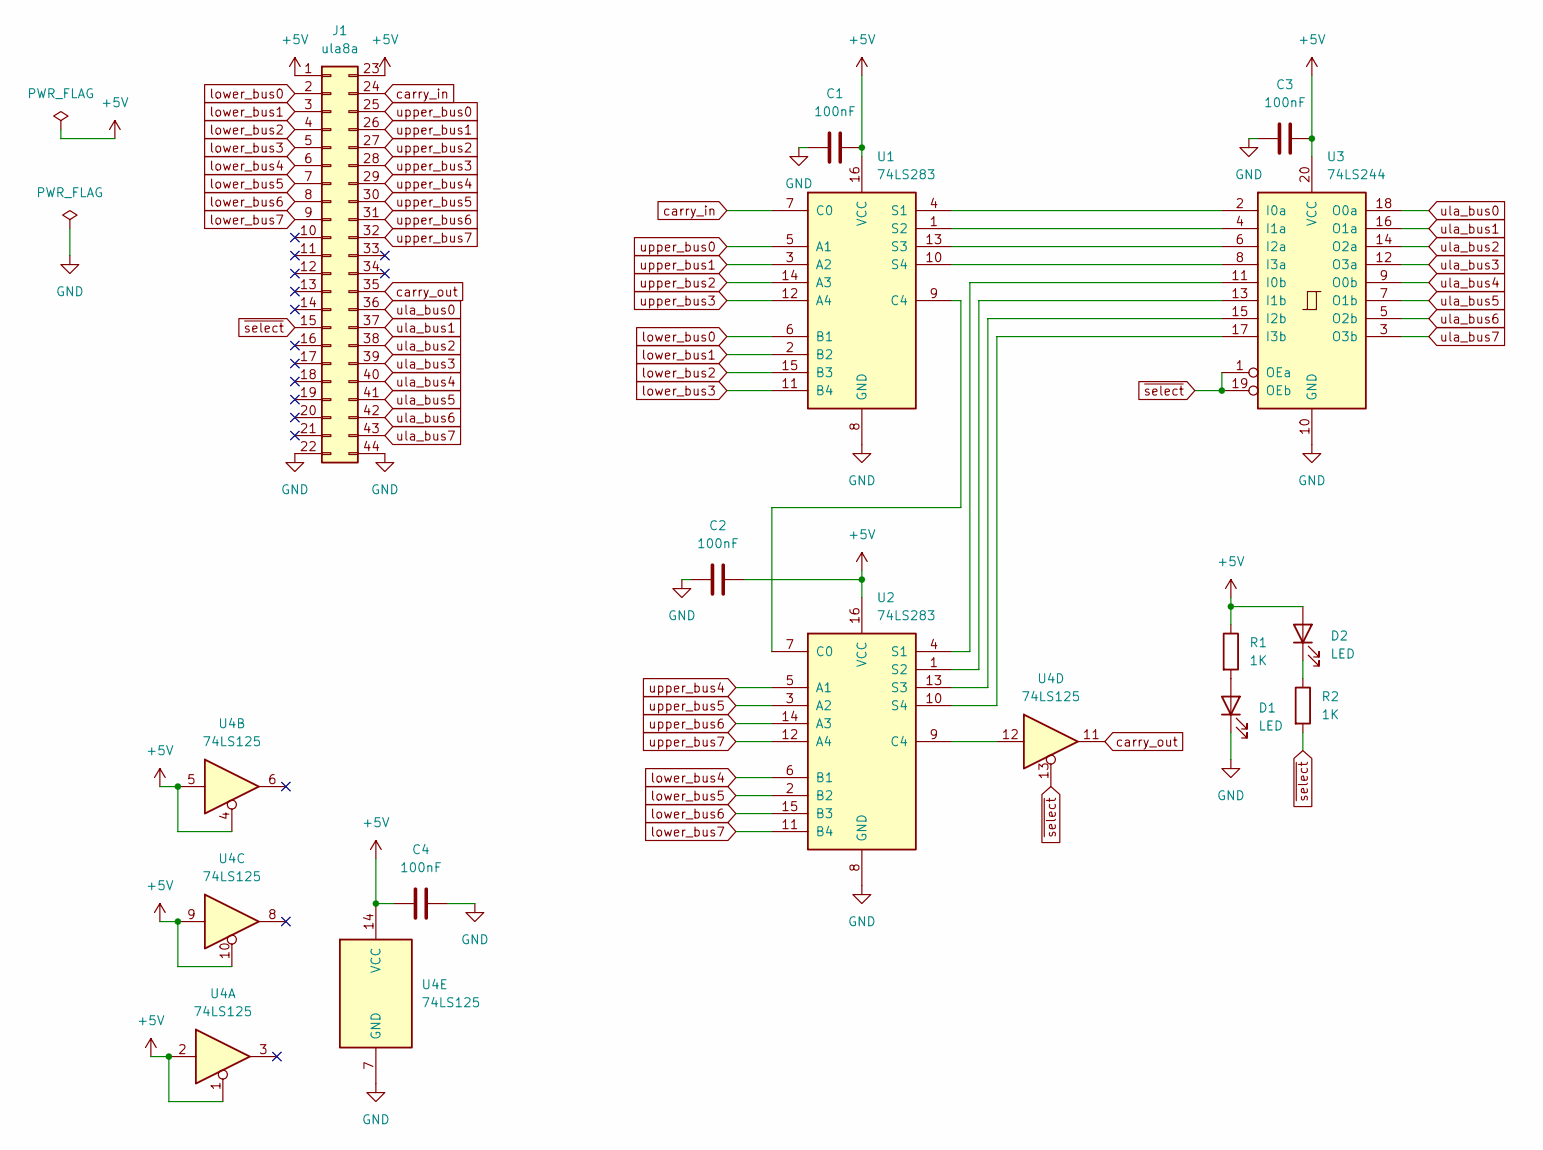
[picture p52: schematic ula8-addera.kicad_sch]

Parts:
C1, C2, C3, C4: 100nF; C_Disc_D5.1mm_W3.2mm_P5.00mm
D1, D2: LED; LED_D5.0mm
J1: ula8a; edge-connector-44
R1, R2: 1K; R_Axial_DIN0207_L6.3mm_D2.5mm_P7.62mm_Horizontal
U1, U2: 74LS283; DIP-16_W7.62mm
U3: 74LS244; DIP-20_W7.62mm
U4: 74LS125; DIP-14_W7.62mm

Connections:
+5V: C1.2, C2.2, C3.2, C4.1, D2.2 (A), J1.1, J1.23, R1.1, U1.16 (VCC), U2.16 (VCC), U3.20 (VCC), U4.1, U4.2, U4.4, U4.5, U4.9, U4.10, U4.14 (VCC)
GND: C1.1, C2.1, C3.1, C4.2, D1.1 (K), J1.22, J1.44, U1.8 (GND), U2.8 (GND), U3.10 (GND), U4.7 (GND)
unnamed: D1.2 (A), R1.2
unnamed: D2.1 (K), R2.1
unnamed: U1.9 (C4), U2.7 (C0)
unnamed: U1.4 (S1), U3.2 (I0a)
unnamed: U1.1 (S2), U3.4 (I1a)
unnamed: U1.13 (S3), U3.6 (I2a)
unnamed: U1.10 (S4), U3.8 (I3a)
unnamed: U2.9 (C4), U4.12
unnamed: U2.4 (S1), U3.11 (I0b)
unnamed: U2.1 (S2), U3.13 (I1b)
unnamed: U2.13 (S3), U3.15 (I2b)
unnamed: U2.10 (S4), U3.17 (I3b)
carry_in: J1.24, U1.7 (C0)
carry_out: J1.35, U4.11
lower_bus0: J1.2, U1.6 (B1)
lower_bus1: J1.3, U1.2 (B2)
lower_bus2: J1.4, U1.15 (B3)
lower_bus3: J1.5, U1.11 (B4)
lower_bus4: J1.6, U2.6 (B1)
lower_bus5: J1.7, U2.2 (B2)
lower_bus6: J1.8, U2.15 (B3)
lower_bus7: J1.9, U2.11 (B4)
ula_bus0: J1.36, U3.18 (O0a)
ula_bus1: J1.37, U3.16 (O1a)
ula_bus2: J1.38, U3.14 (O2a)
ula_bus3: J1.39, U3.12 (O3a)
ula_bus4: J1.40, U3.9 (O0b)
ula_bus5: J1.41, U3.7 (O1b)
ula_bus6: J1.42, U3.5 (O2b)
ula_bus7: J1.43, U3.3 (O3b)
upper_bus0: J1.25, U1.5 (A1)
upper_bus1: J1.26, U1.3 (A2)
upper_bus2: J1.27, U1.14 (A3)
upper_bus3: J1.28, U1.12 (A4)
upper_bus4: J1.29, U2.5 (A1)
upper_bus5: J1.30, U2.3 (A2)
upper_bus6: J1.31, U2.14 (A3)
upper_bus7: J1.32, U2.12 (A4)
~select: J1.15, R2.2, U3.1 (OEa), U3.19 (OEb), U4.13
