rcapaverde/cubo/pcb_v2/ula8-addera/ula8-addera.kicad_pcb

## KiCad design pcb_v2/ula8-addera/ula8-addera.kicad_pcb (continued)

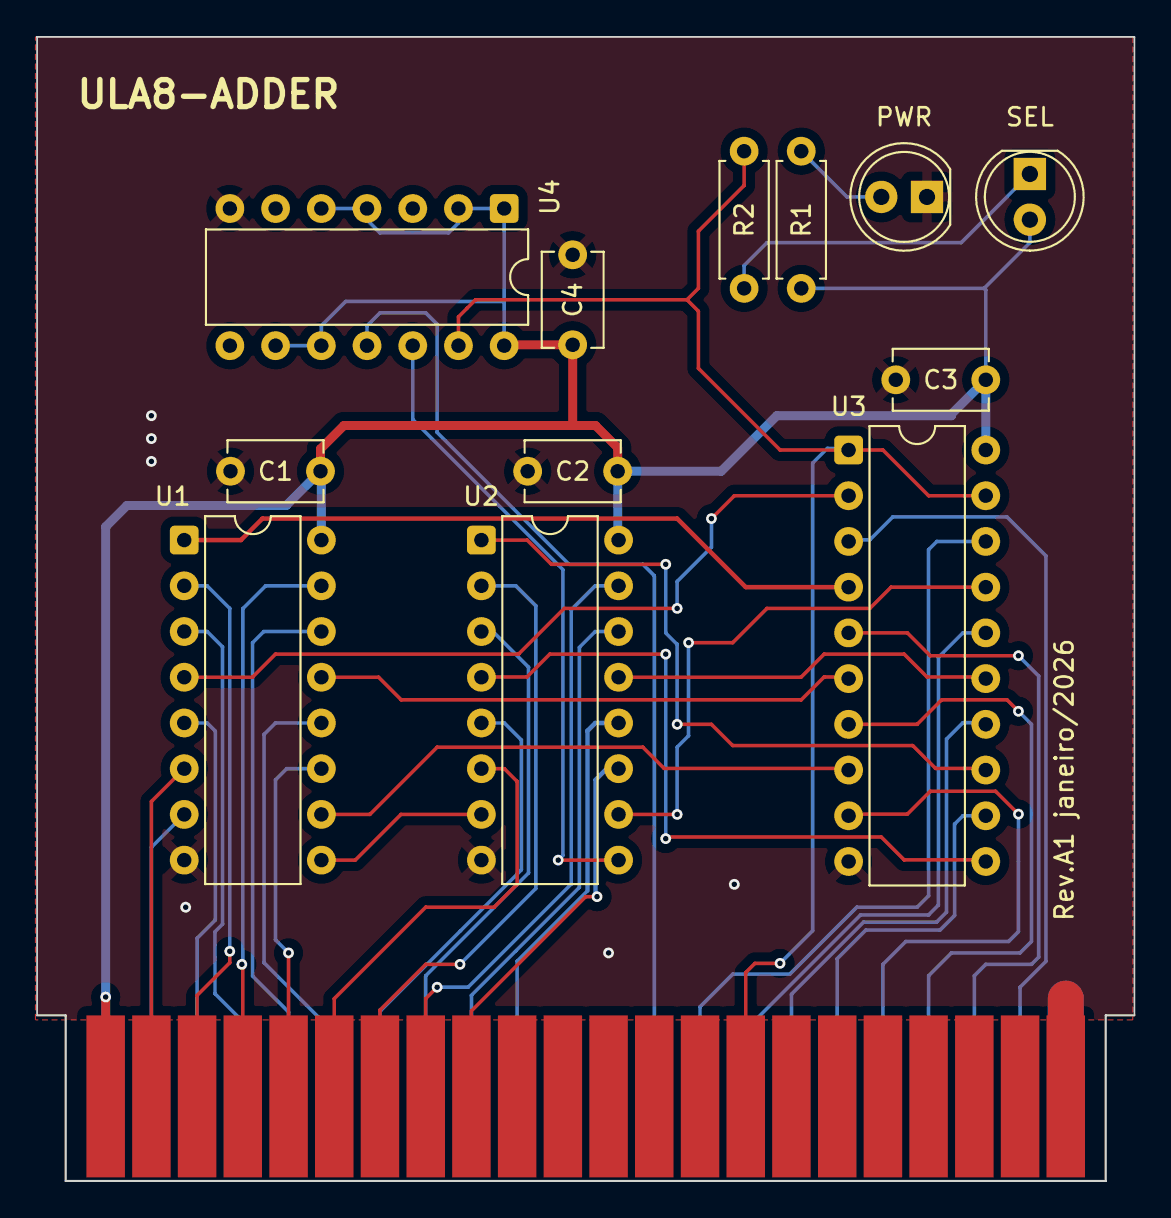
[picture p53: board ula8-addera.kicad_pcb from above]

Board: 2 copper layers, 61.0 x 63.6 mm, 13 parts (0 on the bottom side), 41 nets.
