rcapaverde/cubo/pcb_v2/testbench-adaptador28/testbench-adaptador28.kicad_pcb

## KiCad design pcb_v2/testbench-adaptador28/testbench-adaptador28.kicad_pcb (2026-01-12, an earlier design)

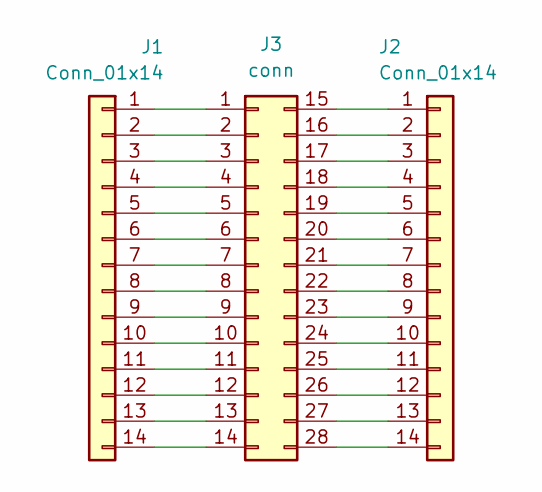
[picture p54: schematic testbench-adaptador28.kicad_sch]

Parts:
J1, J2: Conn_01x14; PinHeader_1x14_P2.54mm_Vertical
J3: conn; male-edge-connector-28

Connections:
unnamed: J1.1, J3.1
unnamed: J1.2, J3.2
unnamed: J1.3, J3.3
unnamed: J1.4, J3.4
unnamed: J1.5, J3.5
unnamed: J1.6, J3.6
unnamed: J1.7, J3.7
unnamed: J1.8, J3.8
unnamed: J1.9, J3.9
unnamed: J1.10, J3.10
unnamed: J1.11, J3.11
unnamed: J1.12, J3.12
unnamed: J1.13, J3.13
unnamed: J1.14, J3.14
unnamed: J2.1, J3.15
unnamed: J2.2, J3.16
unnamed: J2.3, J3.17
unnamed: J2.4, J3.18
unnamed: J2.5, J3.19
unnamed: J2.6, J3.20
unnamed: J2.7, J3.21
unnamed: J2.8, J3.22
unnamed: J2.9, J3.23
unnamed: J2.10, J3.24
unnamed: J2.11, J3.25
unnamed: J2.12, J3.26
unnamed: J2.13, J3.27
unnamed: J2.14, J3.28

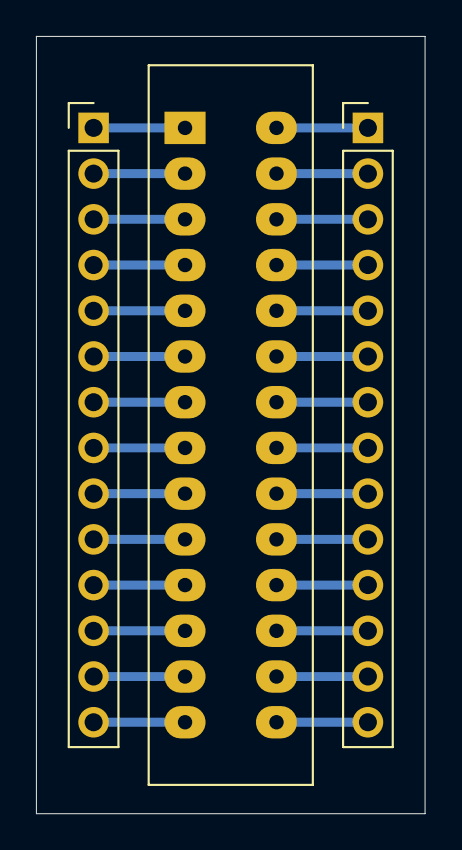
[picture p55: board testbench-adaptador28.kicad_pcb from above]

Board: 2 copper layers, 21.6 x 43.2 mm, 3 parts (0 on the bottom side), 28 nets.
