rcapaverde/cubo/pcb_v2/testbench-adaptador44/testbench-adaptador44.kicad_pcb

## KiCad design pcb_v2/testbench-adaptador44/testbench-adaptador44.kicad_pcb (2026-01-12, an earlier design)

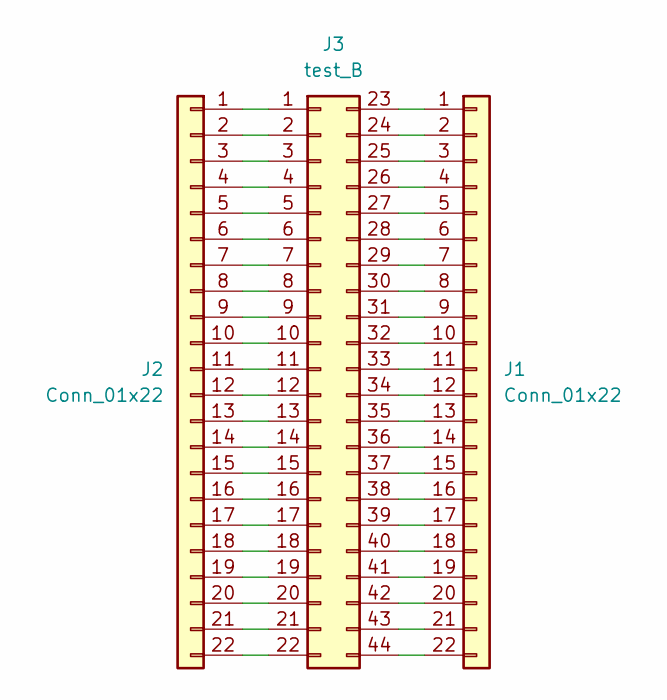
[picture p56: schematic testbench-adaptador44.kicad_sch]

Parts:
J1, J2: Conn_01x22; PinHeader_1x22_P2.54mm_Vertical
J3: test_B; male-edge-connector-44

Connections:
unnamed: J1.1, J3.23
unnamed: J1.2, J3.24
unnamed: J1.3, J3.25
unnamed: J1.4, J3.26
unnamed: J1.5, J3.27
unnamed: J1.6, J3.28
unnamed: J1.7, J3.29
unnamed: J1.8, J3.30
unnamed: J1.9, J3.31
unnamed: J1.10, J3.32
unnamed: J1.11, J3.33
unnamed: J1.12, J3.34
unnamed: J1.13, J3.35
unnamed: J1.14, J3.36
unnamed: J1.15, J3.37
unnamed: J1.16, J3.38
unnamed: J1.17, J3.39
unnamed: J1.18, J3.40
unnamed: J1.19, J3.41
unnamed: J1.20, J3.42
unnamed: J1.21, J3.43
unnamed: J1.22, J3.44
unnamed: J2.1, J3.1
unnamed: J2.2, J3.2
unnamed: J2.3, J3.3
unnamed: J2.4, J3.4
unnamed: J2.5, J3.5
unnamed: J2.6, J3.6
unnamed: J2.7, J3.7
unnamed: J2.8, J3.8
unnamed: J2.9, J3.9
unnamed: J2.10, J3.10
unnamed: J2.11, J3.11
unnamed: J2.12, J3.12
unnamed: J2.13, J3.13
unnamed: J2.14, J3.14
unnamed: J2.15, J3.15
unnamed: J2.16, J3.16
unnamed: J2.17, J3.17
unnamed: J2.18, J3.18
unnamed: J2.19, J3.19
unnamed: J2.20, J3.20
unnamed: J2.21, J3.21
unnamed: J2.22, J3.22

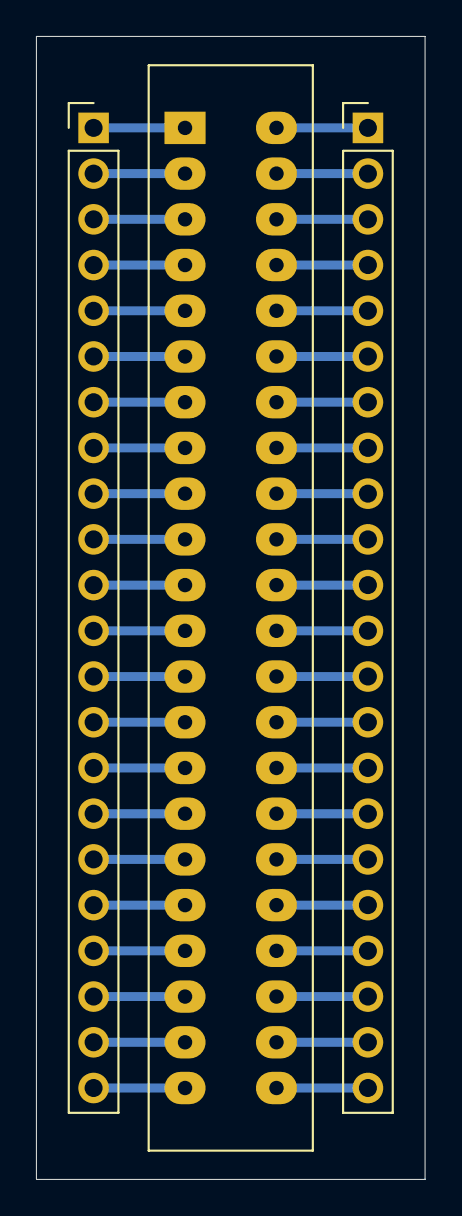
[picture p57: board testbench-adaptador44.kicad_pcb from above]

Board: 2 copper layers, 21.6 x 63.5 mm, 3 parts (0 on the bottom side), 44 nets.
