rcapaverde/cubo/pcb_v2/swrda/swrda.kicad_pcb

## KiCad design pcb_v2/swrda/swrda.kicad_pcb (2025-12-28, an earlier design)

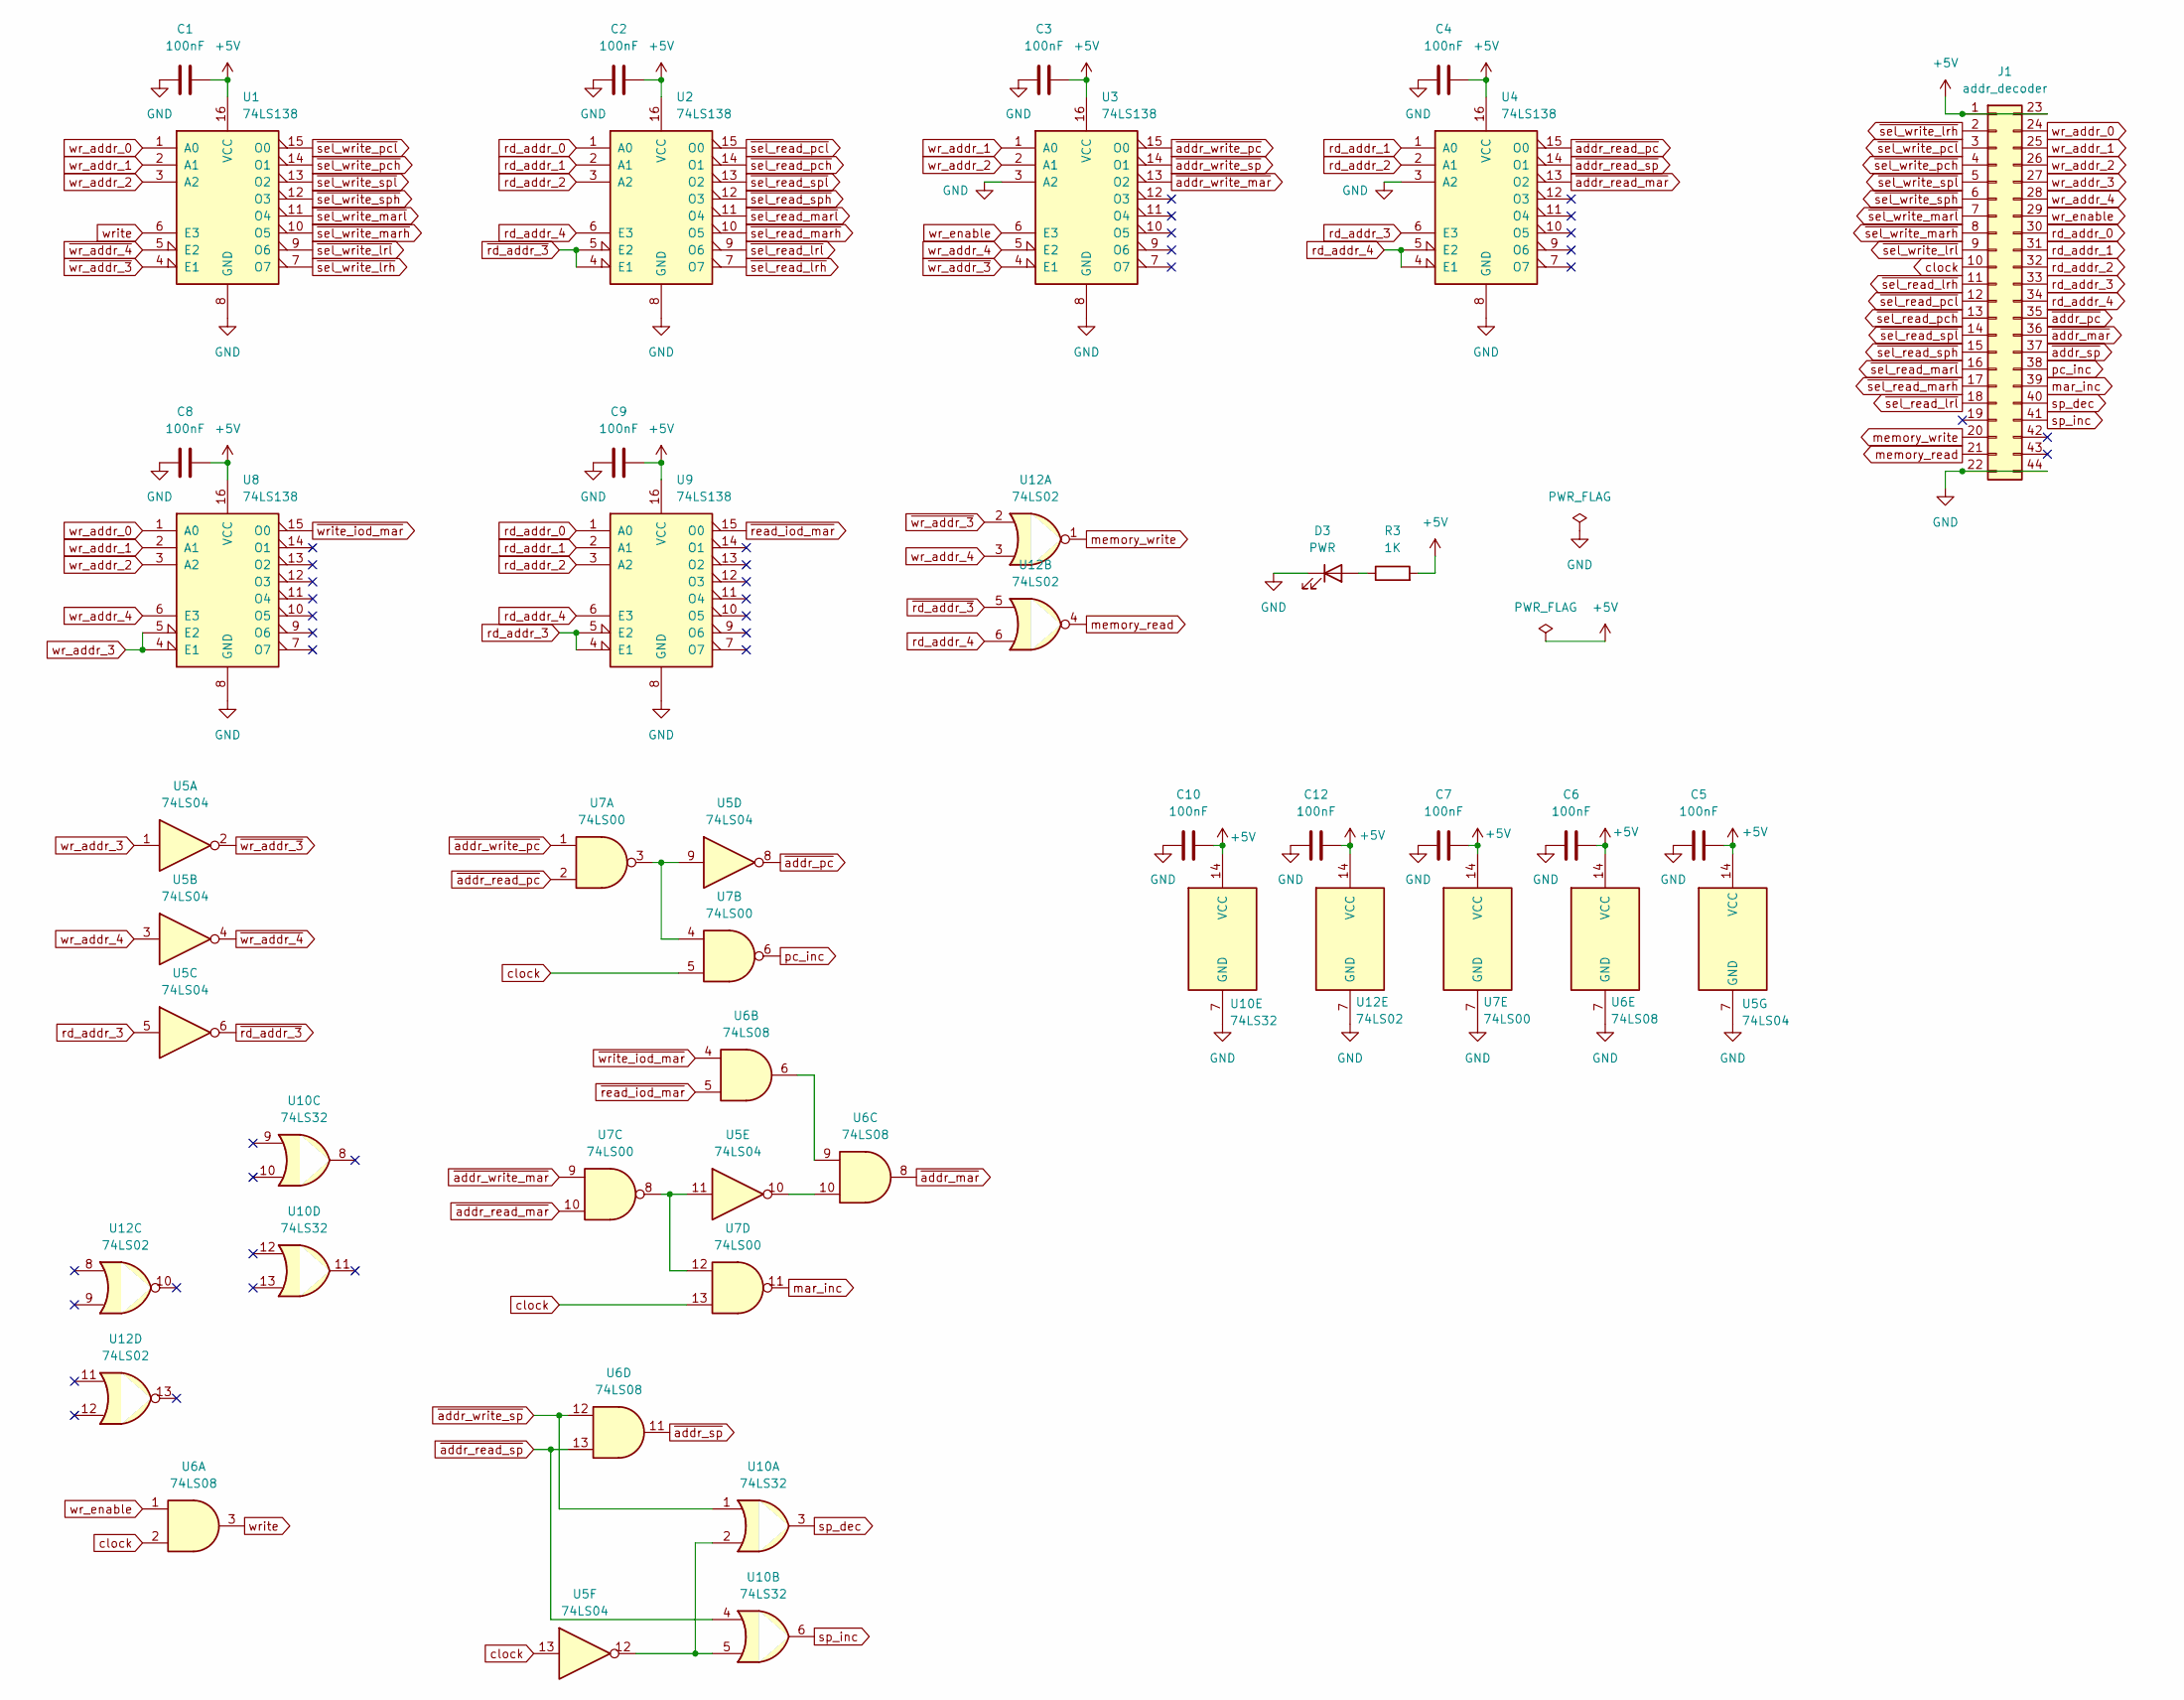
[picture p58: schematic swrda.kicad_sch]

Parts:
C1, C2, C3, C4, C5, C6, C7, C8, C9, C10, C12: 100nF; C_Disc_D5.1mm_W3.2mm_P5.00mm
D3: PWR; LED_D5.0mm
J1: addr_decoder; edge-connector-44
R3: 1K; R_Axial_DIN0207_L6.3mm_D2.5mm_P7.62mm_Horizontal
U1, U2, U3, U4, U8, U9: 74LS138; DIP-16_W7.62mm
U5: 74LS04; DIP-14_W7.62mm
U6: 74LS08; DIP-14_W7.62mm
U7: 74LS00; DIP-14_W7.62mm
U10: 74LS32; DIP-14_W7.62mm
U12: 74LS02; DIP-14_W7.62mm

Connections:
+5V: C1.2, C2.2, C3.2, C4.2, C5.2, C6.2, C7.2, C8.2, C9.2, C10.2, C12.2, J1.1, J1.23, R3.2, U1.16 (VCC), U2.16 (VCC), U3.16 (VCC), U4.16 (VCC), U5.14 (VCC), U6.14 (VCC), U7.14 (VCC), U8.16 (VCC), U9.16 (VCC), U10.14 (VCC), U12.14 (VCC)
GND: C1.1, C2.1, C3.1, C4.1, C5.1, C6.1, C7.1, C8.1, C9.1, C10.1, C12.1, D3.1 (K), J1.22, J1.44, U1.8 (GND), U2.8 (GND), U3.3 (A2), U3.8 (GND), U4.3 (A2), U4.8 (GND), U5.7 (GND), U6.7 (GND), U7.7 (GND), U8.8 (GND), U9.8 (GND), U10.7 (GND), U12.7 (GND)
unnamed: D3.2 (A), R3.1
unnamed: U5.9, U7.3, U7.4
unnamed: U5.10, U6.10
unnamed: U5.11, U7.8, U7.12
unnamed: U6.6, U6.9
unnamed: U5.12, U10.2, U10.5
clock: J1.10, U5.13, U6.2, U7.5, U7.13
mar_inc: J1.39, U7.11
memory_read: J1.21, U12.4
memory_write: J1.20, U12.1
pc_inc: J1.38, U7.6
rd_addr_0: J1.30, U2.1 (A0), U9.1 (A0)
rd_addr_1: J1.31, U2.2 (A1), U4.1 (A0), U9.2 (A1)
rd_addr_2: J1.32, U2.3 (A2), U4.2 (A1), U9.3 (A2)
rd_addr_3: J1.33, U4.6 (E3), U5.5, U9.4 (E1), U9.5 (E2)
rd_addr_4: J1.34, U2.6 (E3), U4.4 (E1), U4.5 (E2), U9.6 (E3), U12.6
sp_dec: J1.40, U10.3
sp_inc: J1.41, U10.6
wr_addr_0: J1.24, U1.1 (A0), U8.1 (A0)
wr_addr_1: J1.25, U1.2 (A1), U3.1 (A0), U8.2 (A1)
wr_addr_2: J1.26, U1.3 (A2), U3.2 (A1), U8.3 (A2)
wr_addr_3: J1.27, U5.1, U8.4 (E1), U8.5 (E2)
wr_addr_4: J1.28, U3.5 (E2), U5.3, U8.6 (E3), U12.3
wr_enable: J1.29, U3.6 (E3), U6.1
write: U1.6 (E3), U6.3
~addr_mar: J1.36, U6.8
~addr_pc: J1.35, U5.8
~addr_read_mar: U4.13 (O2), U7.10
~addr_read_pc: U4.15 (O0), U7.2
~addr_read_sp: U4.14 (O1), U6.13, U10.4
~addr_sp: J1.37, U6.11
~addr_write_mar: U3.13 (O2), U7.9
~addr_write_pc: U3.15 (O0), U7.1
~addr_write_sp: U3.14 (O1), U6.12, U10.1
~rd_addr_3: U2.4 (E1), U2.5 (E2), U5.6, U12.5
~read_iod_mar: U6.5, U9.15 (O0)
~sel_read_lrh: J1.11, U2.7 (O7)
~sel_read_lrl: J1.18, U2.9 (O6)
~sel_read_marh: J1.17, U2.10 (O5)
~sel_read_marl: J1.16, U2.11 (O4)
~sel_read_pch: J1.13, U2.14 (O1)
~sel_read_pcl: J1.12, U2.15 (O0)
~sel_read_sph: J1.15, U2.12 (O3)
~sel_read_spl: J1.14, U2.13 (O2)
~sel_write_lrh: J1.2, U1.7 (O7)
~sel_write_lrl: J1.9, U1.9 (O6)
~sel_write_marh: J1.8, U1.10 (O5)
~sel_write_marl: J1.7, U1.11 (O4)
~sel_write_pch: J1.4, U1.14 (O1)
~sel_write_pcl: J1.3, U1.15 (O0)
~sel_write_sph: J1.6, U1.12 (O3)
~sel_write_spl: J1.5, U1.13 (O2)
~wr_addr_3: U1.4 (E1), U3.4 (E1), U5.2, U12.2
~wr_addr_4: U1.5 (E2), U5.4
~write_iod_mar: U6.4, U8.15 (O0)

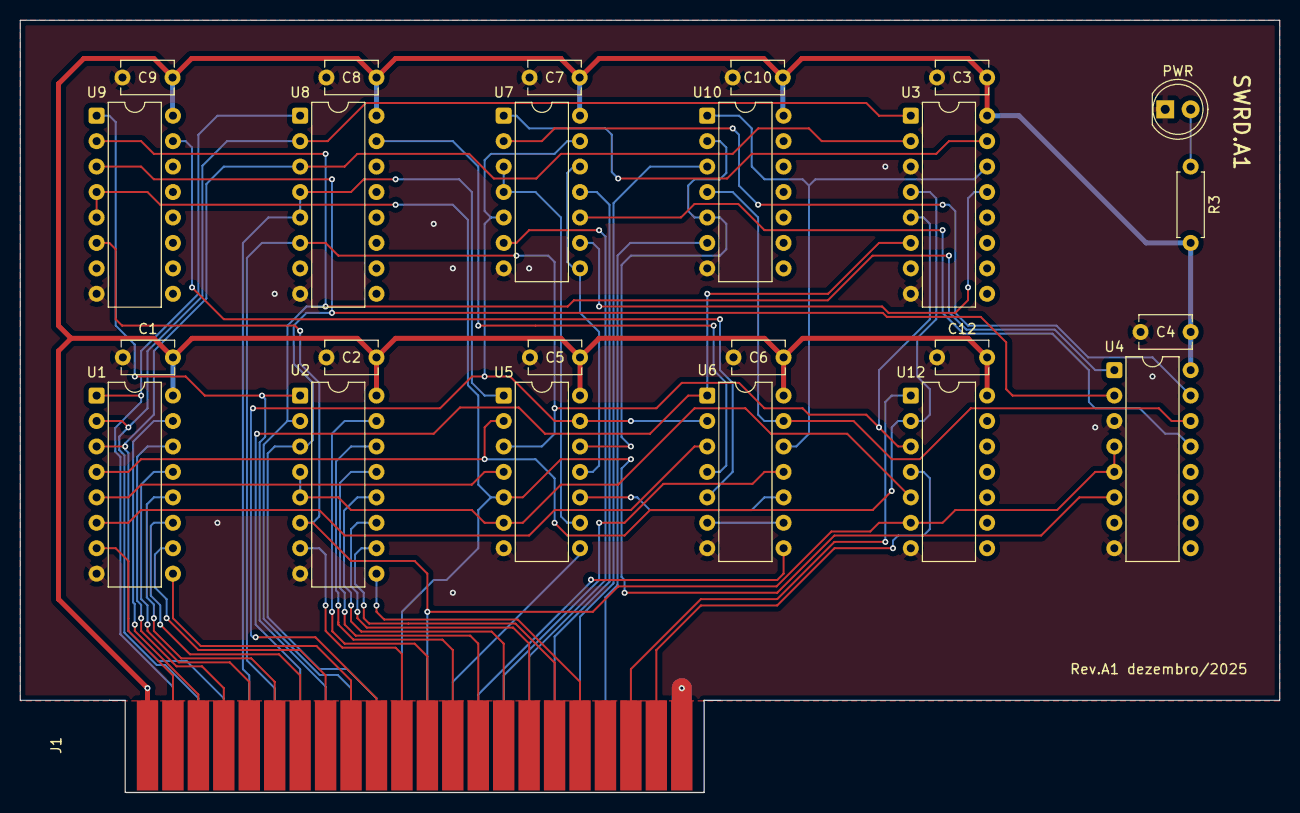
[picture p59: board swrda.kicad_pcb from above]

Board: 2 copper layers, 125.7 x 77.1 mm, 25 parts (0 on the bottom side), 57 nets.
