rcapaverde/cubo/pcb_v2/ex16a/ex16a.kicad_pcb

## KiCad design pcb_v2/ex16a/ex16a.kicad_pcb (2025-12-28, an earlier design)

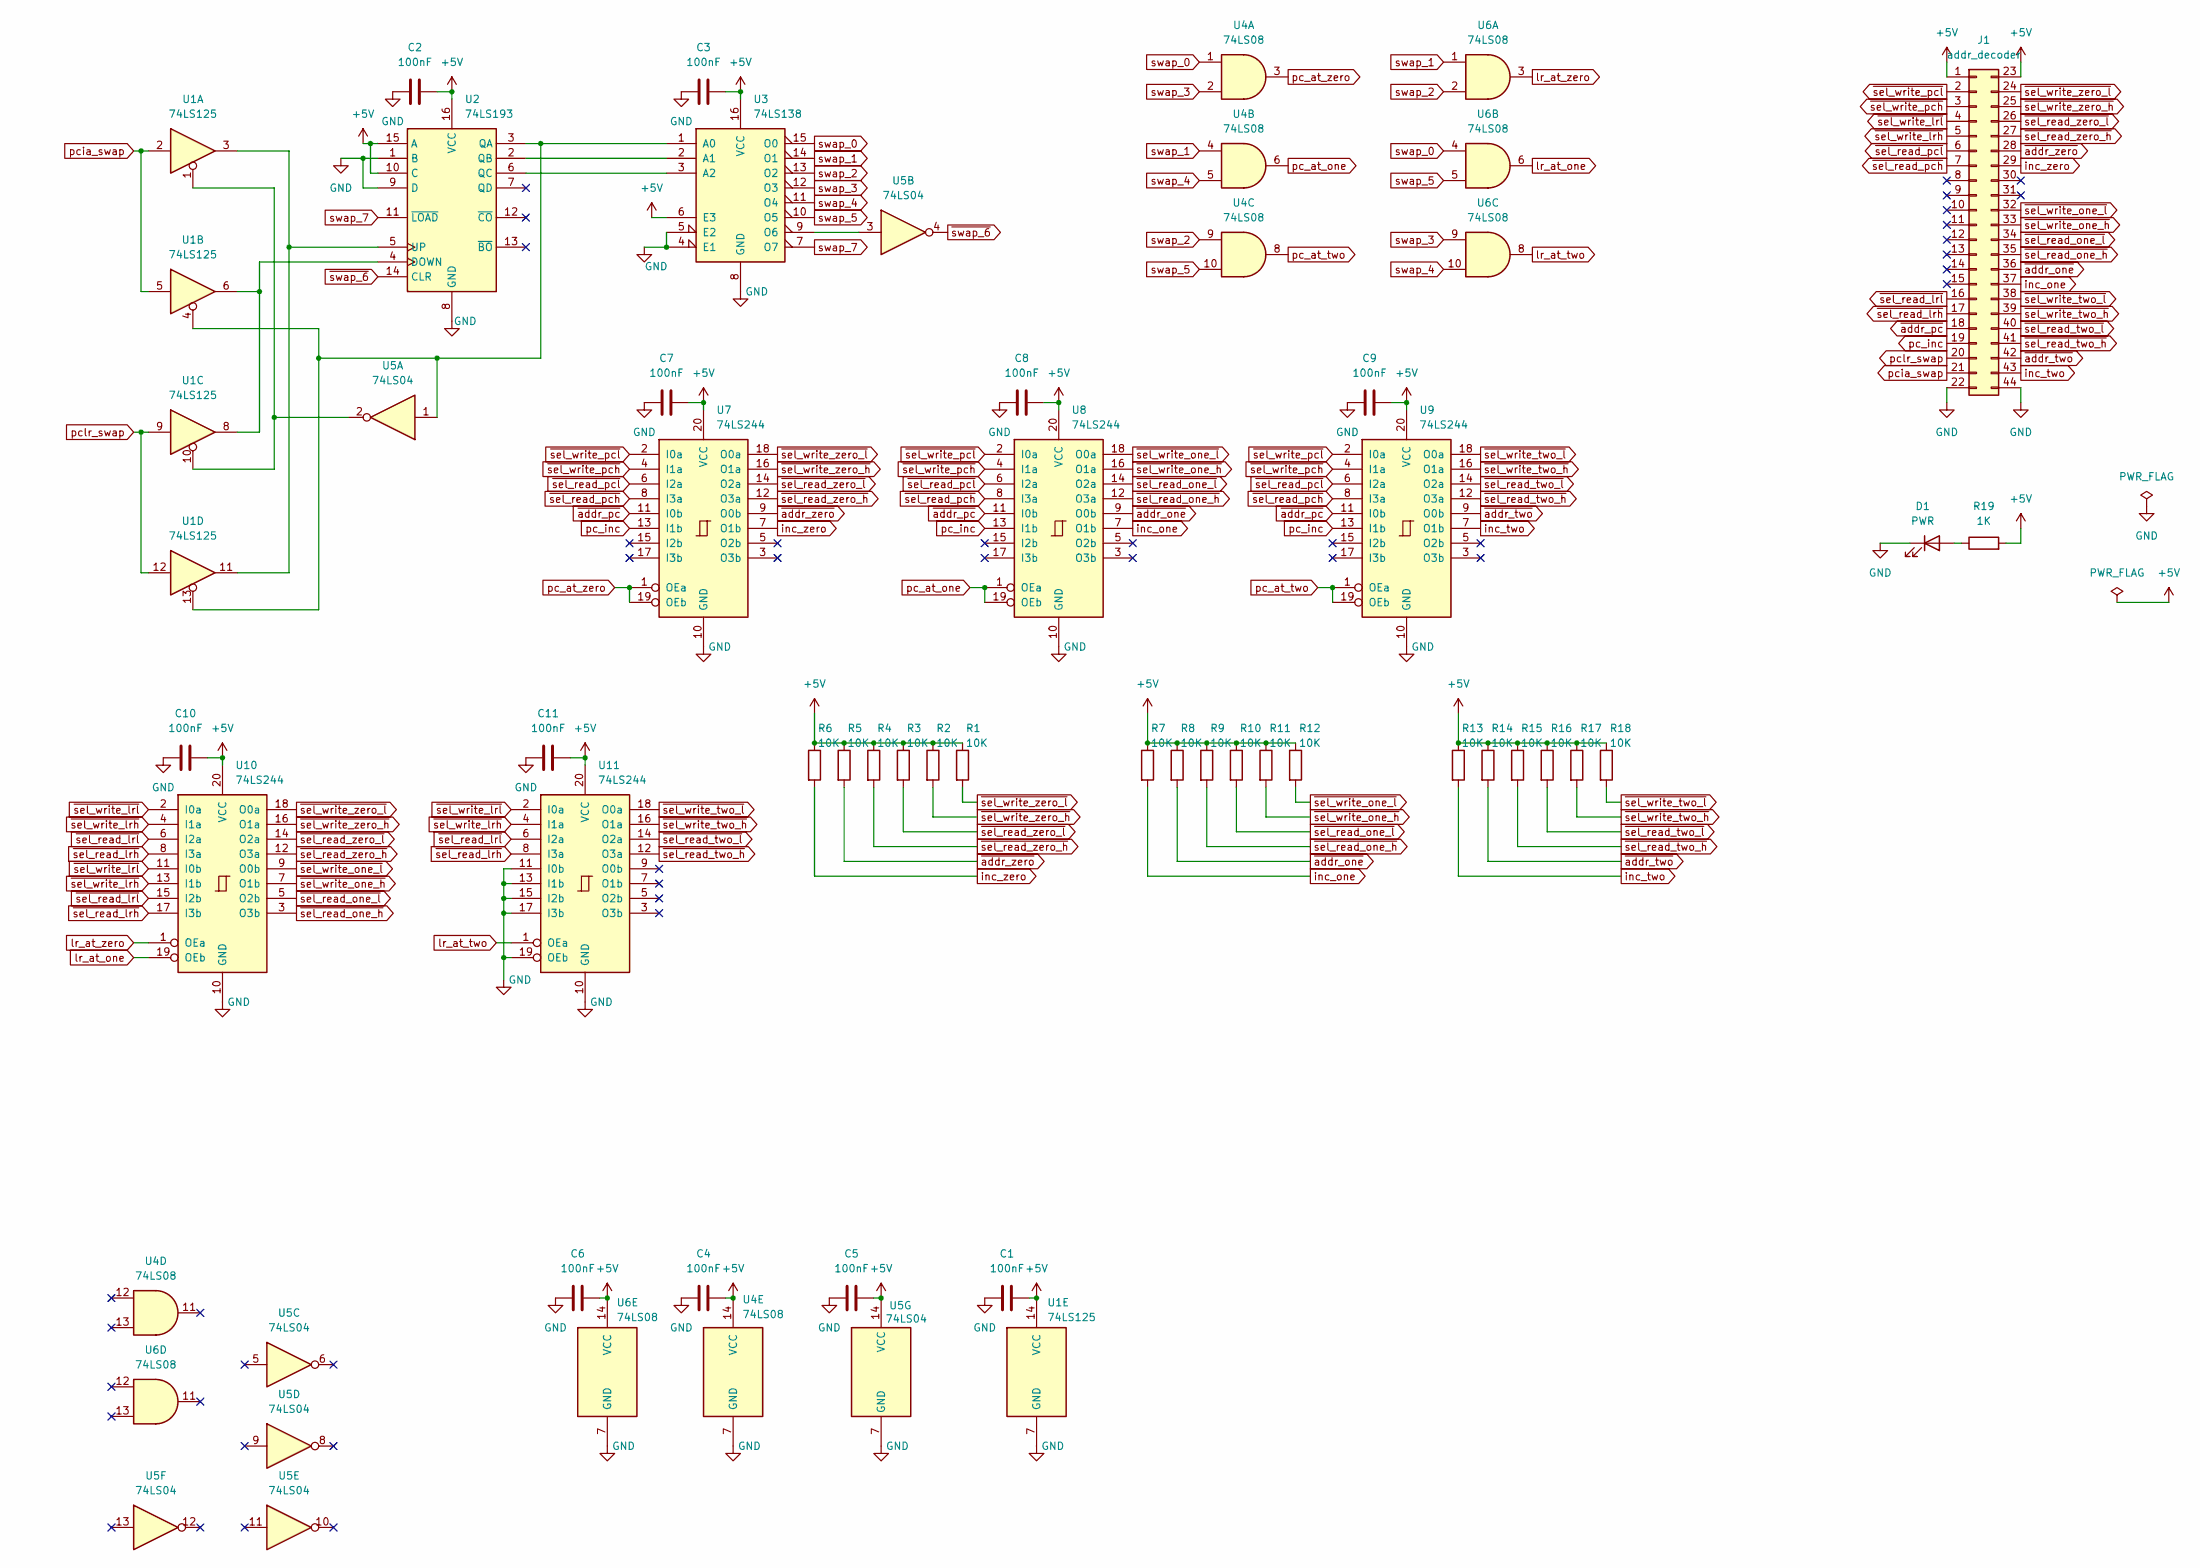
[picture p60: schematic ex16a.kicad_sch]

Parts:
C1, C2, C3, C4, C5, C6, C7, C8, C9, C10, C11: 100nF; C_Disc_D5.1mm_W3.2mm_P5.00mm
D1: PWR; LED_D5.0mm
J1: addr_decoder; edge-connector-44
R1, R2, R3, R4, R5, R6, R7, R8, R9, R10, R11, R12, R13, R14, R15, R16, R17, R18: 10K; R_Axial_DIN0207_L6.3mm_D2.5mm_P7.62mm_Horizontal
R19: 1K; R_Axial_DIN0207_L6.3mm_D2.5mm_P7.62mm_Horizontal
U1: 74LS125; DIP-14_W7.62mm
U2: 74LS193; DIP-16_W7.62mm
U3: 74LS138; DIP-16_W7.62mm
U4, U6: 74LS08; DIP-14_W7.62mm
U5: 74LS04; DIP-14_W7.62mm
U7, U8, U9, U10, U11: 74LS244; DIP-20_W7.62mm

Connections:
+5V: C1.2, C2.2, C3.2, C4.2, C5.2, C6.2, C7.2, C8.2, C9.2, C10.2, C11.2, J1.1, J1.23, R1.1, R2.1, R3.1, R4.1, R5.1, R6.1, R7.1, R8.1, R9.1, R10.1, R11.1, R12.1, R13.1, R14.1, R15.1, R16.1, R17.1, R18.1, R19.2, U1.14 (VCC), U2.10 (C), U2.15 (A), U2.16 (VCC), U3.6 (E3), U3.16 (VCC), U4.14 (VCC), U5.14 (VCC), U6.14 (VCC), U7.20 (VCC), U8.20 (VCC), U9.20 (VCC), U10.20 (VCC), U11.20 (VCC)
GND: C1.1, C2.1, C3.1, C4.1, C5.1, C6.1, C7.1, C8.1, C9.1, C10.1, C11.1, D1.1 (K), J1.22, J1.44, U1.7 (GND), U2.1 (B), U2.8 (GND), U2.9 (D), U3.4 (E1), U3.5 (E2), U3.8 (GND), U4.7 (GND), U5.7 (GND), U6.7 (GND), U7.10 (GND), U8.10 (GND), U9.10 (GND), U10.10 (GND), U11.10 (GND), U11.11 (I0b), U11.13 (I1b), U11.15 (I2b), U11.17 (I3b), U11.19 (OEb)
unnamed: D1.2 (A), R19.1
unnamed: U1.1, U1.10, U5.2
unnamed: U1.6, U1.8, U2.4 (DOWN)
unnamed: U1.4, U1.13, U2.3 (QA), U3.1 (A0), U5.1
unnamed: U2.2 (QB), U3.2 (A1)
unnamed: U2.6 (QC), U3.3 (A2)
unnamed: U1.3, U1.11, U2.5 (UP)
unnamed: U3.9 (O6), U5.3
inc_one: J1.37, R7.2, U8.7 (O1b)
inc_two: J1.43, R13.2, U9.7 (O1b)
inc_zero: J1.29, R6.2, U7.7 (O1b)
lr_at_one: U6.6, U10.19 (OEb)
lr_at_two: U6.8, U11.1 (OEa)
lr_at_zero: U6.3, U10.1 (OEa)
pc_at_one: U4.6, U8.1 (OEa), U8.19 (OEb)
pc_at_two: U4.8, U9.1 (OEa), U9.19 (OEb)
pc_at_zero: U4.3, U7.1 (OEa), U7.19 (OEb)
pc_inc: J1.19, U7.13 (I1b), U8.13 (I1b), U9.13 (I1b)
pcia_swap: J1.21, U1.2, U1.5
pclr_swap: J1.20, U1.9, U1.12
swap_0: U3.15 (O0), U4.1, U6.4
swap_1: U3.14 (O1), U4.4, U6.1
swap_2: U3.13 (O2), U4.9, U6.2
swap_3: U3.12 (O3), U4.2, U6.9
swap_4: U3.11 (O4), U4.5, U6.10
swap_5: U3.10 (O5), U4.10, U6.5
swap_7: U2.11 (~LOAD), U3.7 (O7)
~addr_one: J1.36, R8.2, U8.9 (O0b)
~addr_pc: J1.18, U7.11 (I0b), U8.11 (I0b), U9.11 (I0b)
~addr_two: J1.42, R14.2, U9.9 (O0b)
~addr_zero: J1.28, R5.2, U7.9 (O0b)
~sel_read_lrh: J1.17, U10.8 (I3a), U10.17 (I3b), U11.8 (I3a)
~sel_read_lrl: J1.16, U10.6 (I2a), U10.15 (I2b), U11.6 (I2a)
~sel_read_one_h: J1.35, R9.2, U8.12 (O3a), U10.3 (O3b)
~sel_read_one_l: J1.34, R10.2, U8.14 (O2a), U10.5 (O2b)
~sel_read_pch: J1.7, U7.8 (I3a), U8.8 (I3a), U9.8 (I3a)
~sel_read_pcl: J1.6, U7.6 (I2a), U8.6 (I2a), U9.6 (I2a)
~sel_read_two_h: J1.41, R15.2, U9.12 (O3a), U11.12 (O3a)
~sel_read_two_l: J1.40, R16.2, U9.14 (O2a), U11.14 (O2a)
~sel_read_zero_h: J1.27, R4.2, U7.12 (O3a), U10.12 (O3a)
~sel_read_zero_l: J1.26, R3.2, U7.14 (O2a), U10.14 (O2a)
~sel_write_lrh: J1.5, U10.4 (I1a), U10.13 (I1b), U11.4 (I1a)
~sel_write_lrl: J1.4, U10.2 (I0a), U10.11 (I0b), U11.2 (I0a)
~sel_write_one_h: J1.33, R11.2, U8.16 (O1a), U10.7 (O1b)
~sel_write_one_l: J1.32, R12.2, U8.18 (O0a), U10.9 (O0b)
~sel_write_pch: J1.3, U7.4 (I1a), U8.4 (I1a), U9.4 (I1a)
~sel_write_pcl: J1.2, U7.2 (I0a), U8.2 (I0a), U9.2 (I0a)
~sel_write_two_h: J1.39, R17.2, U9.16 (O1a), U11.16 (O1a)
~sel_write_two_l: J1.38, R18.2, U9.18 (O0a), U11.18 (O0a)
~sel_write_zero_h: J1.25, R2.2, U7.16 (O1a), U10.16 (O1a)
~sel_write_zero_l: J1.24, R1.2, U7.18 (O0a), U10.18 (O0a)
~swap_6: U2.14 (CLR), U5.4

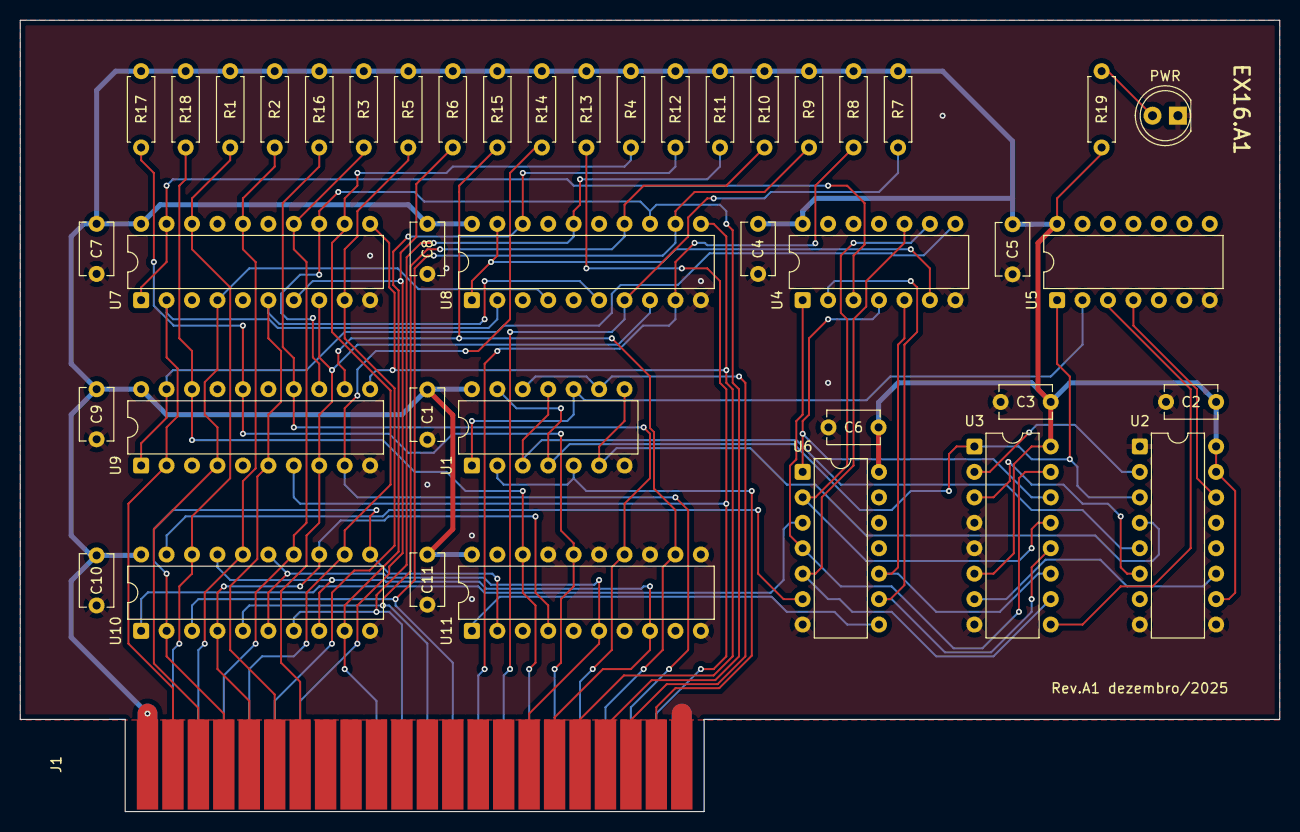
[picture p61: board ex16a.kicad_pcb from above]

Board: 2 copper layers, 125.7 x 79.0 mm, 43 parts (0 on the bottom side), 54 nets.
