rcapaverde/cubo/pcb/regs/regs.kicad_pcb

## KiCad design pcb/regs/regs.kicad_pcb (2025-12-11, an earlier design)

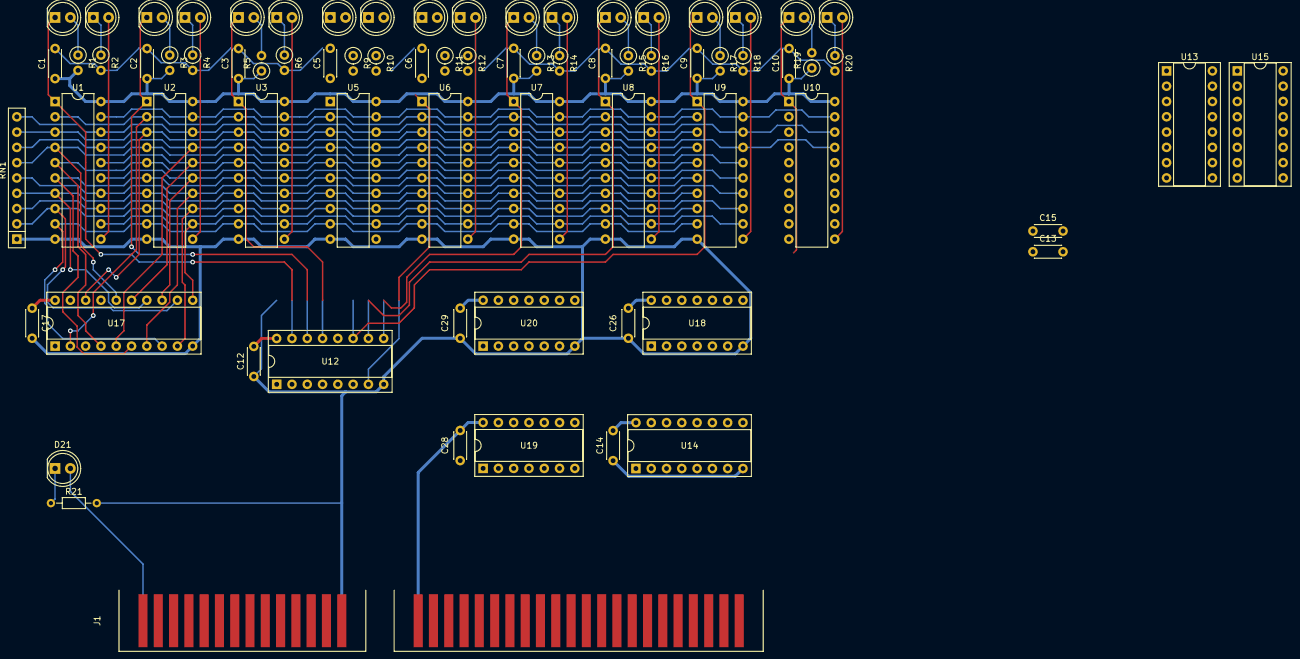
[picture p62: board regs.kicad_pcb from above]

Board: 2 copper layers, 74 parts (0 on the bottom side), 78 nets.

Parts:
C1, C2, C3, C5, C6, C7, C8, C9, C10, C12, C13, C14, C15, C17, C26, C28, C29: 100nF; C_Disc_D4.3mm_W1.9mm_P5.00mm
D1, D2, D3, D4, D5, D6, D9, D10, D11, D12, D13, D14, D15, D16, D17, D18, D19, D20, D21: LED; LED_D5.0mm
J1: BUS; Card Edge Slot 28+44
R1, R2, R3, R4, R5, R6, R9, R10, R11, R12, R13, R14, R15, R16, R17, R18, R19, R20: 470R; R_Axial_DIN0207_L6.3mm_D2.5mm_P2.54mm_Vertical
R21: 470R; R_Axial_DIN0204_L3.6mm_D1.6mm_P7.62mm_Horizontal
RN1: 4K7; R_Array_SIP9
U1, U2, U3, U5, U6, U7, U8, U9, U10: 74LS374; DIP-20_W7.62mm
U12, U13, U14, U15: 74LS138; DIP-16_W7.62mm_Socket
U17: 74LS244; DIP-20_W7.62mm_Socket
U18: 74LS00; DIP-14_W7.62mm_Socket
U19, U20: 74LS06; DIP-14_W7.62mm_Socket

Connections:
BUS_CLOCK: J1.41, U18.2
BUS_DATA_0: J1.2, U1.2 (O0), U2.2 (O0), U3.2 (O0), U5.2 (O0), U6.2 (O0), U7.2 (O0), U8.2 (O0), U9.2 (O0), U10.2 (O0), U17.2 (I0a)
BUS_DATA_1: J1.3, U1.5 (O1), U2.5 (O1), U3.5 (O1), U5.5 (O1), U6.5 (O1), U7.5 (O1), U8.5 (O1), U9.5 (O1), U10.5 (O1), U17.4 (I1a)
BUS_DATA_2: J1.4, U1.6 (O2), U2.6 (O2), U3.6 (O2), U5.6 (O2), U6.6 (O2), U7.6 (O2), U8.6 (O2), U9.6 (O2), U10.6 (O2), U17.6 (I2a)
BUS_DATA_3: J1.5, U1.9 (O3), U2.9 (O3), U3.9 (O3), U5.9 (O3), U6.9 (O3), U7.9 (O3), U8.9 (O3), U9.9 (O3), U10.9 (O3), U17.8 (I3a)
BUS_DATA_4: J1.6, U1.12 (O4), U2.12 (O4), U3.12 (O4), U5.12 (O4), U6.12 (O4), U7.12 (O4), U8.12 (O4), U9.12 (O4), U10.12 (O4), U17.11 (I0b)
BUS_DATA_5: J1.7, U1.15 (O5), U2.15 (O5), U3.15 (O5), U5.15 (O5), U6.15 (O5), U7.15 (O5), U8.15 (O5), U9.15 (O5), U10.15 (O5), U17.13 (I1b)
BUS_DATA_6: J1.8, U1.16 (O6), U2.16 (O6), U3.16 (O6), U5.16 (O6), U6.16 (O6), U7.16 (O6), U8.16 (O6), U9.16 (O6), U10.16 (O6), U17.15 (I2b)
BUS_DATA_7: J1.9, U1.19 (O7), U2.19 (O7), U3.19 (O7), U5.19 (O7), U6.19 (O7), U7.19 (O7), U8.19 (O7), U9.19 (O7), U10.19 (O7), U17.17 (I3b)
BUS_GND: C1.2, C2.2, C3.2, C5.2, C6.2, C7.2, C8.2, C9.2, C10.2, C12.1, C13.1, C14.1, C15.1, C17.2, C26.2, C28.2, C29.2, J1.14, J1.36, J1.50, J1.72, R2.2, R4.2, R6.2, R10.2, R12.2, R14.2, R16.2, R18.2, R20.2, R21.2, RN1.1 (R1.1), U1.10 (GND), U2.10 (GND), U3.10 (GND), U5.10 (GND), U6.10 (GND), U7.10 (GND), U8.10 (GND), U9.10 (GND), U10.10 (GND), U12.8 (GND), U13.8 (GND), U14.8 (GND), U15.8 (GND), U17.10 (GND), U18.7 (GND), U19.7 (GND), U20.7 (GND)
BUS_RD_0: J1.16, U12.1 (A0), U13.1 (A0)
BUS_RD_1: J1.17, U12.2 (A1), U13.2 (A1)
BUS_RD_2: J1.18, U12.3 (A2), U13.3 (A2)
BUS_RD_3: J1.19, U12.6 (E3), U13.4 (E1), U13.5 (E2)
BUS_READ_ENABLE: J1.48, U13.6 (E3), U18.4, U18.5
BUS_VCC: C1.1, C2.1, C3.1, C5.1, C6.1, C7.1, C8.1, C9.1, C10.1, C12.2, C13.2, C14.2, C15.2, C17.1, C26.1, C28.1, C29.1, D21.2 (A), J1.1, J1.15, J1.37, J1.51, R1.2, R3.2, R5.1, R9.1, R11.1, R13.2, R15.2, R17.2, R19.1, U1.20 (VCC), U2.20 (VCC), U3.20 (VCC), U5.20 (VCC), U6.20 (VCC), U7.20 (VCC), U8.20 (VCC), U9.20 (VCC), U10.20 (VCC), U12.16 (VCC), U13.16 (VCC), U14.16 (VCC), U15.16 (VCC), U17.20 (VCC), U18.14 (VCC), U19.14 (VCC), U20.14 (VCC)
BUS_WRITE_ENABLE: J1.47, U17.1 (OEa), U17.19 (OEb), U18.1
BUS_WR_0: J1.20, U14.1 (A0), U15.1 (A0)
BUS_WR_1: J1.21, U14.2 (A1), U15.2 (A1)
BUS_WR_2: J1.22, U14.3 (A2), U15.3 (A2)
BUS_WR_3: J1.23, U14.6 (E3), U15.4 (E1), U15.5 (E2)
DATA_0: RN1.8 (R7.2), U1.3 (D0), U2.3 (D0), U3.3 (D0), U5.3 (D0), U6.3 (D0), U7.3 (D0), U8.3 (D0), U9.3 (D0), U10.3 (D0), U17.18 (O0a)
DATA_1: RN1.6 (R5.2), U1.4 (D1), U2.4 (D1), U3.4 (D1), U5.4 (D1), U6.4 (D1), U7.4 (D1), U8.4 (D1), U9.4 (D1), U10.4 (D1), U17.16 (O1a)
DATA_2: RN1.4 (R3.2), U1.7 (D2), U2.7 (D2), U3.7 (D2), U5.7 (D2), U6.7 (D2), U7.7 (D2), U8.7 (D2), U9.7 (D2), U10.7 (D2), U17.14 (O2a)
DATA_3: RN1.2 (R1.2), U1.8 (D3), U2.8 (D3), U3.8 (D3), U5.8 (D3), U6.8 (D3), U7.8 (D3), U8.8 (D3), U9.8 (D3), U10.8 (D3), U17.12 (O3a)
DATA_4: RN1.3 (R2.2), U1.13 (D4), U2.13 (D4), U3.13 (D4), U5.13 (D4), U6.13 (D4), U7.13 (D4), U8.13 (D4), U9.13 (D4), U10.13 (D4), U17.9 (O0b)
DATA_5: RN1.5 (R4.2), U1.14 (D5), U2.14 (D5), U3.14 (D5), U5.14 (D5), U6.14 (D5), U7.14 (D5), U8.14 (D5), U9.14 (D5), U10.14 (D5), U17.7 (O1b)
DATA_6: RN1.7 (R6.2), U1.17 (D6), U2.17 (D6), U3.17 (D6), U5.17 (D6), U6.17 (D6), U7.17 (D6), U8.17 (D6), U9.17 (D6), U10.17 (D6), U17.5 (O2b)
DATA_7: RN1.9 (R8.2), U1.18 (D7), U2.18 (D7), U3.18 (D7), U5.18 (D7), U6.18 (D7), U7.18 (D7), U8.18 (D7), U9.18 (D7), U10.18 (D7), U17.3 (O3b)
unnamed: D1.2 (A), R1.1
unnamed: D2.1 (K), R2.1
unnamed: D3.2 (A), R3.1
unnamed: D4.1 (K), R4.1
unnamed: D5.2 (A), R5.2
unnamed: D6.1 (K), R6.1
unnamed: D9.2 (A), R9.2
unnamed: D10.1 (K), R10.1
unnamed: D11.2 (A), R11.2
unnamed: D12.1 (K), R12.1
unnamed: D13.2 (A), R13.1
unnamed: D14.1 (K), R14.1
unnamed: D15.2 (A), R15.1
unnamed: D16.1 (K), R16.1
unnamed: D17.2 (A), R17.1
unnamed: D18.1 (K), R18.1
unnamed: D19.2 (A), R19.2
unnamed: D20.1 (K), R20.1
unnamed: D21.1 (K), R21.1
unnamed: U12.4 (E1), U12.5 (E2), U18.6
unnamed: U14.4 (E1), U14.5 (E2), U18.3, U18.9, U18.10
unnamed: U14.7 (O7), U20.9
unnamed: U14.9 (O6), U20.5
unnamed: U14.10 (O5), U20.3
unnamed: U14.11 (O4), U20.1
unnamed: U14.13 (O2), U19.5
unnamed: U14.14 (O1), U19.3
unnamed: U14.15 (O0), U19.1
unnamed: U15.6 (E3), U18.8
unnamed: U15.9 (O6), U19.9
unnamed: U15.7 (O7), U19.11
RD_A_INV: D1.1 (K), U1.1 (OE), U12.15 (O0)
RD_B_INV: D3.1 (K), U2.1 (OE), U12.14 (O1)
RD_C_INV: D5.1 (K), U3.1 (OE), U12.13 (O2)
RD_SPH_INV: D17.1 (K), U9.1 (OE), U13.7 (O7)
RD_SPL_INV: D19.1 (K), U10.1 (OE), U13.9 (O6)
RD_XH_INV: D15.1 (K), U8.1 (OE), U12.10 (O5)
RD_XL_INV: D13.1 (K), U7.1 (OE), U12.11 (O4)
RD_YH_INV: D11.1 (K), U6.1 (OE), U12.7 (O7)
RD_YL_INV: D9.1 (K), U5.1 (OE), U12.9 (O6)
WR_A: D2.2 (A), U1.11 (Cp), U19.2
WR_B: D4.2 (A), U2.11 (Cp), U19.4
WR_C: D6.2 (A), U3.11 (Cp), U19.6
WR_SPH: D18.2 (A), U9.11 (Cp), U19.10
WR_SPL: D20.2 (A), U10.11 (Cp), U19.8
WR_XH: D16.2 (A), U8.11 (Cp), U20.4
WR_XL: D14.2 (A), U7.11 (Cp), U20.2
WR_YH: D12.2 (A), U6.11 (Cp), U20.8
WR_YL: D10.2 (A), U5.11 (Cp), U20.6
