rcapaverde/cubo/pcb_v2/ula8-rom/ula8-rom.kicad_pcb

## KiCad design pcb_v2/ula8-rom/ula8-rom.kicad_pcb (2025-12-11, an earlier design)

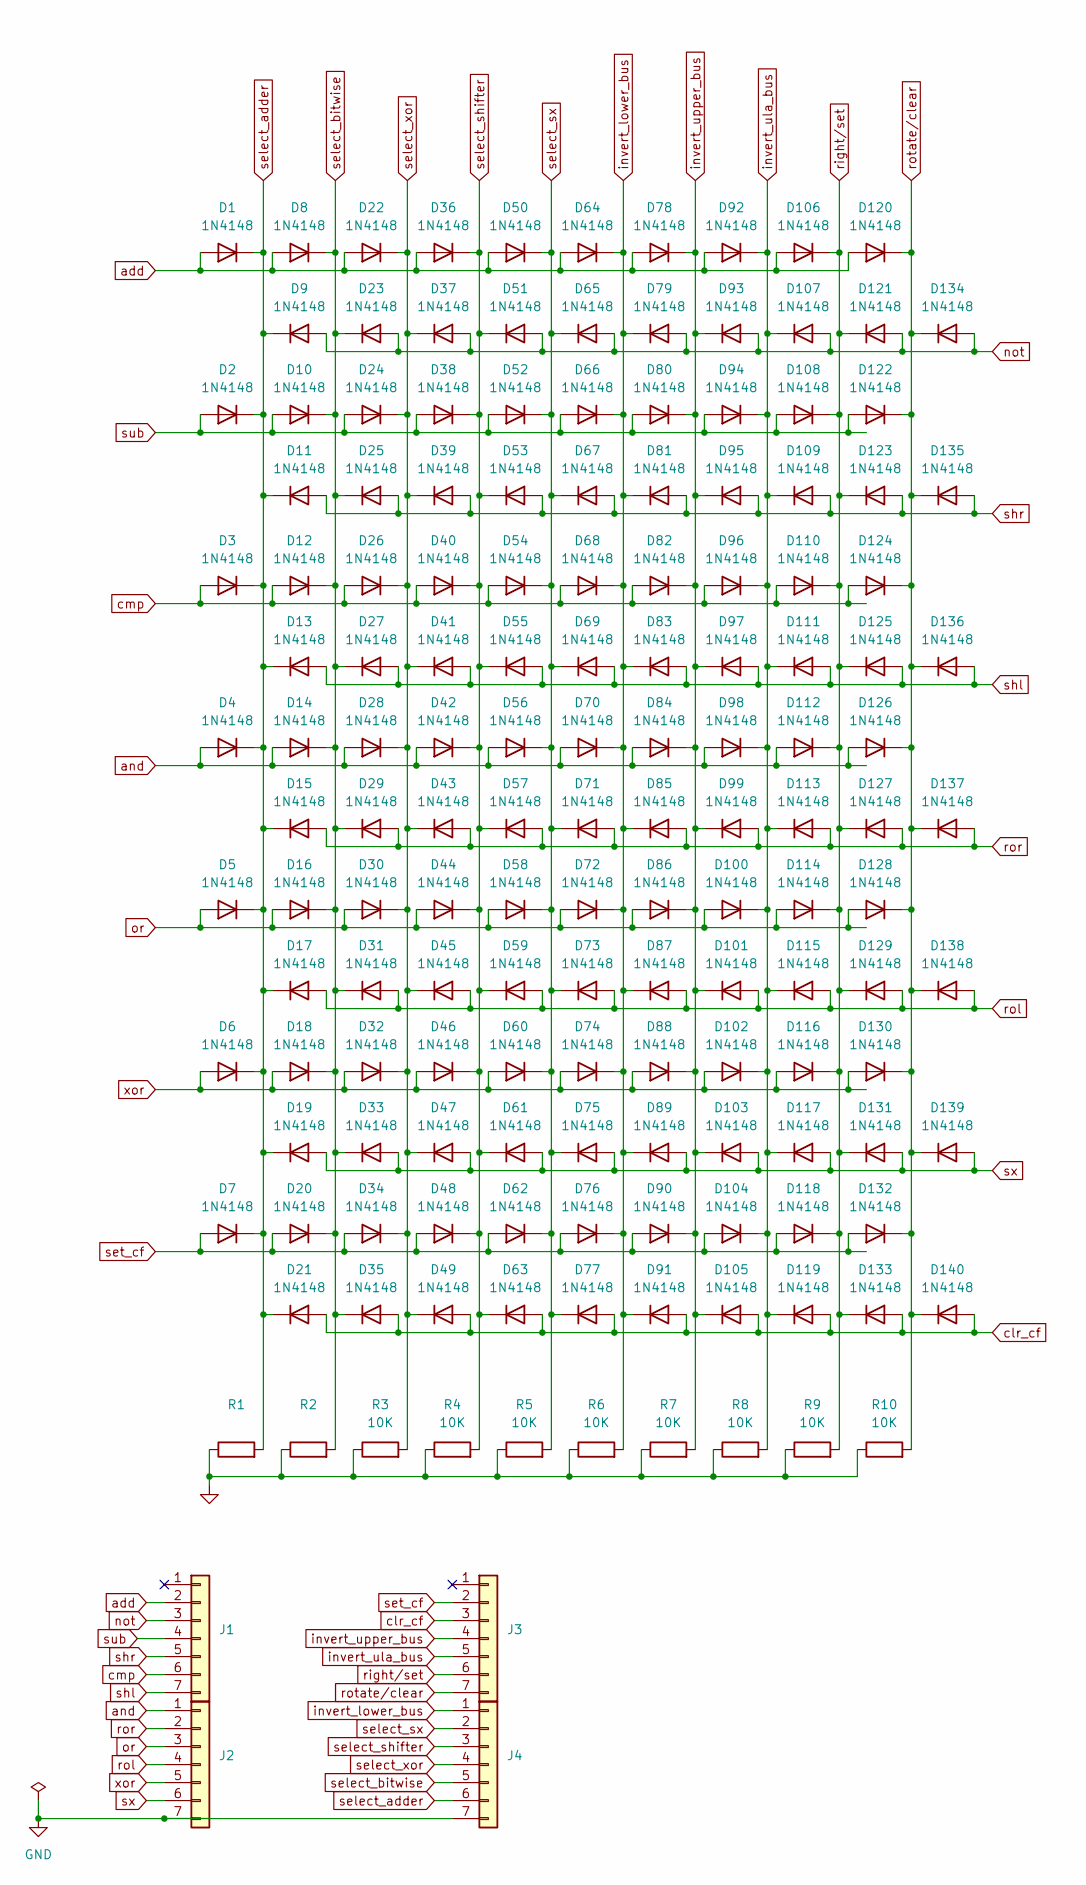
[picture p63: schematic ula8-rom.kicad_sch]

Parts:
D1, D2, D3, D4, D5, D6, D7, D8, D9, D10, D11, D12, D13, D14, D15, D16, D17, D18, D19, D20, D21, D22, D23, D24, D25, D26, D27, D28, D29, D30, D31, D32, D33, D34, D35, D36, D37, D38, D39, D40, D41, D42, D43, D44, D45, D46, D47, D48, D49, D50, D51, D52, D53, D54, D55, D56, D57, D58, D59, D60, D61, D62, D63, D64, D65, D66, D67, D68, D69, D70, D71, D72, D73, D74, D75, D76, D77, D78, D79, D80, D81, D82, D83, D84, D85, D86, D87, D88, D89, D90, D91, D92, D93, D94, D95, D96, D97, D98, D99, D100, D101, D102, D103, D104, D105, D106, D107, D108, D109, D110, D111, D112, D113, D114, D115, D116, D117, D118, D119, D120, D121, D122, D123, D124, D125, D126, D127, D128, D129, D130, D131, D132, D133, D134, D135, D136, D137, D138, D139, D140: 1N4148; D_DO-35_SOD27_P7.62mm_Horizontal
J1, J2, J3, J4: (no value)
R1, R2: (no value)
R3, R4, R5, R6, R7, R8, R9, R10: 10K

Connections:
add: D1.2 (A), D8.2 (A), D22.2 (A), D36.2 (A), D50.2 (A), D64.2 (A), D78.2 (A), D92.2 (A), D106.2 (A), D120.2 (A), J1.2
and: D4.2 (A), D14.2 (A), D28.2 (A), D42.2 (A), D56.2 (A), D70.2 (A), D84.2 (A), D98.2 (A), D112.2 (A), D126.2 (A), J2.1
clr_cf: D21.2 (A), D35.2 (A), D49.2 (A), D63.2 (A), D77.2 (A), D91.2 (A), D105.2 (A), D119.2 (A), D133.2 (A), D140.2 (A), J3.3
cmp: D3.2 (A), D12.2 (A), D26.2 (A), D40.2 (A), D54.2 (A), D68.2 (A), D82.2 (A), D96.2 (A), D110.2 (A), D124.2 (A), J1.6
invert_lower_bus: D64.1 (K), D66.1 (K), D68.1 (K), D70.1 (K), D72.1 (K), D74.1 (K), D76.1 (K), D79.1 (K), D81.1 (K), D83.1 (K), D85.1 (K), D87.1 (K), D89.1 (K), D91.1 (K), J4.1, R6.2
invert_ula_bus: D92.1 (K), D94.1 (K), D96.1 (K), D98.1 (K), D100.1 (K), D102.1 (K), D104.1 (K), D107.1 (K), D109.1 (K), D111.1 (K), D113.1 (K), D115.1 (K), D117.1 (K), D119.1 (K), J3.5, R8.2
invert_upper_bus: D78.1 (K), D80.1 (K), D82.1 (K), D84.1 (K), D86.1 (K), D88.1 (K), D90.1 (K), D93.1 (K), D95.1 (K), D97.1 (K), D99.1 (K), D101.1 (K), D103.1 (K), D105.1 (K), J3.4, R7.2
not: D9.2 (A), D23.2 (A), D37.2 (A), D51.2 (A), D65.2 (A), D79.2 (A), D93.2 (A), D107.2 (A), D121.2 (A), D134.2 (A), J1.3
or: D5.2 (A), D16.2 (A), D30.2 (A), D44.2 (A), D58.2 (A), D72.2 (A), D86.2 (A), D100.2 (A), D114.2 (A), D128.2 (A), J2.3
right/set: D106.1 (K), D108.1 (K), D110.1 (K), D112.1 (K), D114.1 (K), D116.1 (K), D118.1 (K), D121.1 (K), D123.1 (K), D125.1 (K), D127.1 (K), D129.1 (K), D131.1 (K), D133.1 (K), J3.6, R9.2
rol: D17.2 (A), D31.2 (A), D45.2 (A), D59.2 (A), D73.2 (A), D87.2 (A), D101.2 (A), D115.2 (A), D129.2 (A), D138.2 (A), J2.4
ror: D15.2 (A), D29.2 (A), D43.2 (A), D57.2 (A), D71.2 (A), D85.2 (A), D99.2 (A), D113.2 (A), D127.2 (A), D137.2 (A), J2.2
rotate/clear: D120.1 (K), D122.1 (K), D124.1 (K), D126.1 (K), D128.1 (K), D130.1 (K), D132.1 (K), D134.1 (K), D135.1 (K), D136.1 (K), D137.1 (K), D138.1 (K), D139.1 (K), D140.1 (K), J3.7, R10.2
select_adder: D1.1 (K), D2.1 (K), D3.1 (K), D4.1 (K), D5.1 (K), D6.1 (K), D7.1 (K), D9.1 (K), D11.1 (K), D13.1 (K), D15.1 (K), D17.1 (K), D19.1 (K), D21.1 (K), J4.6, R1.2
select_bitwise: D8.1 (K), D10.1 (K), D12.1 (K), D14.1 (K), D16.1 (K), D18.1 (K), D20.1 (K), D23.1 (K), D25.1 (K), D27.1 (K), D29.1 (K), D31.1 (K), D33.1 (K), D35.1 (K), J4.5, R2.2
select_shifter: D36.1 (K), D38.1 (K), D40.1 (K), D42.1 (K), D44.1 (K), D46.1 (K), D48.1 (K), D51.1 (K), D53.1 (K), D55.1 (K), D57.1 (K), D59.1 (K), D61.1 (K), D63.1 (K), J4.3, R4.2
select_sx: D50.1 (K), D52.1 (K), D54.1 (K), D56.1 (K), D58.1 (K), D60.1 (K), D62.1 (K), D65.1 (K), D67.1 (K), D69.1 (K), D71.1 (K), D73.1 (K), D75.1 (K), D77.1 (K), J4.2, R5.2
select_xor: D22.1 (K), D24.1 (K), D26.1 (K), D28.1 (K), D30.1 (K), D32.1 (K), D34.1 (K), D37.1 (K), D39.1 (K), D41.1 (K), D43.1 (K), D45.1 (K), D47.1 (K), D49.1 (K), J4.4, R3.2
set_cf: D7.2 (A), D20.2 (A), D34.2 (A), D48.2 (A), D62.2 (A), D76.2 (A), D90.2 (A), D104.2 (A), D118.2 (A), D132.2 (A), J3.2
shl: D13.2 (A), D27.2 (A), D41.2 (A), D55.2 (A), D69.2 (A), D83.2 (A), D97.2 (A), D111.2 (A), D125.2 (A), D136.2 (A), J1.7
shr: D11.2 (A), D25.2 (A), D39.2 (A), D53.2 (A), D67.2 (A), D81.2 (A), D95.2 (A), D109.2 (A), D123.2 (A), D135.2 (A), J1.5
sub: D2.2 (A), D10.2 (A), D24.2 (A), D38.2 (A), D52.2 (A), D66.2 (A), D80.2 (A), D94.2 (A), D108.2 (A), D122.2 (A), J1.4
sx: D19.2 (A), D33.2 (A), D47.2 (A), D61.2 (A), D75.2 (A), D89.2 (A), D103.2 (A), D117.2 (A), D131.2 (A), D139.2 (A), J2.6
xor: D6.2 (A), D18.2 (A), D32.2 (A), D46.2 (A), D60.2 (A), D74.2 (A), D88.2 (A), D102.2 (A), D116.2 (A), D130.2 (A), J2.5

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
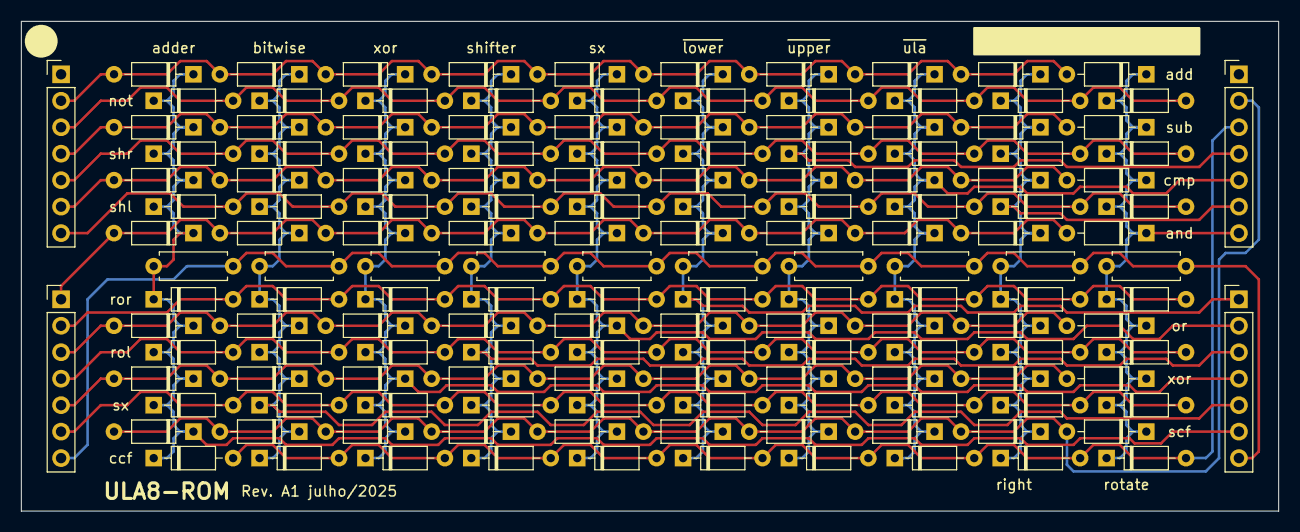
[picture p64: board ula8-rom.kicad_pcb from above]

Board: 2 copper layers, 120.6 x 47.0 mm, 154 parts (0 on the bottom side), 25 nets.
