rcapaverde/cubo/pcb/ula/ula.kicad_pcb

## KiCad design pcb/ula/ula.kicad_pcb (2025-12-11, an earlier design)

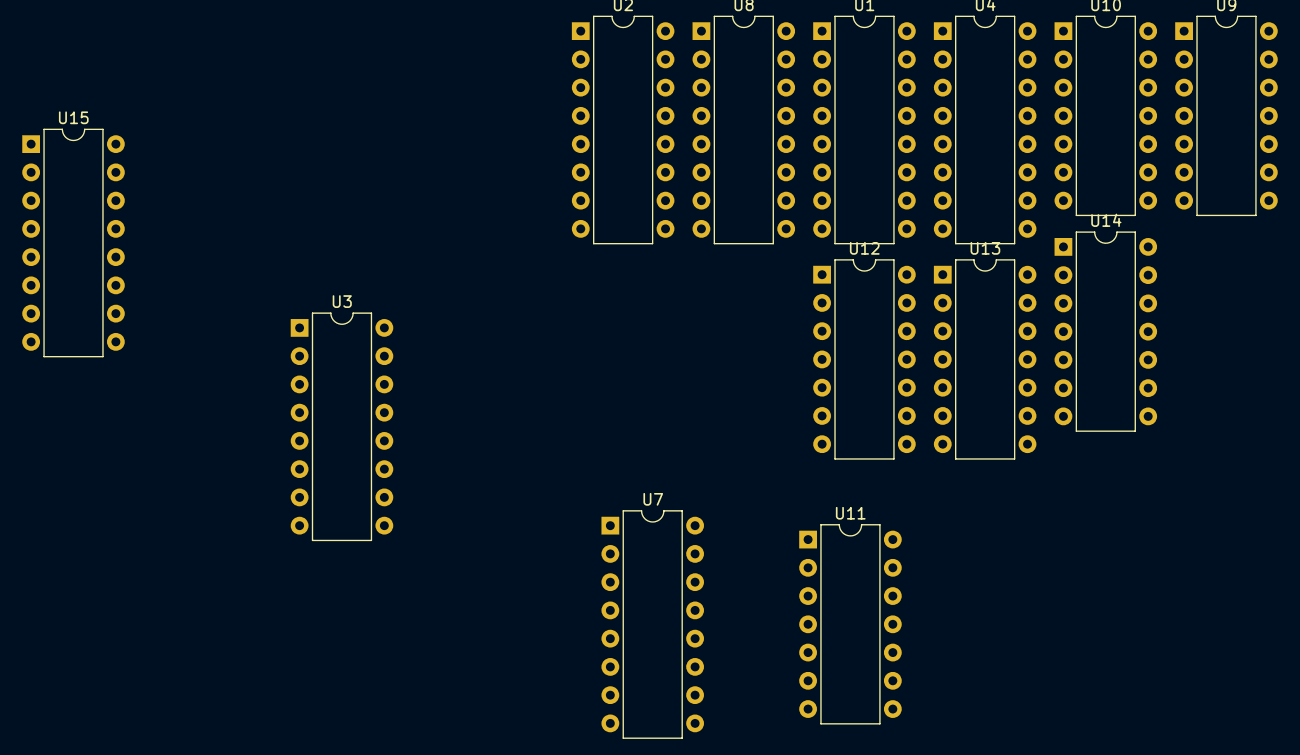
[picture p65: board ula.kicad_pcb from above]

Board: 2 copper layers, 13 parts (0 on the bottom side), 22 nets, no tracks yet.

Parts:
U1, U2, U3, U4: 74LS283; DIP-16_W7.62mm
U7, U8, U15: 74LS175; DIP-16_W7.62mm
U9, U10: 74LS08; DIP-14_W7.62mm
U11, U12: 74LS32; DIP-14_W7.62mm
U13, U14: 74LS86; DIP-14_W7.62mm

Connections:
+5V: U1.16 (VCC), U2.16 (VCC), U3.16 (VCC), U4.16 (VCC), U7.16 (VCC), U8.16 (VCC), U9.14 (VCC), U10.14 (VCC), U11.14 (VCC), U12.14 (VCC), U13.14 (VCC), U14.14 (VCC), U15.16 (VCC)
FLAG_C: U1.7 (C0), U15.7 (Q1)
FLAG_C_INV: U3.7 (C0), U15.6 (~Q1)
GND: U1.8 (GND), U2.8 (GND), U3.8 (GND), U4.8 (GND), U7.8 (GND), U8.8 (GND), U9.7 (GND), U10.7 (GND), U11.7 (GND), U12.7 (GND), U13.7 (GND), U14.7 (GND), U15.8 (GND)
unnamed: U1.9 (C4), U2.7 (C0)
unnamed: U2.2 (B2), U8.7 (Q1), U10.5, U12.5, U14.5
unnamed: U2.15 (B3), U8.10 (Q2), U10.10, U12.10, U14.10
unnamed: U3.9 (C4), U4.7 (C0)
unnamed: U1.6 (B1), U7.2 (Q0), U9.2, U11.2, U13.2
unnamed: U3.6 (B1), U7.3 (~Q0)
unnamed: U3.2 (B2), U7.6 (~Q1)
unnamed: U1.2 (B2), U7.7 (Q1), U9.5, U11.5, U13.5
unnamed: U1.15 (B3), U7.10 (Q2), U9.10, U11.10, U13.10
unnamed: U3.15 (B3), U7.11 (~Q2)
unnamed: U3.11 (B4), U7.14 (~Q3)
unnamed: U1.11 (B4), U7.15 (Q3), U9.13, U11.13, U13.13
unnamed: U4.6 (B1), U8.3 (~Q0)
unnamed: U4.2 (B2), U8.6 (~Q1)
unnamed: U4.15 (B3), U8.11 (~Q2)
unnamed: U4.11 (B4), U8.14 (~Q3)
unnamed: U2.11 (B4), U8.15 (Q3), U10.13, U12.13, U14.13
unnamed: U2.6 (B1), U8.2 (Q0), U10.2, U12.2, U14.2
