rcapaverde/cubo/pcb/mem/mem.kicad_pcb

## KiCad design pcb/mem/mem.kicad_pcb (2025-12-11, an earlier design)

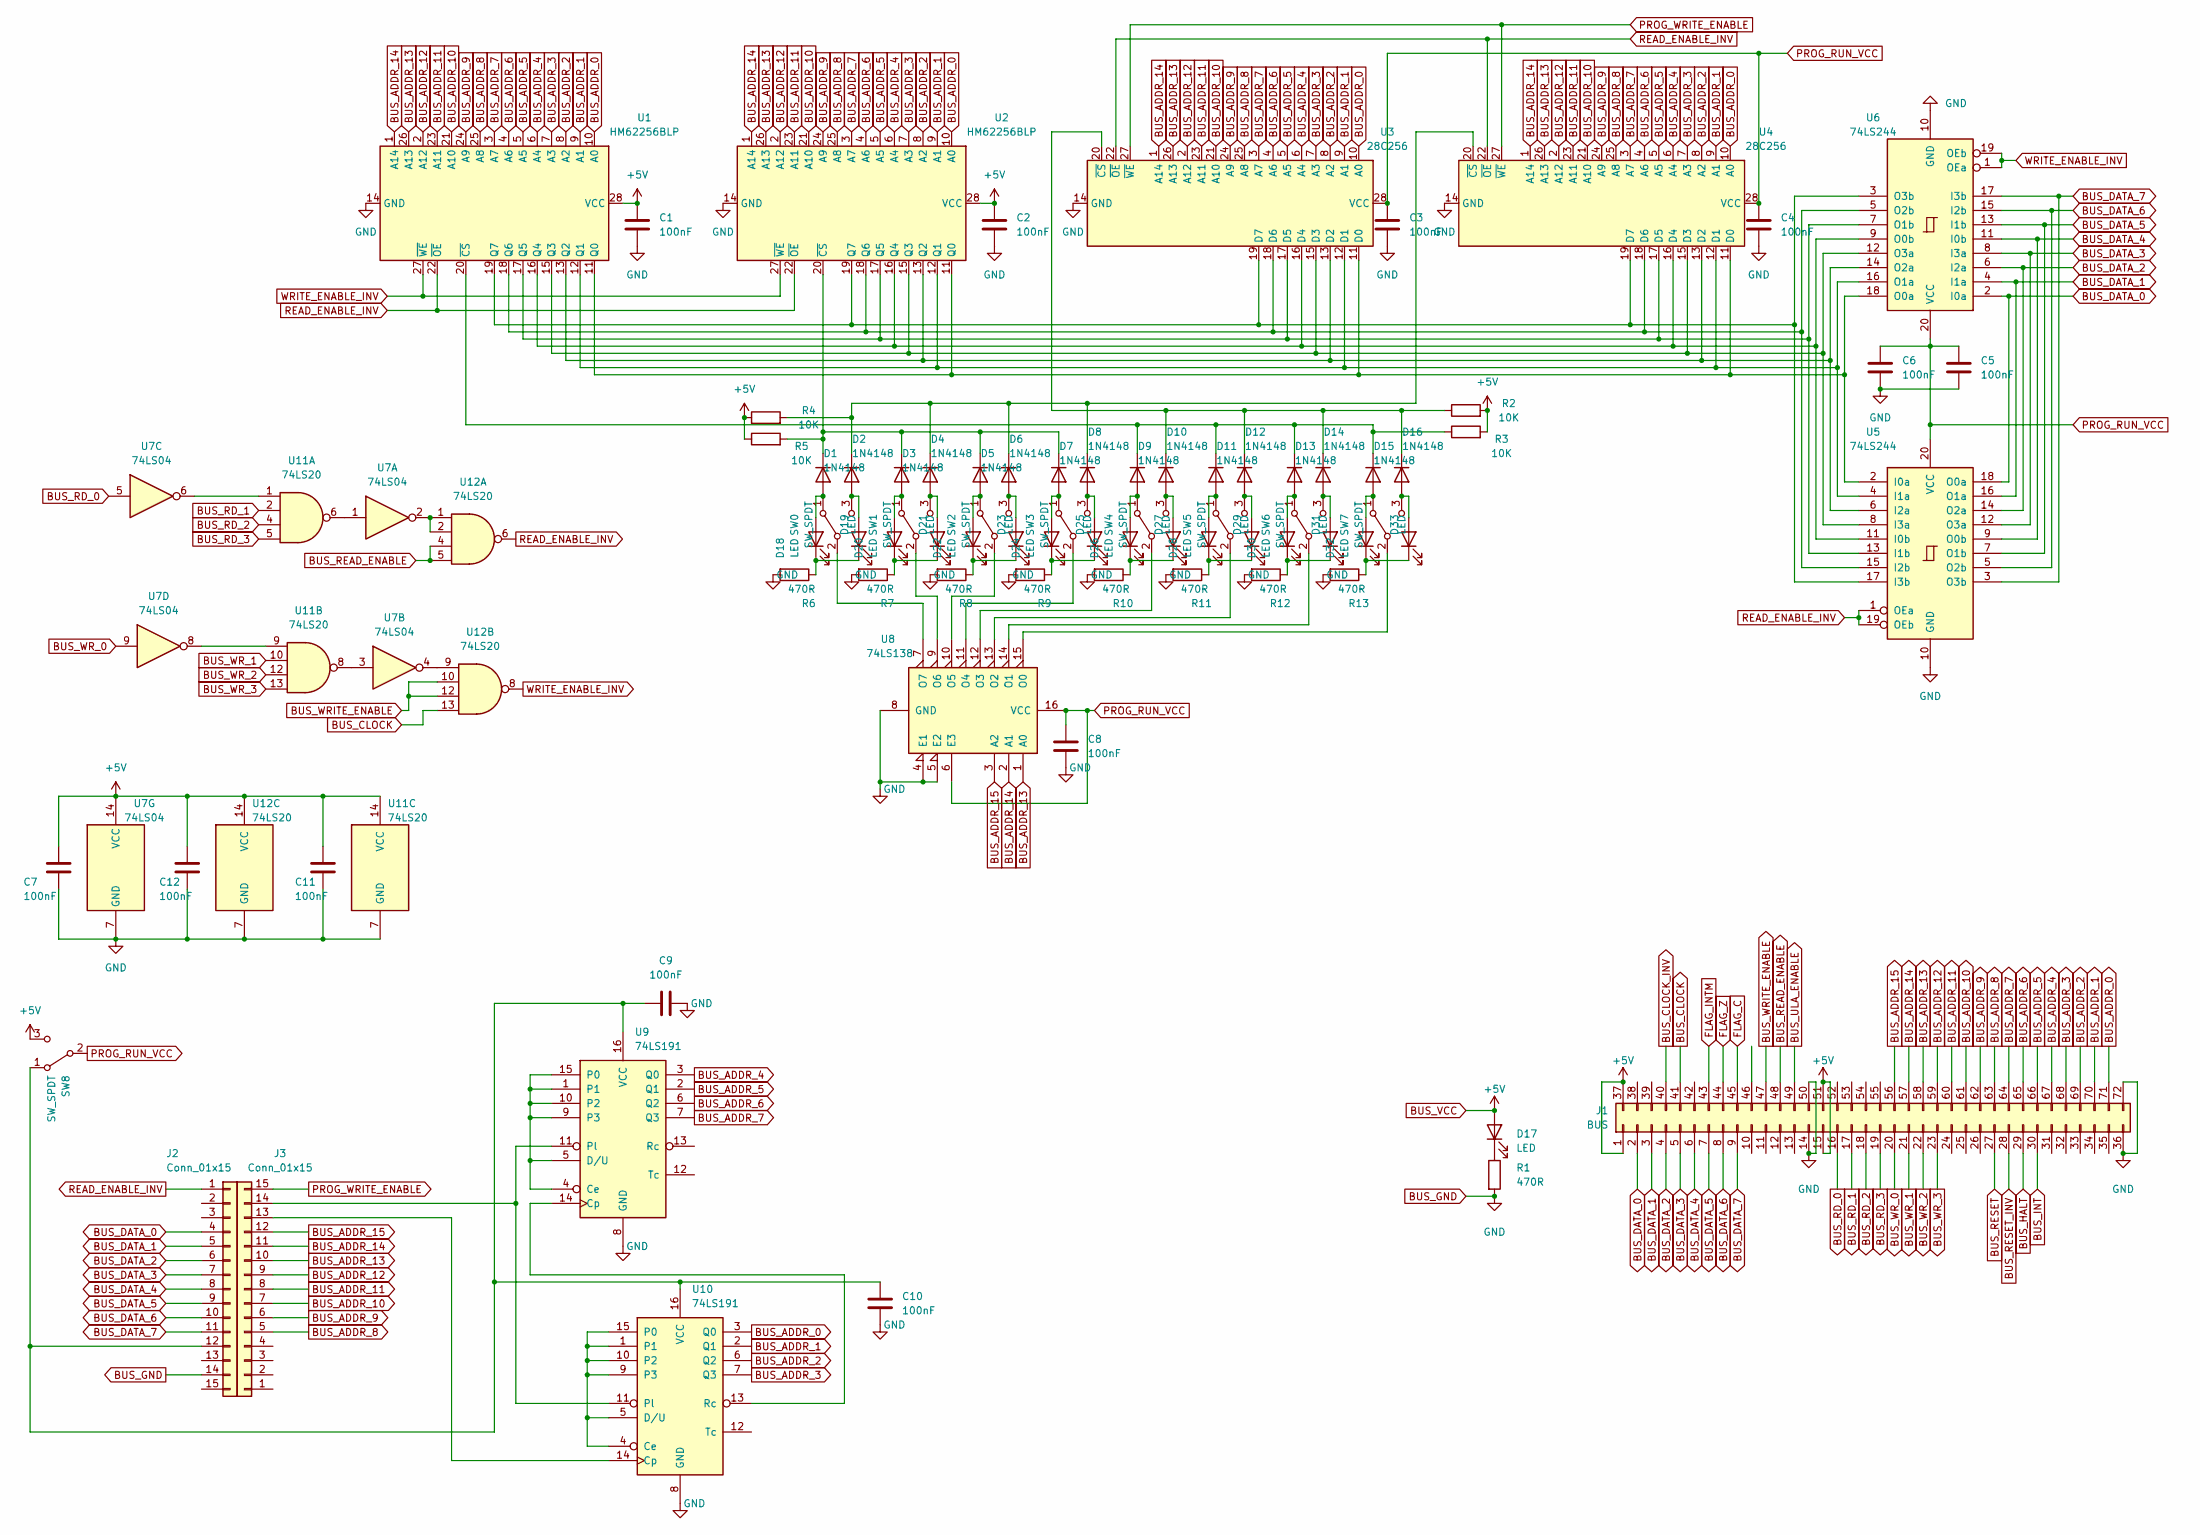
[picture p66: schematic mem.kicad_sch]

Parts:
C1, C2, C3, C4, C5, C6, C7, C8, C9, C10, C11, C12: 100nF; C_Disc_D4.3mm_W1.9mm_P5.00mm
D1, D2, D3, D4, D5, D6, D7, D8, D9, D10, D11, D12, D13, D14, D15, D16: 1N4148; D_DO-35_SOD27_P7.62mm_Horizontal
D17, D18, D19, D20, D21, D22, D23, D24, D25, D26, D27, D28, D29, D30, D31, D32, D33: LED; LED_D5.0mm
J1: BUS; Card Edge Slot 28+44
J2, J3: Conn_01x15; PinHeader_1x15_P2.54mm_Vertical
R1, R6, R7, R8, R9, R10, R11, R12, R13: 470R; R_Axial_DIN0204_L3.6mm_D1.6mm_P7.62mm_Horizontal
R2, R3, R4, R5: 10K; R_Axial_DIN0204_L3.6mm_D1.6mm_P7.62mm_Horizontal
SW0, SW1, SW2, SW3, SW4, SW5, SW6, SW7, SW8: SW_SPDT; PinHeader_1x03_P2.54mm_Vertical
U1, U2: HM62256BLP; DIP-28_W15.24mm
U3, U4: 28C256; DIP-28_W15.24mm_Socket
U5, U6: 74LS244; DIP-20_W7.62mm_Socket
U7: 74LS04; DIP-14_W7.62mm_Socket
U8: 74LS138; DIP-16_W7.62mm_Socket
U9, U10: 74LS191; DIP-16_W7.62mm_Socket
U11, U12: 74LS20; DIP-14_W7.62mm_Socket

Connections:
BUS_ADDR_0: J1.71, U1.10 (A0), U2.10 (A0), U3.10 (A0), U4.10 (A0), U10.3 (Q0)
BUS_ADDR_1: J1.70, U1.9 (A1), U2.9 (A1), U3.9 (A1), U4.9 (A1), U10.2 (Q1)
BUS_ADDR_2: J1.69, U1.8 (A2), U2.8 (A2), U3.8 (A2), U4.8 (A2), U10.6 (Q2)
BUS_ADDR_3: J1.68, U1.7 (A3), U2.7 (A3), U3.7 (A3), U4.7 (A3), U10.7 (Q3)
BUS_ADDR_4: J1.67, U1.6 (A4), U2.6 (A4), U3.6 (A4), U4.6 (A4), U9.3 (Q0)
BUS_ADDR_5: J1.66, U1.5 (A5), U2.5 (A5), U3.5 (A5), U4.5 (A5), U9.2 (Q1)
BUS_ADDR_6: J1.65, U1.4 (A6), U2.4 (A6), U3.4 (A6), U4.4 (A6), U9.6 (Q2)
BUS_ADDR_7: J1.64, U1.3 (A7), U2.3 (A7), U3.3 (A7), U4.3 (A7), U9.7 (Q3)
BUS_ADDR_8: J1.63, J3.5, U1.25 (A8), U2.25 (A8), U3.25 (A8), U4.25 (A8)
BUS_ADDR_9: J1.62, J3.6, U1.24 (A9), U2.24 (A9), U3.24 (A9), U4.24 (A9)
BUS_ADDR_10: J1.61, J3.7, U1.21 (A10), U2.21 (A10), U3.21 (A10), U4.21 (A10)
BUS_ADDR_11: J1.60, J3.8, U1.23 (A11), U2.23 (A11), U3.23 (A11), U4.23 (A11)
BUS_ADDR_12: J1.59, J3.9, U1.2 (A12), U2.2 (A12), U3.2 (A12), U4.2 (A12)
BUS_ADDR_13: J1.58, J3.10, U1.26 (A13), U2.26 (A13), U3.26 (A13), U4.26 (A13), U8.1 (A0)
BUS_ADDR_14: J1.57, J3.11, U1.1 (A14), U2.1 (A14), U3.1 (A14), U4.1 (A14), U8.2 (A1)
BUS_ADDR_15: J1.56, J3.12, U8.3 (A2)
BUS_CLOCK: J1.41, U12.13
BUS_CLOCK_INV: J1.40
BUS_DATA_0: J1.2, J2.4, U5.18 (O0a), U6.2 (I0a)
BUS_DATA_1: J1.3, J2.5, U5.16 (O1a), U6.4 (I1a)
BUS_DATA_2: J1.4, J2.6, U5.14 (O2a), U6.6 (I2a)
BUS_DATA_3: J1.5, J2.7, U5.12 (O3a), U6.8 (I3a)
BUS_DATA_4: J1.6, J2.8, U5.9 (O0b), U6.11 (I0b)
BUS_DATA_5: J1.7, J2.9, U5.7 (O1b), U6.13 (I1b)
BUS_DATA_6: J1.8, J2.10, U5.5 (O2b), U6.15 (I2b)
BUS_DATA_7: J1.9, J2.11, U5.3 (O3b), U6.17 (I3b)
BUS_GND: C1.2, C2.2, C3.2, C4.2, C5.2, C6.2, C7.2, C8.2, C9.2, C10.2, C11.2, C12.2, J1.14, J1.36, J1.50, J1.72, J2.14, R1.2, R6.2, R7.2, R8.2, R9.2, R10.2, R11.2, R12.2, R13.2, U1.14 (GND), U2.14 (GND), U3.14 (GND), U4.14 (GND), U5.10 (GND), U6.10 (GND), U7.7 (GND), U8.4 (E1), U8.5 (E2), U8.8 (GND), U9.8 (GND), U10.8 (GND), U11.7 (GND), U12.7 (GND); also elsewhere on the board
BUS_HALT: J1.29
BUS_INT: J1.30
BUS_RD_0: J1.16, U7.5
BUS_RD_1: J1.17, U11.2
BUS_RD_2: J1.18, U11.4
BUS_RD_3: J1.19, U11.5
BUS_RESET: J1.27
BUS_RESET_INV: J1.28
BUS_ULA_ENABLE: J1.49
BUS_VCC: C1.1, C2.1, C7.1, C11.1, C12.1, D17.2 (A), J1.1, J1.15, J1.37, J1.51, R2.2, R3.2, R4.1, R5.1, SW8.3 (C), U1.28 (VCC), U2.28 (VCC), U7.14 (VCC), U11.14 (VCC), U12.14 (VCC)
BUS_WR_0: J1.20, U7.9
BUS_WR_1: J1.21, U11.10
BUS_WR_2: J1.22, U11.12
BUS_WR_3: J1.23, U11.13
FLAG_C: J1.45
FLAG_INTM: J1.43
FLAG_Z: J1.44
unnamed: D1.1 (K), D3.1 (K), D5.1 (K), D7.1 (K), R5.2, U2.20 (~CS)
unnamed: D2.1 (K), D4.1 (K), D6.1 (K), D8.1 (K), R4.2, U4.20 (~CS)
unnamed: D3.2 (A), D20.2 (A), SW1.1 (A)
unnamed: D4.2 (A), D21.2 (A), SW1.3 (C)
unnamed: D5.2 (A), D22.2 (A), SW2.1 (A)
unnamed: D6.2 (A), D23.2 (A), SW2.3 (C)
unnamed: D7.2 (A), D24.2 (A), SW3.1 (A)
unnamed: D8.2 (A), D25.2 (A), SW3.3 (C)
unnamed: D9.2 (A), D26.2 (A), SW4.1 (A)
unnamed: D10.1 (K), D12.1 (K), D14.1 (K), D16.1 (K), R2.1, U3.20 (~CS)
unnamed: D10.2 (A), D27.2 (A), SW4.3 (C)
unnamed: D9.1 (K), D11.1 (K), D13.1 (K), D15.1 (K), R3.1, U1.20 (~CS)
unnamed: D11.2 (A), D28.2 (A), SW5.1 (A)
unnamed: D12.2 (A), D29.2 (A), SW5.3 (C)
unnamed: D13.2 (A), D30.2 (A), SW6.1 (A)
unnamed: D14.2 (A), D31.2 (A), SW6.3 (C)
unnamed: D15.2 (A), D32.2 (A), SW7.1 (A)
unnamed: D16.2 (A), D33.2 (A), SW7.3 (C)
unnamed: D17.1 (K), R1.1
unnamed 63: D18.1 (K), D19.1 (K), R6.1; also elsewhere on the board
unnamed: D20.1 (K), D21.1 (K), R7.1
unnamed: D22.1 (K), D23.1 (K), R8.1
unnamed: D24.1 (K), D25.1 (K), R9.1
unnamed: D26.1 (K), D27.1 (K), R10.1
unnamed: D28.1 (K), D29.1 (K), R11.1
unnamed: D30.1 (K), D31.1 (K), R12.1
unnamed: D32.1 (K), D33.1 (K), R13.1
unnamed: SW0.2 (B), U8.7 (O7)
unnamed: SW1.2 (B), U8.9 (O6)
unnamed: SW2.2 (B), U8.10 (O5)
unnamed: SW3.2 (B), U8.11 (O4)
unnamed: SW4.2 (B), U8.12 (O3)
unnamed: SW5.2 (B), U8.13 (O2)
unnamed: SW6.2 (B), U8.14 (O1)
unnamed: SW7.2 (B), U8.15 (O0)
unnamed: C9.1, C10.1, J2.12, SW8.1 (A), U9.16 (VCC), U10.16 (VCC)
unnamed: U1.11 (Q0), U2.11 (Q0), U3.11 (D0), U4.11 (D0), U5.2 (I0a), U6.18 (O0a)
unnamed: U1.12 (Q1), U2.12 (Q1), U3.12 (D1), U4.12 (D1), U5.4 (I1a), U6.16 (O1a)
unnamed: U1.13 (Q2), U2.13 (Q2), U3.13 (D2), U4.13 (D2), U5.6 (I2a), U6.14 (O2a)
unnamed: U1.15 (Q3), U2.15 (Q3), U3.15 (D3), U4.15 (D3), U5.8 (I3a), U6.12 (O3a)
unnamed: U1.16 (Q4), U2.16 (Q4), U3.16 (D4), U4.16 (D4), U5.11 (I0b), U6.9 (O0b)
unnamed: U1.17 (Q5), U2.17 (Q5), U3.17 (D5), U4.17 (D5), U5.13 (I1b), U6.7 (O1b)
unnamed: U1.18 (Q6), U2.18 (Q6), U3.18 (D6), U4.18 (D6), U5.15 (I2b), U6.5 (O2b)
unnamed: U1.19 (Q7), U2.19 (Q7), U3.19 (D7), U4.19 (D7), U5.17 (I3b), U6.3 (O3b)
unnamed: U7.2, U12.1, U12.2
unnamed: U7.4, U12.9
unnamed: U7.6, U11.1
unnamed: U9.1, U9.4 (Ce), U9.5 (D/U), U9.9 (P3), U9.10 (P2), U9.15 (P0)
unnamed: J3.14, U9.11 (Pl), U10.11 (Pl)
unnamed: U9.14 (Cp), U10.13 (Rc)
unnamed: J3.13, U10.14 (Cp)
unnamed: U10.1, U10.4 (Ce), U10.5 (D/U), U10.9 (P3), U10.10 (P2), U10.15 (P0)
unnamed: U7.1, U11.6
unnamed: U7.3, U11.8
unnamed: U7.8, U11.9
PROG_RUN_VCC: C3.1, C4.1, C5.1, C6.1, C8.1, SW8.2 (B), U3.28 (VCC), U4.28 (VCC), U5.20 (VCC), U6.20 (VCC), U8.6 (E3), U8.16 (VCC)
PROG_WRITE_ENABLE: J3.15, U3.27 (~WE), U4.27 (~WE)
READ_ENABLE_INV: J2.1, U1.22 (~OE), U2.22 (~OE), U3.22 (~OE), U4.22 (~OE), U5.1 (OEa), U5.19 (OEb), U12.6
WRITE_ENABLE_INV: U1.27 (~WE), U2.27 (~WE), U6.1 (OEa), U6.19 (OEb), U12.8

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
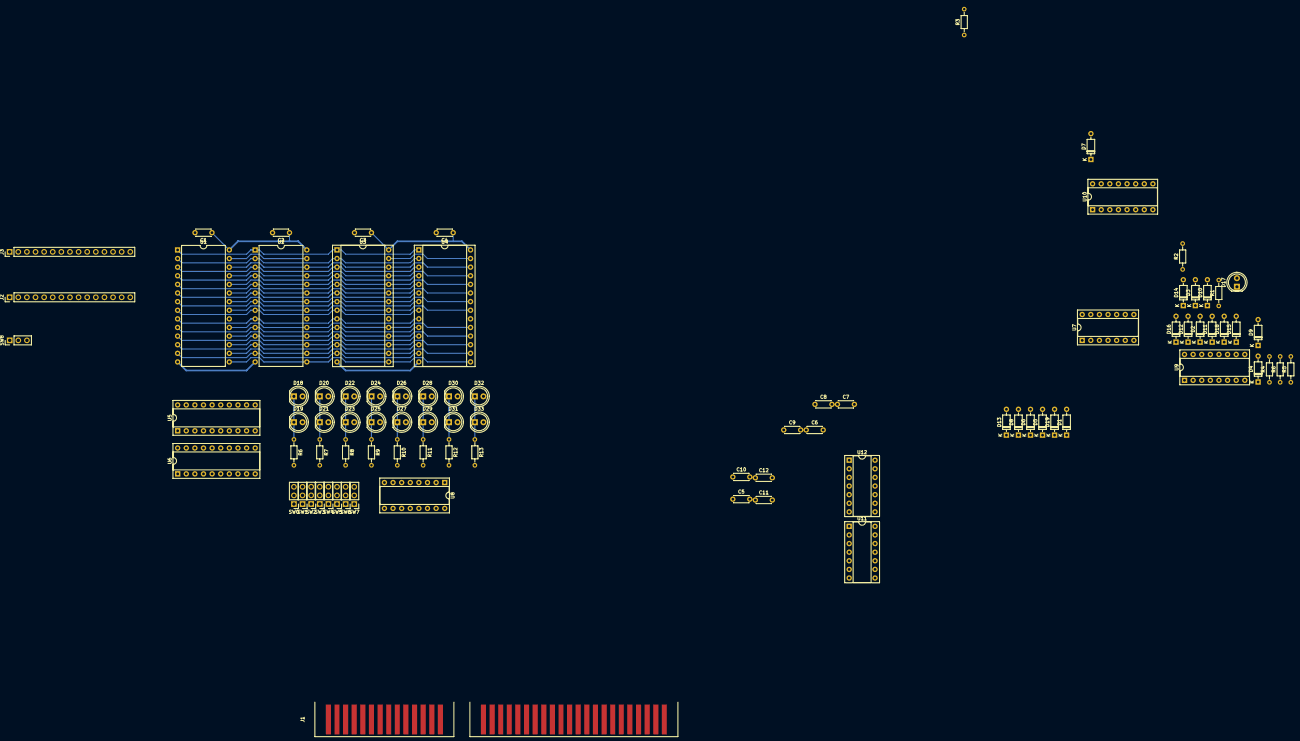
[picture p67: board pcb/mem/mem.kicad_pcb from above]

Board: 2 copper layers, 85 parts (0 on the bottom side), 98 nets.

Other parts of the board:
D18#2, D19#2: LED; LED_D5.0mm
R6#2: 10K; R_Axial_DIN0204_L3.6mm_D1.6mm_P7.62mm_Horizontal

Their connections:
BUS_GND: R6#2.1; also elsewhere on the board
unnamed 63: D18#2.1 (K), D19#2.1 (K), R6#2.2; also elsewhere on the board
