rcapaverde/cubo/(commit log)

2025-12-11 arquivos que estavam no pc67
    [base.kicad_pcb, base.kicad_sch, botoes.FCStd, clock_revA.kicad_pcb, clock_revA.kicad_sch, controle.kicad_pcb, controle.kicad_sch, experimento.circ]
2025-12-11 interface serial
    [serial.kicad_pcb, serial.kicad_sch]
2025-12-12 arquivos no note
    [mgrfa.kicad_pcb, mgrfa.kicad_sch, sgrda.kicad_pcb, sgrda.kicad_sch, sr16a.kicad_pcb, sr16a.kicad_sch, sr8a.kicad_pcb, sr8a.kicad_sch]
2025-12-12 arquivos do gdrive
    [instruction-set.xlsx, sgrda.kicad_pcb, sgrda.kicad_sch, sr16a.kicad_pcb, sr16a.kicad_sch]
2025-12-12 ignorar tambem os arquivos de backup do kicad
2025-12-14 adicionados o designador e o swap para a arquivo reg16
    [ex16a.kicad_pcb, ex16a.kicad_sch, sr16a.kicad_pcb, sr16a.kicad_sch, swrda.kicad_pcb, swrda.kicad_sch]
2025-12-21 alterando os pinos de alimentacao no conector
    [ex16a.kicad_sch, swrda.kicad_pcb, swrda.kicad_sch]
2025-12-23 projeto enviado para impressao em dezembro/25
    [mgrfa.kicad_pcb, mgrfa.kicad_sch, sr8a.kicad_pcb, sr8a.kicad_sch, testbench-sub8.kicad_pcb, testbench.kicad_pcb, testbench.kicad_sch]
2025-12-23 roteamento pronto e electric rules verificadas
    [swrda.kicad_pcb]
2025-12-28 concluido o desenho das placas satelite do banco de registradores de 16 bits
    [ex16a.kicad_pcb, ex16a.kicad_sch, sr16a.kicad_pcb, sr16a.kicad_sch, swrda.kicad_pcb, swrda.kicad_sch]
2025-12-30 adicionados imagens 3D para os componentes customizados
    [m16rfa.kicad_pcb, m16rfa.kicad_sch, mgrfa.kicad_pcb, testbench.kicad_pcb]
2025-12-31 modelo 3d do interruptor; primeira versao do firmware do testbench (falta ainda converter o codigo para comunicar via latch)
2026-01-03 comunicacao com o LCD agora eh feita de forma direta, sem o uso de bibliotecas (necessario devido a conexao indireta com o controlador do LCD)
2026-01-03 versao B2 da testbench (com a alimentacao das placas de teste reposicionadas para as extremidades
    [testbench.kicad_pcb, testbench.kicad_sch]
2026-01-04 a interface com a sub8 parece incompativel; corrigindo a interface
    [testbench.kicad_pcb, testbench.kicad_sch]
2026-01-05 concluido o roteamento da revisao B1
    [testbench.kicad_pcb]
2026-01-07 vias de alimentacao movidas para as extremidades do conector
    [ula8-addera.kicad_pcb, ula8-addera.kicad_sch]
2026-01-07 removidos os backups da pasta PCB
2026-01-12 correcao na pinagem do INA226 (SDA e SCL entravam nos pinos errados do arduino)
    [testbench.kicad_pcb, testbench.kicad_sch]
2026-01-12 ajustes para usar o multiplexador
2026-01-12 breakboards do edge socket para breadboard
    [testbench-adaptador28.kicad_pcb, testbench-adaptador28.kicad_sch, testbench-adaptador44.kicad_pcb, testbench-adaptador44.kicad_sch]
2026-01-12 configuracoes para o jlcpcb
    [testbench-adaptador28.kicad_pcb, testbench-adaptador44.kicad_pcb]
2026-01-12 inicio da revisao completa; a placa sr8 será removida e incorporada aqui
    [mgrfa.kicad_sch]
2026-01-15 revisao completa; mgrfa agora inclui sr8 e sgrda; remover estes dois no proximo commit
    [mgrfa.kicad_pcb, mgrfa.kicad_sch, sgrda.kicad_sch, ula8-addera.kicad_pcb, ula8-shiftera.kicad_pcb, ula8-shiftera.kicad_sch, ula8-xora.kicad_pcb, ula8-xora.kicad_sch]
2026-01-16 Módulos SR8A e SGRDA incorporados ao MGRFA
    [sgrda.kicad_pcb, sgrda.kicad_sch, sr8a.kicad_pcb, sr8a.kicad_sch]
2026-01-16 concluida a revisão
    [mgrfa.kicad_pcb]
2026-01-16 entrada de força nas laterais; select agora é posicional, permitindo que a placa seja inserida em qualquer slot
    [ula8-shiftera.kicad_pcb]
2026-01-16 alimentação movida para as extremidades do conector
    [ula8-bitwisea.kicad_pcb, ula8-bitwisea.kicad_sch]
2026-01-22 deslocando alimentação para as estremidades do conector; carry out em três estados (ativo apenas quando select)
    [controle_carry_flag.circ, ula8-bitwisea.kicad_pcb, ula8-bitwisea.kicad_sch, ula8-shiftera.kicad_pcb, ula8-shiftera.kicad_sch, ula8-sxa.kicad_pcb, ula8-sxa.kicad_sch]
2026-01-22 faltava salvar
    [ula8-shiftera.kicad_sch]
2026-01-22 carry out depende de select
    [ula8-xora.kicad_pcb, ula8-xora.kicad_sch]
2026-01-30 Update mgrfa.kicad_pcb and mgrfa.kicad_sch
    [mgrfa.kicad_pcb, mgrfa.kicad_sch]
2026-01-30 PCB concluída
    [ula8da.kicad_pcb, ula8da.kicad_sch]
2026-02-07 ajuste no espacamento entre os conectores flat
    [testbench.kicad_pcb]
2026-02-07 correção no valor do resitor do led de power
    [testbench-sub8.kicad_pcb, testbench-sub8.kicad_sch]
2026-02-09 modelo 3d do display de 7 segmentos
2026-02-09 sketch de teste isolado da testbench-sub8 (comandada diretamente por um arduino)
2026-02-09 ainda pendente de conclusão do roteamento
    [m16rfa.kicad_pcb]
2026-02-09 roteamento refeito; ainda pendente
    [ula8a.kicad_pcb, ula8a.kicad_sch]
2026-02-12 concluidas as modificações de layout na pcb
    [ula8a.kicad_pcb, ula8a.kicad_sch]
2026-02-13 mais alterações na pcb
    [ula8a.kicad_pcb]
2026-02-13 recomeçando o roteamento
    [m16rfa.kicad_pcb, m16rfa.kicad_sch]
2026-02-14 concluído o roteamento; falta corrigir os erros apontados pela validação de regras
    [m16rfa.kicad_pcb]
2026-02-14 ajustes para envio para produção
    [mgrfa.kicad_pcb]
2026-02-15 cartucho de rom
    [cartridgea.kicad_pcb, cartridgea.kicad_sch]
2026-02-16 gravador de rom, diretamente no cartucho
    [rom-writer.kicad_pcb, rom-writer.kicad_sch]
2026-02-16 controladora de memória
    [mema.kicad_pcb, mema.kicad_sch]
2026-02-16 roteamento com problemas; refazer
    [mema.kicad_pcb, mema.kicad_sch]
2026-02-17 concluído o roteamento
    [mema.kicad_pcb]
2026-02-18 inicio dos trabalhos na unidade de controle e lógica
    [clua.kicad_pcb, clua.kicad_sch, regs.circ]
2026-02-21 experimentação com opcodes
    [clu_opcodea.kicad_pcb, clu_opcodea.kicad_sch, clua.kicad_sch, mema.kicad_pcb, mema.kicad_sch, regs.circ]
2026-02-22 continuando com a implementação da lógica de controle; ROM de ucode expandida para 17 bits
    [clu_opcodea.kicad_pcb, clu_opcodea.kicad_sch, clua.kicad_sch, regs.circ]
2026-02-24 alteração de layout
    [clu_opcodea.kicad_pcb, clu_opcodea.kicad_sch]
2026-02-27 revisando o ERC
    [clu_opcodea.kicad_pcb, clu_opcodea.kicad_sch, clua.kicad_sch]
2026-03-01 movendo itens da clu para o sysbus
    [clua.kicad_sch, sysbusa.kicad_pcb, sysbusa.kicad_sch]
2026-03-01 clock ainda está difícil; ioc está indo no caminho certo, mas falta definir a porta de controle para a serial
    [clocka.kicad_pcb, clocka.kicad_sch, ioca.kicad_pcb, ioca.kicad_sch]
2026-03-04 placa clock gerando os sinais clock e n_clock sincronizados
    [clocka.kicad_sch, clua.kicad_sch, sysbusa.kicad_sch]
2026-03-05 padronização de conector de IO; ideias para o layout do backplane
    [ioca.kicad_sch, sysbusa.kicad_pcb, sysbusa.kicad_sch]
2026-03-08 definindo o layout para empilhar as placas
    [clua.kicad_pcb, clua.kicad_sch, sysbusa.kicad_pcb, sysbusa.kicad_sch]
2026-03-09 ajustes de layout; nenhuma alteração na lógica
    [mgrfa.kicad_sch]
2026-03-10 adicionados os botões para clock manual
    [clocka.kicad_sch]
2026-03-10 refazendo os pcbs para caber em folha A4
    [clua.kicad_pcb, clua.kicad_sch, sysbusa.kicad_pcb, sysbusa.kicad_sch, ula8a.kicad_pcb]
2026-03-11 concluído o esquemático do clock; iniciando o layout do pcb a partir das dimensões definidas no croqui
    [clocka.kicad_pcb, clocka.kicad_sch]
2026-03-15 Separado o painel de controle do gerador de clock
    [clock-cpa.kicad_pcb, clock-cpa.kicad_sch, clocka.kicad_pcb, clocka.kicad_sch]
2026-03-16 layout do painel de controle do gerador de clock
    [clock-cpa.kicad_pcb, clock-cpa.kicad_sch, clocka.kicad_sch]
2026-03-20 Adicionado a porta para clock out; trabalhando no roteamento
    [clock-cpa.kicad_pcb, clock-cpa.kicad_sch]
2026-03-21 layout de pcb do clock
    [clock-cpa.kicad_pcb, clock-cpa.kicad_sch, clocka.kicad_pcb, clocka.kicad_sch]
2026-03-24 layout concluído
    [clocka.kicad_pcb]
2026-03-24 pcb reduzida; iniciando um novo layout com inversão na posição dos chips
    [clocka.kicad_pcb]
2026-03-24 novo layout do pcb
    [clocka.kicad_pcb]
2026-03-24 Novo layout concluído
    [clocka.kicad_pcb, clocka.kicad_sch]
2026-03-30 conector reposicionado para ser compatível com a sysbus
    [clocka.kicad_pcb]
2026-03-30 posicionamento dos conectores com os demais módulos
    [sysbusa.kicad_pcb, sysbusa.kicad_sch]
2026-03-30 refazendo o módulo de registradores
    [m16rfa.kicad_pcb, m16rfa.kicad_sch]
2026-04-05 ajustes nos botões do painel de controle do clock
2026-04-06 continuando implementação do clock
    [clock-cpa.kicad_pcb, clock-cpa.kicad_sch, clocka.kicad_pcb, clocka.kicad_sch]
2026-04-11 desenho da chave de slide
2026-04-11 usando a nova chave de slide, posicionado a direita
    [clock-cpa.kicad_pcb]
2026-04-11 conectores do painel de controle posicionados na parte inferior, a direita; isso interfere com a passagem do cabo do clock
    [clocka.kicad_pcb, clocka.kicad_sch]
2026-04-11 conector para o painel de controle do clock reorientado para a vertical; cabos passarão pela lateral, farão curva de 90o e vão para frente
    [clock-cpa.kicad_pcb, clocka.kicad_pcb]
2026-04-14 definido o layout da placa com os sete registradores de 8 bits
    [sr8a.kicad_pcb, sr8a.kicad_sch]
2026-04-14 apenas questões estéticas
    [sr16a.kicad_pcb]
2026-04-16 reduzida a largura da pcb de clock, para sobrar mais espaço para a pcb de registradores
    [clocka.kicad_pcb]
2026-04-17 Redimensionamento do clock para abrir mais espaço para os registradores
    [clocka.kicad_pcb, m16rfa.kicad_pcb, m16rfa.kicad_sch]
2026-04-18 concluida a versao com teste de tbsub8
2026-04-19 layout de pcb pronto para fabricação
    [clock-cpa.kicad_pcb, clocka.kicad_pcb]
2026-04-20 concluído o layout da pcb
    [ula8a.kicad_pcb, ula8a.kicad_sch]
2026-04-20 ULA reduzida de tamanho, para sobrar mais espaço para a CL
    [croqui.FCStd]
2026-04-20 inicio de layout da CL
    [clua.kicad_pcb, clua.kicad_sch]
2026-04-21 layout avançando
    [clua.kicad_pcb]
2026-04-21 reposicionado o conector para a ULA
    [sysbusa.kicad_pcb]
2026-04-21 atualização de tamanho e posição de conectores
    [croqui.FCStd]
2026-04-22 novos sinais
    [clu_opcodea.kicad_pcb, clu_opcodea.kicad_sch]
2026-04-22 esquemático simplificado; a rom é muito lenta, endereço de escrita pode ser setado a cada ciclo
    [rom-writer.kicad_sch]
2026-04-23 ajuste nos sinais do microcódigo
    [clu_opcodea.kicad_pcb, clu_opcodea.kicad_sch]
2026-04-23 correções no esquemático e reiniciando o pcb
    [clua.kicad_pcb, clua.kicad_sch]
2026-04-23 validação da lógica da unidade de controle e lógica
    [clua.kicad_sch, control_logic_unit.circ]
2026-04-24 avançando na análise da lógica; correções de problema já detectados
    [clua.kicad_sch, control_logic_unit.circ]
2026-04-24 problema no restart cycle quando a instrução executa em três ciclos (ou seja, sem um restart cycle explícito no microcódigo
    [clua.kicad_sch, control_logic_unit.circ]
2026-04-27 mais simulações e ajustes no pcb; falta o sinal de WRITE durante o reset e interrupt
    [clua.kicad_pcb, clua.kicad_sch, control_logic_unit.circ]
2026-04-29 inversão dos sinais de seleção de step para simplificar o circuito
    [clua.kicad_sch, control_logic_unit.circ]
2026-05-02 finalizado o layout e testes lógicos do pcb
    [clua.kicad_pcb, clua.kicad_sch, control_logic_unit.circ]
2026-05-02 novo sinal no opcode
    [clu_opcodea.kicad_pcb, clu_opcodea.kicad_sch]
2026-05-03 ajustes no layout da pcb
    [clua.kicad_pcb, clua.kicad_sch]
2026-05-03 inicio do layout da pcb
    [sysbusa.kicad_pcb, sysbusa.kicad_sch]
2026-05-04 concluída a primeira versão do layout do pcb; rever o circuito de reset
    [sysbusa.kicad_pcb]
2026-05-04 revisão na posição dos conectores
    [m16rfa.kicad_pcb, sysbusa.kicad_pcb]
2026-05-05 melhoria no reset, para que seja acionado automaticamente ao ligar
    [sysbusa.kicad_pcb, sysbusa.kicad_sch]
2026-05-05 inversão na posição dos conectores, para coincidir com o sysbus
    [ula8a.kicad_pcb, ula8a.kicad_sch]
2026-05-07 posicionamento de furos e conectores que faltavam
    [croqui.FCStd]
2026-05-07 redimensionamento do pcb e início do layout
    [mema.kicad_pcb]
2026-05-07 furação para suporte
    [sysbusa.kicad_pcb]
2026-05-10 concluído o layout do pcb
    [mema.kicad_pcb, mema.kicad_sch]
2026-05-10 algumas simplificações
    [mema.kicad_pcb]
2026-05-11 case do cartucho
    [cartridge-case.FCStd]
2026-05-15 complementos do case
    [cartridge-case.FCStd]
2026-05-15 layout do pcb já considerando as dimensões corretas
    [mema.kicad_pcb]
2026-05-15 ajustes de layout
    [croqui.FCStd, sysbusa.kicad_pcb]
2026-05-16 tamanho dos conectores estava errado
    [clock-cpa.kicad_pcb]
2026-05-16 cartucho 90 graus
    [cartridge90.FCStd, cartridge90.kicad_pcb, cartridge90.kicad_sch]
2026-05-17 usando um componente com as dimensões do conector de cabo flat, para impedir erros de posicionamento
    [clua.kicad_pcb, clua.kicad_sch, sysbusa.kicad_pcb, sysbusa.kicad_sch]
2026-05-18 atualização do conector flat
    [m16rfa.kicad_pcb, m16rfa.kicad_sch, ula8a.kicad_pcb, ula8a.kicad_sch]
2026-05-19 reset do flag int_mask vinculado a execução de opcode_int
    [clua.kicad_pcb, clua.kicad_sch]
2026-05-23 adicionado teste para a clock cp
2026-05-24 Correção no lado de conexão dos pinos
2026-05-25 base para construção do protótipo
    [pe-haste.FCStd]
2026-05-25 preparação para produção
    [sysbusa.kicad_pcb]
2026-05-31 concluido o novo layout
    [m16rfa.kicad_pcb, m16rfa.kicad_sch]
2026-06-01 novo layout para ajustar a pinagem do conector
    [sr8a.kicad_pcb, sr8a.kicad_sch]
2026-06-11 layout já em V3 do módulo de registradores
    [m16rf.kicad_pcb, m16rf.kicad_sch]
2026-06-13 iniciando o asm para o instruction set v4
2026-06-14 nova implementação do assembler para instruction set v4
2026-06-19 novo layout para pcb v3
    [croqui.FCStd, m16rf.kicad_pcb, m16rf.kicad_sch, mem.kicad_pcb, mem.kicad_sch, s16rf.kicad_pcb, s16rf.kicad_sch, sysbus.kicad_pcb]
2026-06-20 avançando o layout da placa com os registradores
    [s16rf.kicad_pcb, s16rf.kicad_sch]
2026-06-21 finalização da primeira fase de layout do pcb
    [s16rf.kicad_pcb, s16rf.kicad_sch]
2026-06-28 avançado na otimização do pcb
    [s16rf.kicad_pcb, s16rf.kicad_sch]
2026-06-28 concluida a primeira rodada de layout do pcb; removidas conexões de cascateamento de decremento para os registradores que não tenham esta função
    [s16rf.kicad_pcb, s16rf.kicad_sch]
2026-06-28 mais ajustes no layout
    [s16rf.kicad_pcb]
2026-07-03 refazendo o layout do pcb
    [sysbus.kicad_pcb, sysbus.kicad_sch]
2026-07-05 avançando no layot v3
    [clu.kicad_pcb, clu.kicad_sch, clu_opcode.kicad_pcb, clu_opcode.kicad_sch, mem.kicad_pcb, mem.kicad_sch, sysbus.kicad_pcb]
2026-08-01 layout usando a ROM de opcode na horizontal
    [clu.kicad_pcb, clu.kicad_sch]
2026-08-03 avançando no novo layout
    [clu.kicad_pcb]
2026-08-08 conclusão da primeira fase de layout
    [clu.kicad_pcb]
2026-08-08 pronto para produção
    [clu.kicad_pcb, clu.kicad_sch]
2026-08-08 preparação para produção das pcbs
    [clu_opcode.kicad_pcb, sysbus.kicad_pcb]
2026-08-24 seleção de chip de rom feita pela placa de memória; isso reduz um chip no cartucho
    [mem.kicad_sch, rom-writer.kicad_sch]
2026-08-24 seleção de chip de rom feita pela placa de memória; isso reduz[A um chip no cartucho
    [cartridgea.kicad_sch]
